wakimizufu/TBSEQ/TBSEQ_Board_V1/notes.txt

デバッグボードの注意点

1.OSCとVCFの間は結線されてないので、SQRないしSAWに220Kを
  通してVCFに入力する。

2.CVは大体0.5～6.0Vまで反応する。 この範囲を超えると音が聞こえなく
  なる。 その際は一旦電源を落としてCVを調整してから電源を入れなおす。

3.GATEは正論理で+5VでONだが ACCは負論理なので0Vでonする。
  ACCをonにするとVCFへのEnvDecayは最短固定でVCFに印加される。

4.10/06現在、CutoffFreq , Resonance , EnvMod , Tuning および Volumeの
  つまみの方向がオリジナルと逆になっている。
