wakimizufu/TBSEQ/testClock/ADC_TEMPO_COUNT.tsv

ADC | TEMPO | COUNT
0 | 30 | 2604
1 | 31 | 2520
2 | 32 | 2441
3 | 32 | 2441
4 | 33 | 2367
5 | 34 | 2298
6 | 35 | 2232
7 | 36 | 2170
8 | 37 | 2111
9 | 37 | 2111
10 | 38 | 2056
11 | 39 | 2003
12 | 40 | 1953
13 | 41 | 1905
14 | 41 | 1905
15 | 42 | 1860
16 | 43 | 1817
17 | 44 | 1776
18 | 45 | 1736
19 | 46 | 1698
20 | 46 | 1698
21 | 47 | 1662
22 | 48 | 1628
23 | 49 | 1594
24 | 50 | 1563
25 | 51 | 1532
26 | 51 | 1532
27 | 52 | 1502
28 | 53 | 1474
29 | 54 | 1447
30 | 55 | 1420
31 | 56 | 1395
32 | 56 | 1395
33 | 57 | 1371
34 | 58 | 1347
35 | 59 | 1324
36 | 60 | 1302
37 | 60 | 1302
38 | 61 | 1281
39 | 62 | 1260
40 | 63 | 1240
41 | 64 | 1221
42 | 65 | 1202
43 | 65 | 1202
44 | 66 | 1184
45 | 67 | 1166
46 | 68 | 1149
47 | 69 | 1132
48 | 70 | 1116
49 | 70 | 1116
50 | 71 | 1100
51 | 72 | 1085
52 | 73 | 1070
53 | 74 | 1056
54 | 75 | 1042
55 | 75 | 1042
56 | 76 | 1028
57 | 77 | 1015
58 | 78 | 1002
59 | 79 | 989
60 | 79 | 989
61 | 80 | 977
62 | 81 | 965
63 | 82 | 953
64 | 83 | 941
65 | 84 | 930
66 | 84 | 930
67 | 85 | 919
68 | 86 | 908
69 | 87 | 898
70 | 88 | 888
71 | 89 | 878
72 | 89 | 878
73 | 90 | 868
74 | 91 | 859
75 | 92 | 849
76 | 93 | 840
77 | 94 | 831
78 | 94 | 831
79 | 95 | 822
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
