wakimizufu/TBSEQ/SwitchBox/TBSeq - Project.pdf

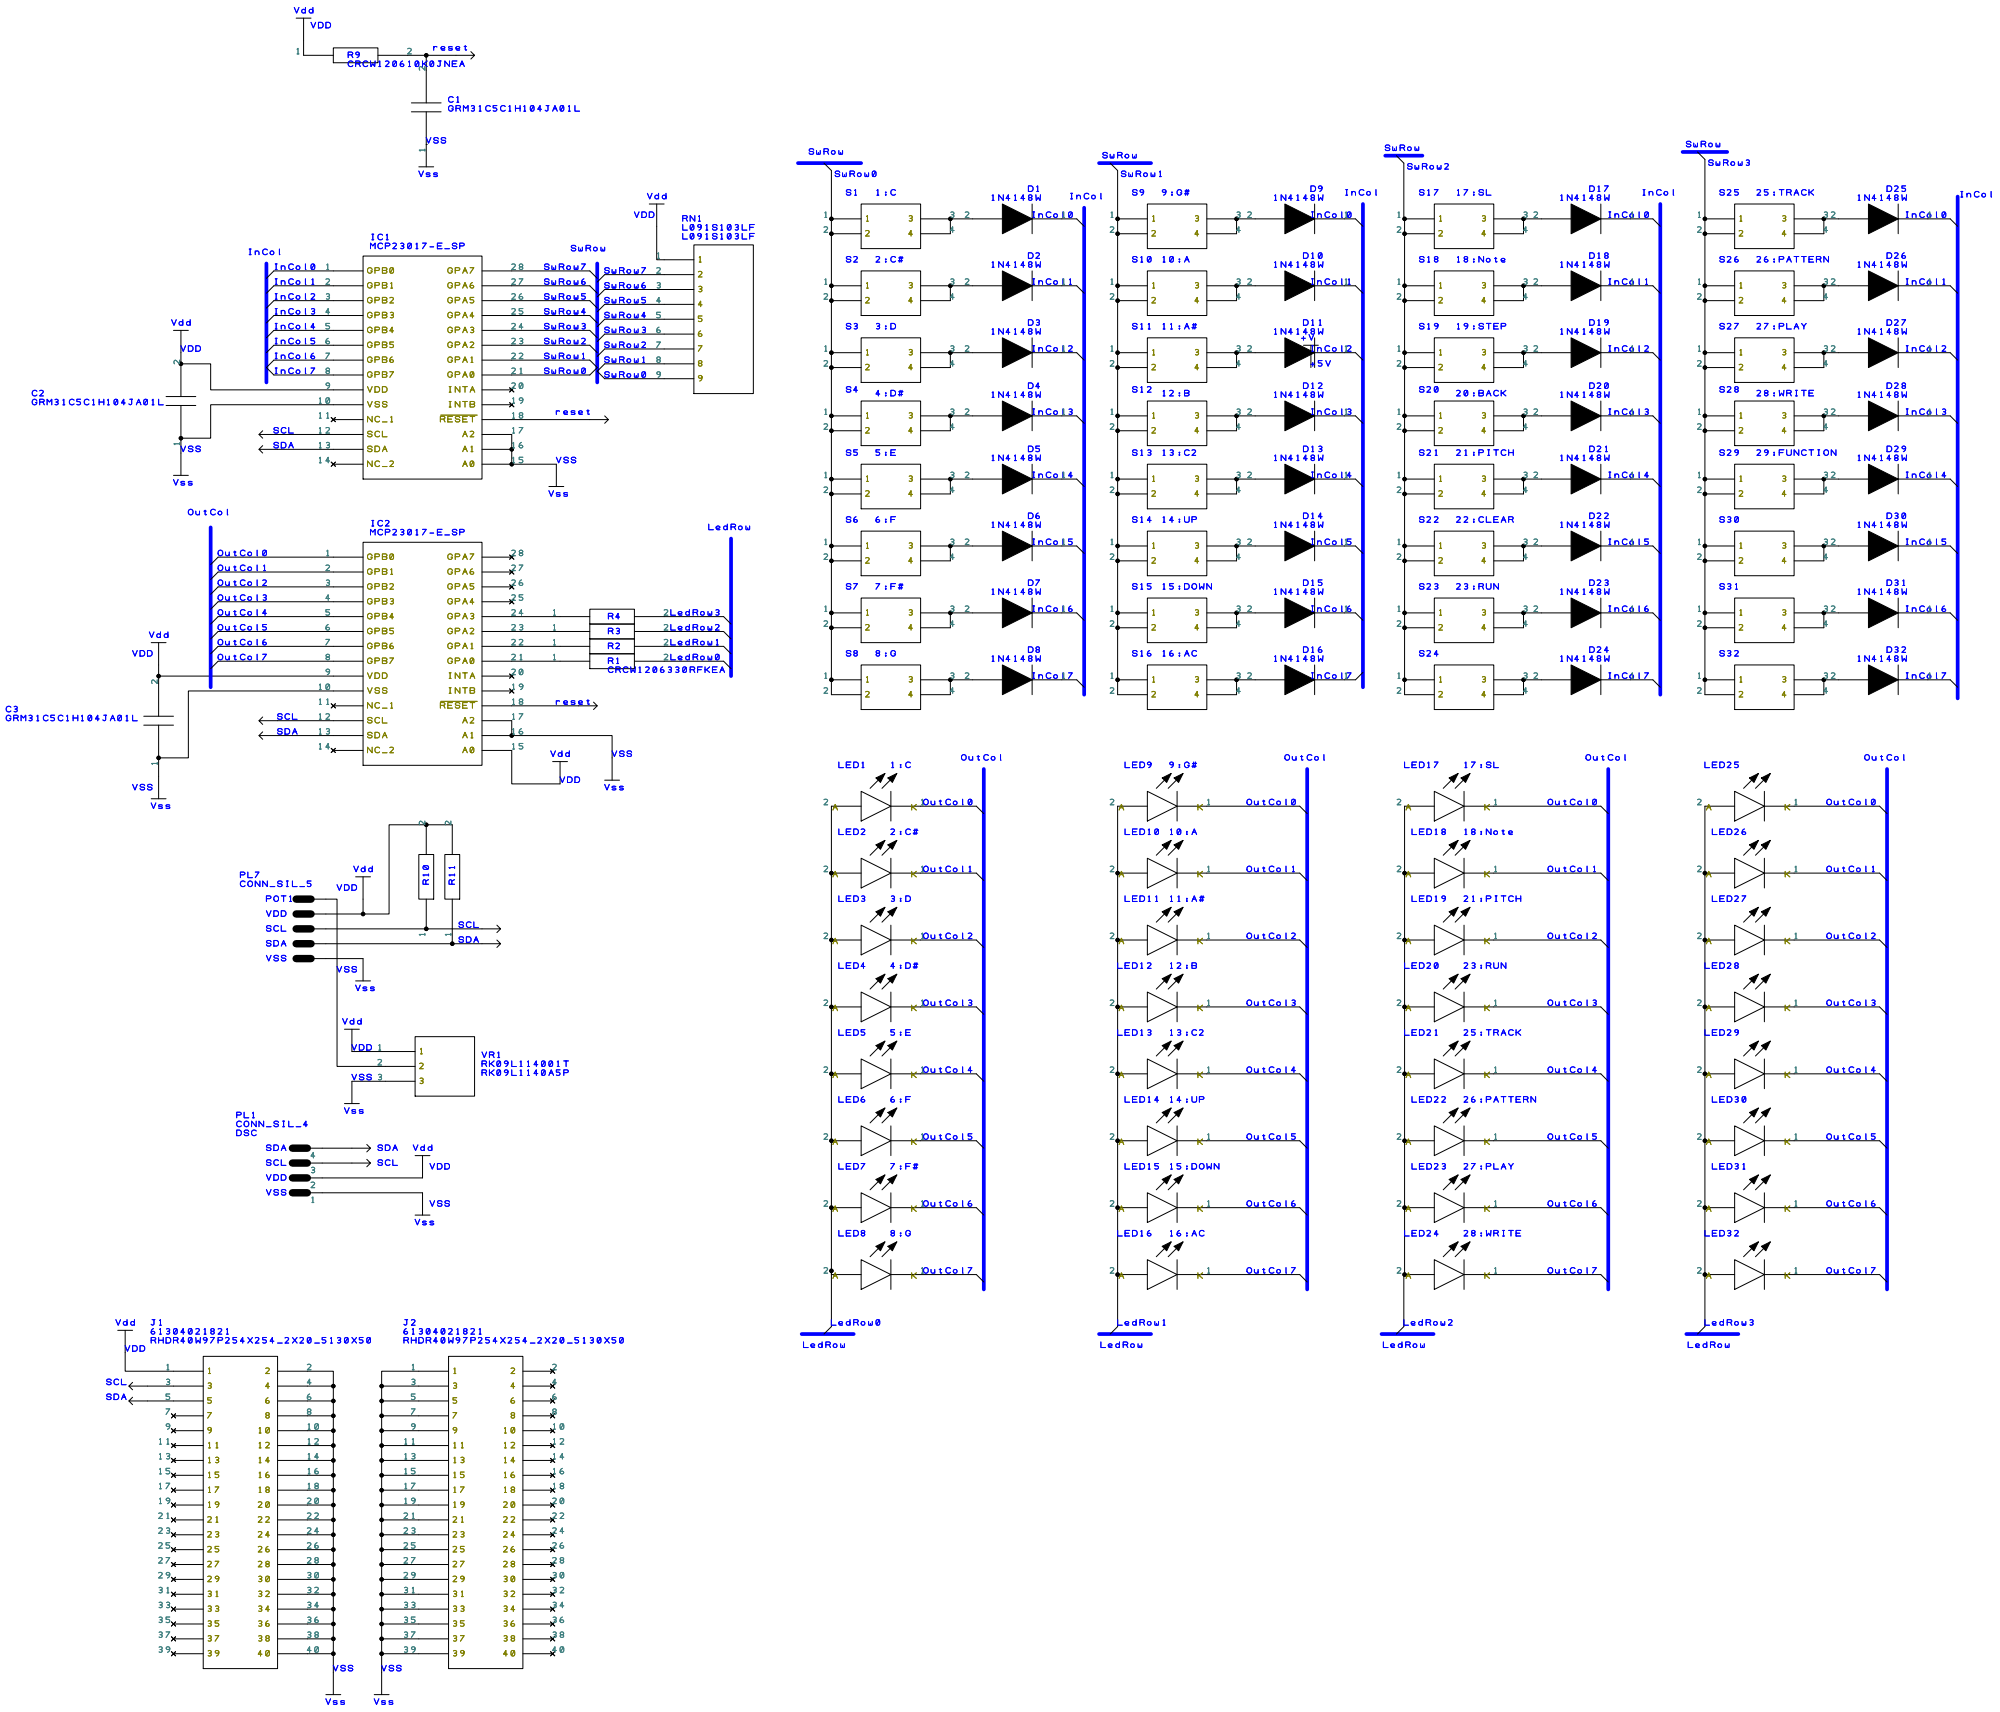
[picture p22: page 1]
