wakimizufu/TBSEQ/TBSEQ_Board_V1/RE-303 BOM_1.3_official.pdf

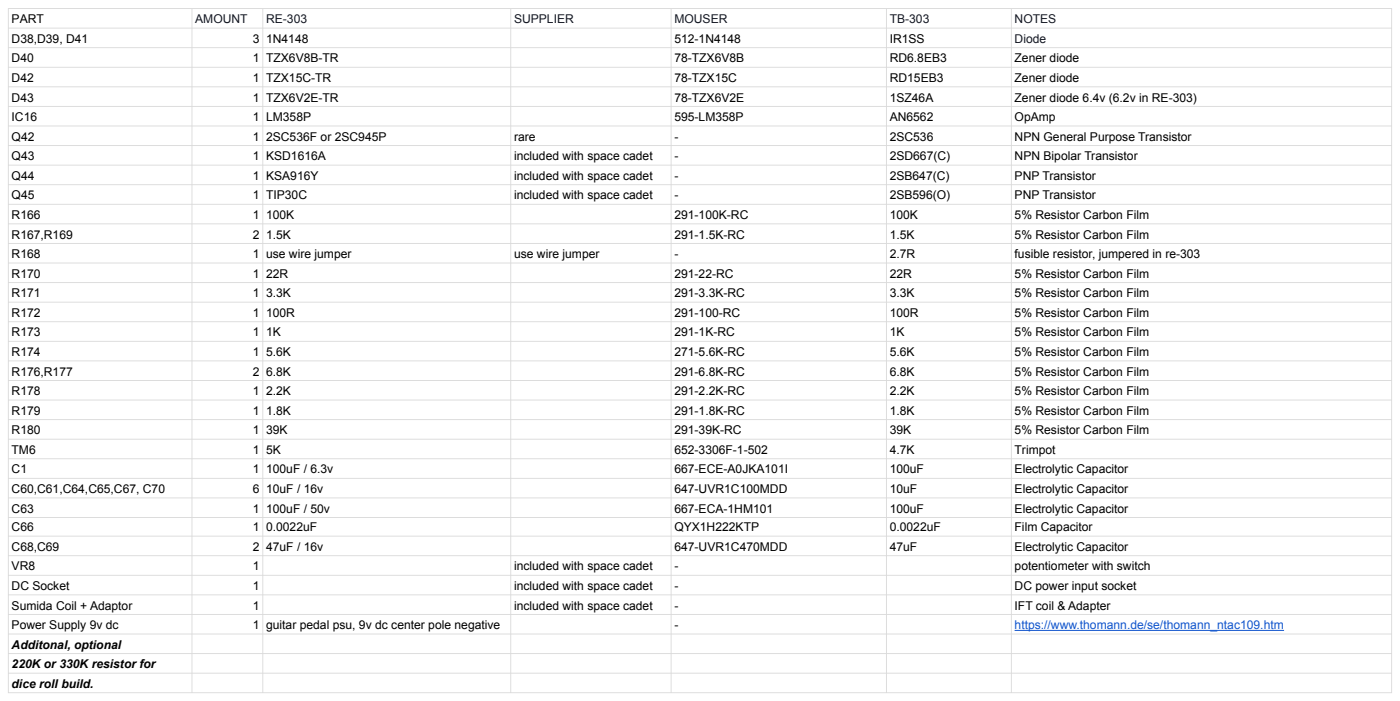
[picture p23: page 1]

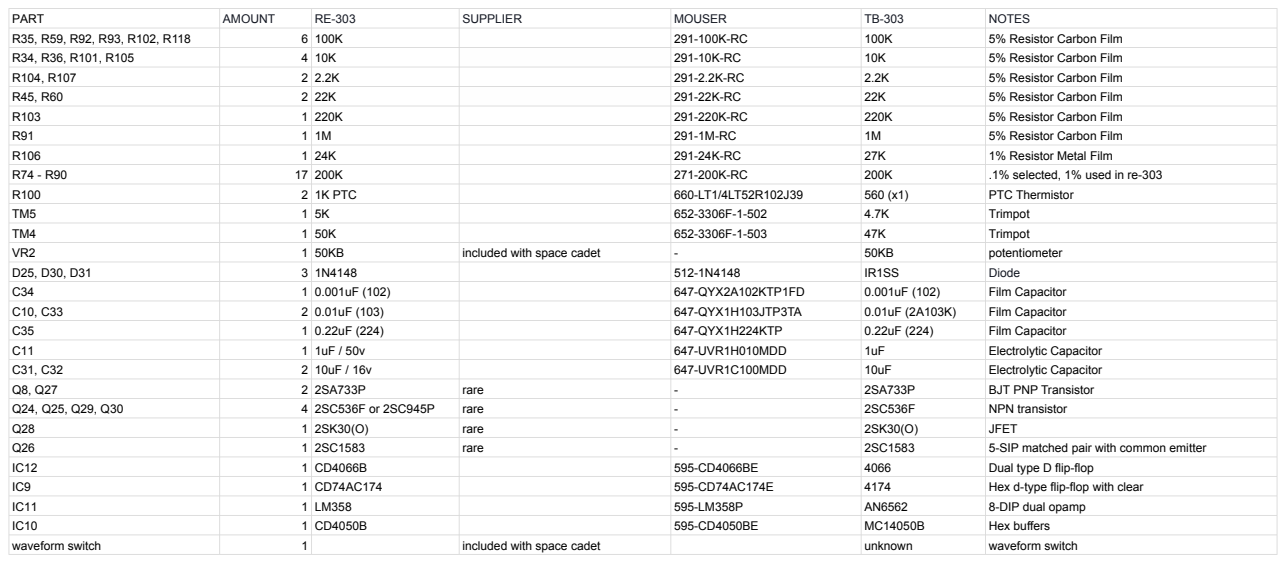
[picture p24: page 2]

PART R35, R59, R92, R93, R102, R118 | AMOUNT RE-303 SUPPLIER MOUSER TB-303 NOTES
6 100K 291-100K-RC 100K | 5% Resistor Carbon Film
R34, R36, R101, R105 | 4 10K | 291-10K-RC 10K | 5% Resistor Carbon Film
R104, R107 2 2.2K 291-2.2K-RC 2.2K | | | 5% Resistor Carbon Film

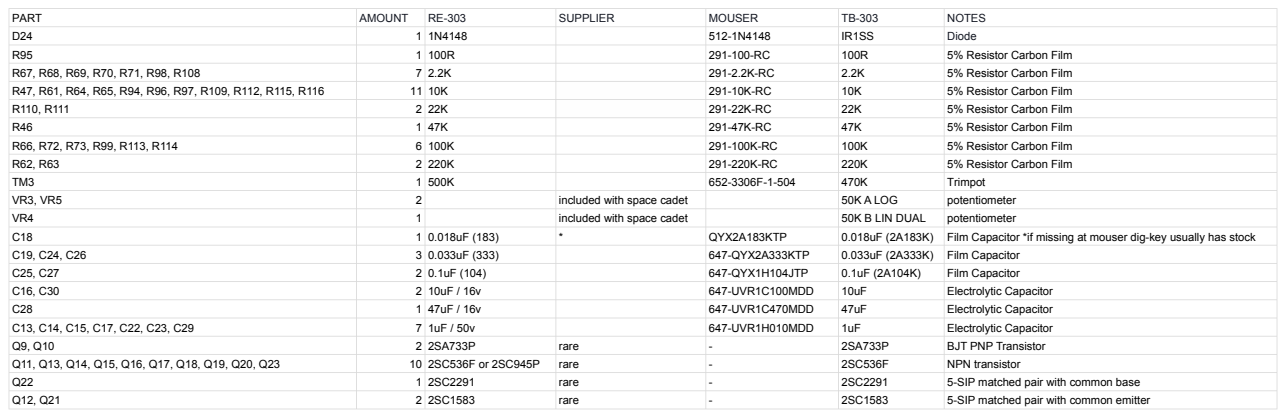
[picture p25: page 3]

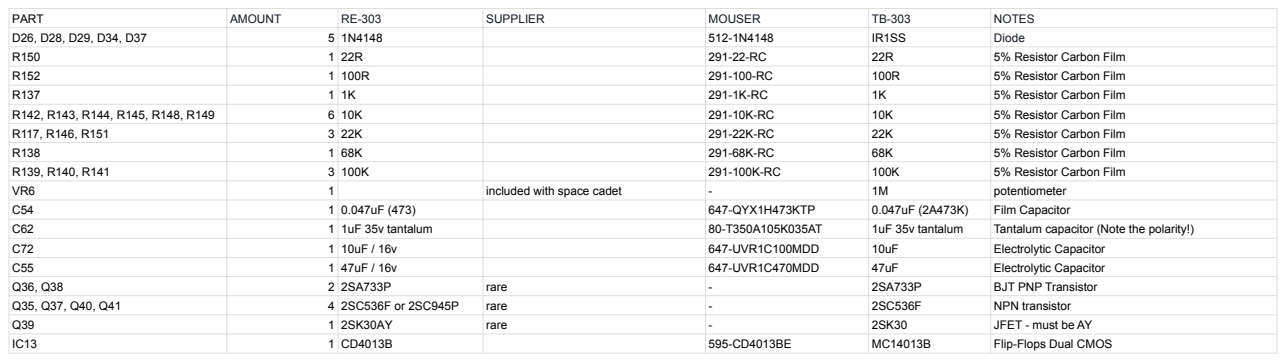
[picture p26: page 4]

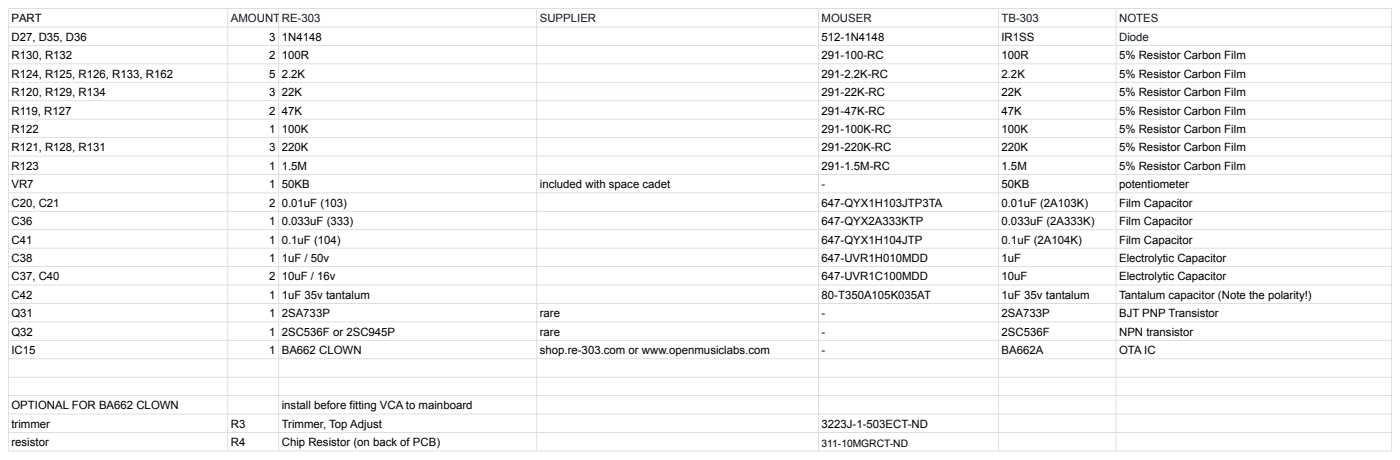
[picture p27: page 5]

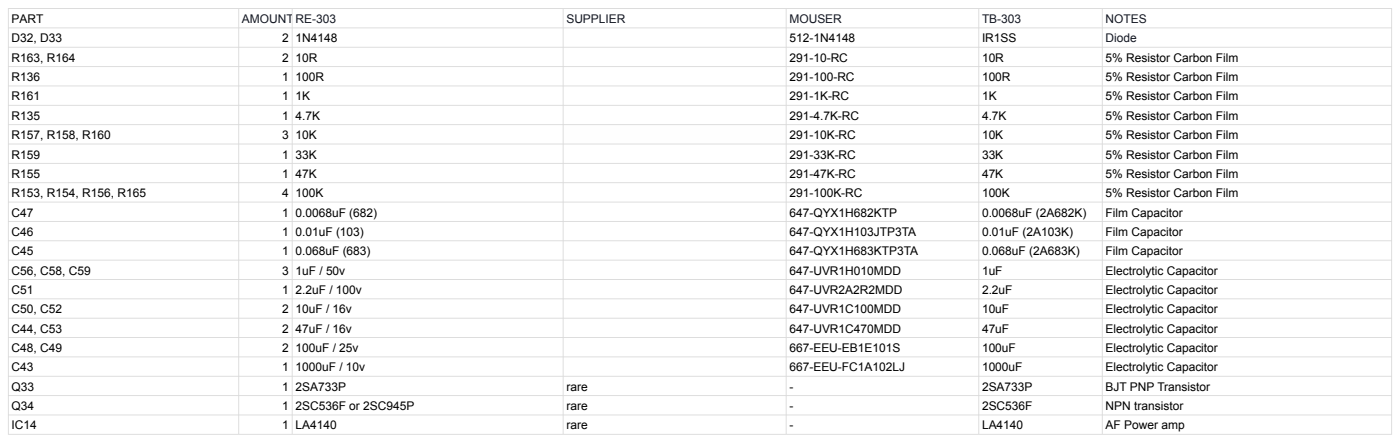
[picture p28: page 6]

2 1N4148 512-1N4148 IR1SS | Diode

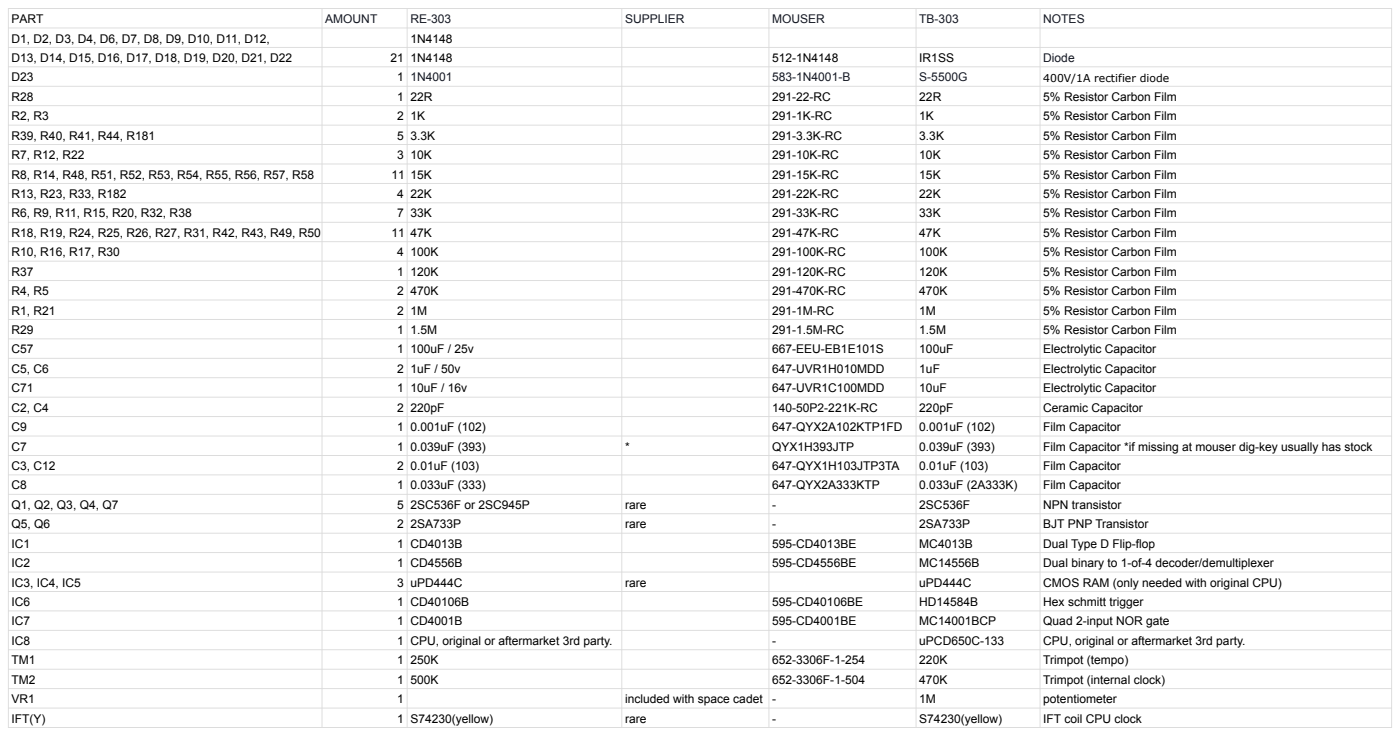
[picture p29: page 7]

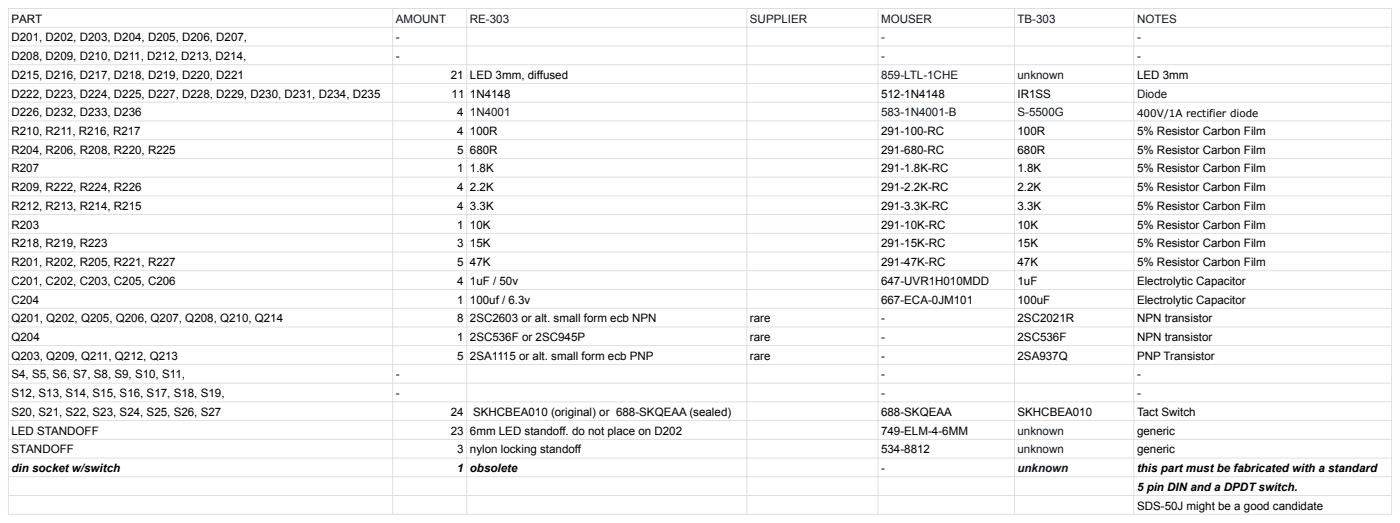
[picture p30: page 8]

D222, D223, D224, D225, D227, D228, D229, D230, D231, D234, D235 D226, D232, D233, D236 | 11 1N4148 512-1N4148 IR1SS | Diode
4 | 1N4001 583-1N4001-B S-5500G 400V/1A rectifier diode

LED STANDOFF 23 6mm LED standoff. do not place on D202 749-ELM-4-6MM STANDOFF 3 nylon locking standoff 534-8812 din socket w/switch 1 obsolete - | unknown generic

unknown | this part must be fabricated with a standard

5 pin DIN and a DPDT switch.

SDS-50J might be a good candidate

part | amount | part number | supplier | notes
headers for Pixie recpu | 2 | SKU A-4662 | TAYDA | machine headers, cut to size for pixie. Can be replace with generic 2.54 header (not recommended)
