wakimizufu/TBSEQ/TBSEQ_Board_V3/TB-SEQV3_MainBoard.pdf

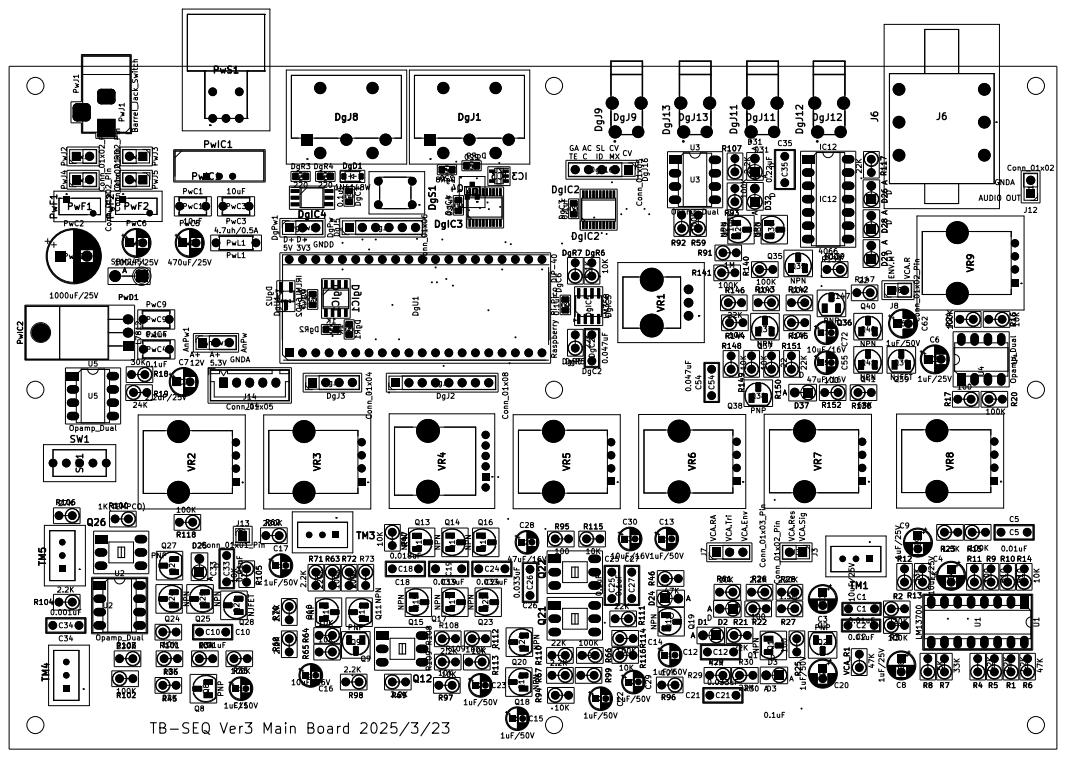
[picture p31: page 1]
