wakimizufu/TBSEQ/TBSEQ_Board_V3/TB-SEQV3_PanelBoard.pdf

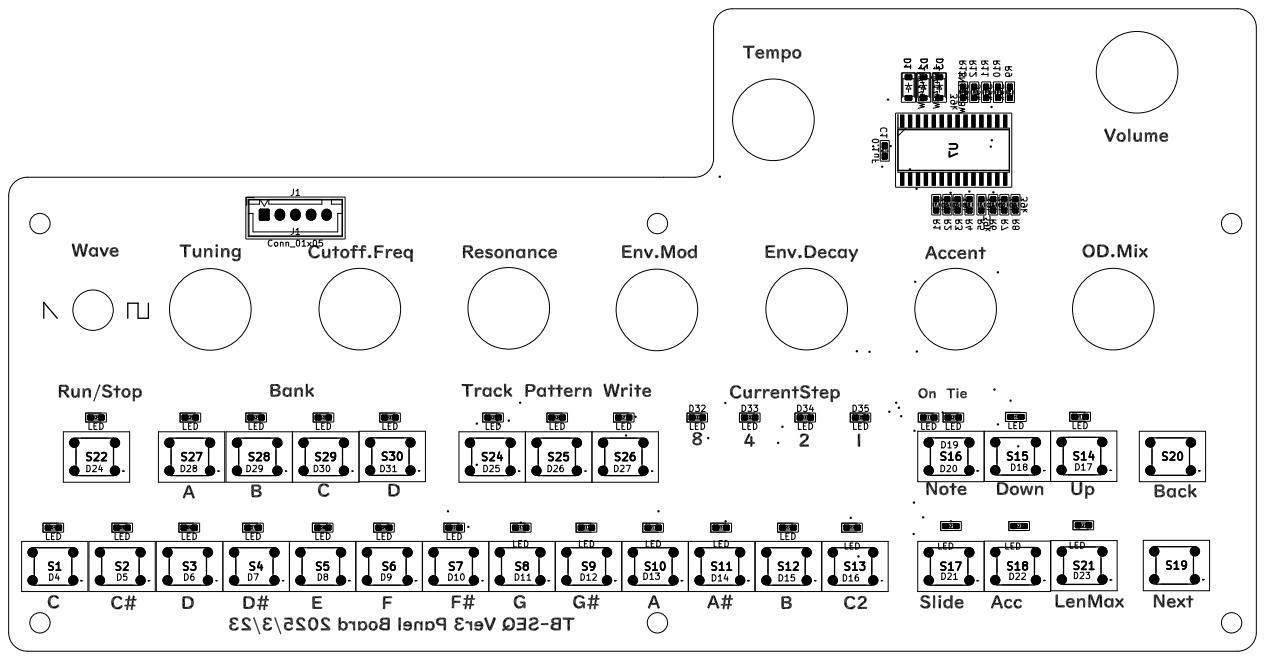
[picture p32: page 1]
