wakimizufu/TBSEQ/TBSEQ_Board_V2/mainBorad/mainboard_pcb_20241230.pdf

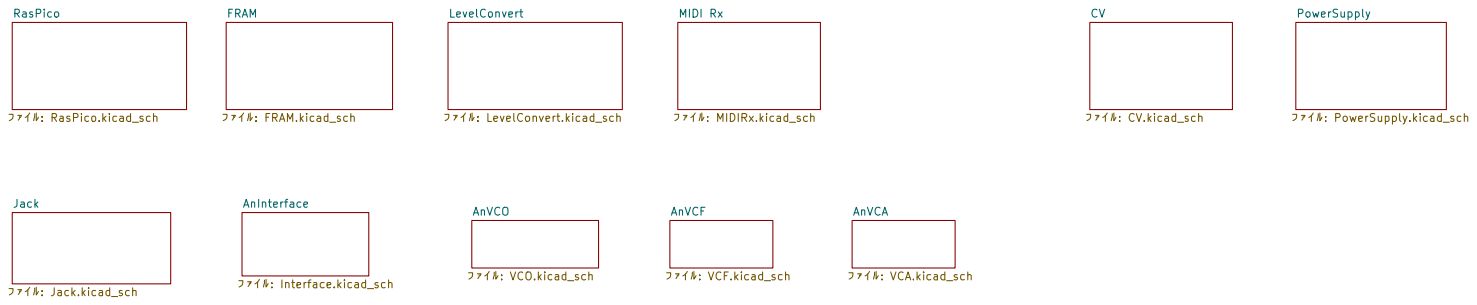
[picture p41: page 1]

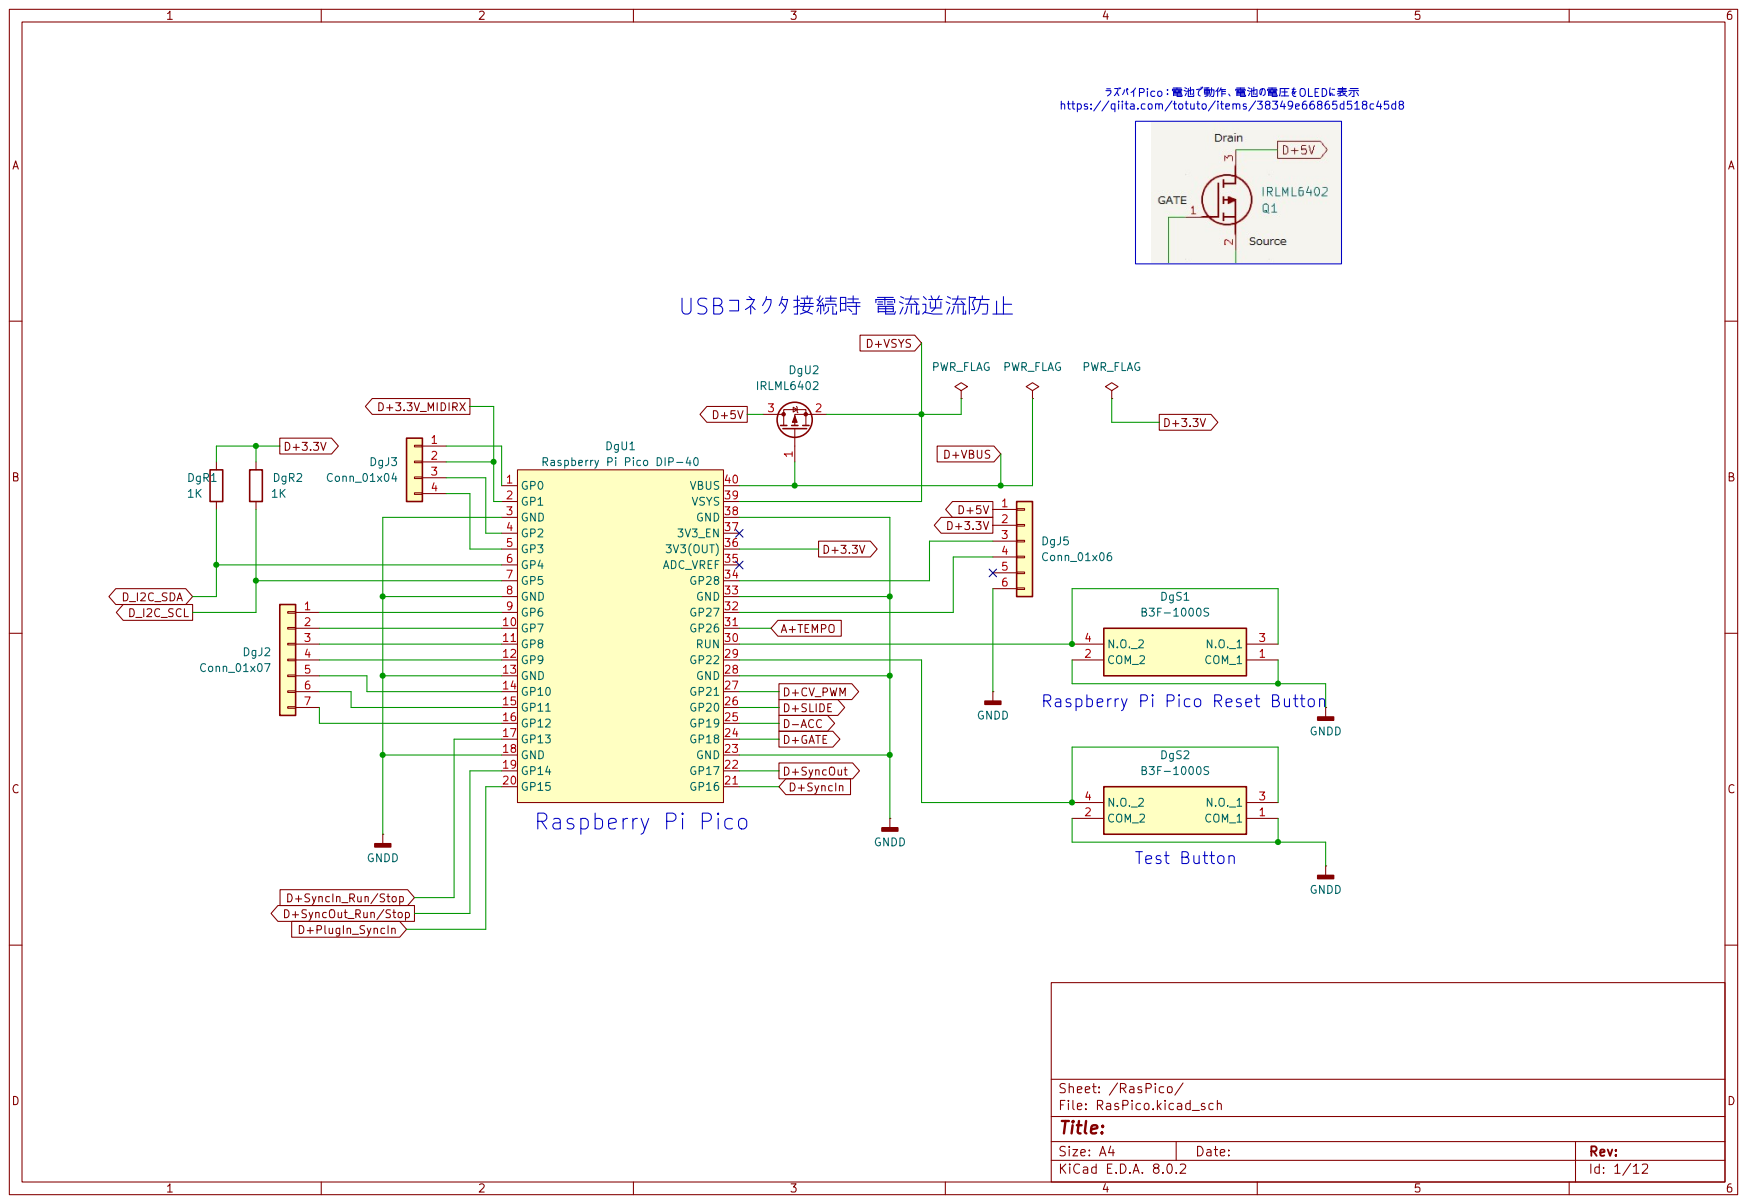
[picture p42: page 2]


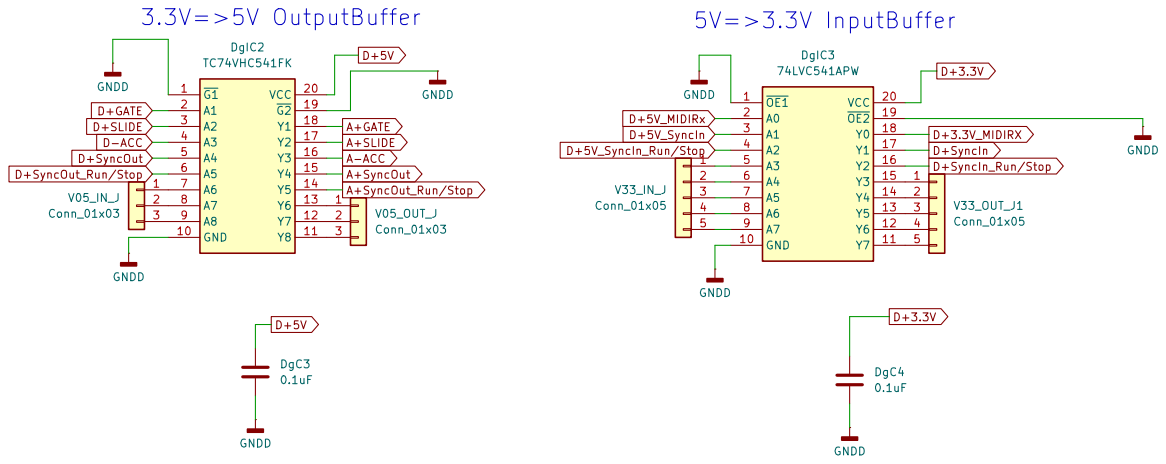
[picture p43: page 4]

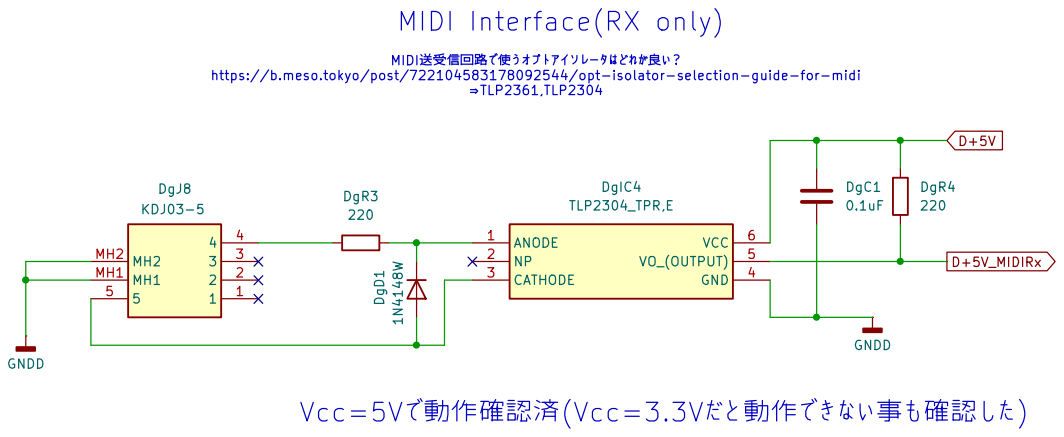
[picture p44: page 5]

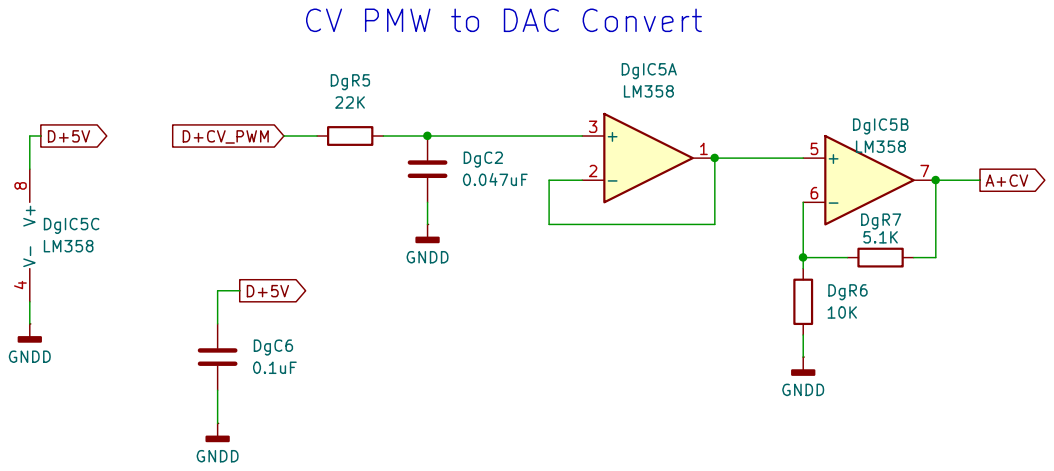
[picture p45: page 6]

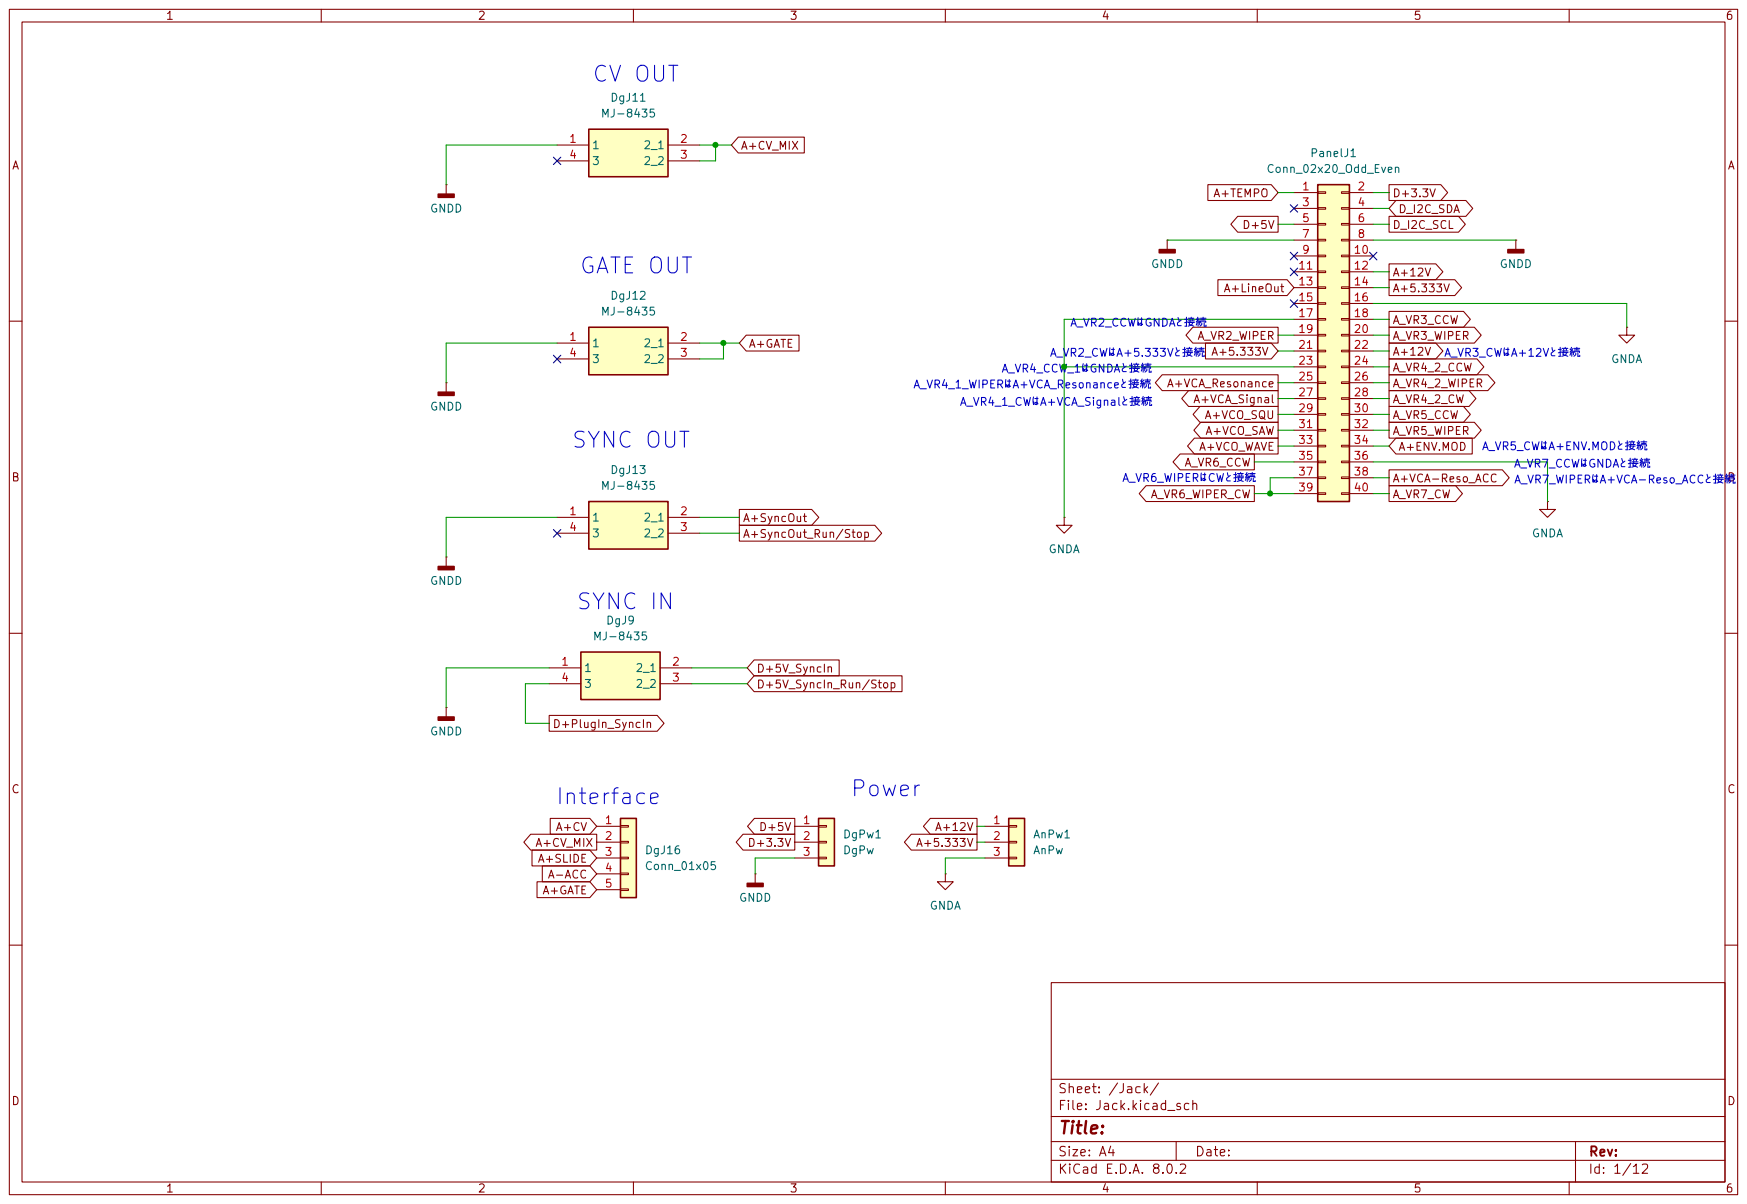
[picture p46: page 7]

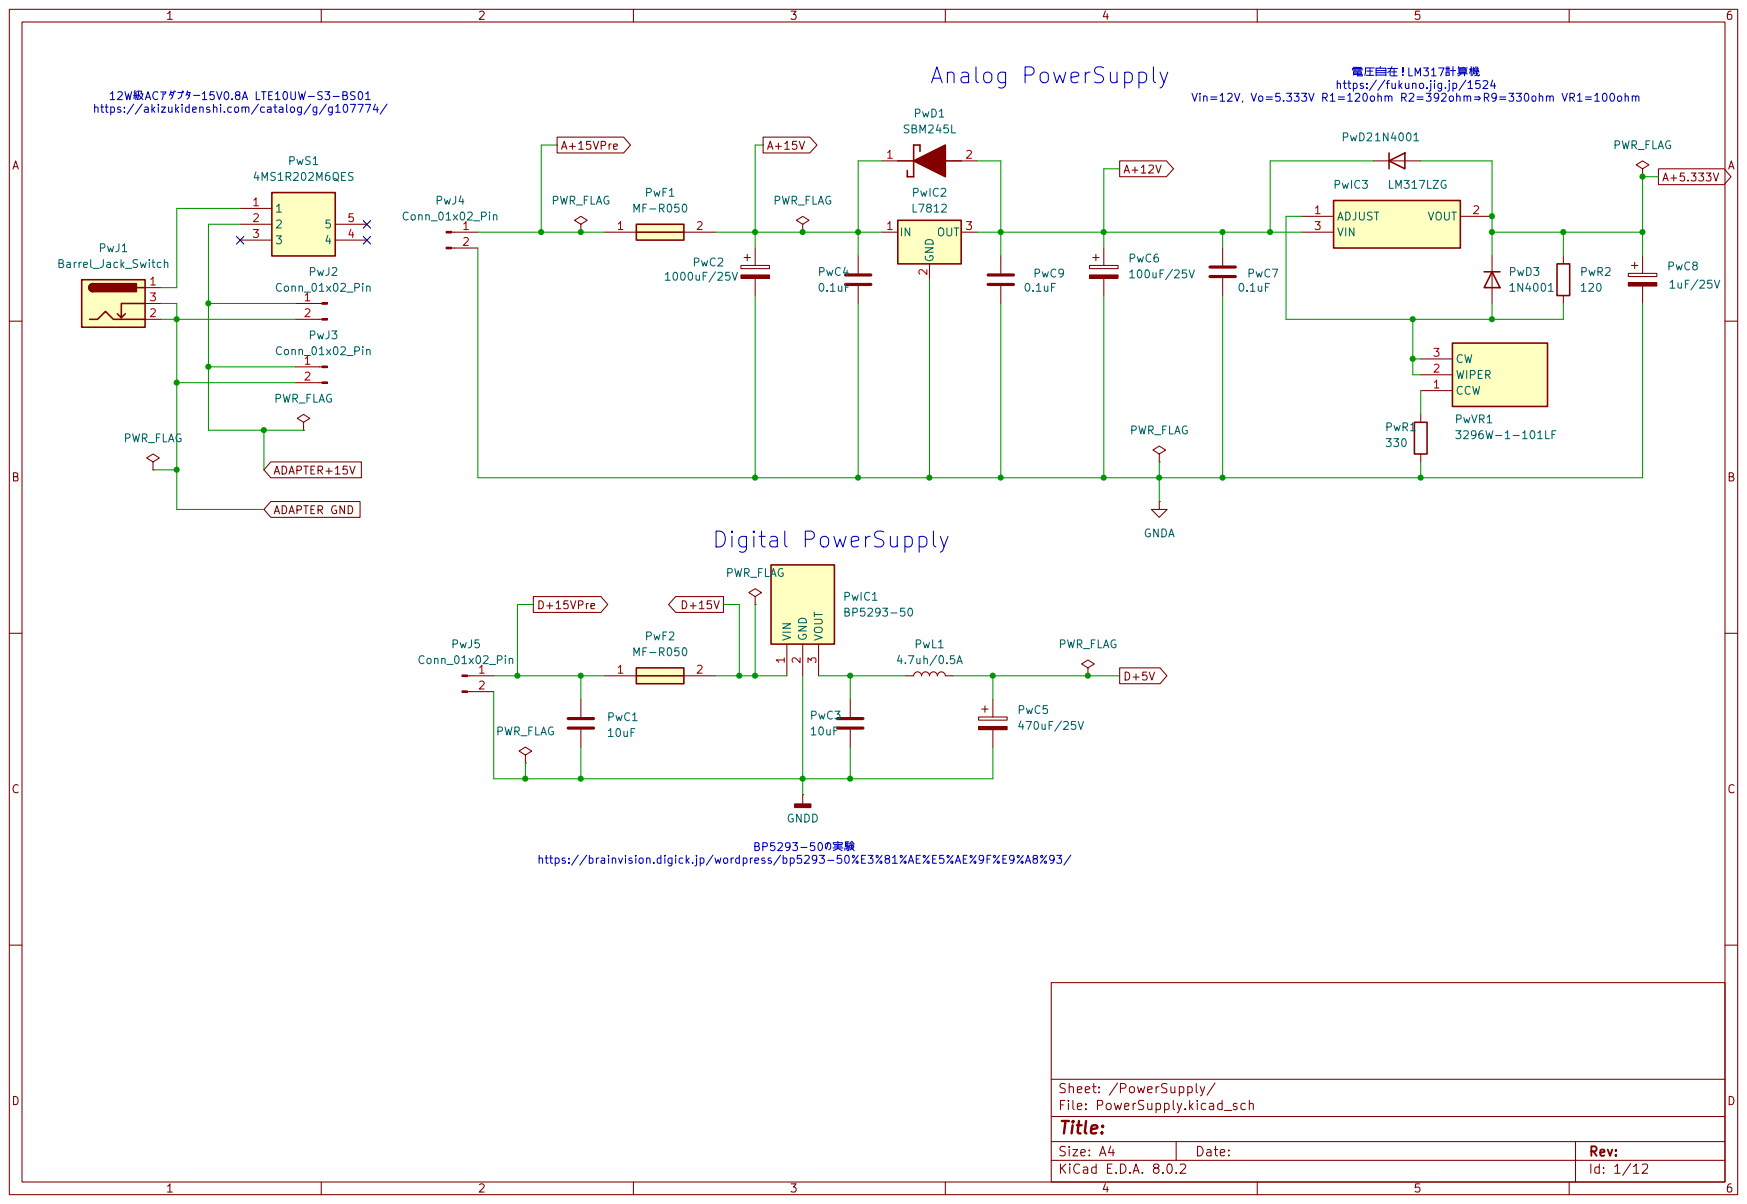
[picture p47: page 8]

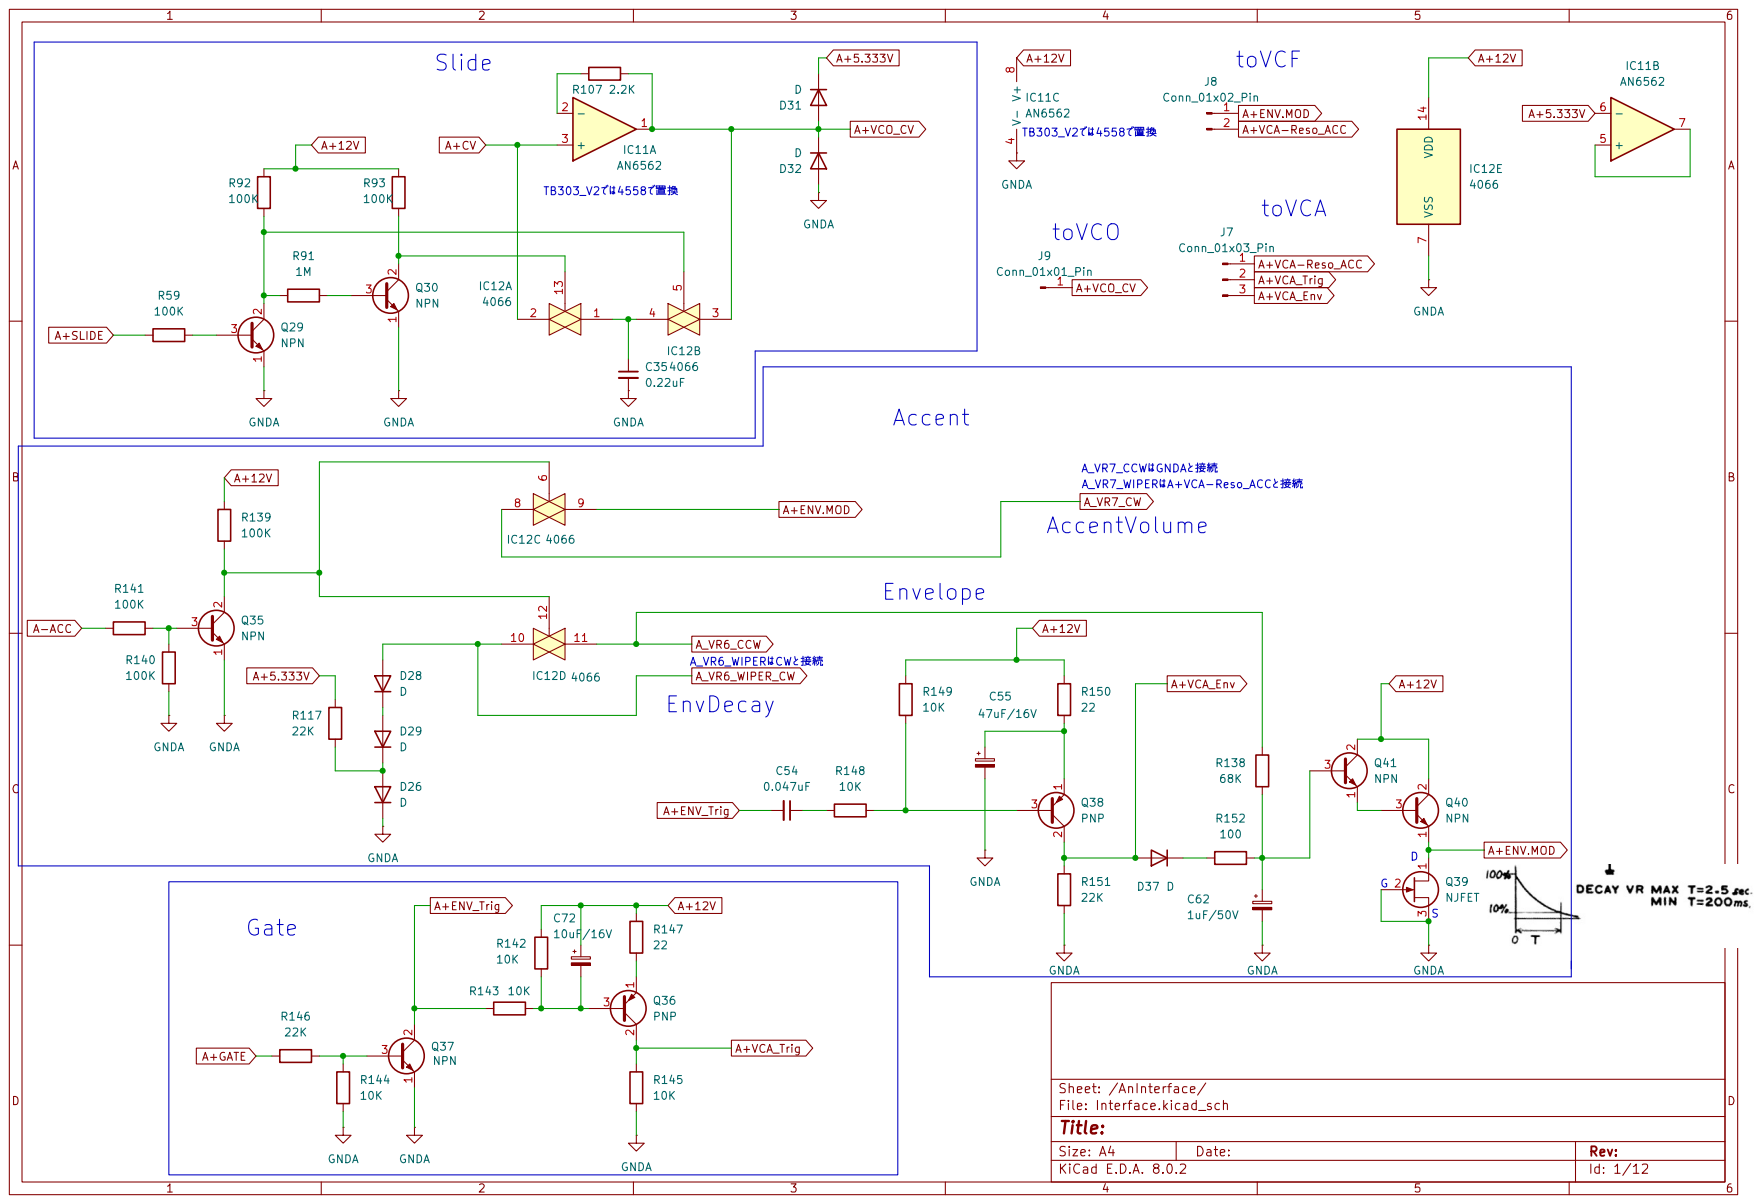
[picture p48: page 9]

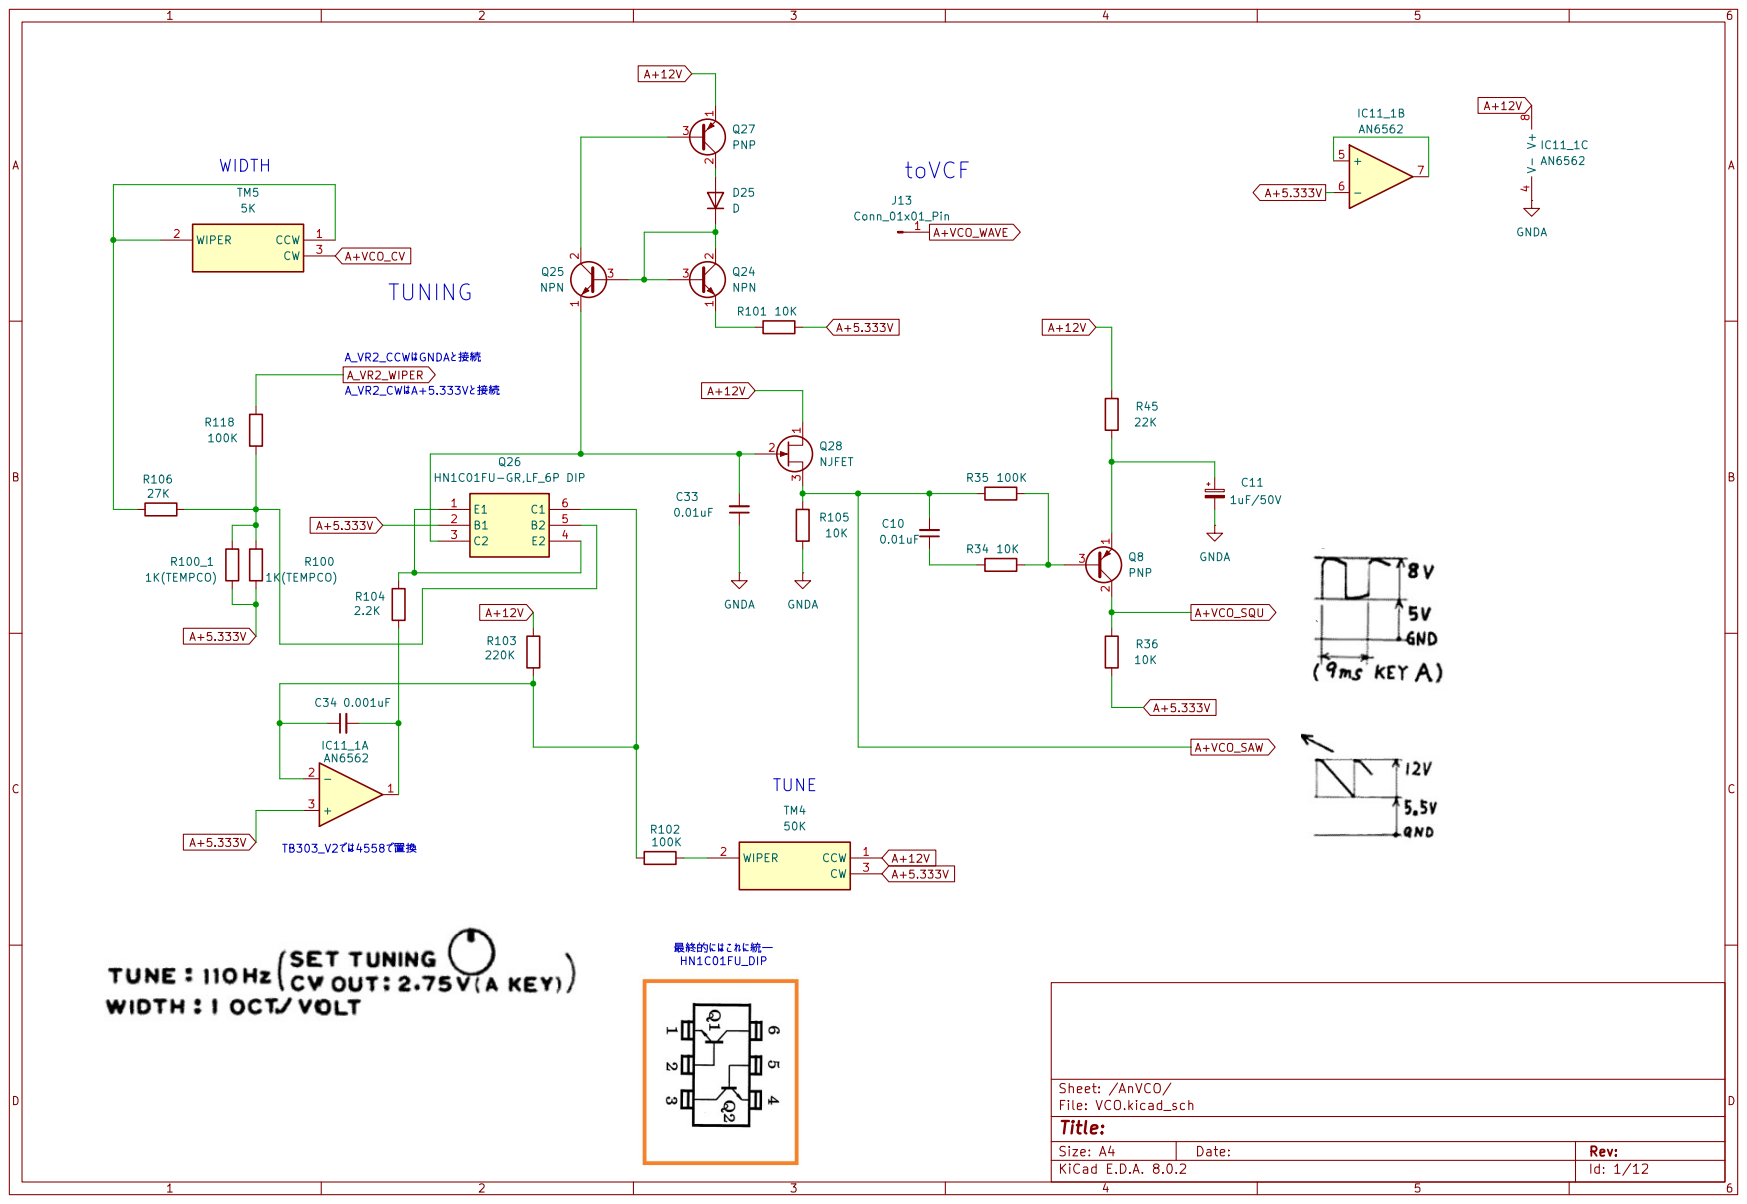
[picture p49: page 10]

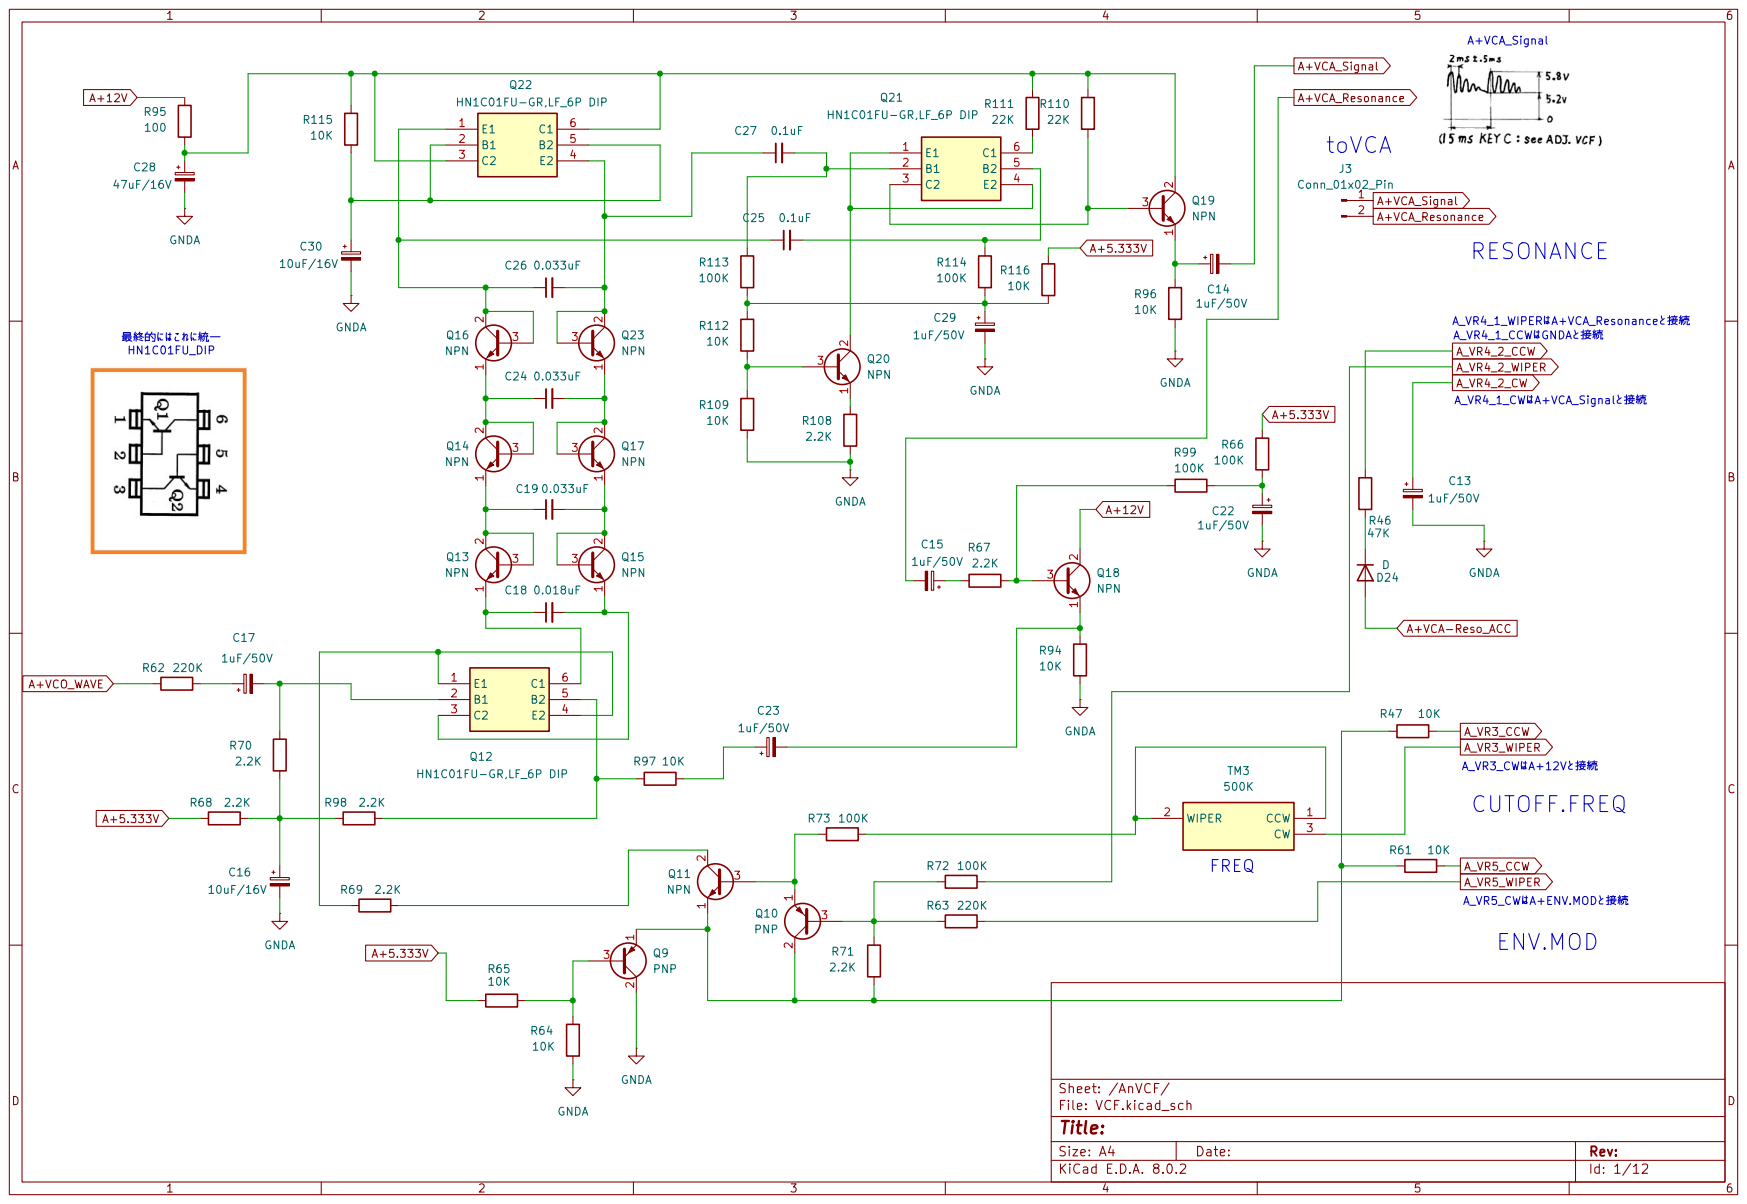
[picture p50: page 11]

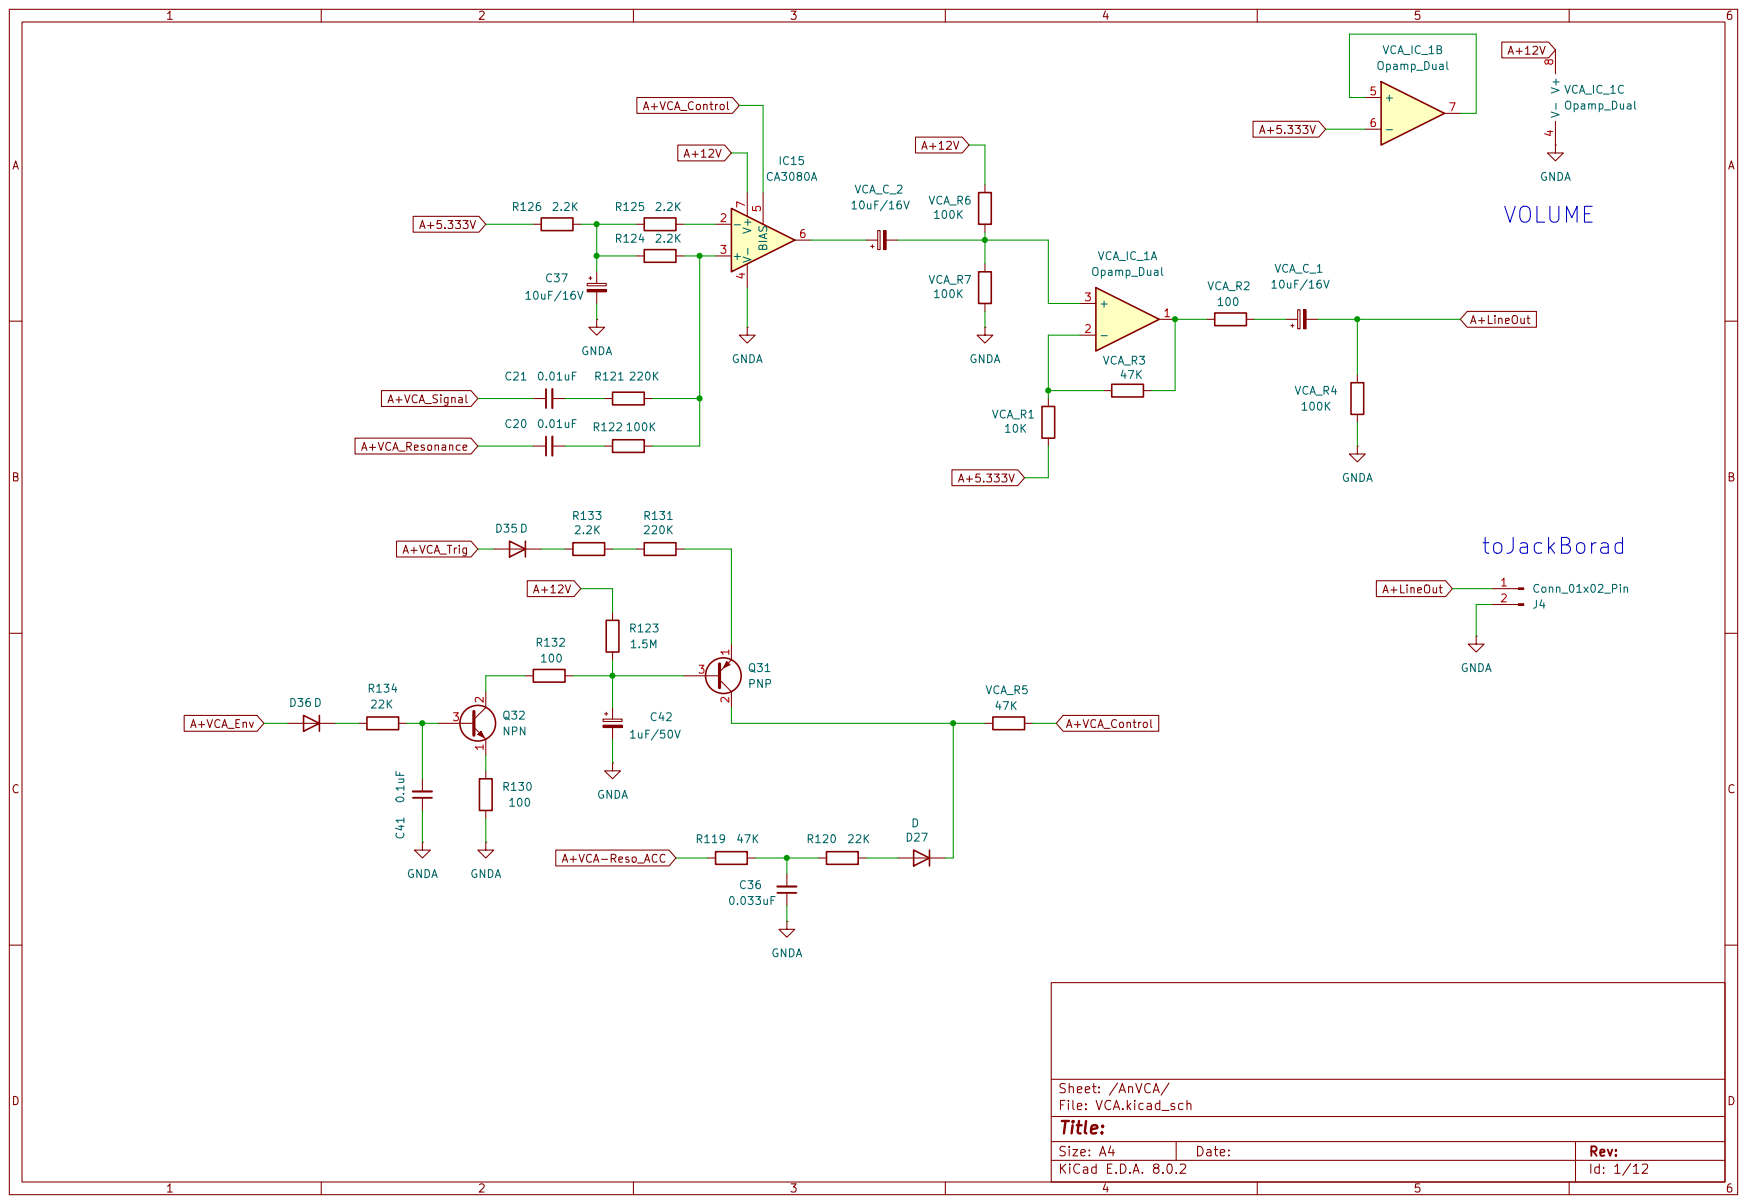
[picture p51: page 12]
