wakimizufu/TBSEQ/TBSEQ_Board_V2/frontPanel/frontPanel_pcb_20241014.pdf

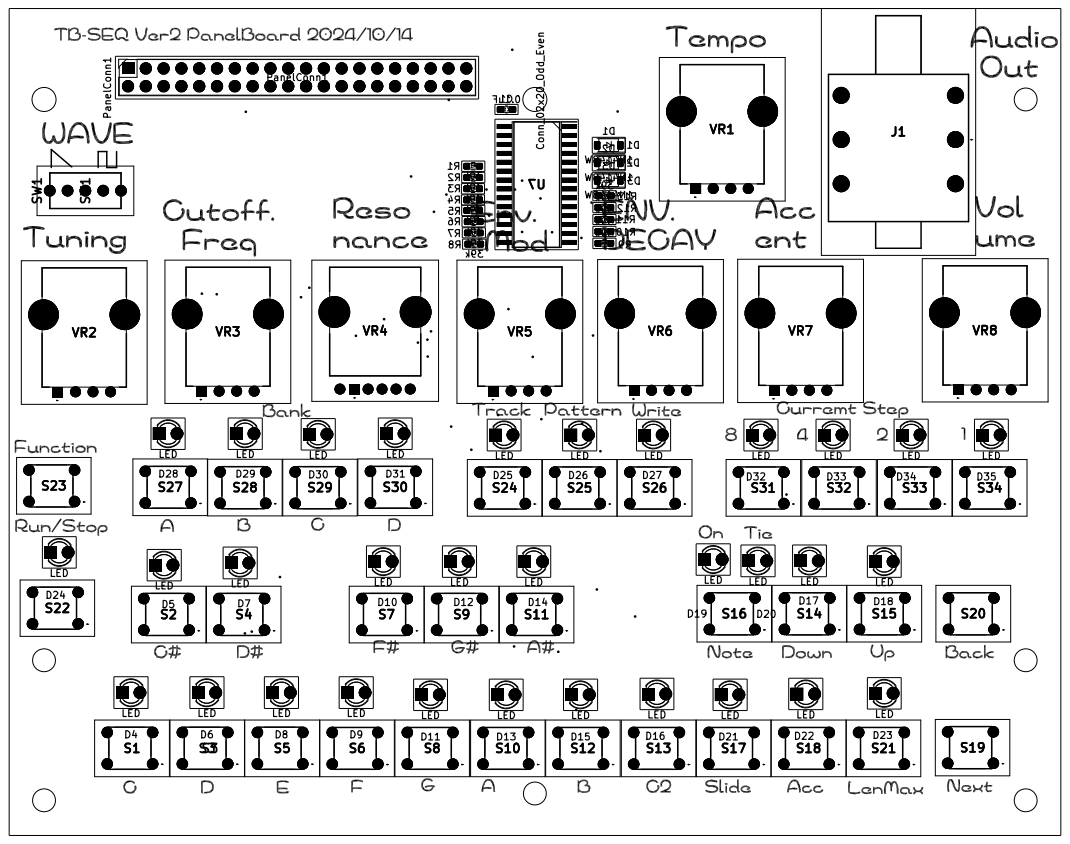
[picture p52: page 1]
