wakimizufu/TBSEQ/TBSEQ_Board_V2/mainBorad/mainboard_pcb_20241014.pdf

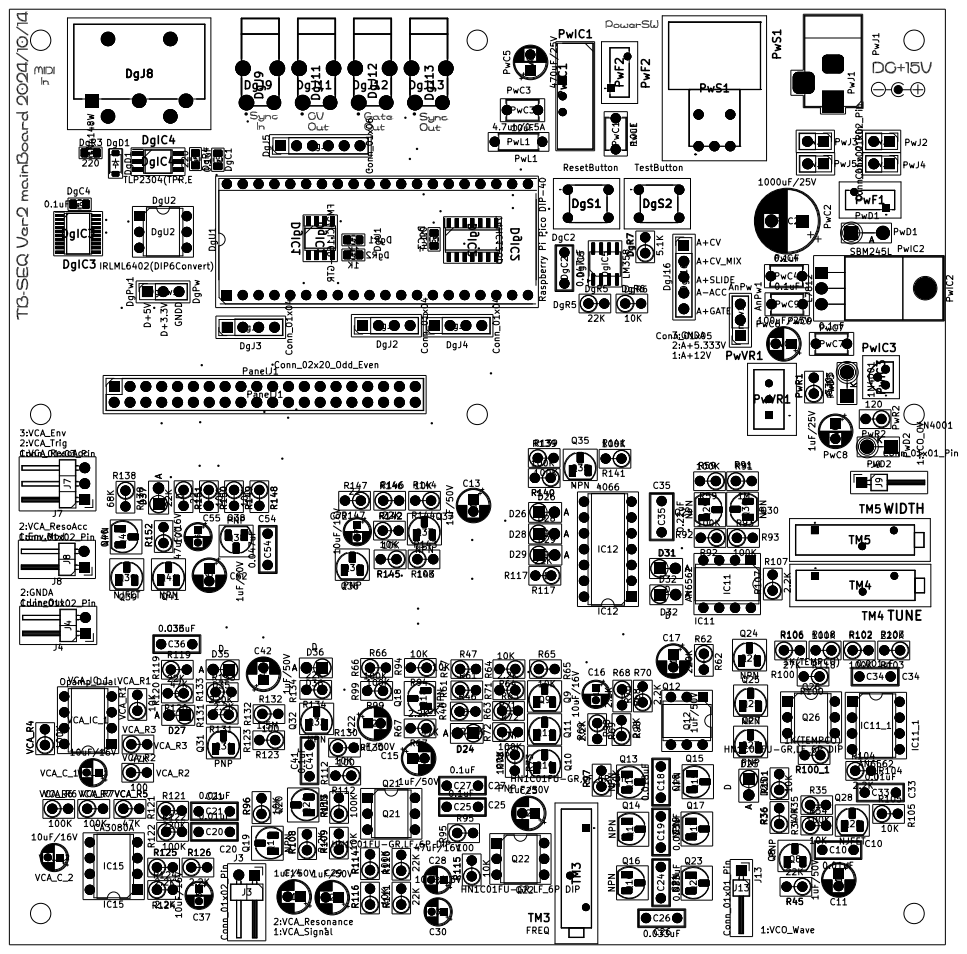
[picture p53: page 1]
