wakimizufu/TBSEQ/testLTSpice/Accent_1.asc

A1: dflop; Vhigh=5
Q1: npn
R1: res; 100K
R2: res; 100K
R3: res; 100K
V1: voltage; PULSE(0 5V 0 0 0 20ms 40ms 4)
V2: voltage; PULSE(0 5 0 0 0 10m 20m 1)
V3: voltage; 12V
Named nets: 0, 12V, ACC_CTL
.tran 100ms
ACCENT
GLIDE
