wakimizufu/TBSEQ/testLTSpice/Gate_1.asc

C1: cap; 10µf; V=16V
D1: diode
Q1: npn
Q2: pnp
R1: res; 22K
R2: res; 10K
R3: res; 10K
R4: res; 10K
R5: res; 22
R6: res; 10K
R7: res; 1K
R8: res; 1K
V1: voltage; PULSE(0 5 0 0 0 30m 60m 5)
V2: voltage; 12V
Named nets: 0, 12V
.tran 300ms
