wakimizufu/TBSEQ/testLTSpice/Gate_Env1.asc

C1: cap; 10µf; V=16V
C2: cap; 0.047µf
C3: cap; 47µF
C4: cap; 1µF
D1: diode
D2: diode
D3: diode
D4: diode
D5: diode
J1: njf
Q1: npn
Q2: pnp
Q3: pnp
Q4: npn
Q5: npn
R1: res; 22K
R2: res; 10K
R3: res; 10K
R4: res; 10K
R5: res; 22
R6: res; 10K
R7: res; 1K
R8: res; 1K
R9: res; 10K
R10: res; 10K
R11: res; 22
R12: res; 22K
R13: res; 100
R14: res; 68K
R15: res; 0.1K
R16: res; 22K
V1: voltage; PULSE(0 5 0 0 0 30m 60m 5)
V2: voltage; 12V
V3: voltage; 5.333V
Named nets: 0, 12V, 5.333V
.tran 300ms
