wakimizufu/TBSEQ/testLTSpice/Slide_1.asc

C1: cap; 0.22µF
Q1: npn
Q2: npn
R1: res; 1m
R2: res; 100K
R3: res; 100K
R4: res; 100K
R5: res; 2.2K
U1: CD4066
U2: CD4066
U3: UniversalOpAmp
V1: voltage; 12V
V2: voltage; PULSE(0 5 0 0 0 200m 400m 1)
V3: voltage; PULSE(0 5 0 0 0 50m 100m)
V4: voltage; 5.333V
Named nets: 0, 12V, 5.333V
.tran 1000ms
