wakimizufu/TBSEQ/(list of files, drawings)

Other design files:
SwitchBox/TBSeq.pcb
SwitchBox/~TBSeq.pcb
TBSEQ_Board_V1/PWSD_V2.pcb
TBSEQ_Board_V1/TB303_V2.pcb
TBSEQ_Board_V1/コピー ～ TB303_V2.pcb
