wakimizufu/TBSEQ/USBPD12VModule/USBPD12VModule.kicad_pcb

## KiCad design USBPD12VModule/USBPD12VModule.kicad_pcb (2026-08-01)

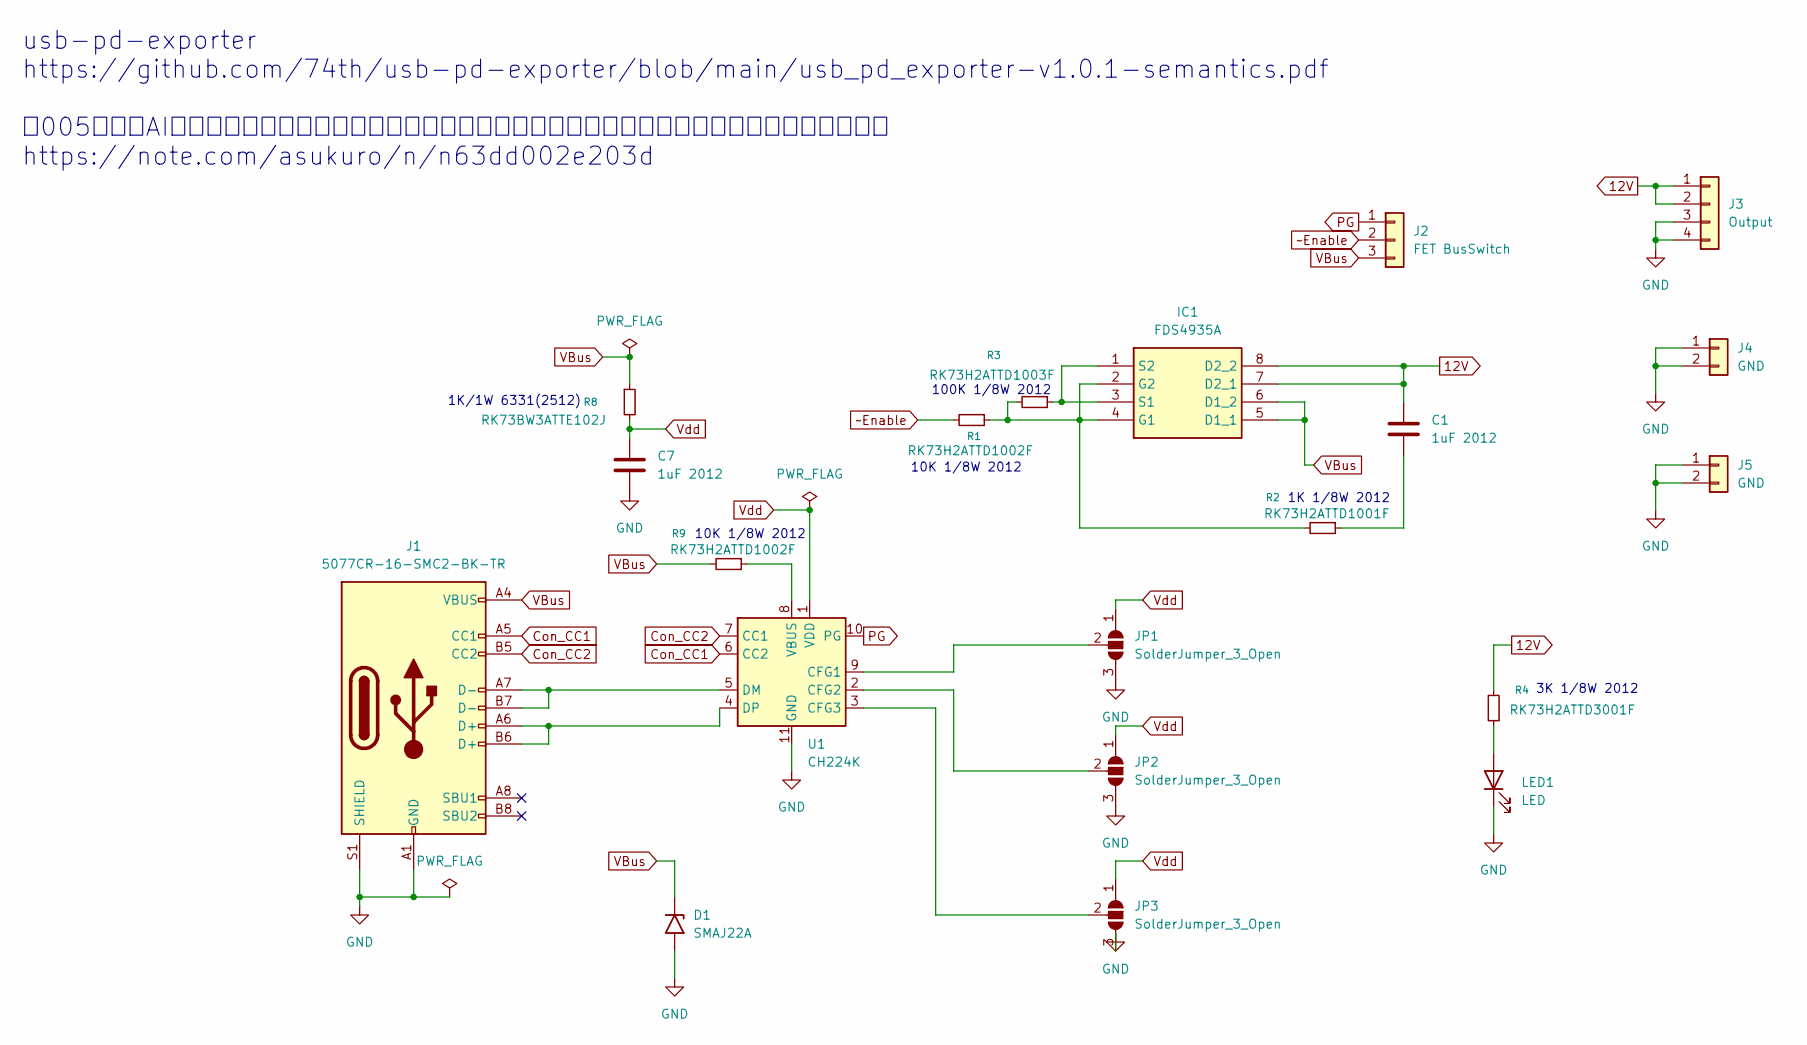
[picture p60: schematic USBPD12VModule.kicad_sch]

Parts:
C1, C7: 1uF 2012; C_0805_2012Metric_Pad1.18x1.45mm_HandSolder
D1: SMAJ22A; D_SMA
IC1: FDS4935A; SOIC127P600X175-8N; Manufacturer_Part_Number FDS4935A; Mouser Part Number 512-FDS4935A
J1: 5077CR-16-SMC2-BK-TR; USB_C_Receptacle_GCT_USB4105-xx-A_16P_TopMnt_Horizontal
J2: FET BusSwitch; PinSocket_1x03_P2.54mm_Vertical
J3: Output; PinSocket_1x04_P2.54mm_Vertical
J4, J5: GND; PinSocket_1x02_P2.54mm_Vertical
JP1, JP2, JP3: SolderJumper_3_Open; SolderJumper-3_P2.0mm_Open_TrianglePad1.0x1.5mm_NumberLabels
LED1: LED; LED_0805_2012Metric_Pad1.15x1.40mm_HandSolder
R1, R9: RK73H2ATTD1002F; R_0805_2012Metric_Pad1.20x1.40mm_HandSolder
R2: RK73H2ATTD1001F; R_0805_2012Metric_Pad1.20x1.40mm_HandSolder
R3: RK73H2ATTD1003F; R_0805_2012Metric_Pad1.20x1.40mm_HandSolder
R4: RK73H2ATTD3001F; R_0805_2012Metric_Pad1.20x1.40mm_HandSolder
R8: RK73BW3ATTE102J; R_2512_6332Metric_Pad1.40x3.35mm_HandSolder
U1: CH224K; SSOP-10-1EP_3.9x4.9mm_P1mm_EP2.1x3.3mm_ThermalVias

Connections:
12V: C1.1, IC1.7 (D2_1), IC1.8 (D2_2), J3.1, J3.2, R4.2
Con_CC1: J1.A5 (CC1), U1.6 (CC2)
Con_CC2: J1.B5 (CC2), U1.7 (CC1)
GND: C7.2, D1.2 (A2), J1.A1 (GND), J1.A12 (GND), J1.B1 (GND), J1.B12 (GND), J1.S1 (SHIELD), J3.3, J3.4, J4.1, J4.2, J5.1, J5.2, JP1.3 (B), JP2.3 (B), JP3.3 (B), LED1.1 (K), U1.11 (GND)
unnamed: C1.2, R2.1
unnamed: IC1.2 (G2), IC1.4 (G1), R1.1, R2.2, R3.2
unnamed: IC1.1 (S2), IC1.3 (S1), R3.1
unnamed: JP1.2 (C), U1.9 (CFG1)
unnamed: JP2.2 (C), U1.2 (CFG2)
unnamed: JP3.2 (C), U1.3 (CFG3)
unnamed: LED1.2 (A), R4.1
unnamed: J1.A7 (D-), J1.B7 (D-), U1.5 (DM)
unnamed: J1.A6 (D+), J1.B6 (D+), U1.4 (DP)
unnamed: R9.1, U1.8 (VBUS)
PG: J2.1, U1.10 (PG)
VBus: D1.1 (A1), IC1.5 (D1_1), IC1.6 (D1_2), J1.A4 (VBUS), J1.A9 (VBUS), J1.B4 (VBUS), J1.B9 (VBUS), J2.3, R8.1, R9.2
Vdd: C7.1, JP1.1 (A), JP2.1 (A), JP3.1 (A), R8.2, U1.1 (VDD)
~Enable: J2.2, R1.2

Notes on the sheet:
100K 1/8W 2012
usb-pd-exporter https://github.com/74th/usb-pd-exporter/blob/main/usb_pd_exporter-v1.0.1-semantics.pdf 【005】生成AIと挑戦する、自分だけのオリジナル実験用電源の製作「キミに選んで欲しい～その２～」 https://note.com/asukuro/n/n63dd002e203d
10K 1/8W 2012
1K 1/8W 2012
3K 1/8W 2012
1K/1W 6331(2512)

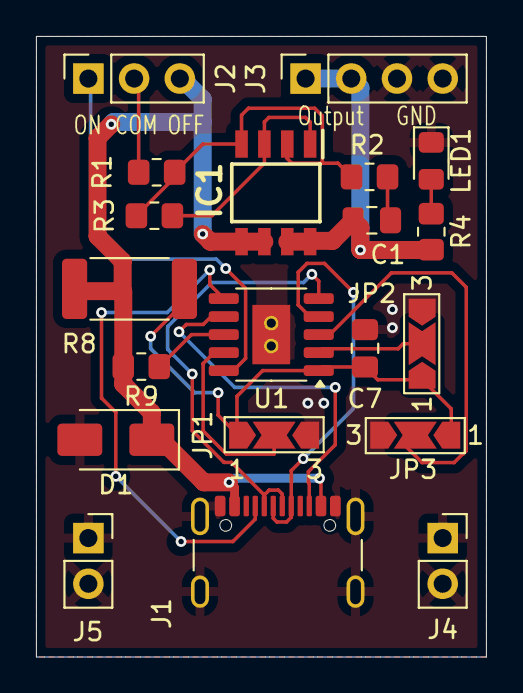
[picture p61: board USBPD12VModule.kicad_pcb from above]

Board: 2 copper layers, 25.0 x 34.5 mm, 20 parts (0 on the bottom side), 18 nets.
