wakimizufu/TBSEQ/TBSEQ_Board_V4/rythemPanelBoard/rythemPanelBoard.kicad_pcb

## KiCad design TBSEQ_Board_V4/rythemPanelBoard/rythemPanelBoard.kicad_pcb (2026-08-01)

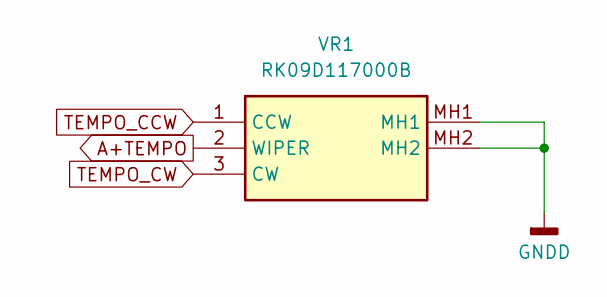
[picture p72: schematic TEMPO.kicad_sch]

Parts:
VR1: RK09D117000B; Manufacturer_Part_Number RK09D117000B; Mouser Part Number 688-RK09D117000B

Connections:
A+TEMPO: VR1.2 (WIPER); also elsewhere on the board
GNDD: VR1.MH1, VR1.MH2; also elsewhere on the board
TEMPO_CCW: VR1.1 (CCW); also elsewhere on the board
TEMPO_CW: VR1.3 (CW); also elsewhere on the board
