wakimizufu/TBSEQ/TBSEQ_Board_V4/rythemPanelBoard/rythemPanelBoard.kicad_pcb

## KiCad design TBSEQ_Board_V4/rythemPanelBoard/rythemPanelBoard.kicad_pcb (continued)

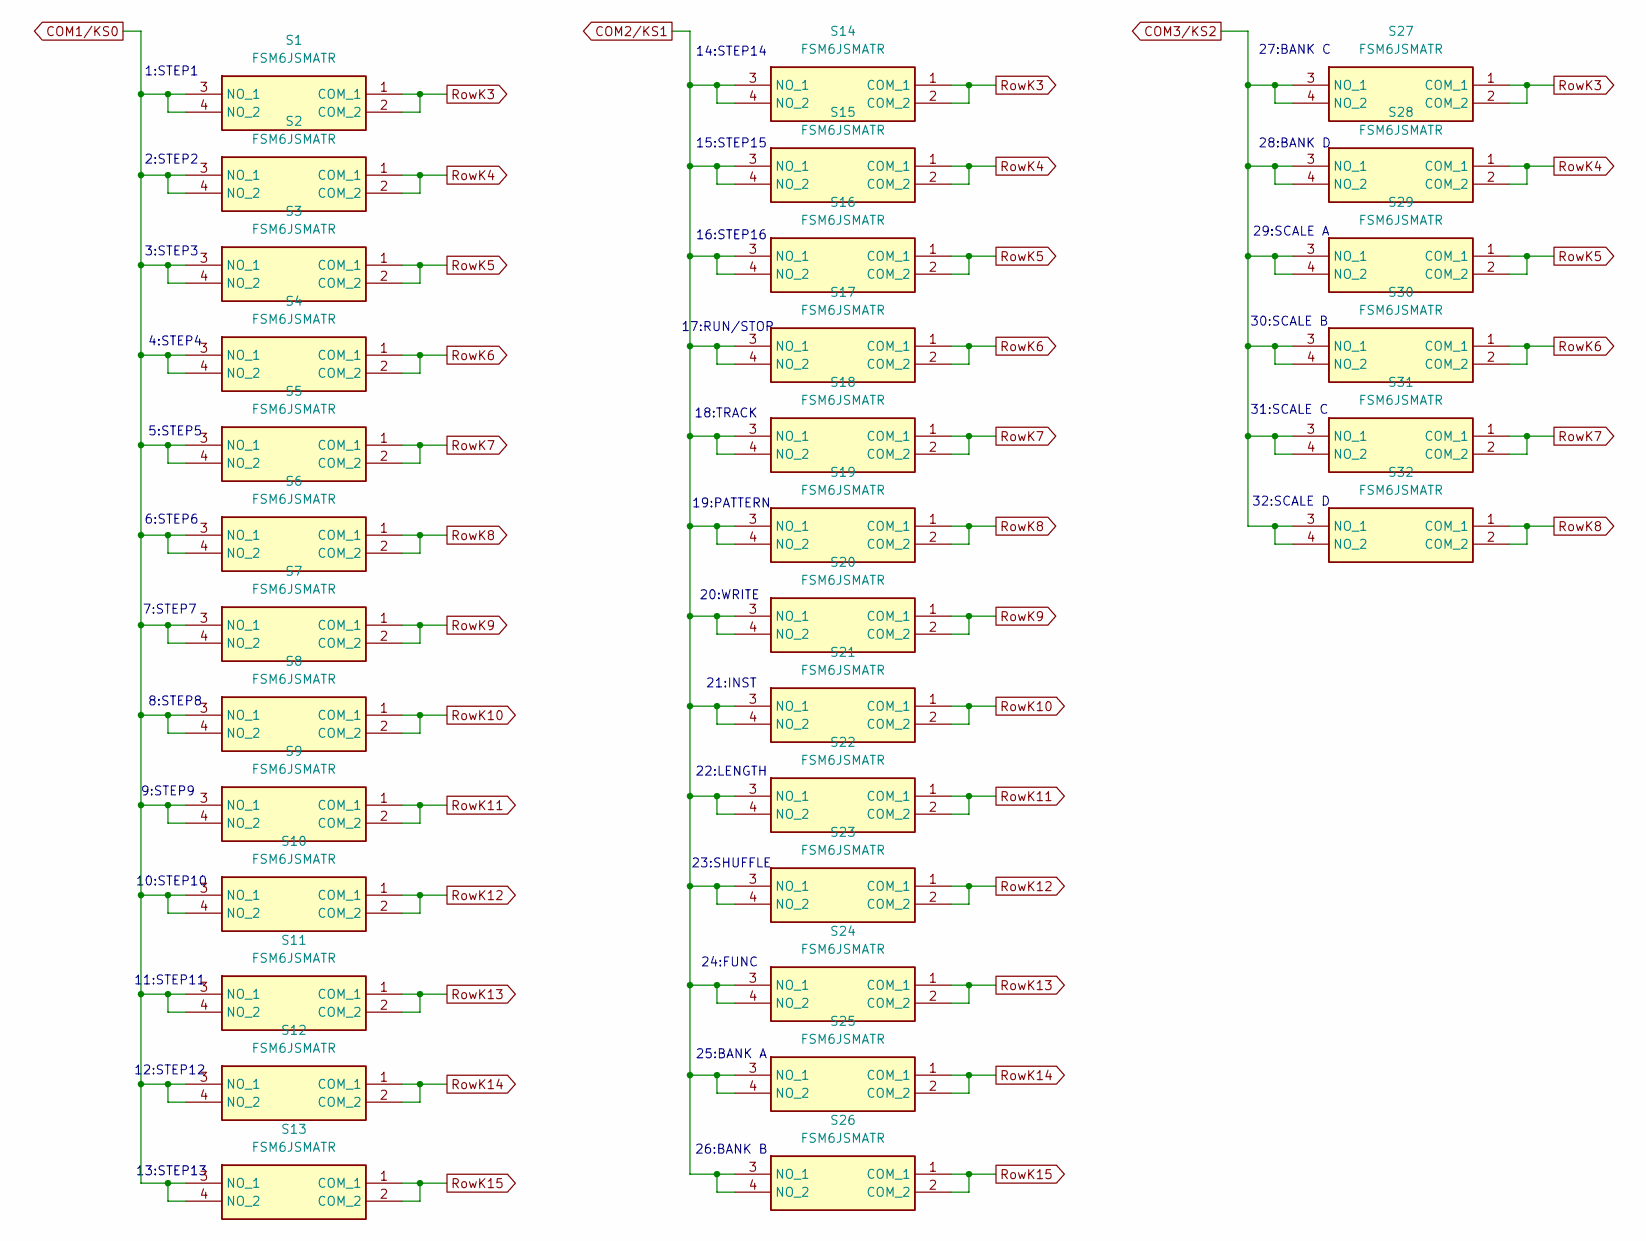
[picture p73: schematic SwitchMatrix.kicad_sch]

Parts:
S1, S2, S3, S4, S5, S6, S7, S8, S9, S10, S11, S12, S13, S14, S15, S16, S17, S18, S19, S20, S21, S22, S23, S24, S25, S26, S27, S28, S29, S30, S31, S32: FSM6JSMATR; Manufacturer_Part_Number FSM6JSMATR; Mouser Part Number N/A

Connections:
COM1/KS0: S1.3 (NO_1), S1.4 (NO_2), S2.3 (NO_1), S2.4 (NO_2), S3.3 (NO_1), S3.4 (NO_2), S4.3 (NO_1), S4.4 (NO_2), S5.3 (NO_1), S5.4 (NO_2), S6.3 (NO_1), S6.4 (NO_2), S7.3 (NO_1), S7.4 (NO_2), S8.3 (NO_1), S8.4 (NO_2), S9.3 (NO_1), S9.4 (NO_2), S10.3 (NO_1), S10.4 (NO_2), S11.3 (NO_1), S11.4 (NO_2), S12.3 (NO_1), S12.4 (NO_2), S13.3 (NO_1), S13.4 (NO_2); also elsewhere on the board
COM2/KS1: S14.3 (NO_1), S14.4 (NO_2), S15.3 (NO_1), S15.4 (NO_2), S16.3 (NO_1), S16.4 (NO_2), S17.3 (NO_1), S17.4 (NO_2), S18.3 (NO_1), S18.4 (NO_2), S19.3 (NO_1), S19.4 (NO_2), S20.3 (NO_1), S20.4 (NO_2), S21.3 (NO_1), S21.4 (NO_2), S22.3 (NO_1), S22.4 (NO_2), S23.3 (NO_1), S23.4 (NO_2), S24.3 (NO_1), S24.4 (NO_2), S25.3 (NO_1), S25.4 (NO_2), S26.3 (NO_1), S26.4 (NO_2); also elsewhere on the board
COM3/KS2: S27.3 (NO_1), S27.4 (NO_2), S28.3 (NO_1), S28.4 (NO_2), S29.3 (NO_1), S29.4 (NO_2), S30.3 (NO_1), S30.4 (NO_2), S31.3 (NO_1), S31.4 (NO_2), S32.3 (NO_1), S32.4 (NO_2); also elsewhere on the board
RowK3: S1.1 (COM_1), S1.2 (COM_2), S14.1 (COM_1), S14.2 (COM_2), S27.1 (COM_1), S27.2 (COM_2); also elsewhere on the board
RowK4: S2.1 (COM_1), S2.2 (COM_2), S15.1 (COM_1), S15.2 (COM_2), S28.1 (COM_1), S28.2 (COM_2); also elsewhere on the board
RowK5: S3.1 (COM_1), S3.2 (COM_2), S16.1 (COM_1), S16.2 (COM_2), S29.1 (COM_1), S29.2 (COM_2); also elsewhere on the board
RowK6: S4.1 (COM_1), S4.2 (COM_2), S17.1 (COM_1), S17.2 (COM_2), S30.1 (COM_1), S30.2 (COM_2); also elsewhere on the board
RowK7: S5.1 (COM_1), S5.2 (COM_2), S18.1 (COM_1), S18.2 (COM_2), S31.1 (COM_1), S31.2 (COM_2); also elsewhere on the board
RowK8: S6.1 (COM_1), S6.2 (COM_2), S19.1 (COM_1), S19.2 (COM_2), S32.1 (COM_1), S32.2 (COM_2); also elsewhere on the board
RowK9: S7.1 (COM_1), S7.2 (COM_2), S20.1 (COM_1), S20.2 (COM_2); also elsewhere on the board
RowK10: S8.1 (COM_1), S8.2 (COM_2), S21.1 (COM_1), S21.2 (COM_2); also elsewhere on the board
RowK11: S9.1 (COM_1), S9.2 (COM_2), S22.1 (COM_1), S22.2 (COM_2); also elsewhere on the board
RowK12: S10.1 (COM_1), S10.2 (COM_2), S23.1 (COM_1), S23.2 (COM_2); also elsewhere on the board
RowK13: S11.1 (COM_1), S11.2 (COM_2), S24.1 (COM_1), S24.2 (COM_2); also elsewhere on the board
RowK14: S12.1 (COM_1), S12.2 (COM_2), S25.1 (COM_1), S25.2 (COM_2); also elsewhere on the board
RowK15: S13.1 (COM_1), S13.2 (COM_2), S26.1 (COM_1), S26.2 (COM_2); also elsewhere on the board

Notes on the sheet:
4:STEP4
13:STEP13
11:STEP11
1:STEP1
19:PATTERN
10:STEP10
27:BANK C
5:STEP5
14:STEP14
2:STEP2
18:TRACK
24:FUNC
16:STEP16
3:STEP3
7:STEP7
31:SCALE C
8:STEP8
6:STEP6
32:SCALE D
21:INST
26:BANK B
17:RUN/STOP
23:SHUFFLE
9:STEP9
25:BANK A
29:SCALE A
12:STEP12
22:LENGTH
20:WRITE
15:STEP15
30:SCALE B
28:BANK D

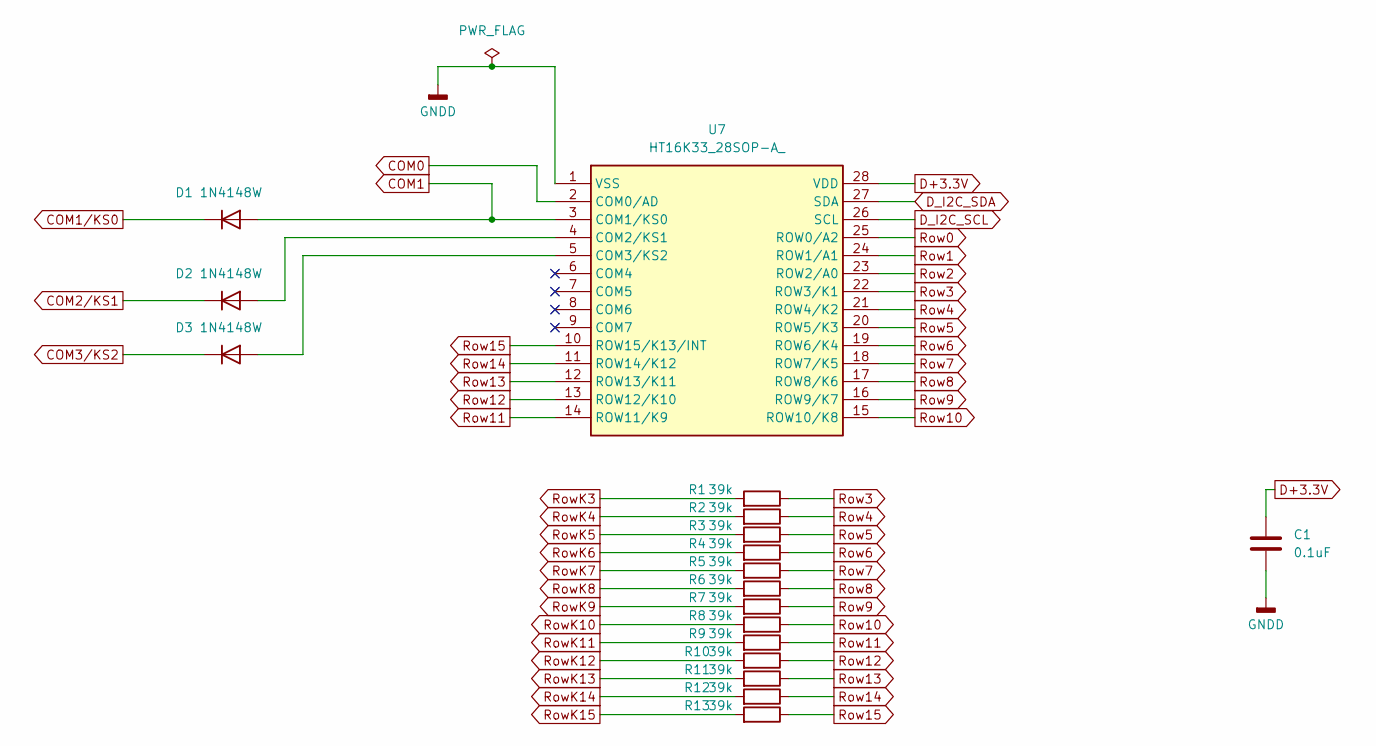
[picture p74: schematic HT16K33.kicad_sch]

Parts:
C1: 0.1uF; C_0603_1608Metric_Pad1.08x0.95mm_HandSolder
D1, D2, D3: 1N4148W; D_SOD-123
R1, R2, R3, R4, R5, R6, R7, R8, R9, R10, R11, R12, R13: 39k; R_0603_1608Metric_Pad0.98x0.95mm_HandSolder
U7: HT16K33_28SOP-A_; SOIC127P1031X264-28N; Manufacturer_Part_Number HT16K33(28SOP-A)

Connections:
COM0: U7.2 (COM0/AD); also elsewhere on the board
COM1: D1.2 (A), U7.3 (COM1/KS0); also elsewhere on the board
COM1/KS0: D1.1 (K); also elsewhere on the board
COM2/KS1: D2.1 (K); also elsewhere on the board
COM3/KS2: D3.1 (K); also elsewhere on the board
D+3.3V: C1.1, U7.28 (VDD); also elsewhere on the board
D_I2C_SCL: U7.26 (SCL); also elsewhere on the board
D_I2C_SDA: U7.27 (SDA); also elsewhere on the board
GNDD: C1.2, U7.1 (VSS); also elsewhere on the board
unnamed: D2.2 (A), U7.4 (COM2/KS1)
unnamed: D3.2 (A), U7.5 (COM3/KS2)
Row0: U7.25 (ROW0/A2); also elsewhere on the board
Row1: U7.24 (ROW1/A1); also elsewhere on the board
Row2: U7.23 (ROW2/A0); also elsewhere on the board
Row3: R1.1, U7.22 (ROW3/K1); also elsewhere on the board
Row4: R2.1, U7.21 (ROW4/K2); also elsewhere on the board
Row5: R3.1, U7.20 (ROW5/K3); also elsewhere on the board
Row6: R4.1, U7.19 (ROW6/K4); also elsewhere on the board
Row7: R5.1, U7.18 (ROW7/K5); also elsewhere on the board
Row8: R6.1, U7.17 (ROW8/K6); also elsewhere on the board
Row9: R7.1, U7.16 (ROW9/K7); also elsewhere on the board
Row10: R8.1, U7.15 (ROW10/K8); also elsewhere on the board
Row11: R9.1, U7.14 (ROW11/K9); also elsewhere on the board
Row12: R10.1, U7.13 (ROW12/K10); also elsewhere on the board
Row13: R11.1, U7.12 (ROW13/K11); also elsewhere on the board
Row14: R12.1, U7.11 (ROW14/K12); also elsewhere on the board
Row15: R13.1, U7.10 (ROW15/K13/INT); also elsewhere on the board
RowK3: R1.2; also elsewhere on the board
RowK4: R2.2; also elsewhere on the board
RowK5: R3.2; also elsewhere on the board
RowK6: R4.2; also elsewhere on the board
RowK7: R5.2; also elsewhere on the board
RowK8: R6.2; also elsewhere on the board
RowK9: R7.2; also elsewhere on the board
RowK10: R8.2; also elsewhere on the board
RowK11: R9.2; also elsewhere on the board
RowK12: R10.2; also elsewhere on the board
RowK13: R11.2; also elsewhere on the board
RowK14: R12.2; also elsewhere on the board
RowK15: R13.2; also elsewhere on the board

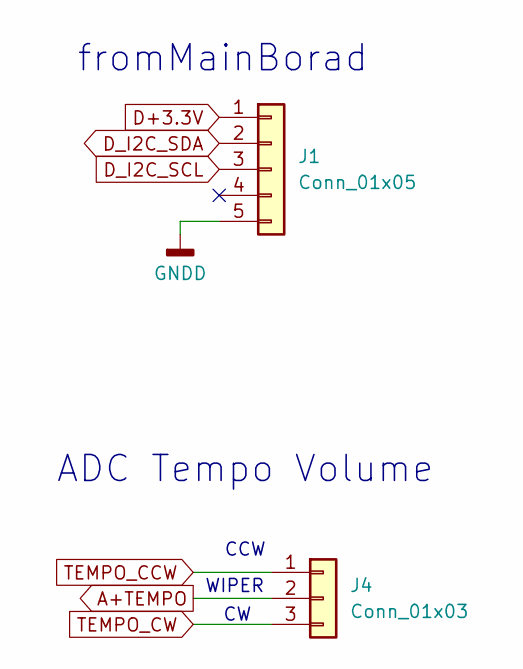
[picture p75: schematic Jack.kicad_sch]

Parts:
J1: Conn_01x05; PinSocket_1x05_P2.54mm_Vertical
J4: Conn_01x03; PinSocket_1x03_P2.54mm_Vertical

Connections:
A+TEMPO: J4.2; also elsewhere on the board
D+3.3V: J1.1; also elsewhere on the board
D_I2C_SCL: J1.3; also elsewhere on the board
D_I2C_SDA: J1.2; also elsewhere on the board
GNDD: J1.5; also elsewhere on the board
TEMPO_CCW: J4.1; also elsewhere on the board
TEMPO_CW: J4.3; also elsewhere on the board

Notes on the sheet:
CCW
WIPER
ADC Tempo Volume
fromMainBorad

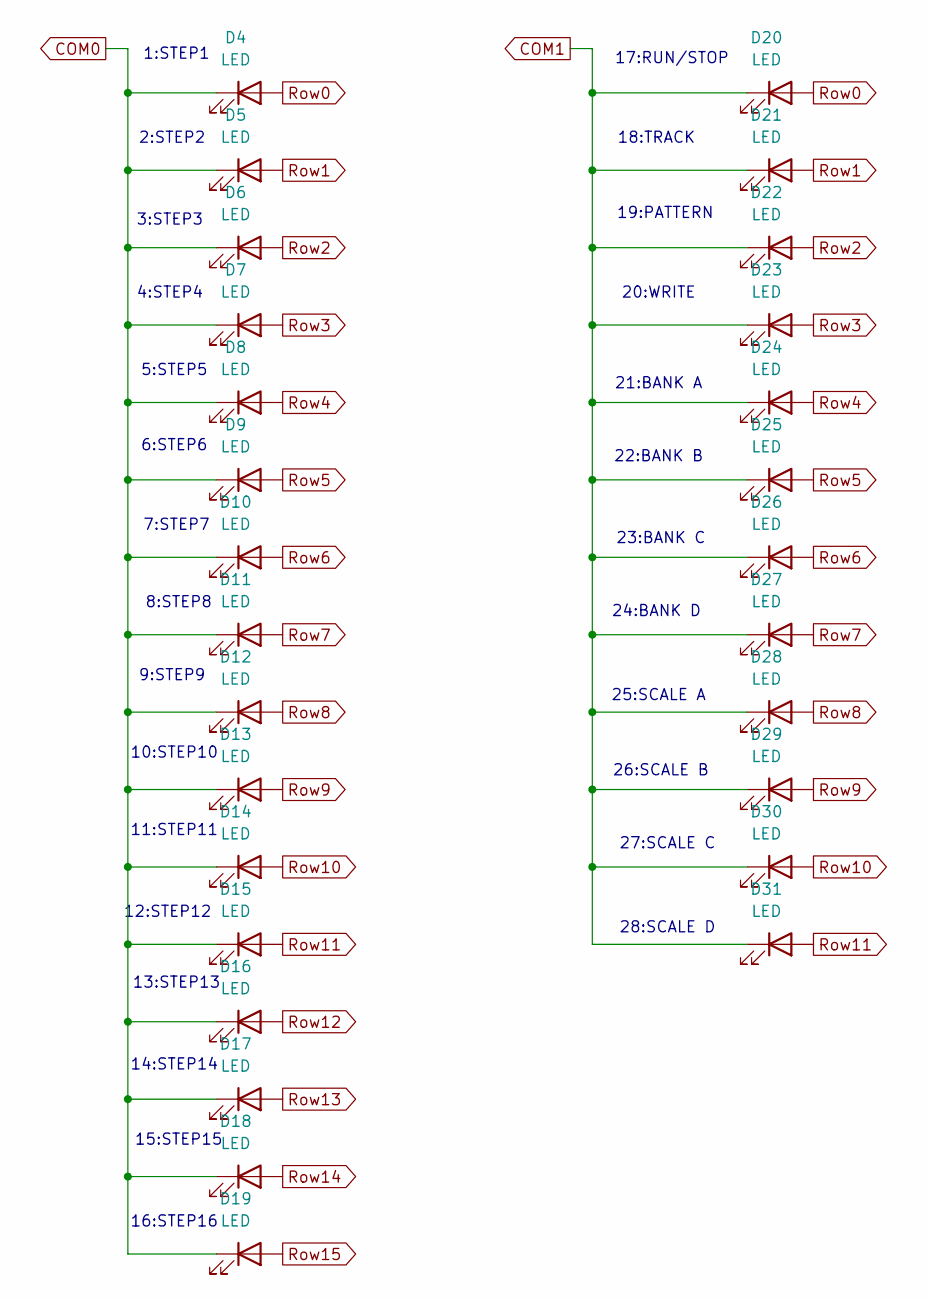
[picture p76: schematic LEDMatrix.kicad_sch]

Parts:
D4, D5, D6, D7, D8, D9, D10, D11, D12, D13, D14, D15, D16, D17, D18, D19, D20, D21, D22, D23, D24, D25, D26, D27, D28, D29, D30, D31: LED; LED_0603_1608Metric_Pad1.05x0.95mm_HandSolder

Connections:
COM0: D4.1 (K), D5.1 (K), D6.1 (K), D7.1 (K), D8.1 (K), D9.1 (K), D10.1 (K), D11.1 (K), D12.1 (K), D13.1 (K), D14.1 (K), D15.1 (K), D16.1 (K), D17.1 (K), D18.1 (K), D19.1 (K); also elsewhere on the board
COM1: D20.1 (K), D21.1 (K), D22.1 (K), D23.1 (K), D24.1 (K), D25.1 (K), D26.1 (K), D27.1 (K), D28.1 (K), D29.1 (K), D30.1 (K), D31.1 (K); also elsewhere on the board
Row0: D4.2 (A), D20.2 (A); also elsewhere on the board
Row1: D5.2 (A), D21.2 (A); also elsewhere on the board
Row2: D6.2 (A), D22.2 (A); also elsewhere on the board
Row3: D7.2 (A), D23.2 (A); also elsewhere on the board
Row4: D8.2 (A), D24.2 (A); also elsewhere on the board
Row5: D9.2 (A), D25.2 (A); also elsewhere on the board
Row6: D10.2 (A), D26.2 (A); also elsewhere on the board
Row7: D11.2 (A), D27.2 (A); also elsewhere on the board
Row8: D12.2 (A), D28.2 (A); also elsewhere on the board
Row9: D13.2 (A), D29.2 (A); also elsewhere on the board
Row10: D14.2 (A), D30.2 (A); also elsewhere on the board
Row11: D15.2 (A), D31.2 (A); also elsewhere on the board
Row12: D16.2 (A); also elsewhere on the board
Row13: D17.2 (A); also elsewhere on the board
Row14: D18.2 (A); also elsewhere on the board
Row15: D19.2 (A); also elsewhere on the board

Notes on the sheet:
22:BANK B
16:STEP16
9:STEP9
1:STEP1
25:SCALE A
4:STEP4
20:WRITE
14:STEP14
5:STEP5
17:RUN/STOP
13:STEP13
2:STEP2
3:STEP3
23:BANK C
26:SCALE B
10:STEP10
21:BANK A
18:TRACK
28:SCALE D
27:SCALE C
19:PATTERN
7:STEP7
11:STEP11
24:BANK D
15:STEP15
6:STEP6
12:STEP12
8:STEP8

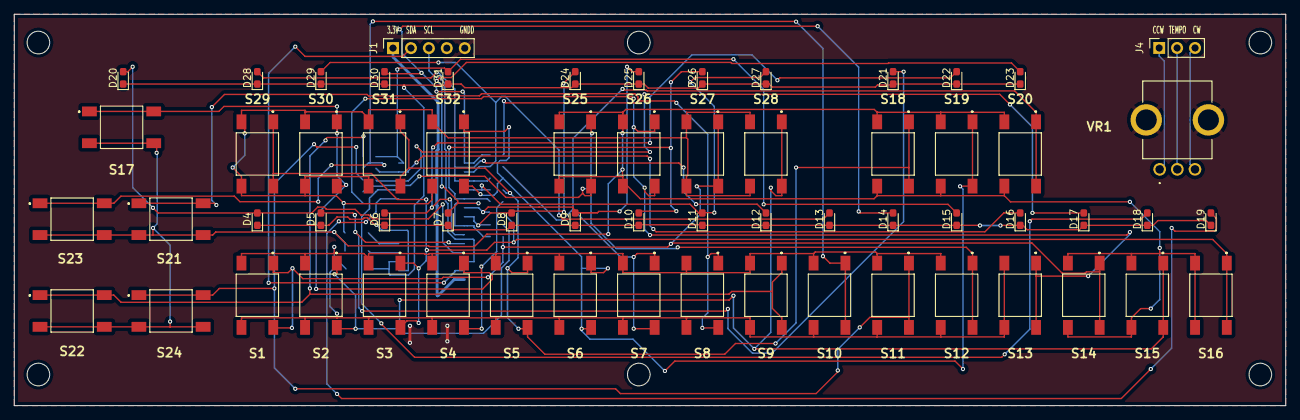
[picture p77: board rythemPanelBoard.kicad_pcb from above]

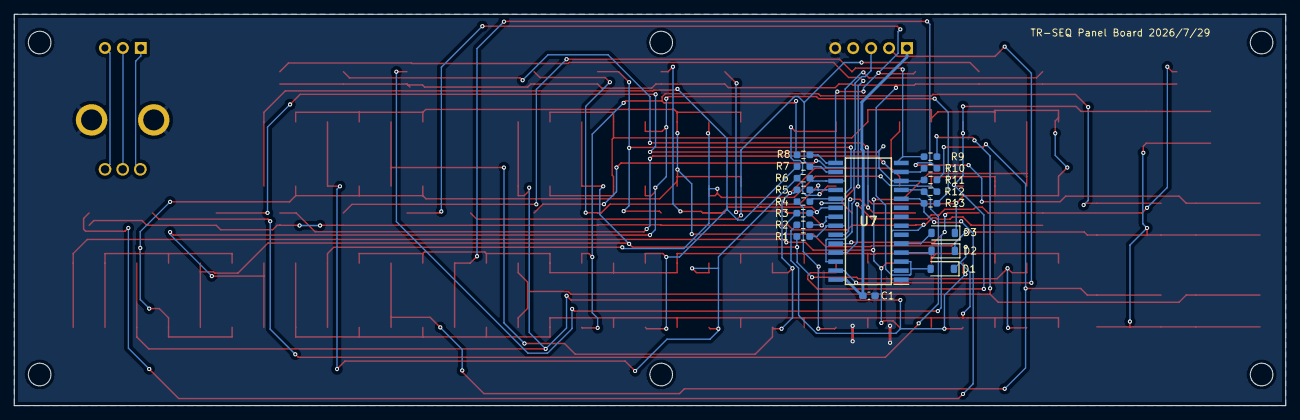
[picture p78: board rythemPanelBoard.kicad_pcb from below]

Board: 2 copper layers, 180.0 x 55.4 mm, 81 parts (18 on the bottom side), 43 nets.
