wakimizufu/TBSEQ/testODDT/testODDT.kicad_pcb

## KiCad design testODDT/testODDT.kicad_pcb (2026-06-03)

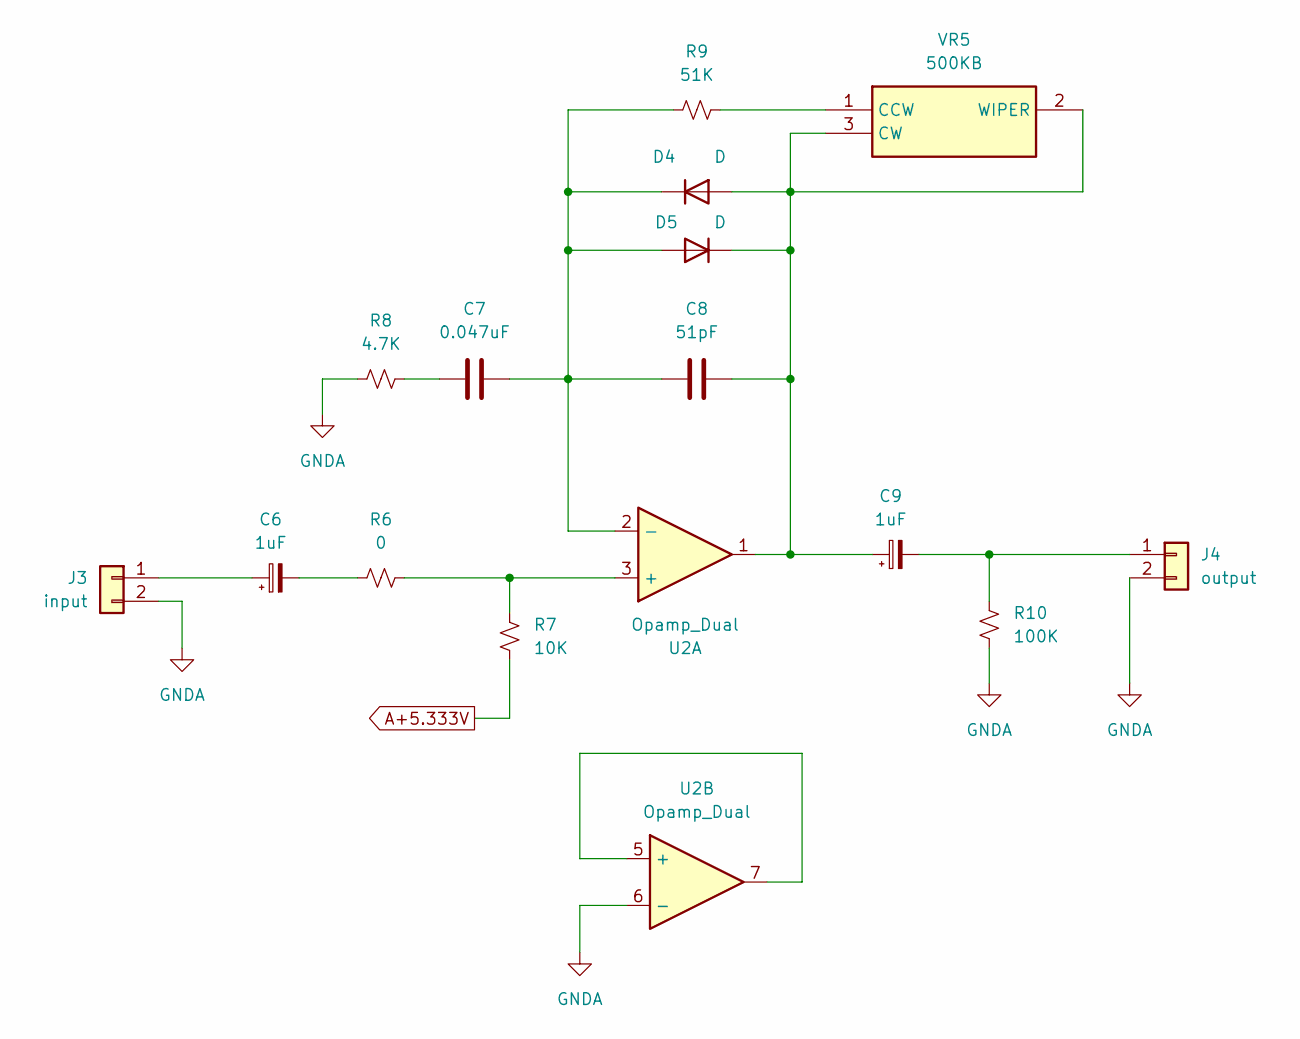
[picture p79: schematic Ibanez_Tube_Screamer_TS808.kicad_sch]

Parts:
C6, C9: 1uF; CP_Radial_D5.0mm_P2.50mm
C7: 0.047uF; C_Disc_D5.0mm_W2.5mm_P5.00mm
C8: 51pF; C_Disc_D5.0mm_W2.5mm_P5.00mm
D4, D5: D; D_DO-35_SOD27_P7.62mm_Horizontal
J3: input; PinHeader_1x02_P2.54mm_Vertical
J4: output; PinHeader_1x02_P2.54mm_Vertical
R6: 0; R_Axial_DIN0204_L3.6mm_D1.6mm_P2.54mm_Vertical
R7: 10K; R_Axial_DIN0204_L3.6mm_D1.6mm_P2.54mm_Vertical
R8: 4.7K; R_Axial_DIN0204_L3.6mm_D1.6mm_P2.54mm_Vertical
R9: 51K; R_Axial_DIN0204_L3.6mm_D1.6mm_P2.54mm_Vertical
R10: 100K; R_Axial_DIN0204_L3.6mm_D1.6mm_P2.54mm_Vertical
U2: Opamp_Dual; DIP-8_W7.62mm_Socket_LongPads
VR5: 500KB; 3362P_1; Manufacturer_Part_Number 3362P-1-103LF; Mouser Part Number 652-3362P-1-103LF

Connections:
A+5.333V: R7.2; also elsewhere on the board
GNDA: J3.2, J4.2, R8.2, R10.2, U2.6 (-); also elsewhere on the board
unnamed: C6.2, R6.2
unnamed: C7.2, R8.1
unnamed: C8.1, C9.1, D4.2 (A), D5.1 (K), U2.1, VR5.2 (WIPER), VR5.3 (CW)
unnamed: C7.1, C8.2, D4.1 (K), D5.2 (A), R9.2, U2.2 (-)
unnamed: C6.1, J3.1
unnamed: C9.2, J4.1, R10.1
unnamed: R6.1, R7.1, U2.3 (+)
unnamed: U2.5 (+), U2.7
unnamed: R9.1, VR5.1 (CCW)

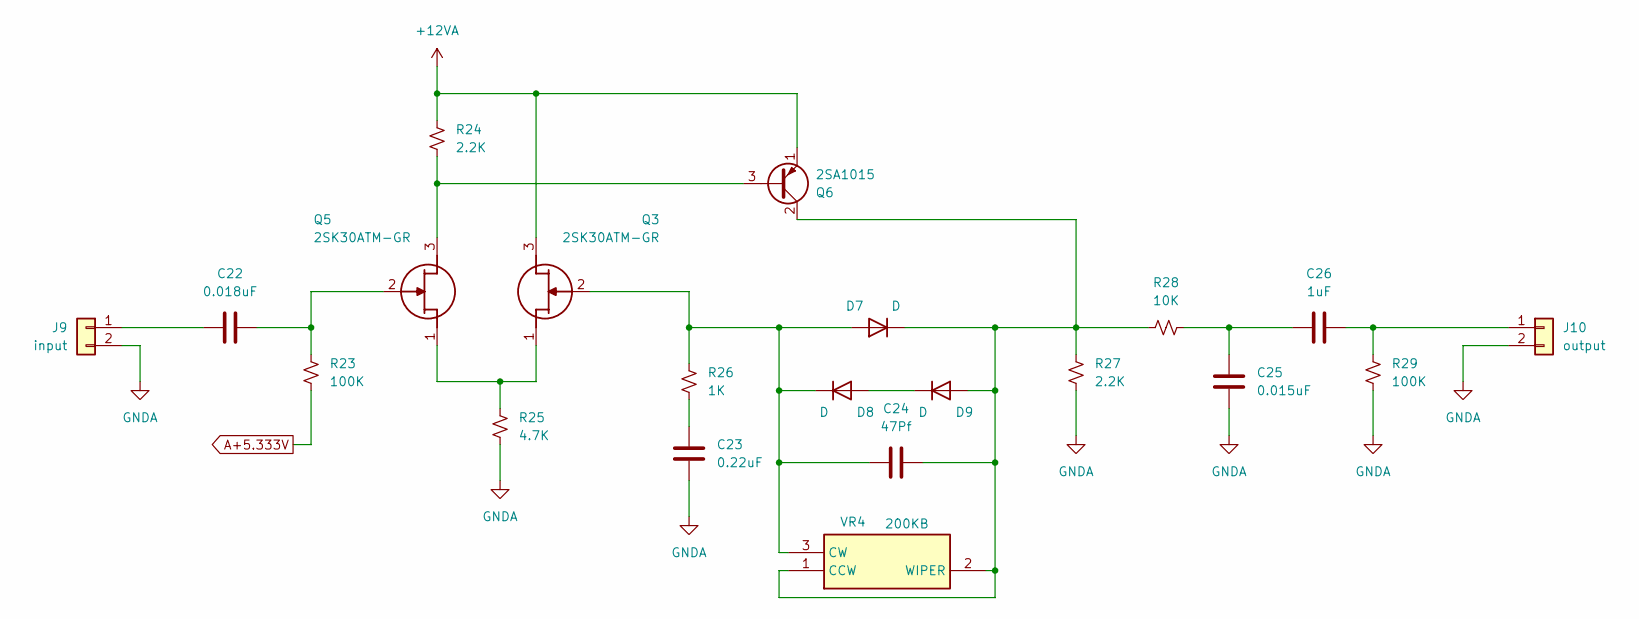
[picture p80: schematic BOSS_OD-2_Clipper.kicad_sch]

Parts:
C22: 0.018uF; C_Disc_D5.0mm_W2.5mm_P5.00mm
C23: 0.22uF; C_Disc_D5.0mm_W2.5mm_P5.00mm
C24: 47Pf; C_Disc_D5.0mm_W2.5mm_P5.00mm
C25: 0.015uF; C_Disc_D5.0mm_W2.5mm_P5.00mm
C26: 1uF; C_Disc_D5.0mm_W2.5mm_P5.00mm
D7, D8, D9: D; D_DO-35_SOD27_P7.62mm_Horizontal
J9: input; PinHeader_1x02_P2.54mm_Vertical
J10: output; PinHeader_1x02_P2.54mm_Vertical
Q3, Q5: 2SK30ATM-GR; TO-92_HandSolder; Manufacturer_Part_Number 2SK30ATM-GR
Q6: 2SA1015; TO-92_HandSolder
R23, R29: 100K; R_Axial_DIN0204_L3.6mm_D1.6mm_P2.54mm_Vertical
R24, R27: 2.2K; R_Axial_DIN0204_L3.6mm_D1.6mm_P2.54mm_Vertical
R25: 4.7K; R_Axial_DIN0204_L3.6mm_D1.6mm_P2.54mm_Vertical
R26: 1K; R_Axial_DIN0204_L3.6mm_D1.6mm_P2.54mm_Vertical
R28: 10K; R_Axial_DIN0204_L3.6mm_D1.6mm_P2.54mm_Vertical
VR4: 200KB; 3362P_1; Manufacturer_Part_Number 3362P-1-103LF; Mouser Part Number 652-3362P-1-103LF

Connections:
+12VA: Q3.3 (D), Q6.1 (E), R24.1; also elsewhere on the board
A+5.333V: R23.2; also elsewhere on the board
GNDA: C23.2, C25.2, J9.2, J10.2, R25.2, R27.2, R29.2; also elsewhere on the board
unnamed: C23.1, R26.2
unnamed: C25.1, C26.1, R28.2
unnamed: C24.2, D7.2 (A), D8.1 (K), Q3.2 (G), R26.1, VR4.3 (CW)
unnamed: C24.1, D7.1 (K), D9.2 (A), Q6.2 (C), R27.1, R28.1, VR4.1 (CCW), VR4.2 (WIPER)
unnamed: D8.2 (A), D9.1 (K)
unnamed: C22.2, J9.1
unnamed: C26.2, J10.1, R29.1
unnamed: Q3.1 (S), Q5.1 (S), R25.1
unnamed: Q5.3 (D), Q6.3 (B), R24.2
unnamed: C22.1, Q5.2 (G), R23.1

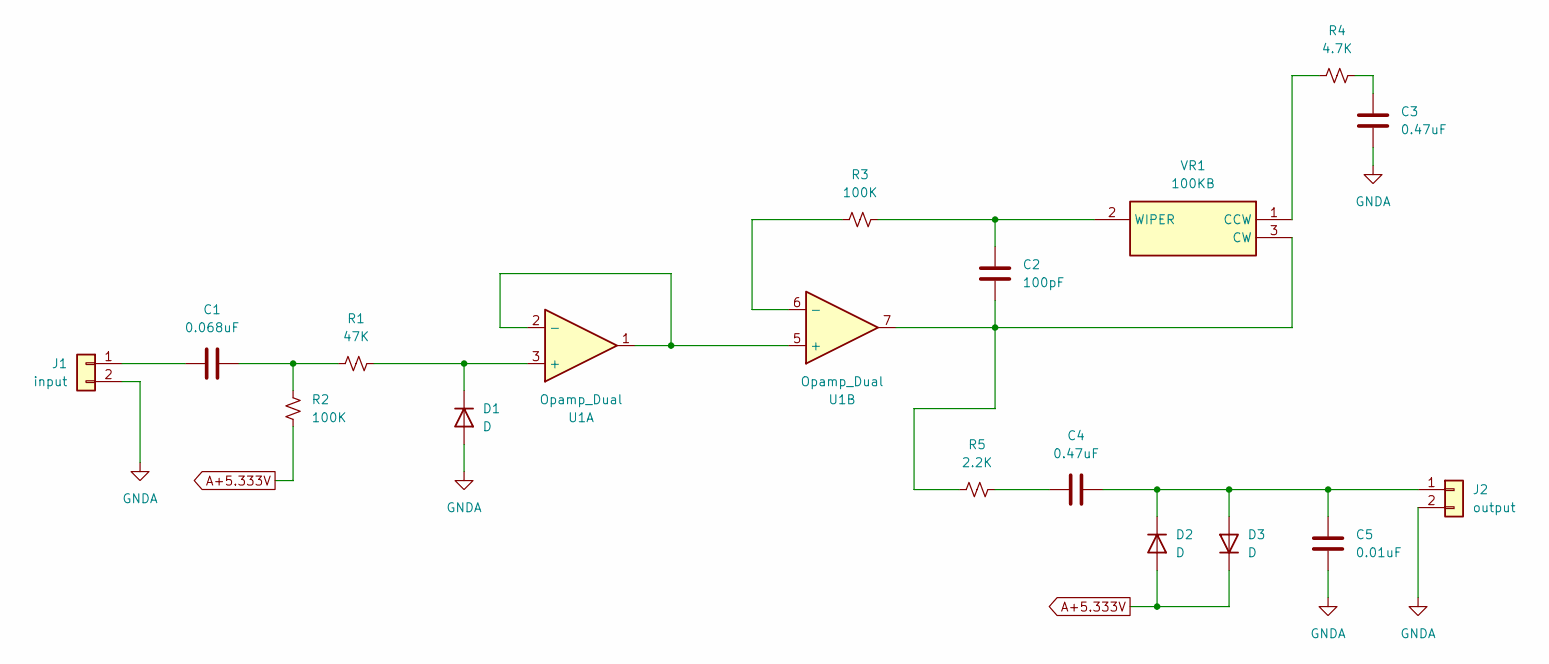
[picture p81: schematic BOSS_DS-1_Clipper.kicad_sch]

Parts:
C1: 0.068uF; C_Disc_D5.0mm_W2.5mm_P5.00mm
C2: 100pF; C_Disc_D5.0mm_W2.5mm_P5.00mm
C3, C4: 0.47uF; C_Disc_D5.0mm_W2.5mm_P5.00mm
C5: 0.01uF; C_Disc_D5.0mm_W2.5mm_P5.00mm
D1, D2, D3: D; D_DO-35_SOD27_P7.62mm_Horizontal
J1: input; PinHeader_1x02_P2.54mm_Vertical
J2: output; PinHeader_1x02_P2.54mm_Vertical
R1: 47K; R_Axial_DIN0204_L3.6mm_D1.6mm_P2.54mm_Vertical
R2, R3: 100K; R_Axial_DIN0204_L3.6mm_D1.6mm_P2.54mm_Vertical
R4: 4.7K; R_Axial_DIN0204_L3.6mm_D1.6mm_P2.54mm_Vertical
R5: 2.2K; R_Axial_DIN0204_L3.6mm_D1.6mm_P2.54mm_Vertical
U1: Opamp_Dual; DIP-8_W7.62mm_Socket_LongPads
VR1: 100KB; 3362P_1; Manufacturer_Part_Number 3362P-1-103LF; Mouser Part Number 652-3362P-1-103LF

Connections:
A+5.333V: D2.2 (A), D3.1 (K), R2.1; also elsewhere on the board
GNDA: C3.2, C5.1, D1.2 (A), J1.2, J2.2; also elsewhere on the board
unnamed: C1.1, R1.1, R2.2
unnamed: C3.1, R4.2
unnamed: C4.1, R5.2
unnamed: D1.1 (K), R1.2, U1.3 (+)
unnamed: C4.2, C5.2, D2.1 (K), D3.2 (A), J2.1
unnamed: C1.2, J1.1
unnamed: U1.1, U1.2 (-), U1.5 (+)
unnamed: R3.1, U1.6 (-)
unnamed: R4.1, VR1.1 (CCW)
unnamed: C2.2, R5.1, U1.7, VR1.3 (CW)
unnamed: C2.1, R3.2, VR1.2 (WIPER)

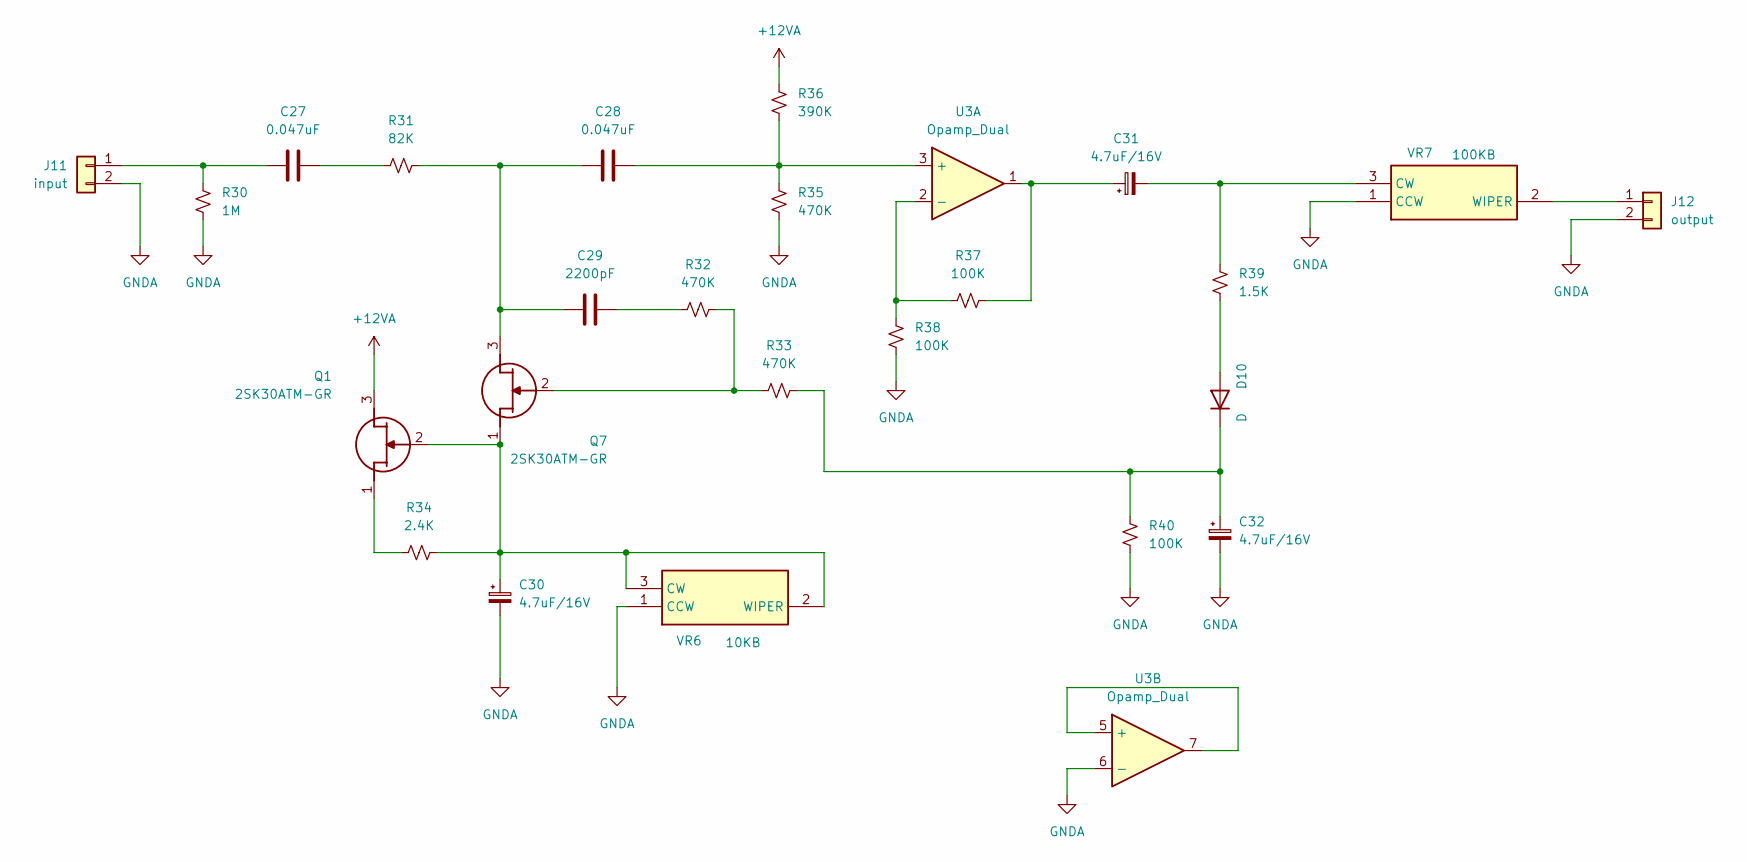
[picture p82: schematic DanArmstring_OrangeSquezzer.kicad_sch]

Parts:
C27, C28: 0.047uF; C_Disc_D5.0mm_W2.5mm_P5.00mm
C29: 2200pF; C_Disc_D5.0mm_W2.5mm_P5.00mm
C30, C31, C32: 4.7uF/16V; CP_Radial_D5.0mm_P2.50mm
D10: D; D_DO-35_SOD27_P7.62mm_Horizontal
J11: input; PinHeader_1x02_P2.54mm_Vertical
J12: output; PinHeader_1x02_P2.54mm_Vertical
Q1, Q7: 2SK30ATM-GR; TO-92_HandSolder; Manufacturer_Part_Number 2SK30ATM-GR
R30: 1M; R_Axial_DIN0204_L3.6mm_D1.6mm_P2.54mm_Vertical
R31: 82K; R_Axial_DIN0204_L3.6mm_D1.6mm_P2.54mm_Vertical
R32, R33, R35: 470K; R_Axial_DIN0204_L3.6mm_D1.6mm_P2.54mm_Vertical
R34: 2.4K; R_Axial_DIN0204_L3.6mm_D1.6mm_P2.54mm_Vertical
R36: 390K; R_Axial_DIN0204_L3.6mm_D1.6mm_P2.54mm_Vertical
R37, R38, R40: 100K; R_Axial_DIN0204_L3.6mm_D1.6mm_P2.54mm_Vertical
R39: 1.5K; R_Axial_DIN0204_L3.6mm_D1.6mm_P2.54mm_Vertical
U3: Opamp_Dual; DIP-8_W7.62mm_Socket_LongPads
VR6: 10KB; 3362P_1; Manufacturer_Part_Number 3362P-1-103LF; Mouser Part Number 652-3362P-1-103LF
VR7: 100KB; 3362P_1; Manufacturer_Part_Number 3362P-1-103LF; Mouser Part Number 652-3362P-1-103LF

Connections:
+12VA: Q1.3 (D), R36.1; also elsewhere on the board
GNDA: C30.2, C32.2, J11.2, J12.2, R30.2, R35.2, R38.1, R40.2, U3.6 (-), VR6.1 (CCW), VR7.1 (CCW); also elsewhere on the board
unnamed: C27.1, R31.1
unnamed: C29.1, R32.1
unnamed: C31.1, R37.2, U3.1
unnamed: D10.2 (A), R39.2
unnamed: C32.1, D10.1 (K), R33.2, R40.1
unnamed: C27.2, J11.1, R30.1
unnamed: J12.1, VR7.2 (WIPER)
unnamed: C30.1, Q1.2 (G), Q7.1 (S), R34.2, VR6.2 (WIPER), VR6.3 (CW)
unnamed: Q1.1 (S), R34.1
unnamed: C28.2, C29.2, Q7.3 (D), R31.2
unnamed: Q7.2 (G), R32.2, R33.1
unnamed: C28.1, R35.1, R36.2, U3.3 (+)
unnamed: R37.1, R38.2, U3.2 (-)
unnamed: U3.5 (+), U3.7
unnamed: C31.2, R39.1, VR7.3 (CW)

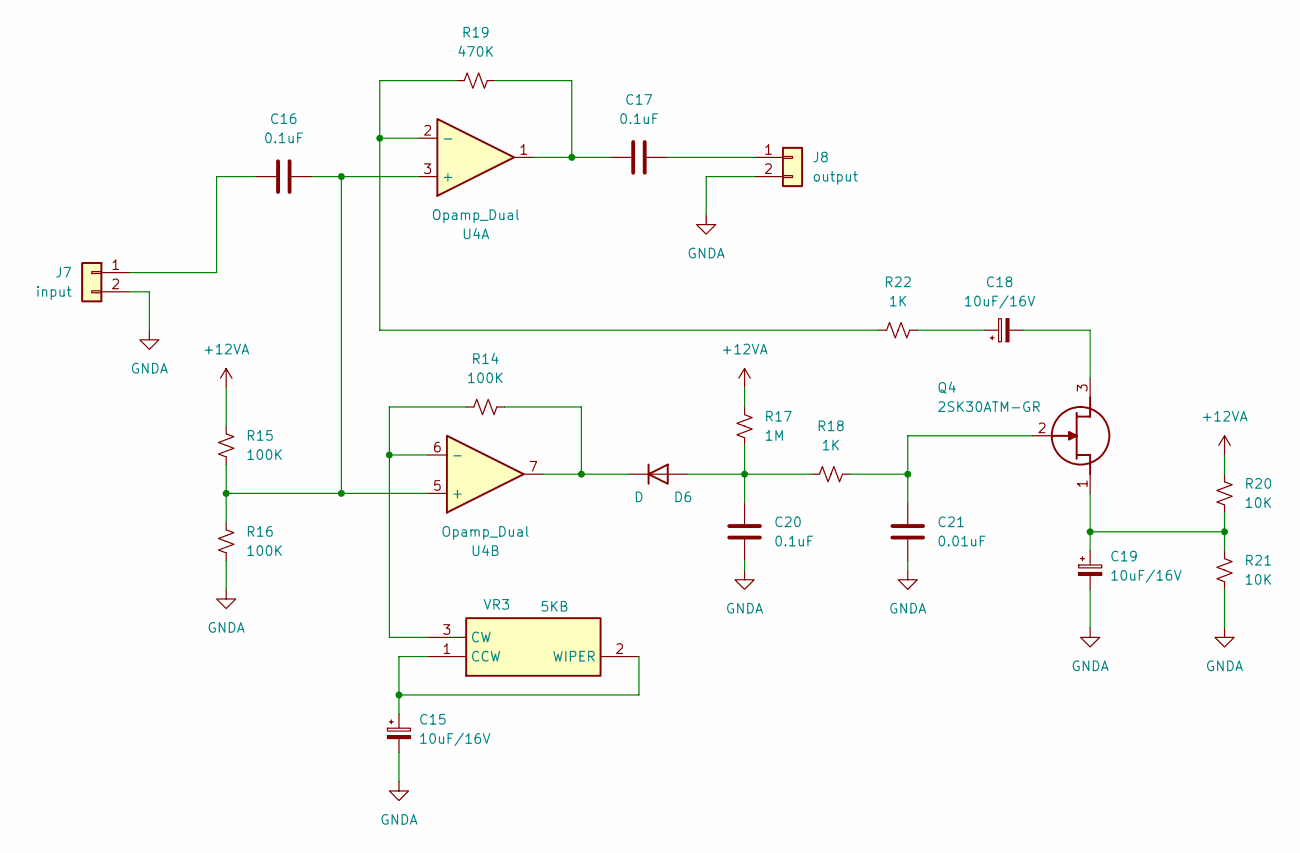
[picture p83: schematic NewEffector81_Sastener.kicad_sch]

Parts:
C15, C18, C19: 10uF/16V; CP_Radial_D5.0mm_P2.50mm
C16, C17, C20: 0.1uF; C_Disc_D5.0mm_W2.5mm_P5.00mm
C21: 0.01uF; C_Disc_D5.0mm_W2.5mm_P5.00mm
D6: D; D_DO-35_SOD27_P7.62mm_Horizontal
J7: input; PinHeader_1x02_P2.54mm_Vertical
J8: output; PinHeader_1x02_P2.54mm_Vertical
Q4: 2SK30ATM-GR; TO-92_HandSolder; Manufacturer_Part_Number 2SK30ATM-GR
R14, R15, R16: 100K; R_Axial_DIN0204_L3.6mm_D1.6mm_P2.54mm_Vertical
R17: 1M; R_Axial_DIN0204_L3.6mm_D1.6mm_P2.54mm_Vertical
R18, R22: 1K; R_Axial_DIN0204_L3.6mm_D1.6mm_P2.54mm_Vertical
R19: 470K; R_Axial_DIN0204_L3.6mm_D1.6mm_P2.54mm_Vertical
R20, R21: 10K; R_Axial_DIN0204_L3.6mm_D1.6mm_P2.54mm_Vertical
U4: Opamp_Dual; DIP-8_W7.62mm_Socket_LongPads
VR3: 5KB; 3362P_1; Manufacturer_Part_Number 3362P-1-103LF; Mouser Part Number 652-3362P-1-103LF

Connections:
+12VA: R15.1, R17.1, R20.1; also elsewhere on the board
GNDA: C15.2, C19.2, C20.2, C21.2, J7.2, J8.2, R16.2, R21.2; also elsewhere on the board
unnamed: C17.2, R19.1, U4.1
unnamed: C18.1, R22.2
unnamed: C20.1, D6.2 (A), R17.2, R18.1
unnamed: D6.1 (K), R14.1, U4.7
unnamed: C16.2, J7.1
unnamed: C17.1, J8.1
unnamed: C18.2, Q4.3 (D)
unnamed: C21.1, Q4.2 (G), R18.2
unnamed: C19.1, Q4.1 (S), R20.2, R21.1
unnamed: C16.1, R15.2, R16.1, U4.3 (+), U4.5 (+)
unnamed: R19.2, R22.1, U4.2 (-)
unnamed: R14.2, U4.6 (-), VR3.3 (CW)
unnamed: C15.1, VR3.1 (CCW), VR3.2 (WIPER)

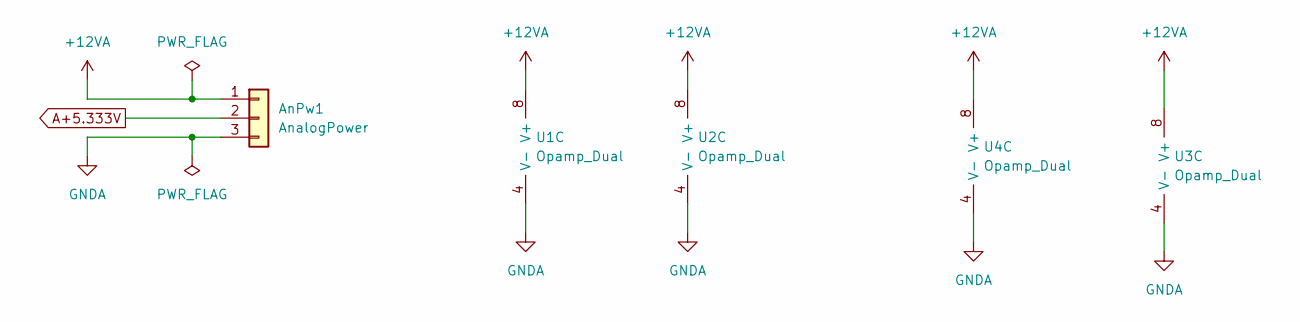
[picture p84: schematic Power.kicad_sch]

Parts:
AnPw1: AnalogPower; PinSocket_1x03_P2.54mm_Vertical
U1, U2, U3, U4: Opamp_Dual; DIP-8_W7.62mm_Socket_LongPads

Connections:
+12VA: AnPw1.1, U1.8 (V+), U2.8 (V+), U3.8 (V+), U4.8 (V+); also elsewhere on the board
A+5.333V: AnPw1.2; also elsewhere on the board
GNDA: AnPw1.3, U1.4 (V-), U2.4 (V-), U3.4 (V-), U4.4 (V-); also elsewhere on the board

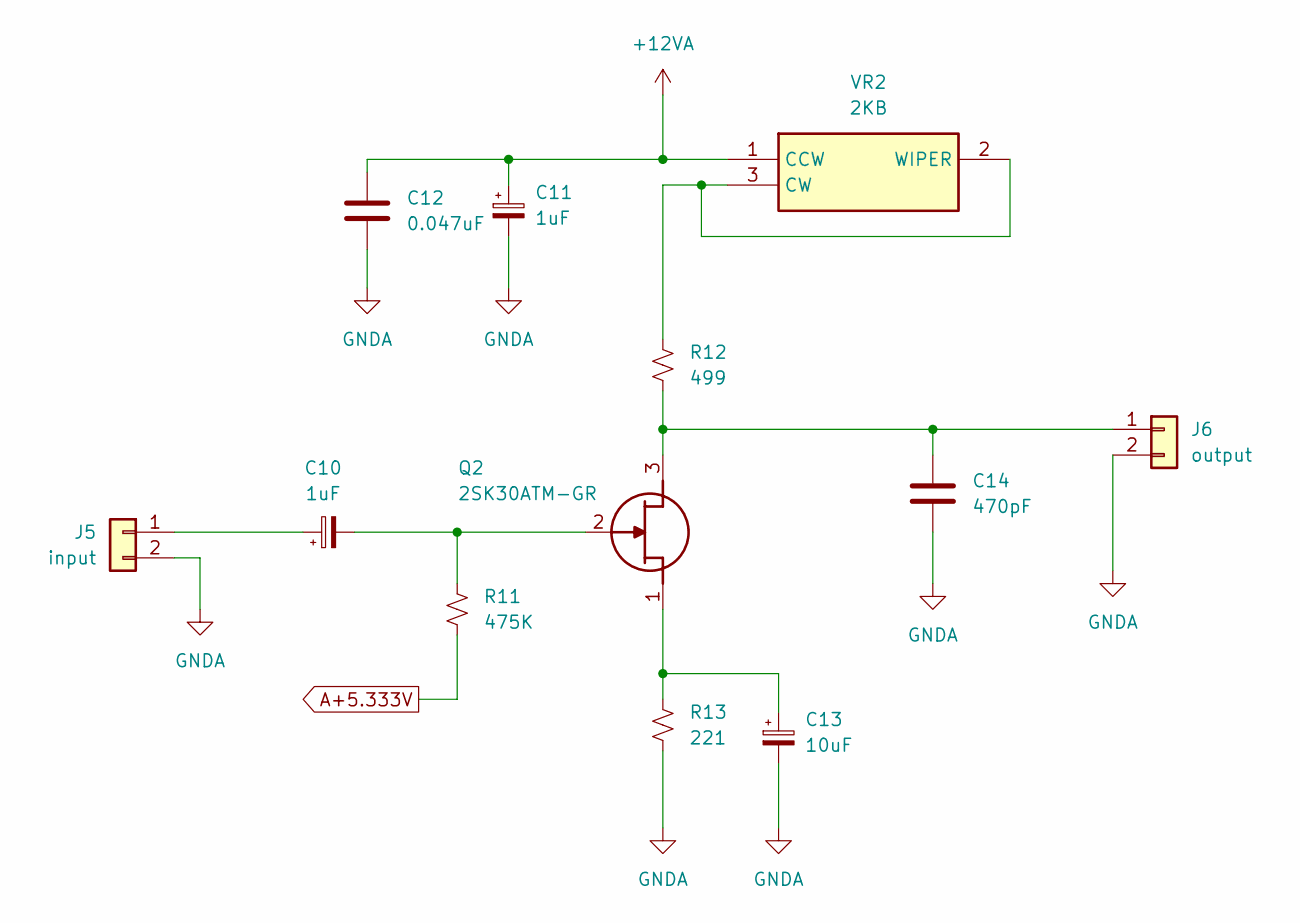
[picture p85: schematic Moog Sub Phatty Overdrive.kicad_sch]

Parts:
C10, C11: 1uF; CP_Radial_D5.0mm_P2.50mm
C12: 0.047uF; C_Disc_D5.0mm_W2.5mm_P5.00mm
C13: 10uF; CP_Radial_D5.0mm_P2.50mm
C14: 470pF; C_Disc_D5.0mm_W2.5mm_P5.00mm
J5: input; PinHeader_1x02_P2.54mm_Vertical
J6: output; PinHeader_1x02_P2.54mm_Vertical
Q2: 2SK30ATM-GR; TO-92_HandSolder; Manufacturer_Part_Number 2SK30ATM-GR
R11: 475K; R_Axial_DIN0204_L3.6mm_D1.6mm_P2.54mm_Vertical
R12: 499; R_Axial_DIN0204_L3.6mm_D1.6mm_P2.54mm_Vertical
R13: 221; R_Axial_DIN0204_L3.6mm_D1.6mm_P2.54mm_Vertical
VR2: 2KB; 3362P_1; Manufacturer_Part_Number 3362P-1-103LF; Mouser Part Number 652-3362P-1-103LF

Connections:
+12VA: C11.1, C12.1, VR2.1 (CCW); also elsewhere on the board
A+5.333V: R11.2; also elsewhere on the board
GNDA: C11.2, C12.2, C13.2, C14.2, J5.2, J6.2, R13.2; also elsewhere on the board
unnamed: C10.1, J5.1
unnamed: C14.1, J6.1, Q2.3 (D), R12.2
unnamed: C10.2, Q2.2 (G), R11.1
unnamed: C13.1, Q2.1 (S), R13.1
unnamed: R12.1, VR2.2 (WIPER), VR2.3 (CW)
