wakimizufu/TBSEQ/testODDT/testODDT.kicad_pcb

## KiCad design testODDT/testODDT.kicad_pcb (continued)

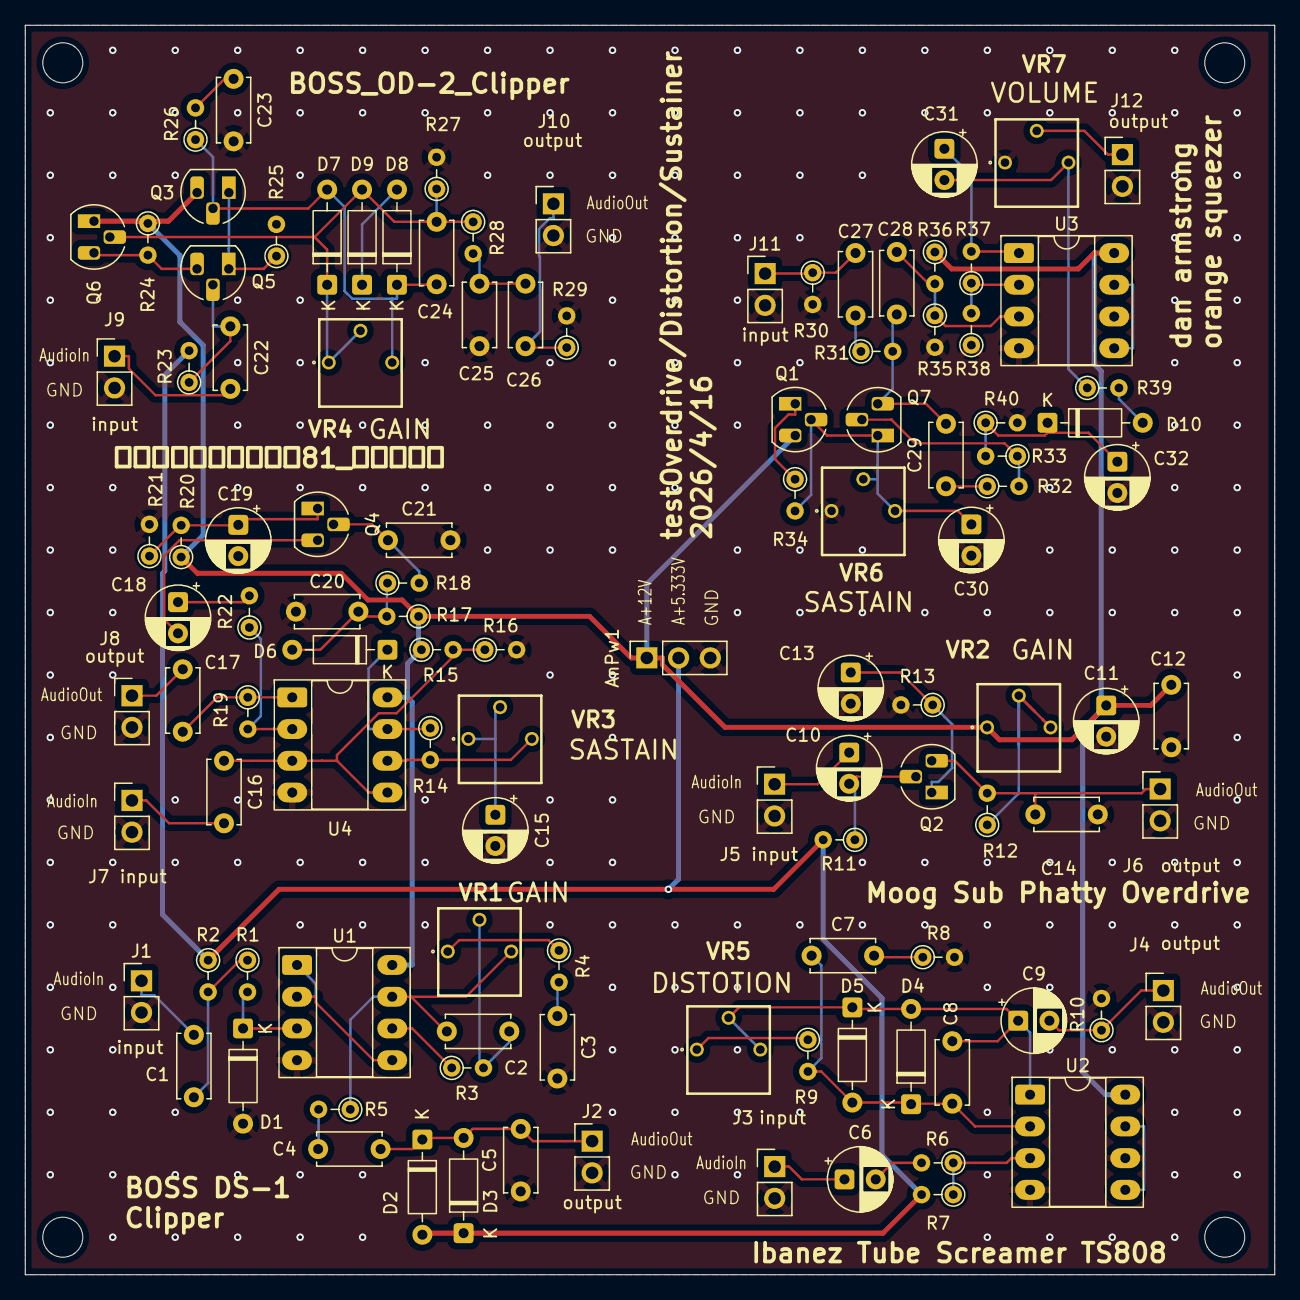
[picture p86: board testODDT.kicad_pcb from above]

Board: 2 copper layers, 100.0 x 100.0 mm, 113 parts (0 on the bottom side), 66 nets.
