wakimizufu/TBSEQ/TBSEQ_Board_V3/mainBorad/mainBorad.kicad_pcb

## KiCad design TBSEQ_Board_V3/mainBorad/mainBorad.kicad_pcb (2025-03-19, an earlier design)

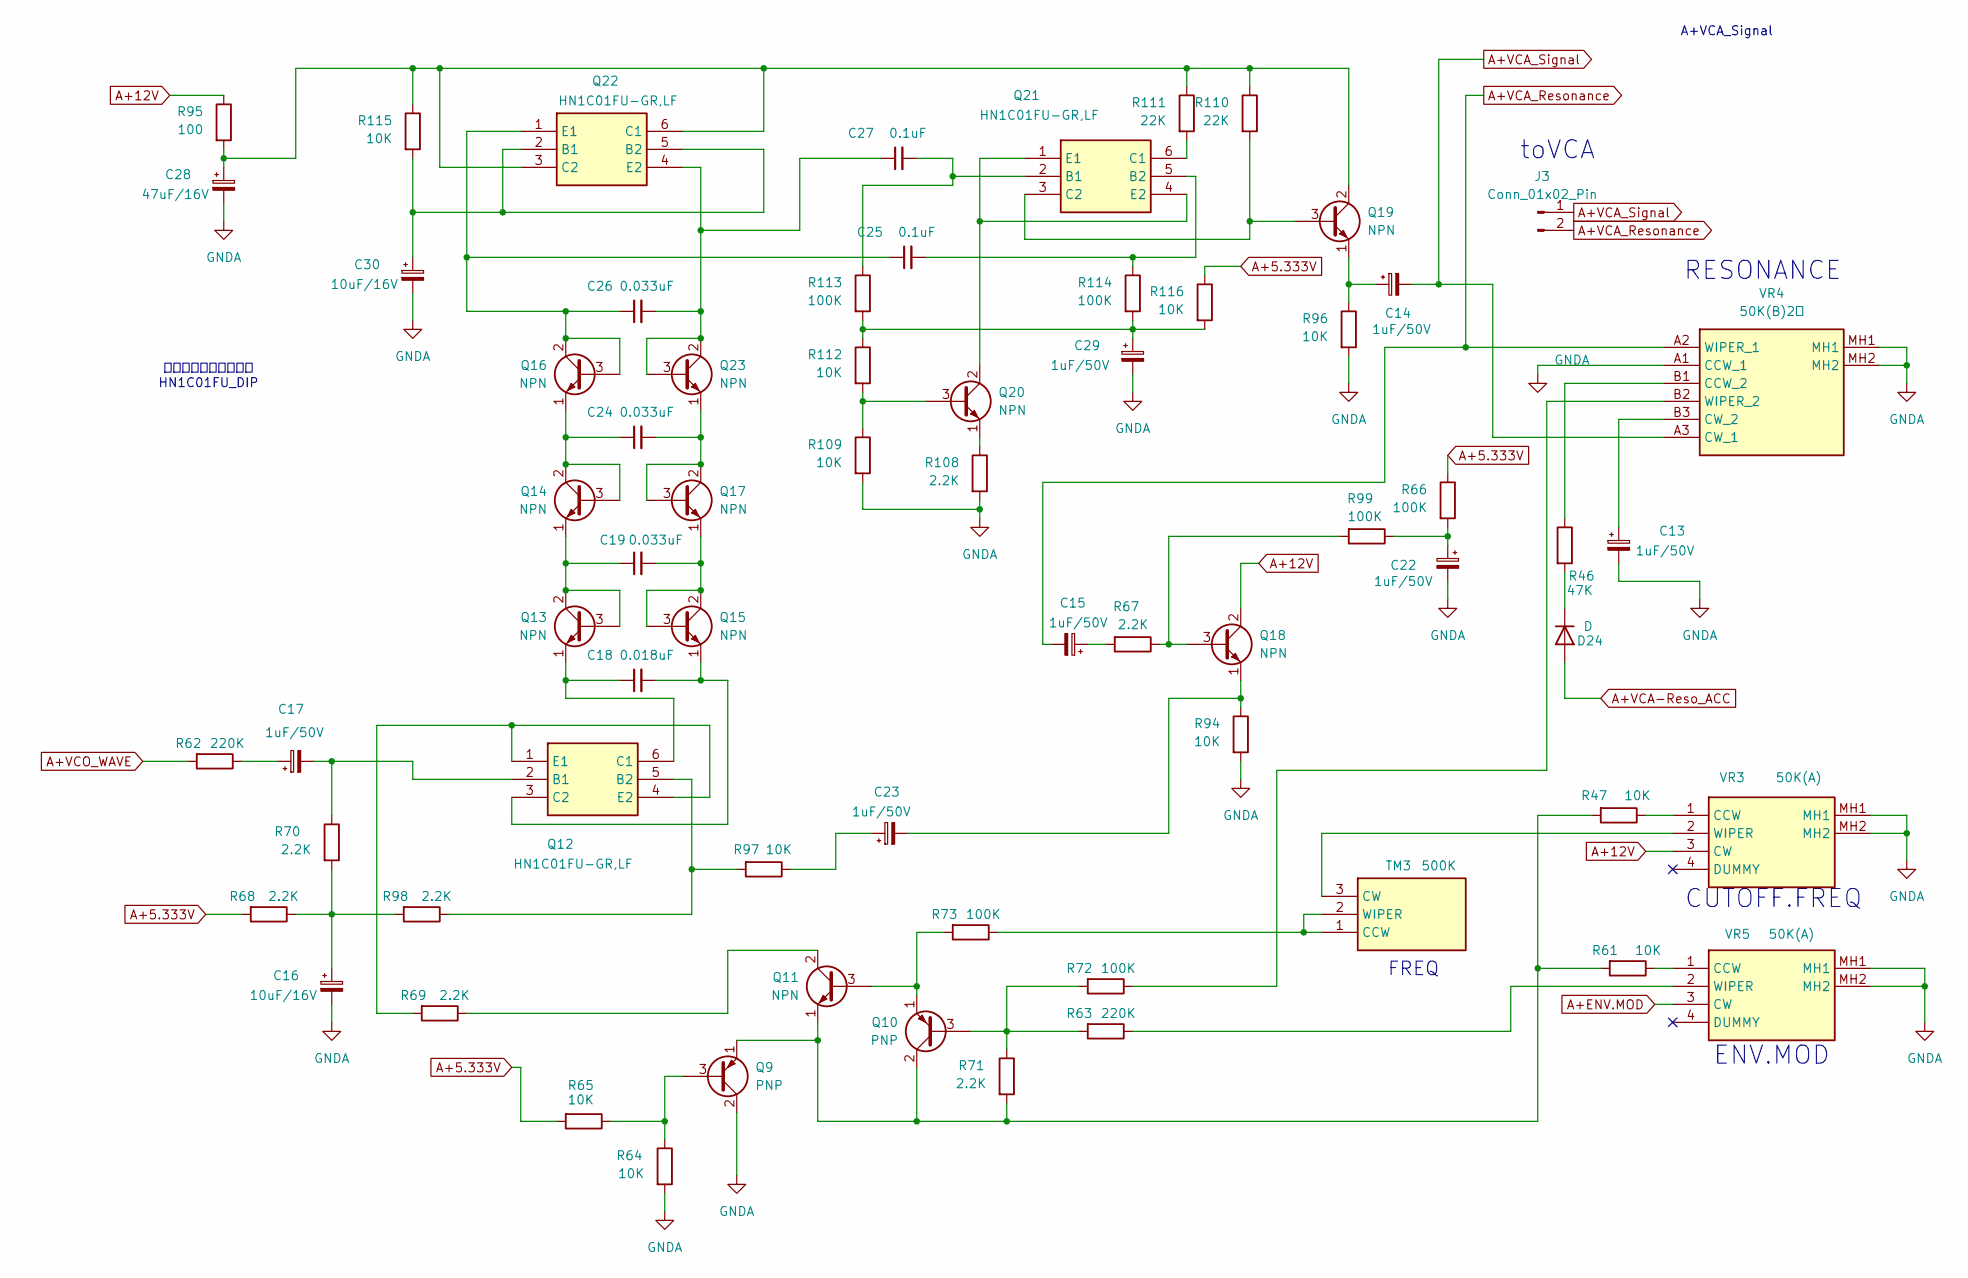
[picture p87: schematic VCF.kicad_sch]

Parts:
C13, C14, C15, C17, C22, C23, C29: 1uF/50V; CP_Radial_D4.0mm_P2.00mm
C16, C30: 10uF/16V; CP_Radial_D4.0mm_P2.00mm
C18: 0.018uF; C_Rect_L7.2mm_W2.5mm_P5.00mm_FKS2_FKP2_MKS2_MKP2
C19, C24, C26: 0.033uF; C_Rect_L7.2mm_W2.5mm_P5.00mm_FKS2_FKP2_MKS2_MKP2
C25, C27: 0.1uF; C_Rect_L7.2mm_W2.5mm_P5.00mm_FKS2_FKP2_MKS2_MKP2
C28: 47uF/16V; CP_Radial_D4.0mm_P2.00mm
D24: D; D_A-405_P2.54mm_Vertical_AnodeUp
J3: Conn_01x02_Pin; PinHeader_1x02_P2.54mm_Vertical
Q9, Q10: PNP; TO-92_HandSolder
Q11, Q13, Q14, Q15, Q16, Q17, Q18, Q19, Q20, Q23: NPN; TO-92_HandSolder
Q12, Q21, Q22: HN1C01FU-GR,LF; HN1C01FUGRLF_DIP8; Manufacturer_Part_Number HN4A06J(TE85L,F); Mouser Part Number 757-HN4A06JTE85LF
R46: 47K; R_Axial_DIN0207_L6.3mm_D2.5mm_P2.54mm_Vertical
R47, R61, R64, R65, R94, R96, R97, R109, R112, R115, R116: 10K; R_Axial_DIN0207_L6.3mm_D2.5mm_P2.54mm_Vertical
R62, R63: 220K; R_Axial_DIN0207_L6.3mm_D2.5mm_P2.54mm_Vertical
R66, R72, R73, R99, R113, R114: 100K; R_Axial_DIN0207_L6.3mm_D2.5mm_P2.54mm_Vertical
R67, R68, R69, R70, R71, R98, R108: 2.2K; R_Axial_DIN0207_L6.3mm_D2.5mm_P2.54mm_Vertical
R95: 100; R_Axial_DIN0207_L6.3mm_D2.5mm_P2.54mm_Vertical
R110, R111: 22K; R_Axial_DIN0207_L6.3mm_D2.5mm_P2.54mm_Vertical
TM3: 500K; 3296W1502A; Manufacturer_Part_Number 3296W-1-502A; Mouser Part Number 652-3296W-1-502A
VR3, VR5: 50K(A); PTV1113420AA103; Manufacturer_Part_Number PTV111-3420A-A103; Mouser Part Number 652-PTV1113420AA103
VR4: 50K(B)2連; PTV1124420AA504; Manufacturer_Part_Number PTV112-4420A-A504; Mouser Part Number 652-PTV1124420AA504

Connections:
A+5.333V: R65.2, R66.1, R68.2, R116.1; also elsewhere on the board
A+12V: Q18.2 (C), R95.1, VR3.3 (CW); also elsewhere on the board
A+ENV.MOD: VR5.3 (CW); also elsewhere on the board
A+VCA-Reso_ACC: D24.2 (A); also elsewhere on the board
A+VCA_Resonance: C15.2, J3.2, VR4.A2 (WIPER_1); also elsewhere on the board
A+VCA_Signal: C14.2, J3.1, VR4.A3 (CW_1); also elsewhere on the board
A+VCO_WAVE: R62.2; also elsewhere on the board
unnamed: C15.1, R67.2
unnamed: C16.1, R68.1, R70.2, R98.2
unnamed: C17.1, R62.1
unnamed: C22.1, R66.2, R99.1
unnamed: C23.1, R97.1
unnamed: C29.1, R112.1, R113.2, R114.2, R116.2
unnamed: D24.1 (K), R46.2
unnamed: Q9.3 (B), R64.1, R65.1
unnamed: Q10.3 (B), R63.2, R71.1, R72.2
unnamed: Q9.1 (E), Q10.2 (C), Q11.1 (E), R47.2, R61.2, R71.2
unnamed: Q10.1 (E), Q11.3 (B), R73.2
unnamed: Q11.2 (C), R69.1
unnamed: C17.2, Q12.2 (B1), R70.1
unnamed: Q12.5 (B2), R97.2, R98.1
unnamed: C18.1, Q12.6 (C1), Q13.1 (E)
unnamed: C18.2, Q12.3 (C2), Q15.1 (E)
unnamed: Q12.1 (E1), Q12.4 (E2), R69.2
unnamed: C19.1, Q13.2 (C), Q13.3 (B), Q14.1 (E)
unnamed: C24.1, Q14.2 (C), Q14.3 (B), Q16.1 (E)
unnamed: C19.2, Q15.2 (C), Q15.3 (B), Q17.1 (E)
unnamed: C25.1, C26.1, Q16.2 (C), Q16.3 (B), Q22.1 (E1)
unnamed: C24.2, Q17.2 (C), Q17.3 (B), Q23.1 (E)
unnamed: Q18.3 (B), R67.1, R99.2
unnamed: C23.2, Q18.1 (E), R94.1
unnamed: Q19.3 (B), Q21.3 (C2), R110.2
unnamed: C28.1, Q19.2 (C), Q22.3 (C2), Q22.6 (C1), R95.2, R110.1, R111.1, R115.1
unnamed: C14.1, Q19.1 (E), R96.1
unnamed: Q20.3 (B), R109.1, R112.2
unnamed: Q20.2 (C), Q21.1 (E1), Q21.4 (E2)
unnamed: Q20.1 (E), R108.1
unnamed: C27.2, Q21.2 (B1), R113.1
unnamed: C25.2, Q21.5 (B2), R114.1
unnamed: Q21.6 (C1), R111.2
unnamed: C30.1, Q22.2 (B1), Q22.5 (B2), R115.2
unnamed: C26.2, C27.1, Q22.4 (E2), Q23.2 (C), Q23.3 (B)
unnamed: R73.1, TM3.1 (CCW), TM3.2 (WIPER)
unnamed: TM3.3 (CW), VR3.2 (WIPER)
unnamed: R47.1, VR3.1 (CCW)
unnamed: R46.1, VR4.B1 (CCW_2)
unnamed: C13.1, VR4.B3 (CW_2)
unnamed: R72.1, VR4.B2 (WIPER_2)
unnamed: R61.1, VR5.1 (CCW)
unnamed: R63.1, VR5.2 (WIPER)

Notes on the sheet:
A+VCA_Signal
最終的にはこれに統一 HN1C01FU_DIP
RESONANCE
toVCA
CUTOFF.FREQ
FREQ
ENV.MOD

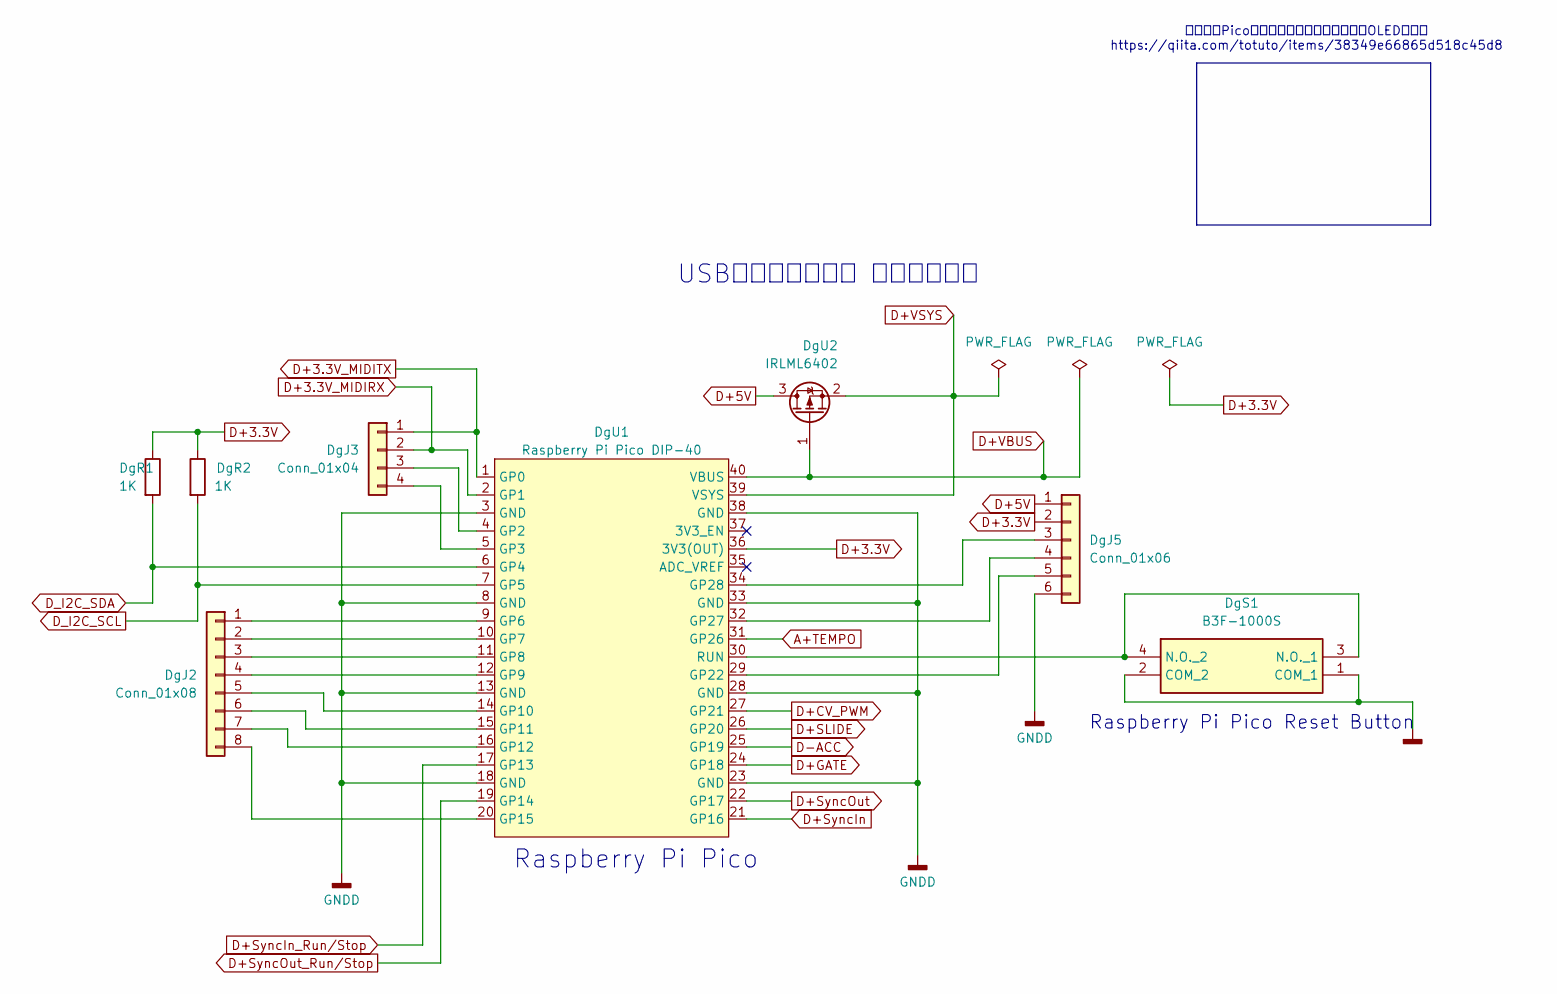
[picture p88: schematic RasPico.kicad_sch]

Parts:
DgJ2: Conn_01x08; PinHeader_1x08_P2.54mm_Vertical
DgJ3: Conn_01x04; PinHeader_1x04_P2.54mm_Vertical
DgJ5: Conn_01x06; PinHeader_1x06_P2.54mm_Vertical
DgR1, DgR2: 1K; R_0805_2012Metric_Pad1.20x1.40mm_HandSolder
DgS1: B3F-1000S; B3F1060; Manufacturer_Part_Number B3F-1000S; Mouser Part Number 653-B3F-1000-S
DgU1: Raspberry Pi Pico DIP-40; Raspberry Pi Pico DIP-40_W17.76mm
DgU2: IRLML6402; SOT-23W_Handsoldering

Connections:
A+TEMPO: DgU1.31 (GP26); also elsewhere on the board
D+3.3V: DgJ5.2, DgR1.1, DgR2.1, DgU1.36 (3V3(OUT)); also elsewhere on the board
D+3.3V_MIDIRX: DgJ3.2, DgU1.2 (GP1); also elsewhere on the board
D+3.3V_MIDITX: DgJ3.1, DgU1.1 (GP0); also elsewhere on the board
D+5V: DgJ5.1, DgU2.3 (D); also elsewhere on the board
D+CV_PWM: DgU1.27 (GP21); also elsewhere on the board
D+GATE: DgU1.24 (GP18); also elsewhere on the board
D+SLIDE: DgU1.26 (GP20); also elsewhere on the board
D+SyncIn: DgU1.21 (GP16); also elsewhere on the board
D+SyncIn_Run/Stop: DgU1.17 (GP13); also elsewhere on the board
D+SyncOut: DgU1.22 (GP17); also elsewhere on the board
D+SyncOut_Run/Stop: DgU1.19 (GP14); also elsewhere on the board
D+VBUS: DgU1.40 (VBUS), DgU2.1 (G)
D+VSYS: DgU1.39 (VSYS), DgU2.2 (S)
D-ACC: DgU1.25 (GP19); also elsewhere on the board
D_I2C_SCL: DgR2.2, DgU1.7 (GP5); also elsewhere on the board
D_I2C_SDA: DgR1.2, DgU1.6 (GP4); also elsewhere on the board
GNDD: DgJ5.6, DgS1.1 (COM_1), DgS1.2 (COM_2), DgU1.3 (GND), DgU1.8 (GND), DgU1.13 (GND), DgU1.18 (GND), DgU1.23 (GND), DgU1.28 (GND), DgU1.33 (GND), DgU1.38 (GND); also elsewhere on the board
unnamed: DgJ2.1, DgU1.9 (GP6)
unnamed: DgJ2.2, DgU1.10 (GP7)
unnamed: DgJ2.3, DgU1.11 (GP8)
unnamed: DgJ2.4, DgU1.12 (GP9)
unnamed: DgJ2.5, DgU1.14 (GP10)
unnamed: DgJ2.6, DgU1.15 (GP11)
unnamed: DgJ2.7, DgU1.16 (GP12)
unnamed: DgJ2.8, DgU1.20 (GP15)
unnamed: DgJ3.3, DgU1.4 (GP2)
unnamed: DgJ3.4, DgU1.5 (GP3)
unnamed: DgJ5.3, DgU1.34 (GP28)
unnamed: DgJ5.4, DgU1.32 (GP27)
unnamed: DgJ5.5, DgU1.29 (GP22)
unnamed: DgS1.3 (N.O._1), DgS1.4 (N.O._2), DgU1.30 (RUN)

Notes on the sheet:
ラズパイPico：電池で動作、電池の電圧をOLEDに表示 https://qiita.com/totuto/items/38349e66865d518c45d8
USBコネクタ接続時 電流逆流防止
Raspberry Pi Pico Reset Button
Raspberry Pi Pico

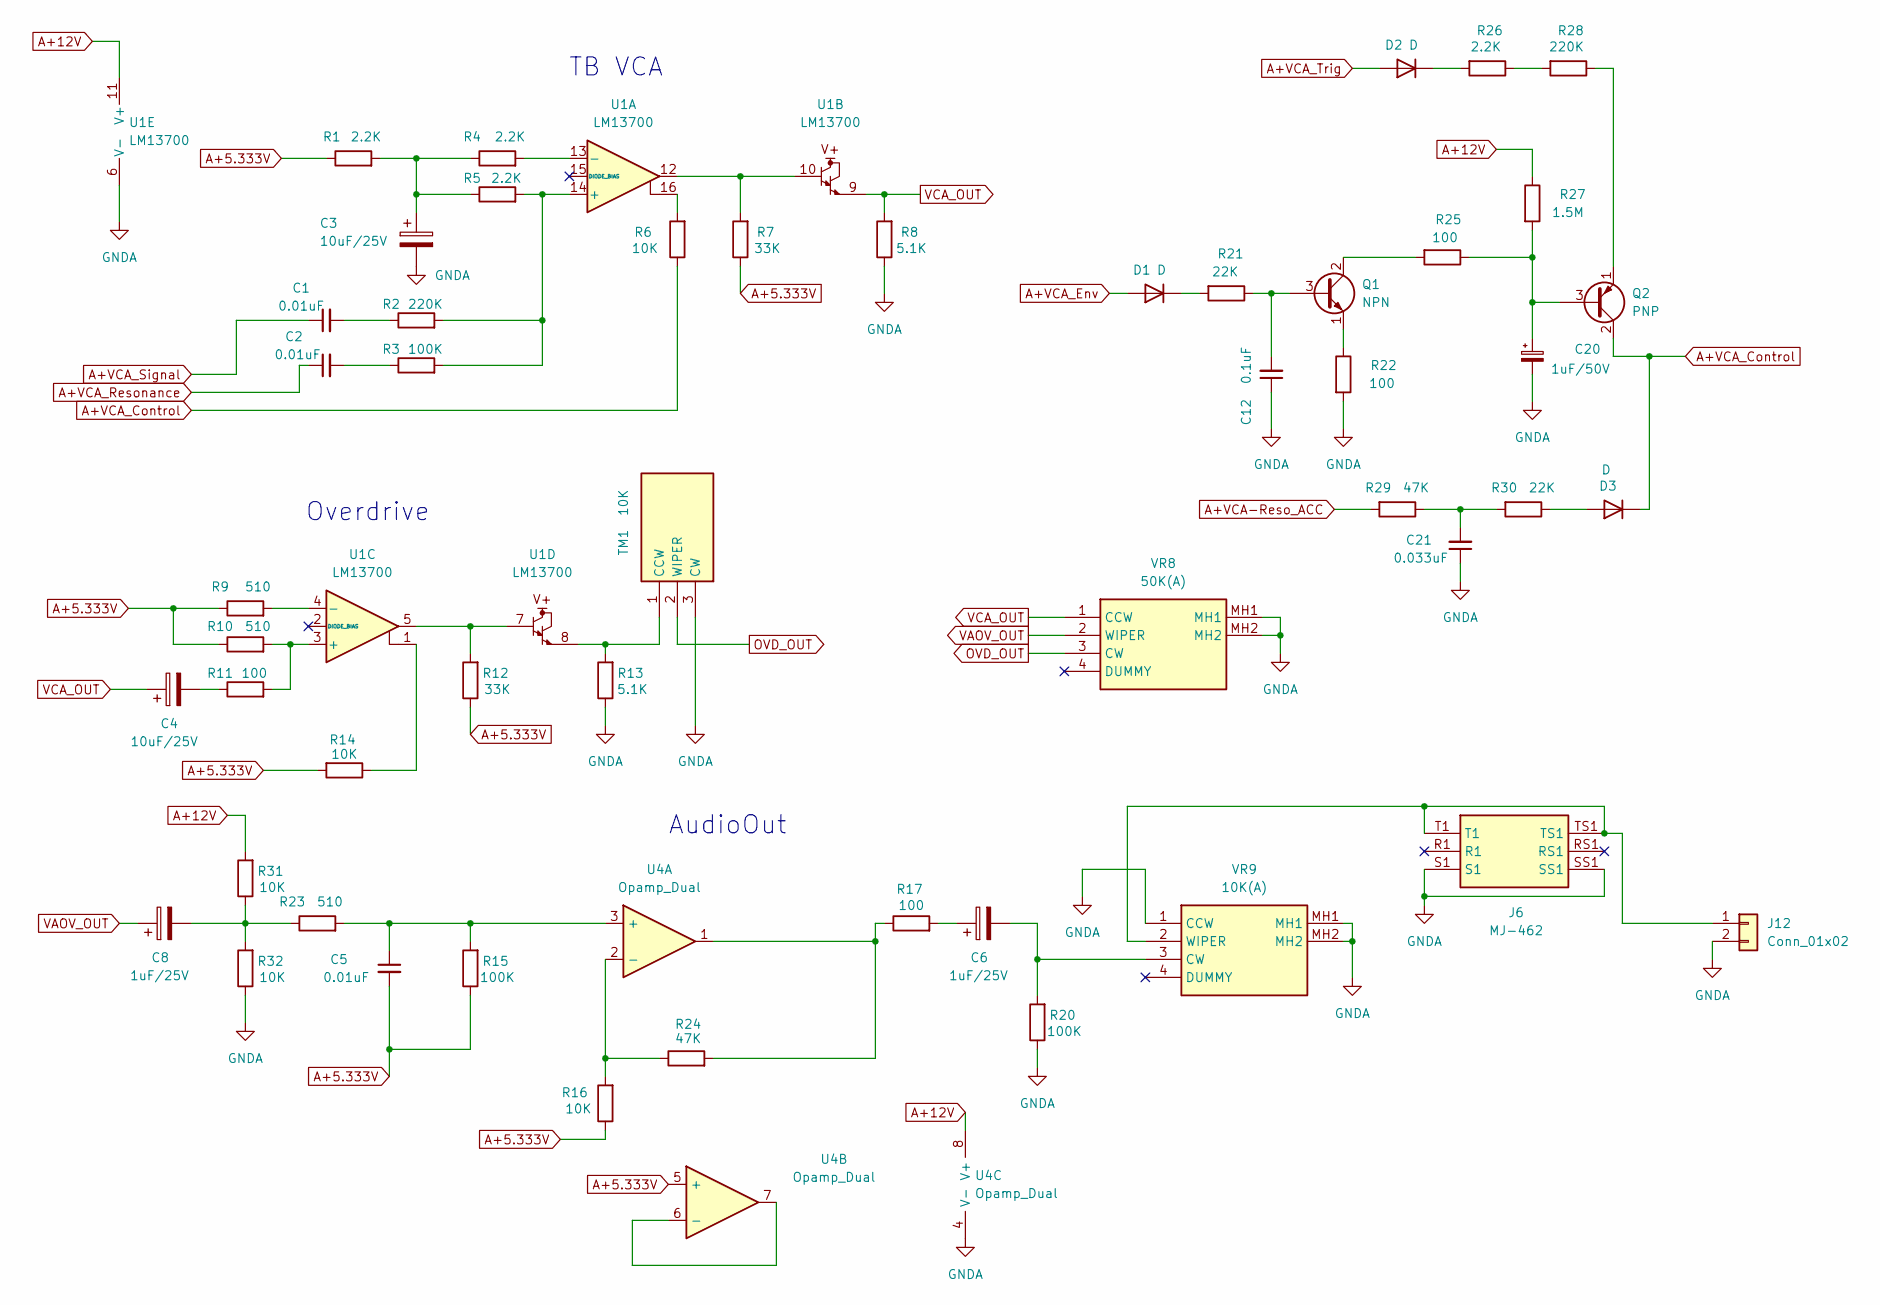
[picture p89: schematic LM13700_Overdrive.kicad_sch]

Parts:
C1, C2: 0.01uF; C_Rect_L7.0mm_W2.0mm_P5.00mm
C3, C4: 10uF/25V; CP_Radial_D5.0mm_P2.50mm
C5: 0.01uF; C_Rect_L7.2mm_W2.5mm_P5.00mm_FKS2_FKP2_MKS2_MKP2
C6, C8: 1uF/25V; CP_Radial_D5.0mm_P2.50mm
C12: 0.1uF; C_Rect_L7.2mm_W2.5mm_P5.00mm_FKS2_FKP2_MKS2_MKP2
C20: 1uF/50V; CP_Radial_D5.0mm_P2.00mm
C21: 0.033uF; C_Rect_L7.2mm_W2.5mm_P5.00mm_FKS2_FKP2_MKS2_MKP2
D1, D2, D3: D; D_A-405_P2.54mm_Vertical_AnodeUp
J6: MJ-462; MJ462; Manufacturer_Part_Number MJ-462
J12: Conn_01x02; PinHeader_1x02_P2.54mm_Vertical
Q1: NPN; TO-92_HandSolder
Q2: PNP; TO-92_HandSolder
R1, R4, R5, R26: 2.2K; R_Axial_DIN0207_L6.3mm_D2.5mm_P2.54mm_Vertical
R2, R28: 220K; R_Axial_DIN0207_L6.3mm_D2.5mm_P2.54mm_Vertical
R3, R15, R20: 100K; R_Axial_DIN0207_L6.3mm_D2.5mm_P2.54mm_Vertical
R6, R14, R16, R31, R32: 10K; R_Axial_DIN0207_L6.3mm_D2.5mm_P2.54mm_Vertical
R7, R12: 33K; R_Axial_DIN0207_L6.3mm_D2.5mm_P2.54mm_Vertical
R8, R13: 5.1K; R_Axial_DIN0207_L6.3mm_D2.5mm_P2.54mm_Vertical
R9, R10, R23: 510; R_Axial_DIN0207_L6.3mm_D2.5mm_P2.54mm_Vertical
R11, R17, R22, R25: 100; R_Axial_DIN0207_L6.3mm_D2.5mm_P2.54mm_Vertical
R21, R30: 22K; R_Axial_DIN0207_L6.3mm_D2.5mm_P2.54mm_Vertical
R24, R29: 47K; R_Axial_DIN0207_L6.3mm_D2.5mm_P2.54mm_Vertical
R27: 1.5M; R_Axial_DIN0207_L6.3mm_D2.5mm_P2.54mm_Vertical
TM1: 10K; 3296W1502A; Manufacturer_Part_Number 3296W-1-502A; Mouser Part Number 652-3296W-1-502A
U1: LM13700; DIP-16_W7.62mm_Socket_LongPads
U4: Opamp_Dual; DIP-8_W7.62mm_LongPads
VR8: 50K(A); PTV1113420AA103; Manufacturer_Part_Number PTV111-3420A-A103; Mouser Part Number 652-PTV1113420AA103
VR9: 10K(A); PTV1113420AA103; Manufacturer_Part_Number PTV111-3420A-A103; Mouser Part Number 652-PTV1113420AA103

Connections:
A+5.333V: C5.2, R1.1, R7.1, R9.1, R10.1, R12.1, R14.2, R15.1, R16.1, U4.5 (+); also elsewhere on the board
A+12V: R27.1, R31.2, U1.11 (V+), U4.8 (V+); also elsewhere on the board
A+VCA-Reso_ACC: R29.2; also elsewhere on the board
A+VCA_Env: D1.2 (A); also elsewhere on the board
A+VCA_Resonance: C2.1; also elsewhere on the board
A+VCA_Signal: C1.1; also elsewhere on the board
A+VCA_Trig: D2.2 (A); also elsewhere on the board
unnamed: C1.2, R2.1
unnamed: C2.2, R3.1
unnamed: C3.1, R1.2, R4.1, R5.1
unnamed: C4.2, R11.1
unnamed: C6.1, R17.2
unnamed: C21.2, R29.1, R30.2
unnamed: D1.1 (K), R21.2
unnamed: D2.1 (K), R26.2
unnamed: D3.2 (A), R30.1
unnamed: J6.T1, J6.TS1, J12.1, VR9.2 (WIPER)
unnamed: C12.2, Q1.3 (B), R21.1
unnamed: Q1.2 (C), R25.2
unnamed: Q1.1 (E), R22.1
unnamed: C20.1, Q2.3 (B), R25.1, R27.2
unnamed: Q2.1 (E), R28.1
unnamed: R6.2, U1.16
unnamed: R7.2, U1.10, U1.12
unnamed: R12.2, U1.5, U1.7
unnamed: R14.1, U1.1
unnamed: R17.1, R24.2, U4.1
unnamed: R26.1, R28.2
unnamed: R13.2, TM1.1 (CCW), U1.8
unnamed: R2.2, R3.2, R5.2, U1.14 (+)
unnamed: R4.2, U1.13 (-)
unnamed: R10.2, R11.2, U1.3 (+)
unnamed: R9.2, U1.4 (-)
unnamed: C5.1, R15.2, R23.2, U4.3 (+)
unnamed: R16.2, R24.1, U4.2 (-)
unnamed: U4.6 (-), U4.7

Notes on the sheet:
AudioOut
Overdrive
TB VCA

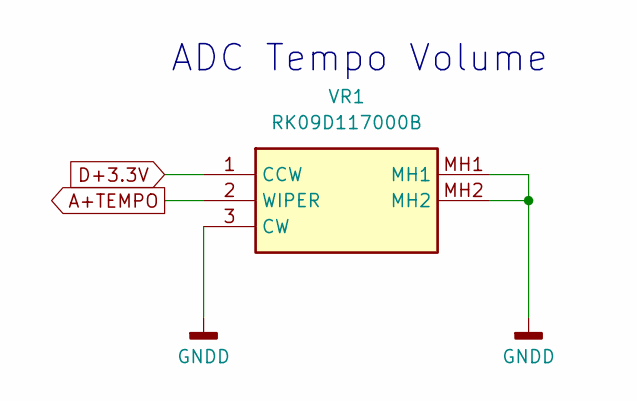
[picture p90: schematic TEMPO.kicad_sch]

Parts:
VR1: RK09D117000B; Manufacturer_Part_Number RK09D117000B; Mouser Part Number 688-RK09D117000B

Connections:
A+TEMPO: VR1.2 (WIPER); also elsewhere on the board
D+3.3V: VR1.1 (CCW); also elsewhere on the board
GNDD: VR1.3 (CW), VR1.MH1, VR1.MH2; also elsewhere on the board

Notes on the sheet:
ADC Tempo Volume

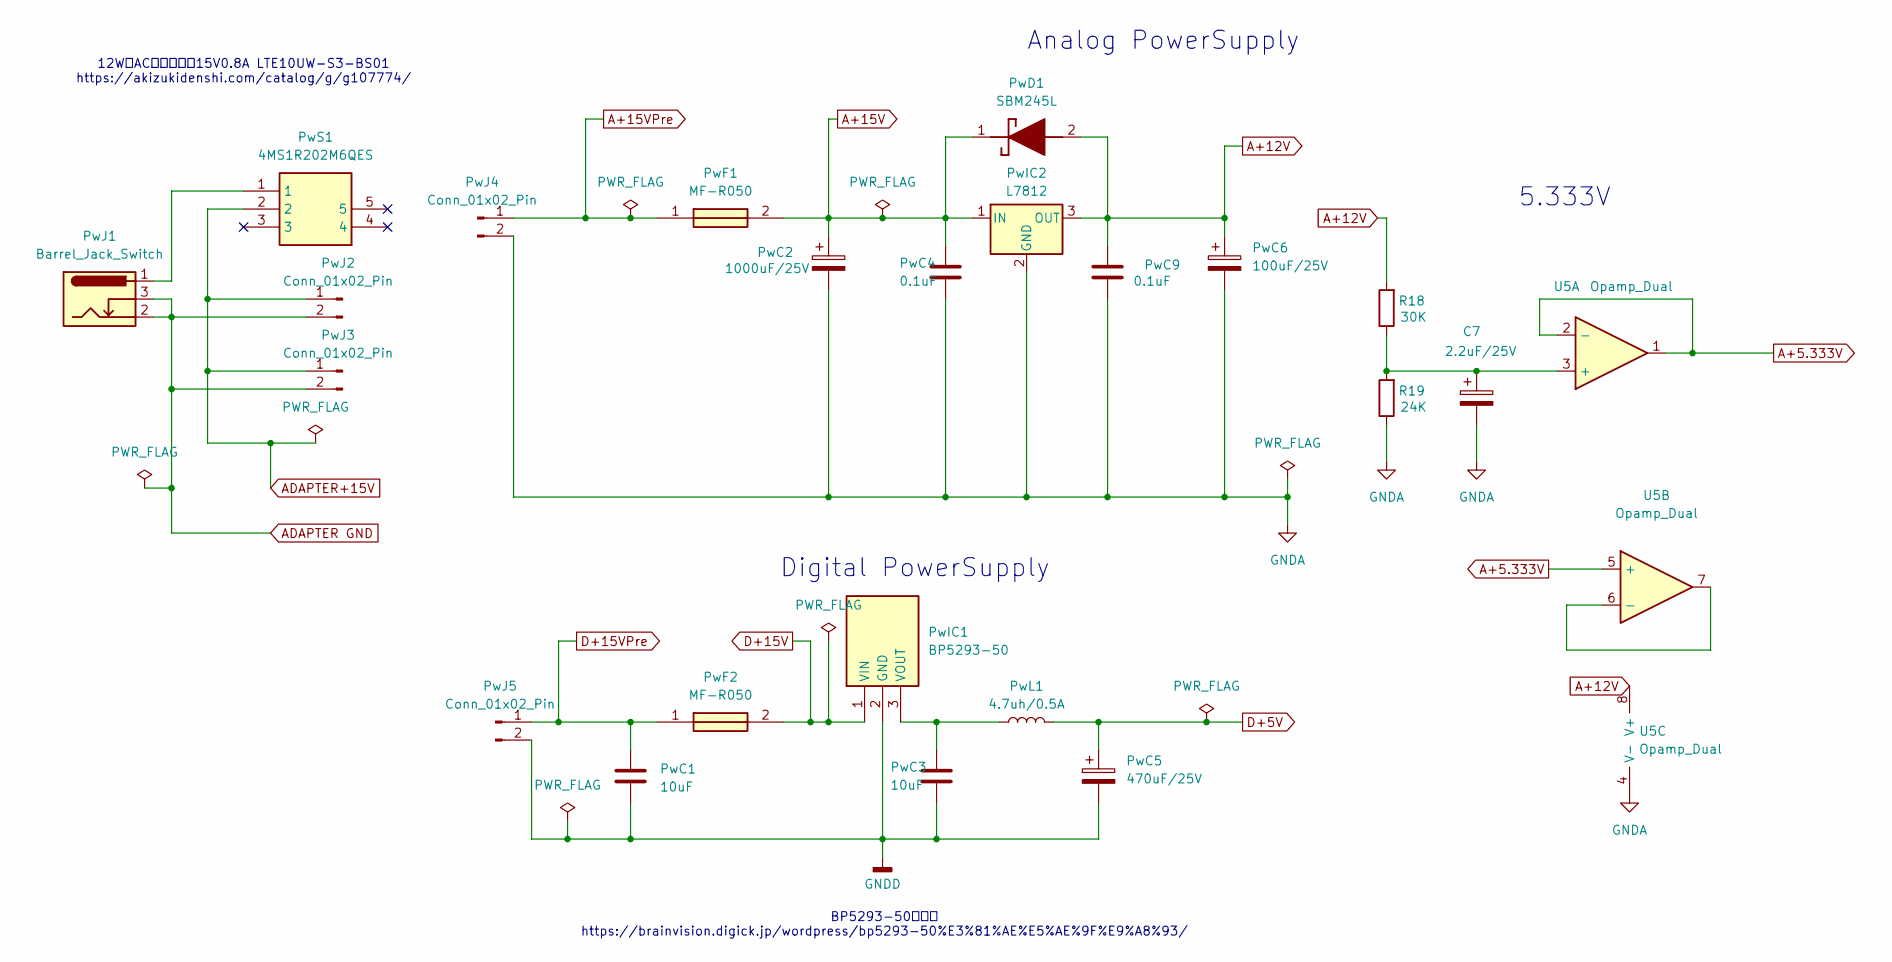
[picture p91: schematic PowerSupply.kicad_sch]

Parts:
C7: 2.2uF/25V; CP_Radial_D5.0mm_P2.50mm
PwC1, PwC3: 10uF; C_Disc_D5.1mm_W3.2mm_P5.00mm
PwC2: 1000uF/25V; CP_Radial_D10.0mm_P5.00mm
PwC4, PwC9: 0.1uF; C_Disc_D5.1mm_W3.2mm_P5.00mm
PwC5: 470uF/25V; CP_Radial_D5.0mm_P2.50mm
PwC6: 100uF/25V; CP_Radial_D5.0mm_P2.50mm
PwD1: SBM245L; D_DO-41_SOD81_P5.08mm_Vertical_AnodeUp; Manufacturer_Part_Number SBM245L
PwF1, PwF2: MF-R050; MFR050; Manufacturer_Part_Number MF-R050; Mouser Part Number 652-MFR050
PwIC1: BP5293-50; TO254P570X1700X1780-3P; Manufacturer_Part_Number BP5293-50; Mouser Part Number 755-BP5293-50
PwIC2: L7812; TO-220-3_Horizontal_TabDown
PwJ1: Barrel_Jack_Switch; BarrelJack_Horizontal
PwJ2, PwJ3, PwJ4, PwJ5: Conn_01x02_Pin; PinHeader_1x02_P2.54mm_Vertical
PwL1: 4.7uh/0.5A; R_Axial_DIN0207_L6.3mm_D2.5mm_P7.62mm_Horizontal
PwS1: 4MS1R202M6QES; Manufacturer_Part_Number 4MS1R202M6QES
R18: 30K; R_Axial_DIN0207_L6.3mm_D2.5mm_P2.54mm_Vertical
R19: 24K; R_Axial_DIN0207_L6.3mm_D2.5mm_P2.54mm_Vertical
U5: Opamp_Dual; DIP-8_W7.62mm_LongPads

Connections:
A+5.333V: U5.1, U5.2 (-), U5.5 (+); also elsewhere on the board
A+12V: PwC6.1, PwC9.1, PwD1.2 (A), PwIC2.3 (OUT), R18.2, U5.8 (V+); also elsewhere on the board
A+15V: PwC2.1, PwC4.1, PwD1.1 (K), PwF1.2, PwIC2.1 (IN)
A+15VPre: PwF1.1, PwJ4.1
ADAPTER GND: PwJ1.2, PwJ1.3, PwJ2.2, PwJ3.2
ADAPTER+15V: PwJ2.1, PwJ3.1, PwS1.2
D+5V: PwC5.1, PwL1.2; also elsewhere on the board
D+15V: PwF2.2, PwIC1.1 (VIN)
D+15VPre: PwC1.1, PwF2.1, PwJ5.1
GNDD: PwC1.2, PwC3.2, PwC5.2, PwIC1.2 (GND), PwJ5.2; also elsewhere on the board
unnamed: PwC3.1, PwIC1.3 (VOUT), PwL1.1
unnamed: PwJ1.1, PwS1.1
unnamed: C7.1, R18.1, R19.2, U5.3 (+)
unnamed: U5.6 (-), U5.7

Notes on the sheet:
12W級ACアダプター15V0.8A LTE10UW-S3-BS01 https://akizukidenshi.com/catalog/g/g107774/
Analog PowerSupply
5.333V
BP5293-50の実験 https://brainvision.digick.jp/wordpress/bp5293-50%E3%81%AE%E5%AE%9F%E9%A8%93/
Digital PowerSupply

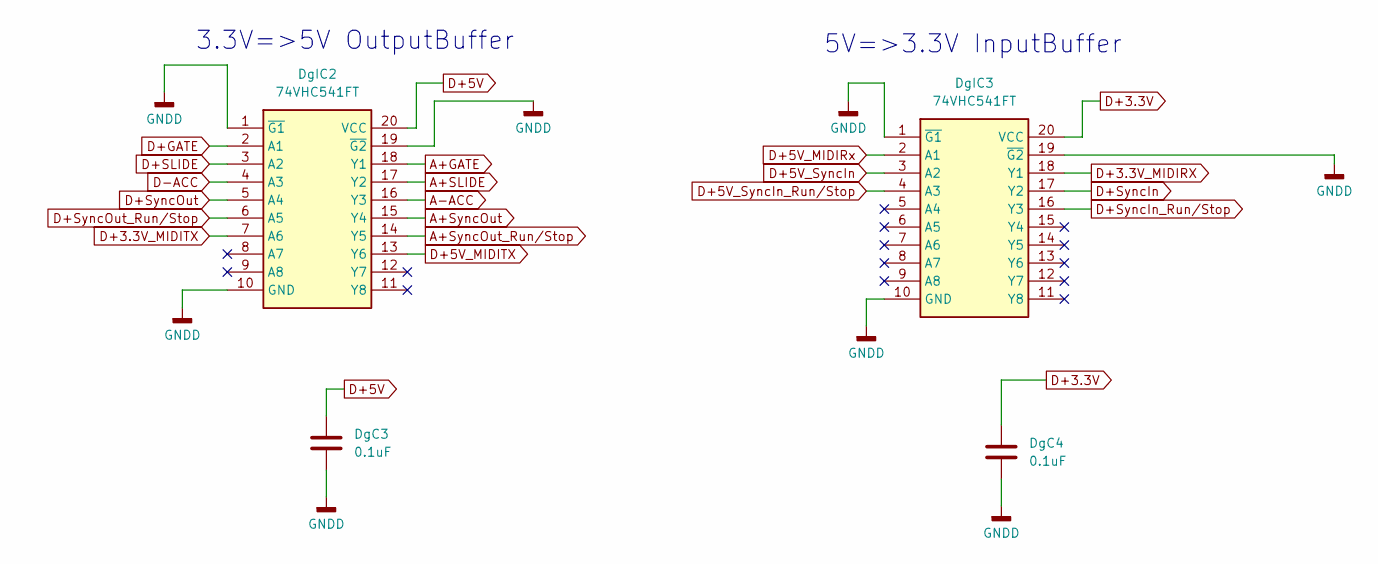
[picture p92: schematic LevelConvert.kicad_sch]

Parts:
DgC3, DgC4: 0.1uF; C_0805_2012Metric_Pad1.18x1.45mm_HandSolder
DgIC2, DgIC3: 74VHC541FT; SOP65P640X120-20N; Manufacturer_Part_Number 74VHC541FT; Mouser Part Number N/A

Connections:
A+GATE: DgIC2.18 (Y1); also elsewhere on the board
A+SLIDE: DgIC2.17 (Y2); also elsewhere on the board
A+SyncOut: DgIC2.15 (Y4); also elsewhere on the board
A+SyncOut_Run/Stop: DgIC2.14 (Y5); also elsewhere on the board
A-ACC: DgIC2.16 (Y3); also elsewhere on the board
D+3.3V: DgC4.1, DgIC3.20 (VCC); also elsewhere on the board
D+3.3V_MIDIRX: DgIC3.18 (Y1); also elsewhere on the board
D+3.3V_MIDITX: DgIC2.7 (A6); also elsewhere on the board
D+5V: DgC3.1, DgIC2.20 (VCC); also elsewhere on the board
D+5V_MIDIRx: DgIC3.2 (A1); also elsewhere on the board
D+5V_MIDITX: DgIC2.13 (Y6); also elsewhere on the board
D+5V_SyncIn: DgIC3.3 (A2); also elsewhere on the board
D+5V_SyncIn_Run/Stop: DgIC3.4 (A3); also elsewhere on the board
D+GATE: DgIC2.2 (A1); also elsewhere on the board
D+SLIDE: DgIC2.3 (A2); also elsewhere on the board
D+SyncIn: DgIC3.17 (Y2); also elsewhere on the board
D+SyncIn_Run/Stop: DgIC3.16 (Y3); also elsewhere on the board
D+SyncOut: DgIC2.5 (A4); also elsewhere on the board
D+SyncOut_Run/Stop: DgIC2.6 (A5); also elsewhere on the board
D-ACC: DgIC2.4 (A3); also elsewhere on the board
GNDD: DgC3.2, DgC4.2, DgIC2.1 (~G1), DgIC2.10 (GND), DgIC2.19 (~G2), DgIC3.1 (~G1), DgIC3.10 (GND), DgIC3.19 (~G2); also elsewhere on the board
unnamed 75: DgIC2.8 (A7); also elsewhere on the board
unnamed 76: DgIC2.9 (A8); also elsewhere on the board
unnamed 77: DgIC2.12 (Y7); also elsewhere on the board
unnamed 78: DgIC2.11 (Y8); also elsewhere on the board
unnamed 79: DgIC3.5 (A4); also elsewhere on the board
unnamed 80: DgIC3.6 (A5); also elsewhere on the board
unnamed 81: DgIC3.7 (A6); also elsewhere on the board
unnamed 82: DgIC3.8 (A7); also elsewhere on the board
unnamed 83: DgIC3.9 (A8); also elsewhere on the board
unnamed 84: DgIC3.15 (Y4); also elsewhere on the board
unnamed 85: DgIC3.14 (Y5); also elsewhere on the board
unnamed 86: DgIC3.13 (Y6); also elsewhere on the board
unnamed 87: DgIC3.12 (Y7); also elsewhere on the board
unnamed 88: DgIC3.11 (Y8); also elsewhere on the board

Notes on the sheet:
3.3V=>5V OutputBuffer
5V=>3.3V InputBuffer

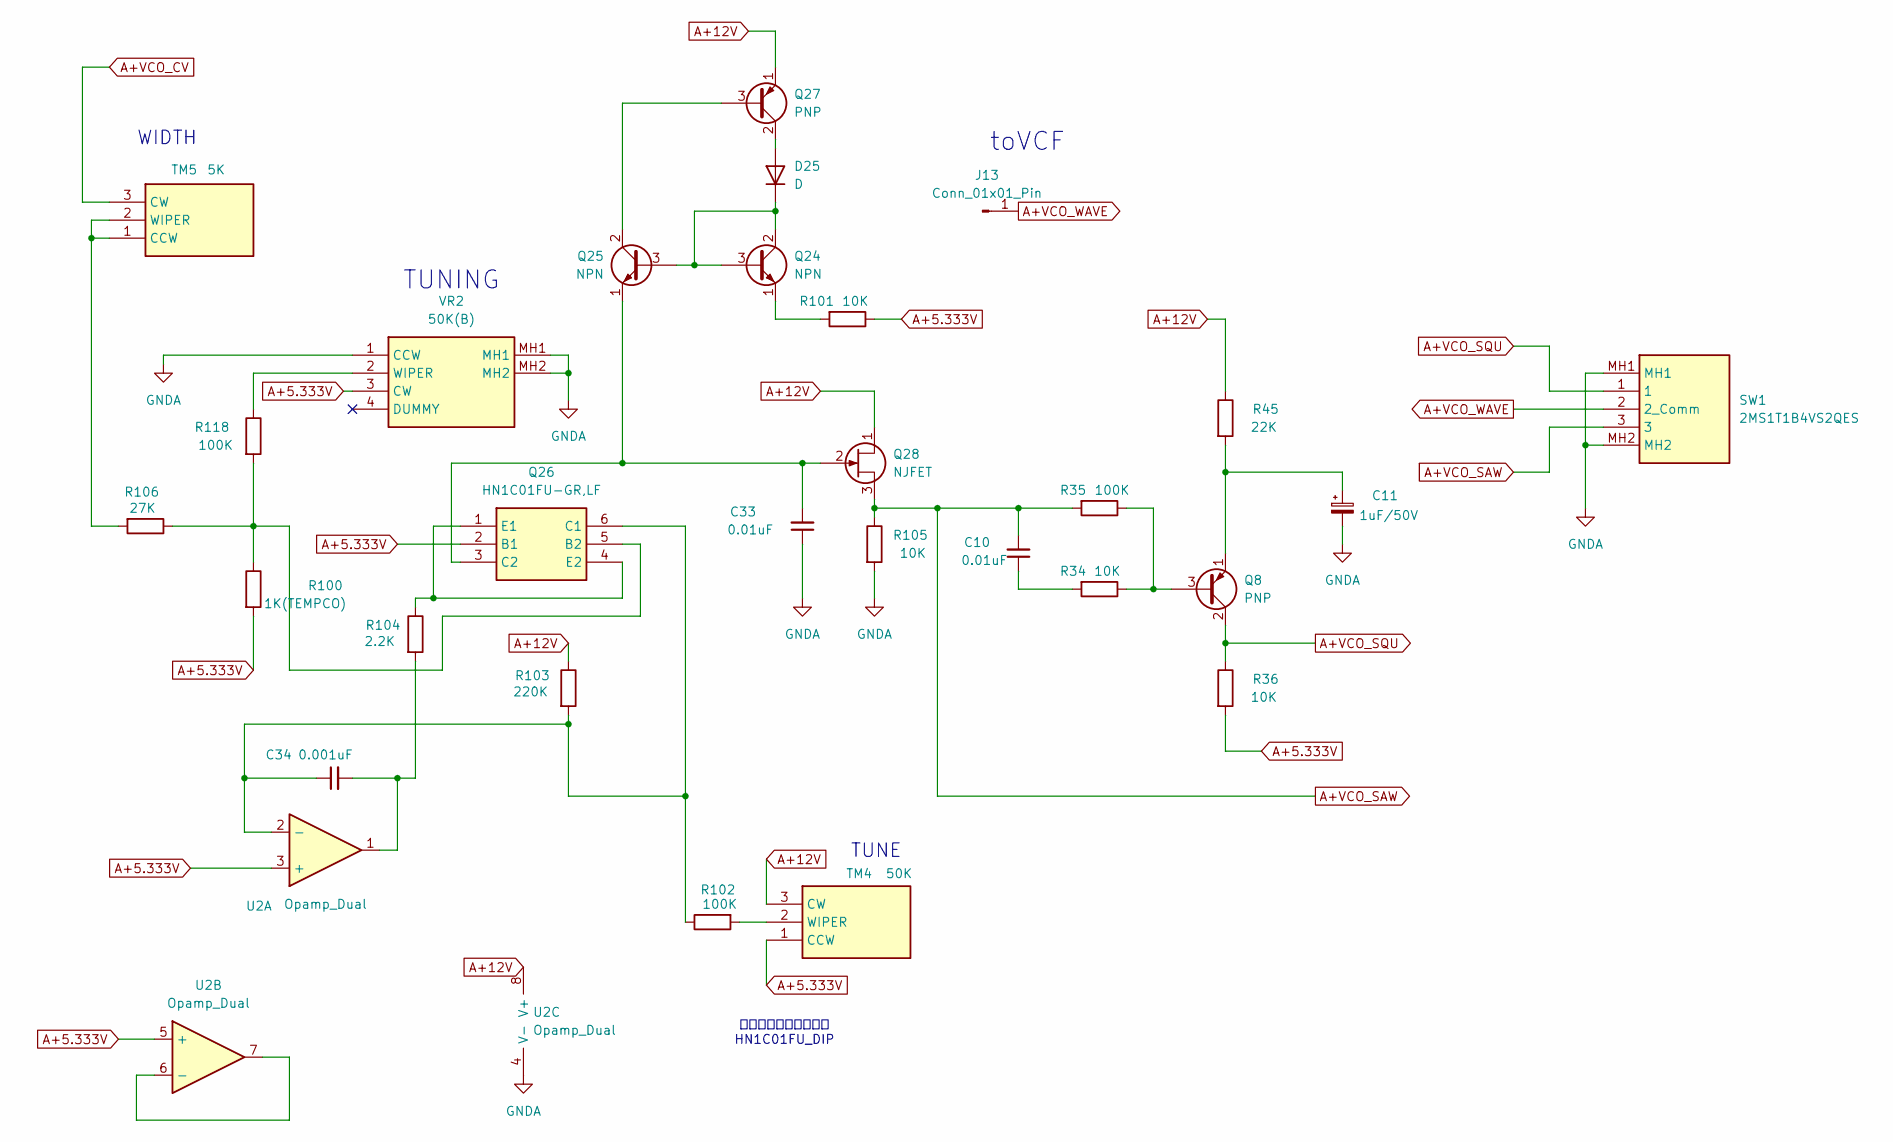
[picture p93: schematic VCO.kicad_sch]

Parts:
C10, C33: 0.01uF; C_Rect_L7.2mm_W2.5mm_P5.00mm_FKS2_FKP2_MKS2_MKP2
C11: 1uF/50V; CP_Radial_D4.0mm_P2.00mm
C34: 0.001uF; C_Rect_L7.2mm_W2.5mm_P5.00mm_FKS2_FKP2_MKS2_MKP2
D25: D; D_A-405_P2.54mm_Vertical_AnodeUp
J13: Conn_01x01_Pin; PinHeader_1x01_P2.54mm_Vertical
Q8, Q27: PNP; TO-92_HandSolder
Q24, Q25: NPN; TO-92_HandSolder
Q26: HN1C01FU-GR,LF; HN1C01FUGRLF_DIP8; Manufacturer_Part_Number HN4A06J(TE85L,F); Mouser Part Number 757-HN4A06JTE85LF
Q28: NJFET; TO-92_HandSolder
R34, R36, R101, R105: 10K; R_Axial_DIN0207_L6.3mm_D2.5mm_P2.54mm_Vertical
R35, R102, R118: 100K; R_Axial_DIN0207_L6.3mm_D2.5mm_P2.54mm_Vertical
R45: 22K; R_Axial_DIN0207_L6.3mm_D2.5mm_P2.54mm_Vertical
R100: 1K(TEMPCO); R_Axial_DIN0207_L6.3mm_D2.5mm_P2.54mm_Vertical
R103: 220K; R_Axial_DIN0207_L6.3mm_D2.5mm_P2.54mm_Vertical
R104: 2.2K; R_Axial_DIN0207_L6.3mm_D2.5mm_P2.54mm_Vertical
R106: 27K; R_Axial_DIN0207_L6.3mm_D2.5mm_P2.54mm_Vertical
SW1: 2MS1T1B4VS2QES; Manufacturer_Part_Number 2MS1T1B4VS2QES; Mouser Part Number N/A
TM4: 50K; 3296W1502A; Manufacturer_Part_Number 3296W-1-502A; Mouser Part Number 652-3296W-1-502A
TM5: 5K; 3296W1502A; Manufacturer_Part_Number 3296W-1-502A; Mouser Part Number 652-3296W-1-502A
U2: Opamp_Dual; DIP-8_W7.62mm_Socket_LongPads
VR2: 50K(B); PTV1113420AA103; Manufacturer_Part_Number PTV111-3420A-A103; Mouser Part Number 652-PTV1113420AA103

Connections:
A+5.333V: Q26.2 (B1), R36.2, R100.2, R101.1, TM4.1 (CCW), U2.3 (+), U2.5 (+), VR2.3 (CW); also elsewhere on the board
A+12V: Q27.1 (E), Q28.1 (D), R45.1, R103.1, TM4.3 (CW), U2.8 (V+); also elsewhere on the board
A+VCO_CV: TM5.3 (CW); also elsewhere on the board
A+VCO_SAW: C10.2, Q28.3 (S), R35.2, R105.1, SW1.3
A+VCO_SQU: Q8.2 (C), R36.1, SW1.1
A+VCO_WAVE: J13.1, SW1.2 (2_Comm); also elsewhere on the board
unnamed: C10.1, R34.2
unnamed: C34.2, R104.2, U2.1
unnamed: D25.2 (A), Q27.2 (C)
unnamed: D25.1 (K), Q24.2 (C), Q24.3 (B), Q25.3 (B)
unnamed: Q8.3 (B), R34.1, R35.1
unnamed: C11.1, Q8.1 (E), R45.2
unnamed: Q24.1 (E), R101.2
unnamed: Q25.2 (C), Q27.3 (B)
unnamed: C33.2, Q25.1 (E), Q26.3 (C2), Q28.2 (G)
unnamed: Q26.5 (B2), R100.1, R106.1, R118.2
unnamed: C34.1, Q26.6 (C1), R102.1, R103.2, U2.2 (-)
unnamed: Q26.1 (E1), Q26.4 (E2), R104.1
unnamed: R102.2, TM4.2 (WIPER)
unnamed: R106.2, TM5.1 (CCW), TM5.2 (WIPER)
unnamed: U2.6 (-), U2.7
unnamed: R118.1, VR2.2 (WIPER)

Notes on the sheet:
最終的にはこれに統一 HN1C01FU_DIP
toVCF
TUNE
WIDTH
TUNING
