wakimizufu/TBSEQ/TBSEQ_Board_V3/mainBorad/mainBorad.kicad_pcb

## KiCad design TBSEQ_Board_V3/mainBorad/mainBorad.kicad_pcb (continued)

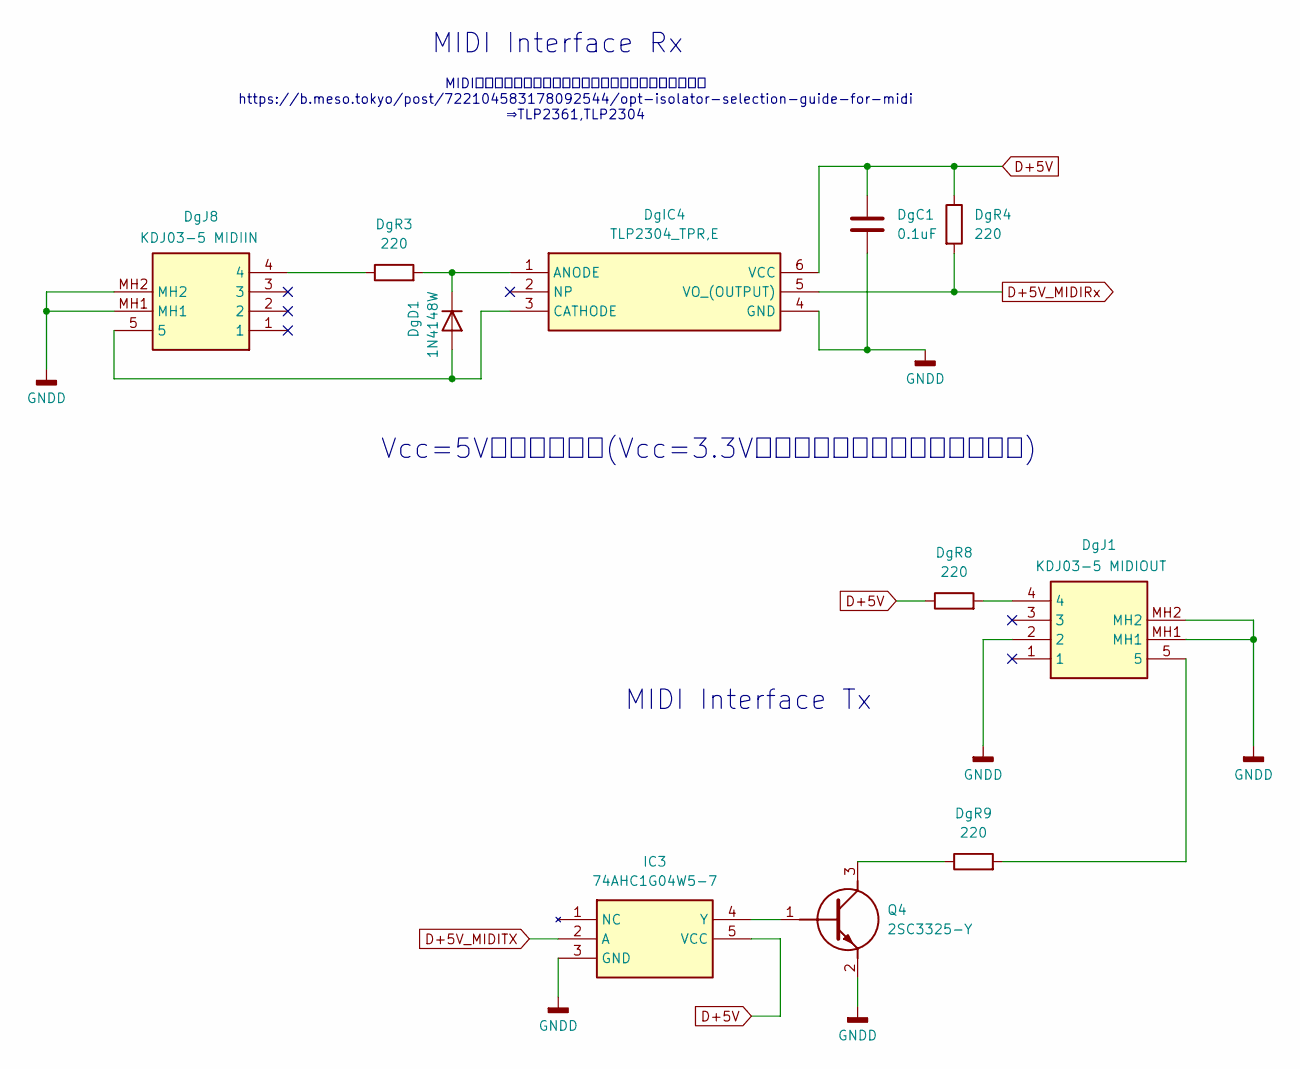
[picture p94: schematic MIDIRx.kicad_sch]

Parts:
DgC1: 0.1uF; C_0805_2012Metric_Pad1.18x1.45mm_HandSolder
DgD1: 1N4148W; D_SOD-123
DgIC4: TLP2304_TPR,E; SOIC127P700X230-6N; Manufacturer_Part_Number TLP2304(TPR,E; Mouser Part Number 757-TLP2304TPRE
DgJ1: KDJ03-5 MIDIOUT; KDJ035; Manufacturer_Part_Number KDJ03-5
DgJ8: KDJ03-5 MIDIIN; KDJ035; Manufacturer_Part_Number KDJ03-5
DgR3, DgR4, DgR8, DgR9: 220; R_0805_2012Metric_Pad1.20x1.40mm_HandSolder
IC3: 74AHC1G04W5-7; SOT95P285X140-5N; Manufacturer_Part_Number 74AHC1G04W5-7; Mouser Part Number 621-74AHC1G04W5-7
Q4: 2SC3325-Y; 2SC3325YLF; Manufacturer_Part_Number 2SC3325-Y

Connections:
D+5V: DgC1.1, DgIC4.6 (VCC), DgR4.1, DgR8.1, IC3.5 (VCC); also elsewhere on the board
D+5V_MIDIRx: DgIC4.5 (VO_(OUTPUT)), DgR4.2; also elsewhere on the board
D+5V_MIDITX: IC3.2 (A); also elsewhere on the board
GNDD: DgC1.2, DgIC4.4 (GND), DgJ1.2, DgJ1.MH1, DgJ1.MH2, DgJ8.MH1, DgJ8.MH2, IC3.3 (GND), Q4.2 (E); also elsewhere on the board
unnamed: DgD1.2 (A), DgIC4.3 (CATHODE), DgJ8.5
unnamed: DgD1.1 (K), DgIC4.1 (ANODE), DgR3.2
unnamed: DgJ1.4, DgR8.2
unnamed: DgJ1.5, DgR9.2
unnamed: DgJ8.4, DgR3.1
unnamed: IC3.4 (Y), Q4.1 (B)
unnamed: DgR9.1, Q4.3 (C)

Notes on the sheet:
MIDI送受信回路で使うオプトアイソレータはどれが良い？ https://b.meso.tokyo/post/722104583178092544/opt-isolator-selection-guide-for-midi ⇒TLP2361,TLP2304
MIDI Interface Tx
MIDI Interface Rx
Vcc=5Vで動作確認済(Vcc=3.3Vだと動作できない事も確認した)

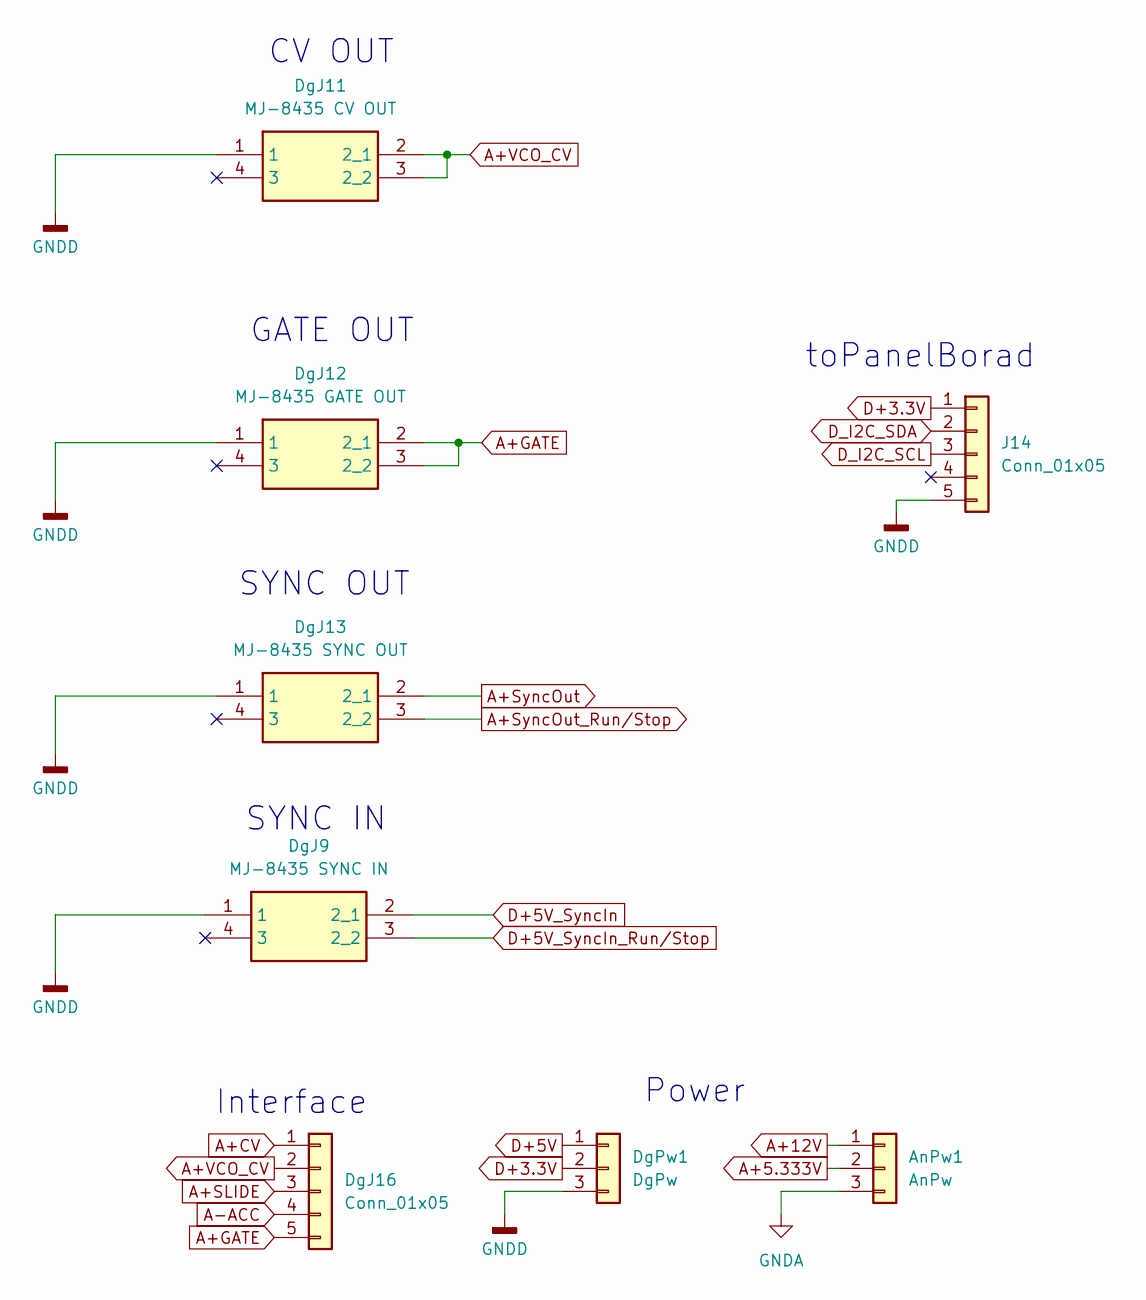
[picture p95: schematic Jack.kicad_sch]

Parts:
AnPw1: AnPw; PinSocket_1x03_P2.54mm_Vertical
DgJ9: MJ-8435 SYNC IN; MJ-8435; Manufacturer_Part_Number MJ-8435
DgJ11: MJ-8435 CV OUT; MJ-8435; Manufacturer_Part_Number MJ-8435
DgJ12: MJ-8435 GATE OUT; MJ-8435; Manufacturer_Part_Number MJ-8435
DgJ13: MJ-8435 SYNC OUT; MJ-8435; Manufacturer_Part_Number MJ-8435
DgJ16: Conn_01x05; PinHeader_1x05_P2.54mm_Vertical
DgPw1: DgPw; PinSocket_1x03_P2.54mm_Vertical
J14: Conn_01x05; JST_XH_B5B-XH-A_1x05_P2.50mm_Vertical

Connections:
A+5.333V: AnPw1.2; also elsewhere on the board
A+12V: AnPw1.1; also elsewhere on the board
A+CV: DgJ16.1; also elsewhere on the board
A+GATE: DgJ12.2 (2_1), DgJ12.3 (2_2), DgJ16.5; also elsewhere on the board
A+SLIDE: DgJ16.3; also elsewhere on the board
A+SyncOut: DgJ13.2 (2_1); also elsewhere on the board
A+SyncOut_Run/Stop: DgJ13.3 (2_2); also elsewhere on the board
A+VCO_CV: DgJ11.2 (2_1), DgJ11.3 (2_2), DgJ16.2; also elsewhere on the board
A-ACC: DgJ16.4; also elsewhere on the board
D+3.3V: DgPw1.2, J14.1; also elsewhere on the board
D+5V: DgPw1.1; also elsewhere on the board
D+5V_SyncIn: DgJ9.2 (2_1); also elsewhere on the board
D+5V_SyncIn_Run/Stop: DgJ9.3 (2_2); also elsewhere on the board
D_I2C_SCL: J14.3; also elsewhere on the board
D_I2C_SDA: J14.2; also elsewhere on the board
GNDD: DgJ9.1, DgJ11.1, DgJ12.1, DgJ13.1, DgPw1.3, J14.5; also elsewhere on the board

Notes on the sheet:
SYNC OUT
toPanelBorad
CV OUT
SYNC IN
Interface
GATE OUT
Power

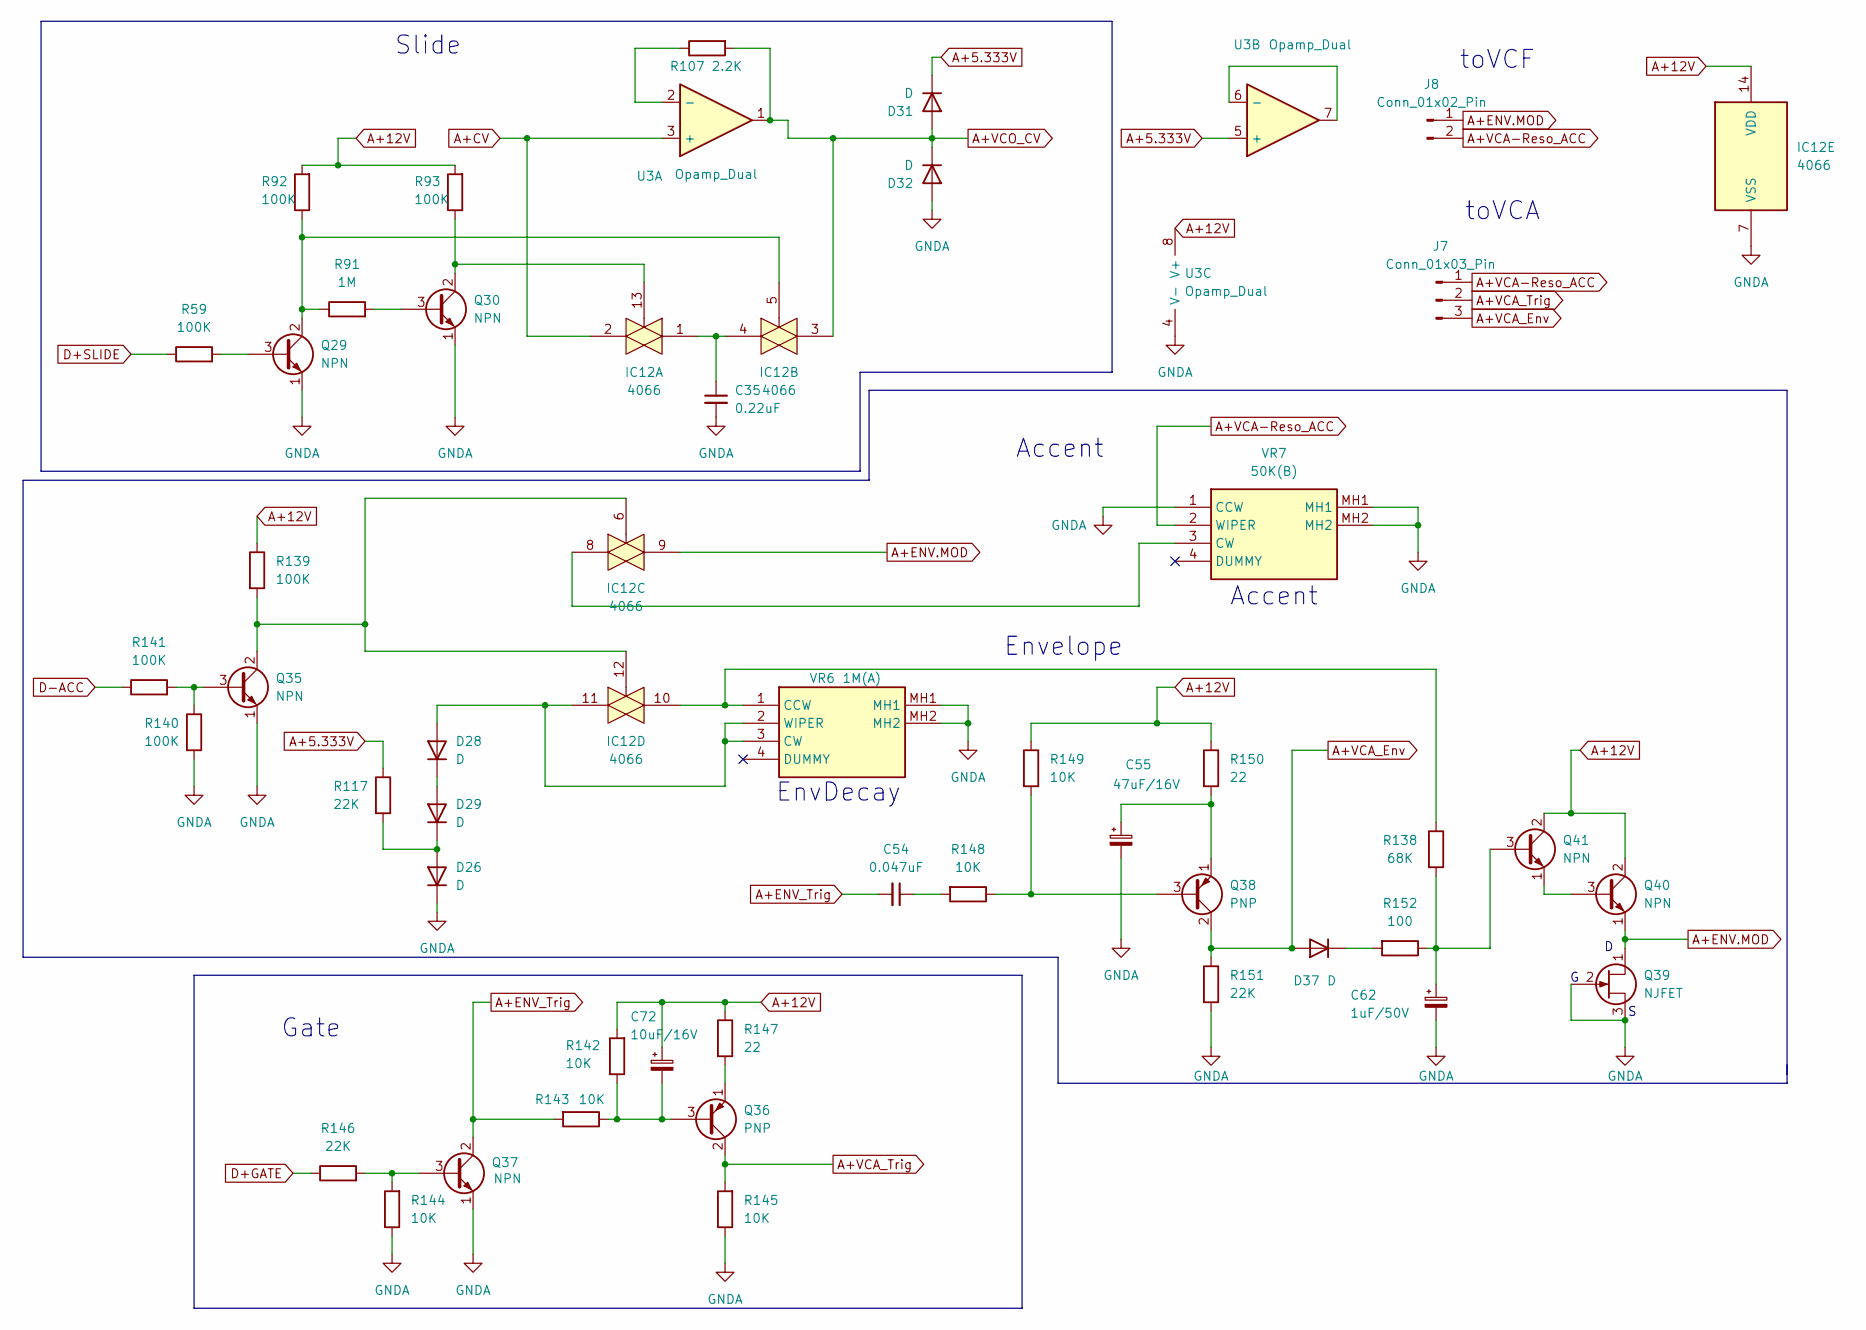
[picture p96: schematic Interface.kicad_sch]

Parts:
C35: 0.22uF; C_Rect_L7.2mm_W3.5mm_P5.00mm_FKS2_FKP2_MKS2_MKP2
C54: 0.047uF; C_Rect_L7.2mm_W2.5mm_P5.00mm_FKS2_FKP2_MKS2_MKP2
C55: 47uF/16V; CP_Radial_D4.0mm_P2.00mm
C62: 1uF/50V; CP_Radial_D5.0mm_P2.00mm
C72: 10uF/16V; CP_Radial_D4.0mm_P2.00mm
D26, D28, D29, D31, D32, D37: D; D_A-405_P2.54mm_Vertical_AnodeUp
IC12: 4066; DIP-14_W7.62mm_LongPads
J7: Conn_01x03_Pin; PinHeader_1x03_P2.54mm_Vertical
J8: Conn_01x02_Pin; PinHeader_1x02_P2.54mm_Vertical
Q29, Q30, Q35, Q37, Q40, Q41: NPN; TO-92_HandSolder
Q36, Q38: PNP; TO-92_HandSolder
Q39: NJFET; TO-92_HandSolder
R59, R92, R93, R139, R140, R141: 100K; R_Axial_DIN0207_L6.3mm_D2.5mm_P2.54mm_Vertical
R91: 1M; R_Axial_DIN0207_L6.3mm_D2.5mm_P2.54mm_Vertical
R107: 2.2K; R_Axial_DIN0207_L6.3mm_D2.5mm_P2.54mm_Vertical
R117, R146, R151: 22K; R_Axial_DIN0207_L6.3mm_D2.5mm_P2.54mm_Vertical
R138: 68K; R_Axial_DIN0207_L6.3mm_D2.5mm_P2.54mm_Vertical
R142, R143, R144, R145, R148, R149: 10K; R_Axial_DIN0207_L6.3mm_D2.5mm_P2.54mm_Vertical
R147, R150: 22; R_Axial_DIN0207_L6.3mm_D2.5mm_P2.54mm_Vertical
R152: 100; R_Axial_DIN0207_L6.3mm_D2.5mm_P2.54mm_Vertical
U3: Opamp_Dual; DIP-8_W7.62mm_LongPads
VR6: 1M(A); PTV1113420AA103; Manufacturer_Part_Number PTV111-3420A-A103; Mouser Part Number 652-PTV1113420AA103
VR7: 50K(B); PTV1113420AA103; Manufacturer_Part_Number PTV111-3420A-A103; Mouser Part Number 652-PTV1113420AA103

Connections:
A+5.333V: D31.1 (K), R117.1, U3.5 (+); also elsewhere on the board
A+12V: C72.1, IC12.14 (VDD), Q40.2 (C), Q41.2 (C), R92.2, R93.2, R139.1, R142.2, R147.1, R149.1, R150.1, U3.8 (V+); also elsewhere on the board
A+CV: IC12.2, U3.3 (+); also elsewhere on the board
A+ENV.MOD: IC12.9, J8.1, Q39.1 (D), Q40.1 (E); also elsewhere on the board
A+ENV_Trig: C54.2, Q37.2 (C), R143.2
A+VCA-Reso_ACC: J7.1, J8.2, VR7.2 (WIPER); also elsewhere on the board
A+VCA_Env: D37.2 (A), J7.3, Q38.2 (C), R151.1; also elsewhere on the board
A+VCA_Trig: J7.2, Q36.2 (C), R145.2; also elsewhere on the board
A+VCO_CV: D31.2 (A), D32.1 (K), IC12.3, R107.2, U3.1; also elsewhere on the board
D+GATE: R146.1; also elsewhere on the board
D+SLIDE: R59.1; also elsewhere on the board
D-ACC: R141.1; also elsewhere on the board
unnamed: C35.1, IC12.1, IC12.4
unnamed: C54.1, R148.2
unnamed: D26.2 (A), D29.1 (K), R117.2
unnamed: D28.2 (A), IC12.11, VR6.2 (WIPER), VR6.3 (CW)
unnamed: D28.1 (K), D29.2 (A)
unnamed: D37.1 (K), R152.2
unnamed: Q29.3 (B), R59.2
unnamed: IC12.5, Q29.2 (C), R91.1, R92.1
unnamed: Q30.3 (B), R91.2
unnamed: IC12.13, Q30.2 (C), R93.1
unnamed: Q35.3 (B), R140.1, R141.2
unnamed: IC12.6, IC12.12, Q35.2 (C), R139.2
unnamed: C72.2, Q36.3 (B), R142.1, R143.1
unnamed: Q36.1 (E), R147.2
unnamed: Q37.3 (B), R144.2, R146.2
unnamed: Q38.3 (B), R148.1, R149.2
unnamed: C55.1, Q38.1 (E), R150.2
unnamed: Q40.3 (B), Q41.1 (E)
unnamed: C62.1, Q41.3 (B), R138.2, R152.1
unnamed: R107.1, U3.2 (-)
unnamed: U3.6 (-), U3.7
unnamed: IC12.10, R138.1, VR6.1 (CCW)
unnamed: IC12.8, VR7.3 (CW)

Notes on the sheet:
Accent
Gate
Envelope
toVCF
Slide
EnvDecay
toVCA

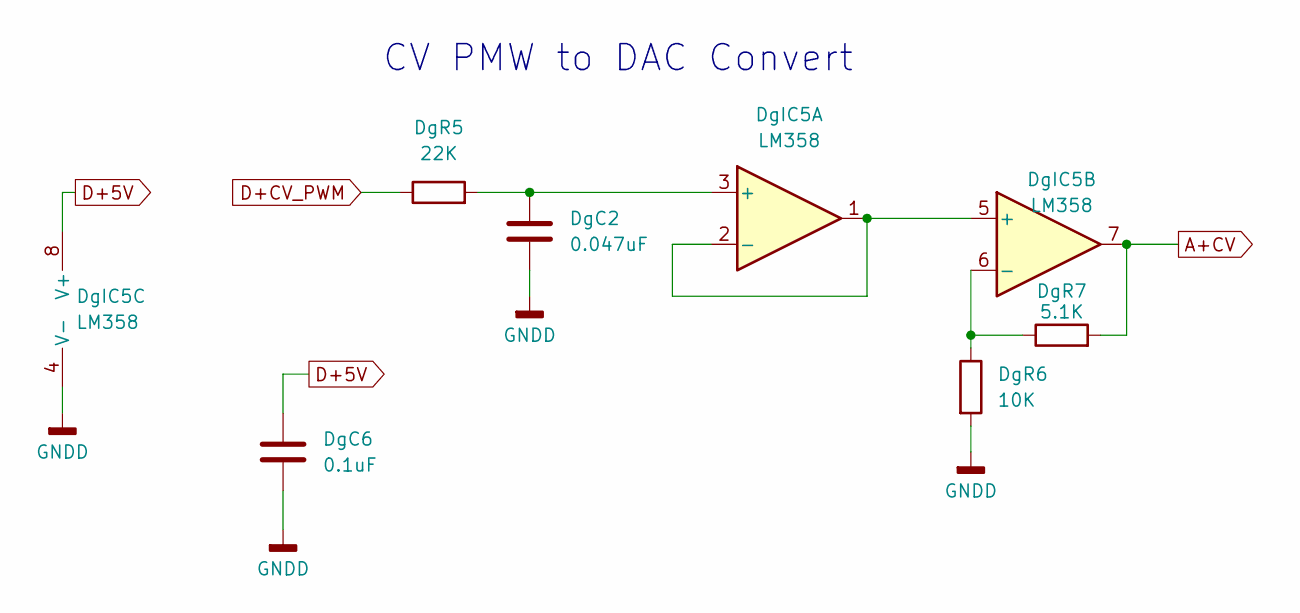
[picture p97: schematic CV.kicad_sch]

Parts:
DgC2: 0.047uF; C_Rect_L7.0mm_W2.5mm_P5.00mm
DgC6: 0.1uF; C_0805_2012Metric_Pad1.18x1.45mm_HandSolder
DgIC5: LM358; SOIC-8_3.9x4.9mm_P1.27mm
DgR5: 22K; R_Axial_DIN0207_L6.3mm_D2.5mm_P2.54mm_Vertical
DgR6: 10K; R_Axial_DIN0207_L6.3mm_D2.5mm_P2.54mm_Vertical
DgR7: 5.1K; R_Axial_DIN0207_L6.3mm_D2.5mm_P2.54mm_Vertical

Connections:
A+CV: DgIC5.7, DgR7.2; also elsewhere on the board
D+5V: DgC6.1, DgIC5.8 (V+); also elsewhere on the board
D+CV_PWM: DgR5.1; also elsewhere on the board
GNDD: DgC2.2, DgC6.2, DgIC5.4 (V-), DgR6.2; also elsewhere on the board
unnamed: DgC2.1, DgIC5.3 (+), DgR5.2
unnamed: DgIC5.1, DgIC5.2 (-), DgIC5.5 (+)
unnamed: DgIC5.6 (-), DgR6.1, DgR7.1

Notes on the sheet:
CV PMW to DAC Convert

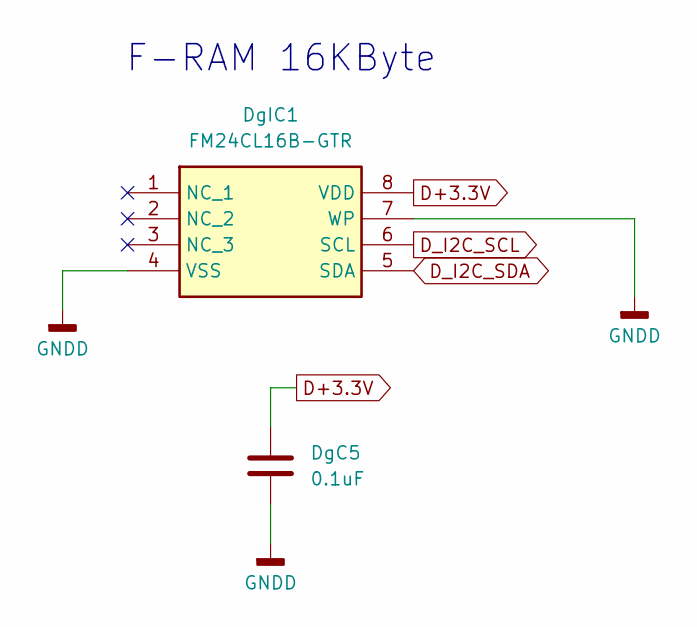
[picture p98: schematic FRAM.kicad_sch]

Parts:
DgC5: 0.1uF; C_0805_2012Metric_Pad1.18x1.45mm_HandSolder
DgIC1: FM24CL16B-GTR; SOIC127P602X173-8N; Manufacturer_Part_Number FM24CL16B-GTR; Mouser Part Number 877-FM24CL16B-GTR

Connections:
D+3.3V: DgC5.1, DgIC1.8 (VDD); also elsewhere on the board
D_I2C_SCL: DgIC1.6 (SCL); also elsewhere on the board
D_I2C_SDA: DgIC1.5 (SDA); also elsewhere on the board
GNDD: DgC5.2, DgIC1.4 (VSS), DgIC1.7 (WP); also elsewhere on the board

Notes on the sheet:
F-RAM 16KByte

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
Board: 2 copper layers, 263 parts (9 on the bottom side), 209 nets, no tracks yet.

Other parts of the board:
C9: 1uF/25V; CP_Radial_D5.0mm_P2.50mm
IC4: NJM2125F-TE1; SOT95P280X130-5N
J4, J5: Conn_01x02; PinHeader_1x02_P2.54mm_Vertical
J10, J11: Conn_01x05; PinHeader_1x05_P2.54mm_Vertical
VCA_R1: 47K; R_Axial_DIN0207_L6.3mm_D2.5mm_P2.54mm_Vertical

Their connections:
A+5.333V: IC4.3 (-INPUT), IC4.4 (OUTPUT); also elsewhere on the board
A+12V: IC4.5 (V+); also elsewhere on the board
unnamed 75: J4.1; also elsewhere on the board
unnamed 76: J4.2; also elsewhere on the board
unnamed 77: J5.1; also elsewhere on the board
unnamed 78: J5.2; also elsewhere on the board
unnamed 79: J10.1; also elsewhere on the board
unnamed 80: J10.2; also elsewhere on the board
unnamed 81: J10.3; also elsewhere on the board
unnamed 82: J10.4; also elsewhere on the board
unnamed 83: J10.5; also elsewhere on the board
unnamed 84: J11.1; also elsewhere on the board
unnamed 85: J11.2; also elsewhere on the board
unnamed 86: J11.3; also elsewhere on the board
unnamed 87: J11.4; also elsewhere on the board
unnamed 88: J11.5; also elsewhere on the board
