wakimizufu/TBSEQ/TBSEQ_Board_V2/SyncBoard/SyncBoard.kicad_pcb

## KiCad design TBSEQ_Board_V2/SyncBoard/SyncBoard.kicad_pcb (2025-03-09, an earlier design)

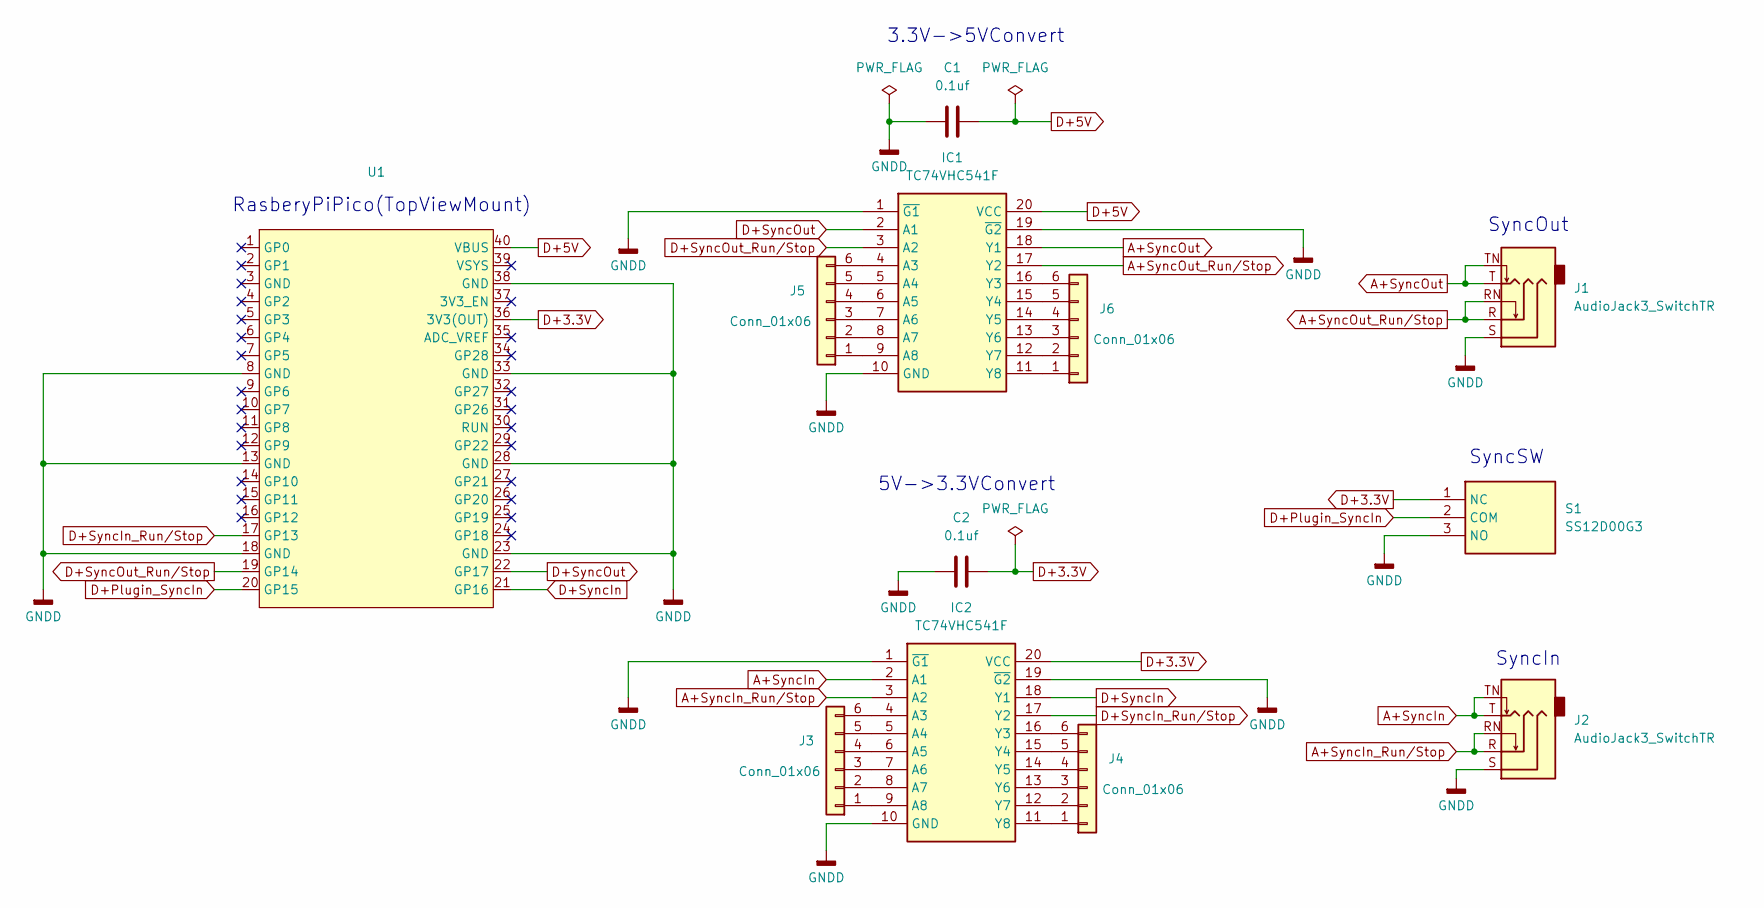
[picture p99: schematic SyncBoard.kicad_sch]

Parts:
C1, C2: 0.1uf; C_0805_2012Metric_Pad1.18x1.45mm_HandSolder
IC1, IC2: TC74VHC541F; SOIC127P780X190-20N; Manufacturer_Part_Number TC74VHC541F; Mouser Part Number 757-TC74VHC541F
J1, J2: AudioJack3_SwitchTR; Jack_3.5mm_CUI_SJ1-3515N_Horizontal
J3, J4, J5, J6: Conn_01x06; PinHeader_1x06_P2.54mm_Vertical
S1: SS12D00G3; Manufacturer_Part_Number SS12D00G3
U1: Raspberry Pi Pico DIP-40_W17.76mm

Connections:
A+SyncIn: IC2.2 (A1), J2.T, J2.TN
A+SyncIn_Run/Stop: IC2.3 (A2), J2.R, J2.RN
A+SyncOut: IC1.18 (Y1), J1.T, J1.TN
A+SyncOut_Run/Stop: IC1.17 (Y2), J1.R, J1.RN
D+3.3V: C2.2, IC2.20 (VCC), S1.1 (NC), U1.36 (3V3(OUT))
D+5V: C1.2, IC1.20 (VCC), U1.40 (VBUS)
D+Plugin_SyncIn: S1.2 (COM), U1.20 (GP15)
D+SyncIn: IC2.18 (Y1), U1.21 (GP16)
D+SyncIn_Run/Stop: IC2.17 (Y2), U1.17 (GP13)
D+SyncOut: IC1.2 (A1), U1.22 (GP17)
D+SyncOut_Run/Stop: IC1.3 (A2), U1.19 (GP14)
GNDD: C1.1, C2.1, IC1.1 (~G1), IC1.10 (GND), IC1.19 (~G2), IC2.1 (~G1), IC2.10 (GND), IC2.19 (~G2), J1.S, J2.S, S1.3 (NO), U1.8 (GND), U1.13 (GND), U1.18 (GND), U1.23 (GND), U1.28 (GND), U1.33 (GND), U1.38 (GND)
unnamed: IC1.4 (A3), J5.6
unnamed: IC1.5 (A4), J5.5
unnamed: IC1.6 (A5), J5.4
unnamed: IC1.7 (A6), J5.3
unnamed: IC1.8 (A7), J5.2
unnamed: IC1.9 (A8), J5.1
unnamed: IC1.16 (Y3), J6.6
unnamed: IC1.15 (Y4), J6.5
unnamed: IC1.14 (Y5), J6.4
unnamed: IC1.13 (Y6), J6.3
unnamed: IC1.12 (Y7), J6.2
unnamed: IC1.11 (Y8), J6.1
unnamed: IC2.4 (A3), J3.6
unnamed: IC2.5 (A4), J3.5
unnamed: IC2.6 (A5), J3.4
unnamed: IC2.7 (A6), J3.3
unnamed: IC2.8 (A7), J3.2
unnamed: IC2.9 (A8), J3.1
unnamed: IC2.16 (Y3), J4.6
unnamed: IC2.15 (Y4), J4.5
unnamed: IC2.14 (Y5), J4.4
unnamed: IC2.13 (Y6), J4.3
unnamed: IC2.12 (Y7), J4.2
unnamed: IC2.11 (Y8), J4.1

Notes on the sheet:
RasberyPiPico(TopViewMount)
SyncIn
3.3V->5VConvert
SyncSW
SyncOut
5V->3.3VConvert

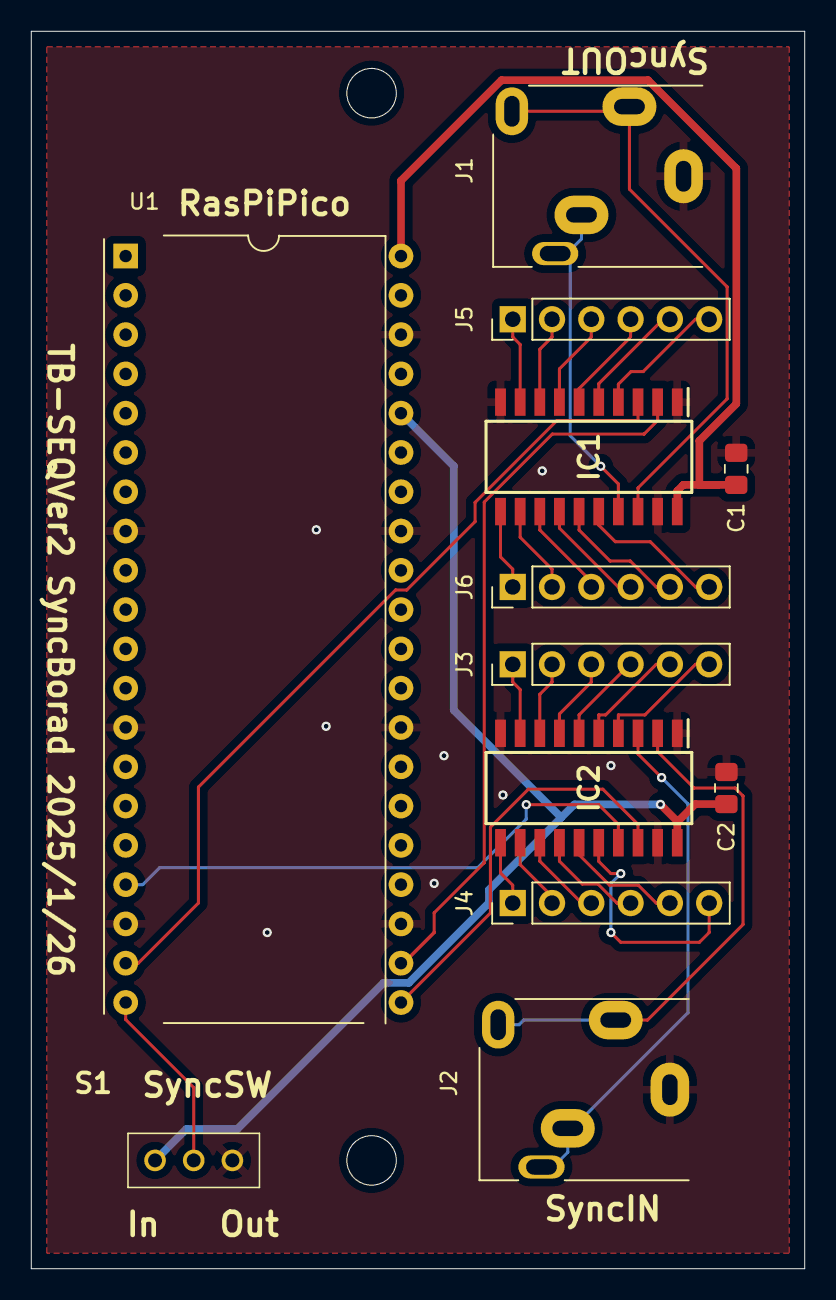
[picture p100: board SyncBoard.kicad_pcb from above]

Board: 2 copper layers, 50.0 x 80.0 mm, 12 parts (0 on the bottom side), 36 nets.
