wakimizufu/TBSEQ/LM13700_VCA/LM13700_Overdrive/LM13700_Overdrive.kicad_pcb

## KiCad design LM13700_VCA/LM13700_Overdrive/LM13700_Overdrive.kicad_pcb (2025-03-09)

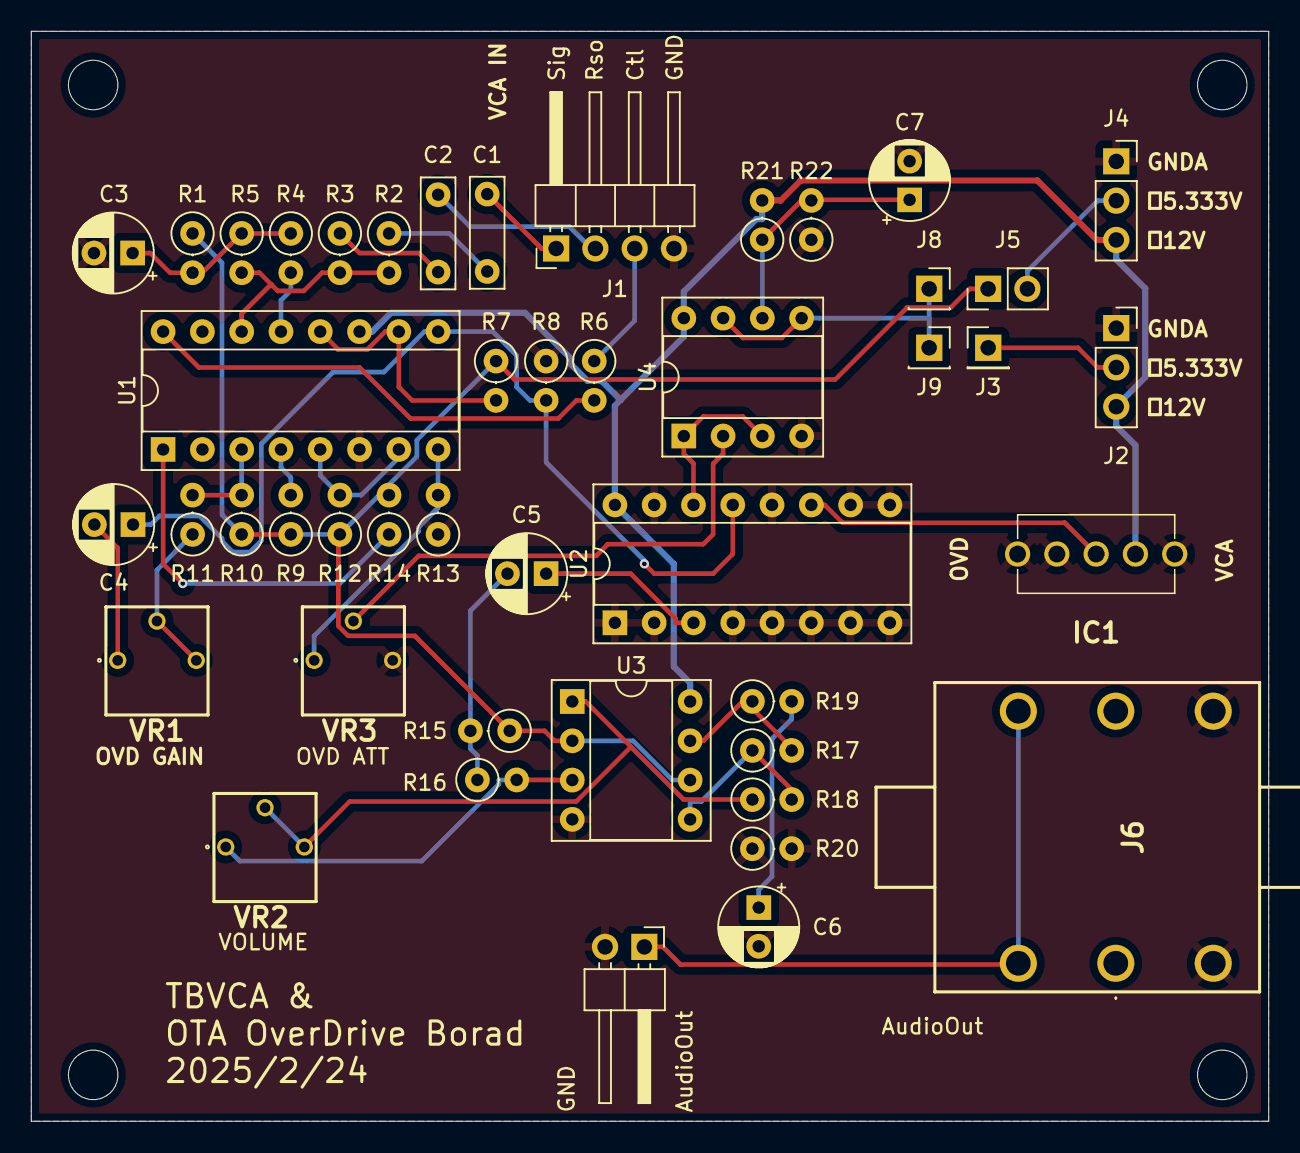
[picture p101: board LM13700_Overdrive.kicad_pcb from above]

Board: 2 copper layers, 80.0 x 70.5 mm, 46 parts (0 on the bottom side), 36 nets.

Parts:
C1, C2: 0.01uF; C_Rect_L7.0mm_W2.0mm_P5.00mm
C3, C4: 10uF/25V; CP_Radial_D5.0mm_P2.50mm
C5, C6: 1uF/25V; CP_Radial_D5.0mm_P2.50mm
C7: 2.2uF/25V; CP_Radial_D5.0mm_P2.50mm
IC1: 2MS1T1B4VS2QES
J1: Conn_01x04; PinHeader_1x04_P2.54mm_Horizontal
J2, J4: Conn_01x03; PinSocket_1x03_P2.54mm_Vertical
J3: Conn_01x01; PinHeader_1x01_P2.54mm_Vertical
J5: Conn_01x02; PinHeader_1x02_P2.54mm_Vertical
J6: MJ-462; MJ462
J7: Conn_01x02; PinHeader_1x02_P2.54mm_Horizontal
J8, J9: Conn_01x01; PinSocket_1x01_P2.54mm_Vertical
R1, R4, R5: 2.2K; R_Axial_DIN0207_L6.3mm_D2.5mm_P2.54mm_Vertical
R2: 220K; R_Axial_DIN0207_L6.3mm_D2.5mm_P2.54mm_Vertical
R3, R15, R20: 100K; R_Axial_DIN0207_L6.3mm_D2.5mm_P2.54mm_Vertical
R6: 47K; R_Axial_DIN0207_L6.3mm_D2.5mm_P2.54mm_Vertical
R7, R12: 33K; R_Axial_DIN0207_L6.3mm_D2.5mm_P2.54mm_Vertical
R8, R13: 5K; R_Axial_DIN0207_L6.3mm_D2.5mm_P2.54mm_Vertical
R9, R10: 510; R_Axial_DIN0207_L6.3mm_D2.5mm_P2.54mm_Vertical
R11: 1K; R_Axial_DIN0207_L6.3mm_D2.5mm_P2.54mm_Vertical
R14, R16, R17, R18: 10K; R_Axial_DIN0207_L6.3mm_D2.5mm_P2.54mm_Vertical
R19: 100; R_Axial_DIN0207_L6.3mm_D2.5mm_P2.54mm_Vertical
R21: 30K; R_Axial_DIN0207_L6.3mm_D2.5mm_P2.54mm_Vertical
R22: 24K; R_Axial_DIN0207_L6.3mm_D2.5mm_P2.54mm_Vertical
U1: LM13700; DIP-16_W7.62mm_Socket
U2: 4051; DIP-16_W7.62mm_Socket
U3, U4: Opamp_Dual; DIP-8_W7.62mm_Socket
VR1, VR2, VR3: 3362P-1-104LF 100K; 3362P_1

Connections:
+5.333VA: J5.1, R1.1, R7.1, R9.1, R10.1, R12.1, R14.2, R15.1, U3.2 (-), U3.6 (-)
+12VA: IC1.3, J2.3, J4.3, R21.2, U1.11 (V+), U2.16 (VDD), U3.8 (V+), U4.8 (V+)
A+_VCA_Control: J1.3, R6.1
A+_VCA_Resonance: C2.1, J1.2
A+_VCA_Signal: C1.1, J1.1
AUDIO_OUT: C5.1, U2.3 (X)
GNDA: C3.2, C6.2, C7.2, IC1.1, IC1.MH1, IC1.MH2, J1.4, J2.1, J4.1, J6.S1, J6.SS1, J7.2, R8.1, R13.1, R20.1, R20.2, R22.1, U1.6 (V-), U2.1 (X4), U2.2 (X6), U2.4 (X7), U2.5 (X5), U2.6 (Inh), U2.7 (VEE), U2.8 (VSS), U2.9 (C), U2.10 (B), U2.12 (X3), U2.15 (X2), U3.4 (V-), U4.4 (V-), VR3.3 (CW)
unnamed: C1.2, R2.1
unnamed: C2.2, R3.1
unnamed: C3.1, R1.2, R4.1, R5.1
unnamed: C5.2, R15.2, R16.1
unnamed: C6.1, R19.2
unnamed: J2.2, J3.1
unnamed: J4.2, J5.2
unnamed: J6.T1, J6.TS1, J7.1
unnamed: J8.1, J9.1, U4.5 (+), U4.7
unnamed: R6.2, U1.16
unnamed: R7.2, U1.10, U1.12
unnamed: R12.2, U1.5, U1.7
unnamed: R14.1, U1.1
unnamed: R17.2, R19.1, U3.7
unnamed: R2.2, R3.2, R5.2, U1.14 (+)
unnamed: R4.2, U1.13 (-)
unnamed: R10.2, R11.2, U1.3 (+)
unnamed: R9.2, U1.4 (-)
unnamed: R16.2, U3.3 (+), VR2.1 (CCW)
unnamed: R17.1, R18.2, U3.5 (+)
unnamed: U4.2 (-), VR3.2 (WIPER)
unnamed: C7.1, R21.1, R22.2, U4.6 (-)
unnamed: C4.2, VR1.1 (CCW)
unnamed: R11.1, VR1.2 (WIPER), VR1.3 (CW)
unnamed: R18.1, U3.1, VR2.2 (WIPER), VR2.3 (CW)
unnamed: R13.2, U1.8, VR3.1 (CCW)
OVD_OUT: U2.14 (X1), U4.1, U4.3 (+)
SELECT: IC1.2 (2_Comm), U2.11 (A)
VCA_OUT: C4.1, R8.2, U1.9, U2.13 (X0)
