wakimizufu/TBSEQ/LM13700_VCA/LM13700_VCA/LM13700_VCA.kicad_pcb

## KiCad design LM13700_VCA/LM13700_VCA/LM13700_VCA.kicad_pcb (2025-03-09)

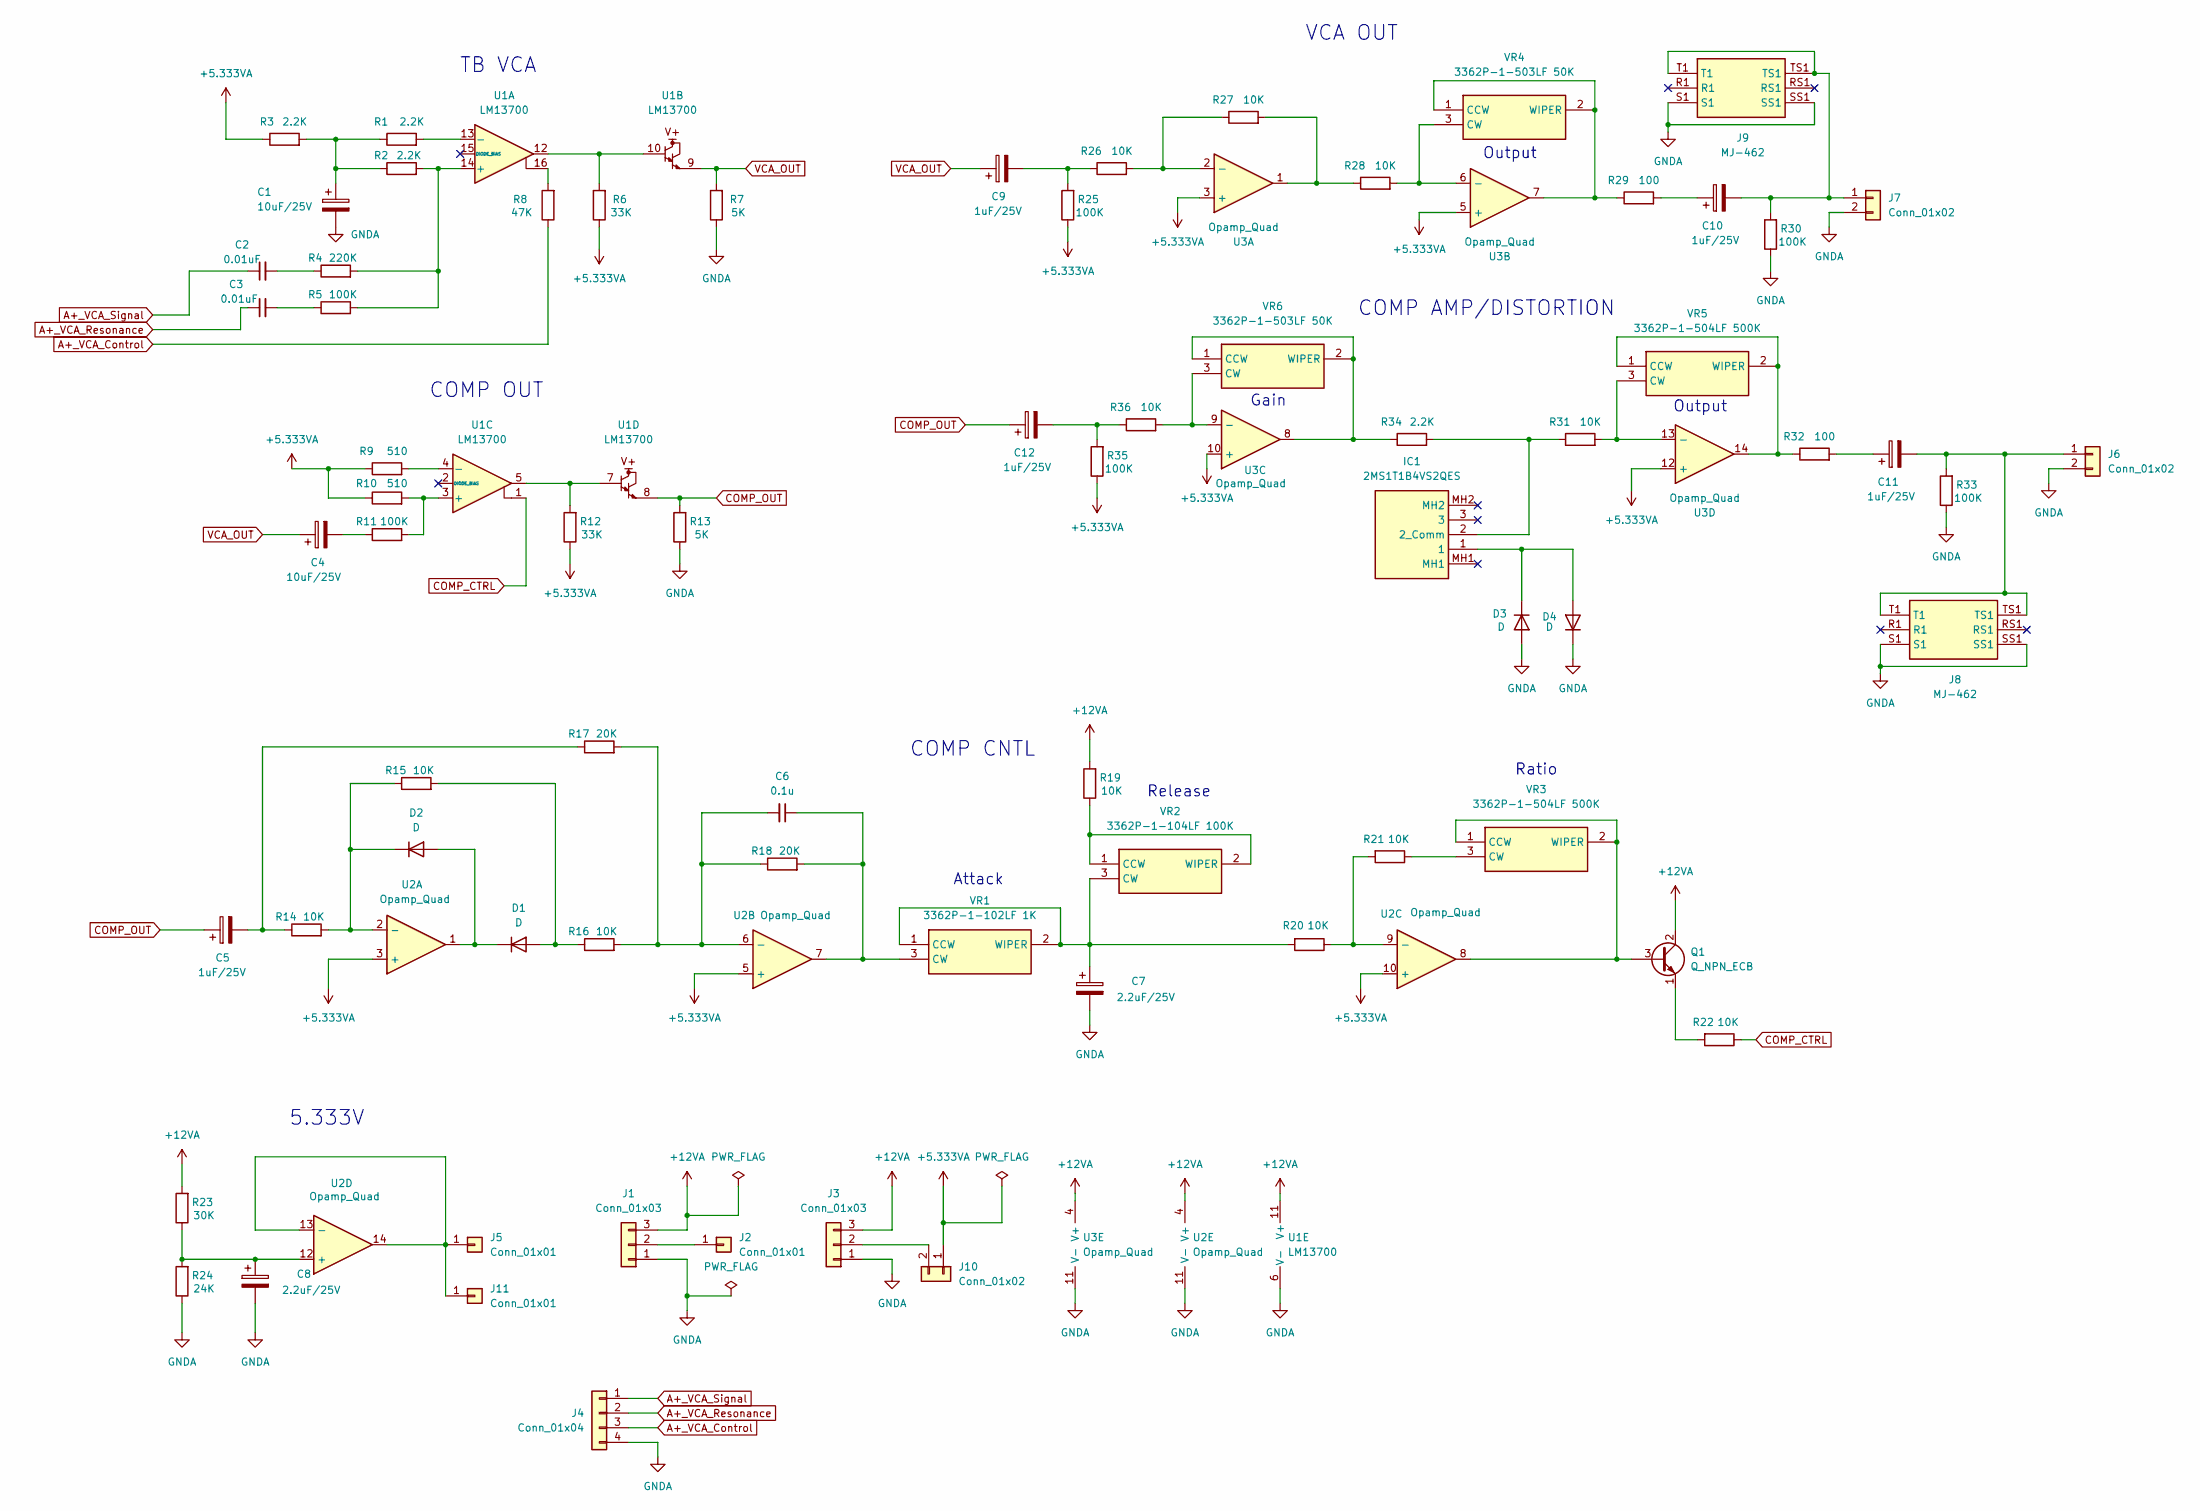
[picture p102: schematic LM13700_VCA.kicad_sch]

Parts:
C1, C4: 10uF/25V; CP_Radial_D5.0mm_P2.50mm
C2, C3: 0.01uF; C_Rect_L7.0mm_W2.0mm_P5.00mm
C5, C9, C10, C11, C12: 1uF/25V; CP_Radial_D5.0mm_P2.50mm
C6: 0.1u; C_Disc_D4.7mm_W2.5mm_P5.00mm
C7, C8: 2.2uF/25V; CP_Radial_D5.0mm_P2.50mm
D1, D2, D3, D4: D; D_DO-35_SOD27_P2.54mm_Vertical_AnodeUp
IC1: 2MS1T1B4VS2QES; Manufacturer_Part_Number 2MS1T1B4VS2QES; Mouser Part Number N/A
J1, J3: Conn_01x03; PinSocket_1x03_P2.54mm_Vertical
J2: Conn_01x01; PinHeader_1x01_P2.54mm_Vertical
J4: Conn_01x04; PinHeader_1x04_P2.54mm_Horizontal
J5, J11: Conn_01x01; PinSocket_1x01_P2.54mm_Vertical
J6, J7: Conn_01x02; PinHeader_1x02_P2.54mm_Horizontal
J8, J9: MJ-462; MJ462; Manufacturer_Part_Number MJ-462
J10: Conn_01x02; PinHeader_1x02_P2.54mm_Vertical
Q1: Q_NPN_ECB; TO-92
R1, R2, R3, R34: 2.2K; R_Axial_DIN0207_L6.3mm_D2.5mm_P2.54mm_Vertical
R4: 220K; R_Axial_DIN0207_L6.3mm_D2.5mm_P2.54mm_Vertical
R5, R11, R25, R30, R33, R35: 100K; R_Axial_DIN0207_L6.3mm_D2.5mm_P2.54mm_Vertical
R6, R12: 33K; R_Axial_DIN0207_L6.3mm_D2.5mm_P2.54mm_Vertical
R7, R13: 5K; R_Axial_DIN0207_L6.3mm_D2.5mm_P2.54mm_Vertical
R8: 47K; R_Axial_DIN0207_L6.3mm_D2.5mm_P2.54mm_Vertical
R9, R10: 510; R_Axial_DIN0207_L6.3mm_D2.5mm_P2.54mm_Vertical
R14, R15, R16, R19, R20, R21, R22, R26, R27, R28, R31, R36: 10K; R_Axial_DIN0207_L6.3mm_D2.5mm_P2.54mm_Vertical
R17, R18: 20K; R_Axial_DIN0207_L6.3mm_D2.5mm_P2.54mm_Vertical
R23: 30K; R_Axial_DIN0207_L6.3mm_D2.5mm_P2.54mm_Vertical
R24: 24K; R_Axial_DIN0207_L6.3mm_D2.5mm_P2.54mm_Vertical
R29, R32: 100; R_Axial_DIN0207_L6.3mm_D2.5mm_P2.54mm_Vertical
U1: LM13700; DIP-16_W7.62mm_Socket
U2: Opamp_Quad; DIP-14_W7.62mm_Socket_LongPads
U3: Opamp_Quad; DIP-14_W7.62mm_Socket
VR1: 3362P-1-102LF 1K; 3362P_1; Manufacturer_Part_Number 3362P-1-103LF; Mouser Part Number 652-3362P-1-103LF
VR2: 3362P-1-104LF 100K; 3362P_1; Manufacturer_Part_Number 3362P-1-103LF; Mouser Part Number 652-3362P-1-103LF
VR3, VR5: 3362P-1-504LF 500K; 3362P_1; Manufacturer_Part_Number 3362P-1-103LF; Mouser Part Number 652-3362P-1-103LF
VR4, VR6: 3362P-1-503LF 50K; 3362P_1; Manufacturer_Part_Number 3362P-1-103LF; Mouser Part Number 652-3362P-1-103LF

Connections:
+5.333VA: J10.1, R3.1, R6.1, R9.1, R10.1, R12.1, R25.1, R35.1, U2.3 (+), U2.5 (+), U2.10 (+), U3.3 (+), U3.5 (+), U3.10 (+), U3.12 (+)
+12VA: J1.3, J3.3, Q1.2 (C), R19.2, R23.2, U1.11 (V+), U2.4 (V+), U3.4 (V+)
A+_VCA_Control: J4.3, R8.1
A+_VCA_Resonance: C3.1, J4.2
A+_VCA_Signal: C2.1, J4.1
COMP_CTRL: R22.1, U1.1
COMP_OUT: C5.1, C12.1, R13.2, U1.8
GNDA: C1.2, C7.2, C8.2, D3.2 (A), D4.1 (K), J1.1, J3.1, J4.4, J6.2, J7.2, J8.S1, J8.SS1, J9.S1, J9.SS1, R7.1, R13.1, R24.1, R30.1, R33.1, U1.6 (V-), U2.11 (V-), U3.11 (V-)
unnamed: C1.1, R1.1, R2.1, R3.2
unnamed: C2.2, R4.1
unnamed: C3.2, R5.1
unnamed: C4.2, R11.1
unnamed: C5.2, R14.1, R17.1
unnamed: C9.2, R25.2, R26.1
unnamed: C10.1, R29.2
unnamed: C11.1, R32.2
unnamed: C12.2, R35.2, R36.1
unnamed: D1.2 (A), R15.2, R16.1
unnamed: D1.1 (K), D2.2 (A), U2.1
unnamed: D2.1 (K), R14.2, R15.1, U2.2 (-)
unnamed: D3.1 (K), D4.2 (A), IC1.1
unnamed: IC1.2 (2_Comm), R31.1, R34.2
unnamed: J1.2, J2.1
unnamed: C11.2, J6.1, J8.T1, J8.TS1, R33.2
unnamed: C10.2, J7.1, J9.T1, J9.TS1, R30.2
unnamed: J3.2, J10.2
unnamed: J5.1, J11.1, U2.13 (-), U2.14
unnamed: Q1.3 (B), U2.8, VR3.1 (CCW), VR3.2 (WIPER)
unnamed: Q1.1 (E), R22.2
unnamed: R6.2, U1.10, U1.12
unnamed: R8.2, U1.16
unnamed: R12.2, U1.5, U1.7
unnamed: R27.2, R28.1, U3.1
unnamed: R2.2, R4.2, R5.2, U1.14 (+)
unnamed: R1.2, U1.13 (-)
unnamed: R10.2, R11.2, U1.3 (+)
unnamed: R9.2, U1.4 (-)
unnamed: C6.2, R16.2, R17.2, R18.1, U2.6 (-)
unnamed: R20.1, R21.2, U2.9 (-)
unnamed: C8.1, R23.1, R24.2, U2.12 (+)
unnamed: R26.2, R27.1, U3.2 (-)
unnamed: R28.2, U3.6 (-), VR4.3 (CW)
unnamed: R36.2, U3.9 (-), VR6.3 (CW)
unnamed: R31.2, U3.13 (-), VR5.3 (CW)
unnamed: C7.1, R20.2, VR1.1 (CCW), VR1.2 (WIPER), VR2.3 (CW)
unnamed: C6.1, R18.2, U2.7, VR1.3 (CW)
unnamed: R19.1, VR2.1 (CCW), VR2.2 (WIPER)
unnamed: R21.1, VR3.3 (CW)
unnamed: R29.1, U3.7, VR4.1 (CCW), VR4.2 (WIPER)
unnamed: R32.1, U3.14, VR5.1 (CCW), VR5.2 (WIPER)
unnamed: R34.1, U3.8, VR6.1 (CCW), VR6.2 (WIPER)
VCA_OUT: C4.1, C9.1, R7.2, U1.9

Notes on the sheet:
Ratio
Release
5.333V
COMP OUT
Gain
Output
COMP CNTL
Attack
COMP AMP/DISTORTION
TB VCA
VCA OUT

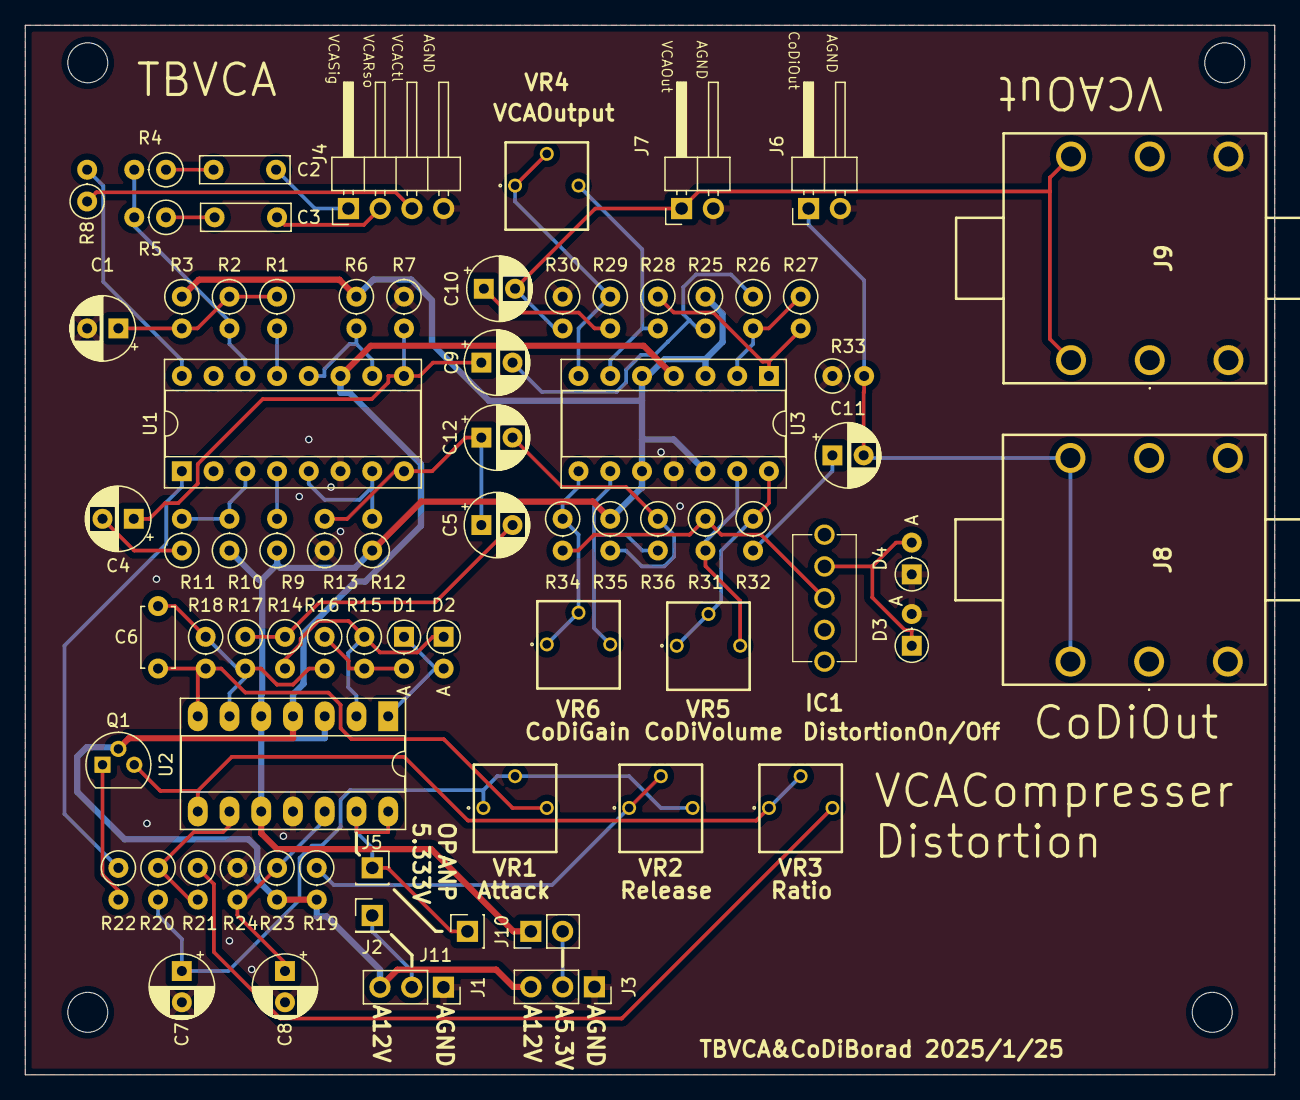
[picture p103: board LM13700_VCA.kicad_pcb from above]

Board: 2 copper layers, 100.0 x 84.0 mm, 74 parts (0 on the bottom side), 52 nets.
