wakimizufu/TBSEQ/TBSEQ_Board_V1/HT16K33Panel/HT16K33Panel/HT16K33Panel.kicad_pcb

## KiCad design TBSEQ_Board_V1/HT16K33Panel/HT16K33Panel/HT16K33Panel.kicad_pcb (2024-08-08, an earlier design)

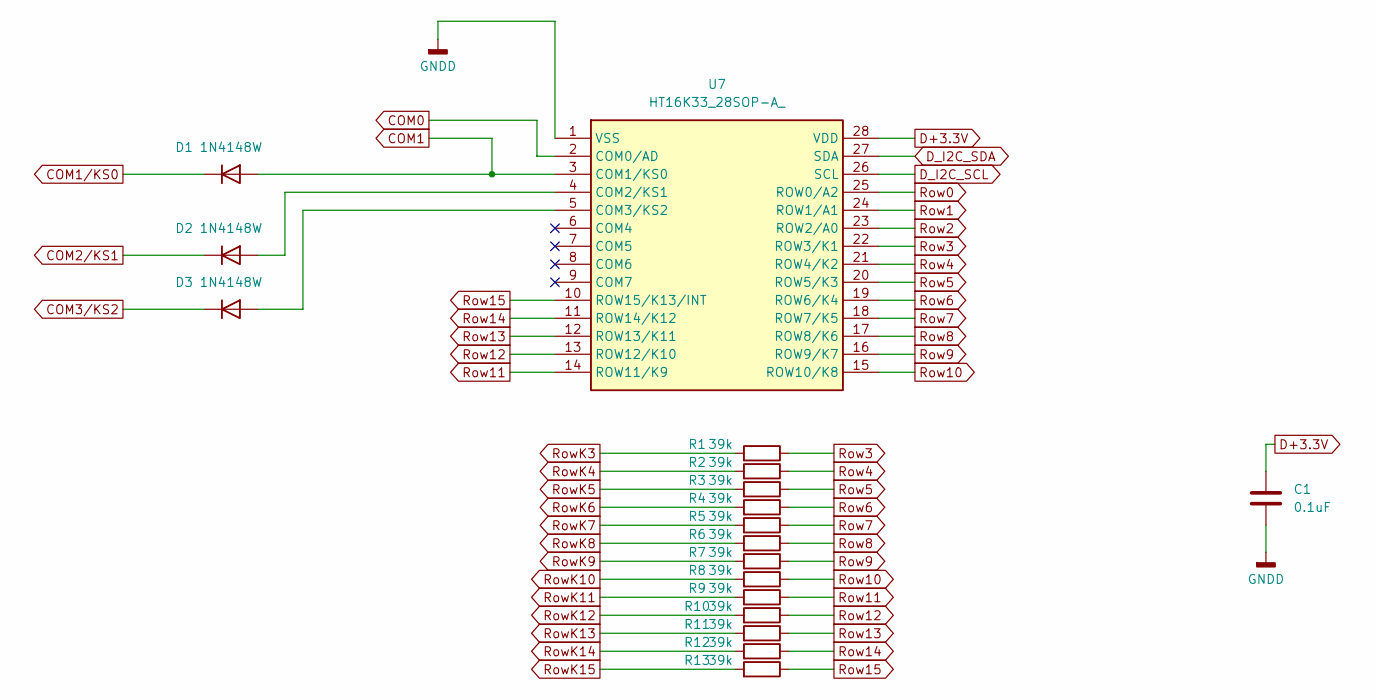
[picture p104: schematic HT16K33.kicad_sch]

Parts:
C1: 0.1uF; C_0603_1608Metric_Pad1.08x0.95mm_HandSolder
D1, D2, D3: 1N4148W; D_SOD-123
R1, R2, R3, R4, R5, R6, R7, R8, R9, R10, R11, R12, R13: 39k; R_0603_1608Metric_Pad0.98x0.95mm_HandSolder
U7: HT16K33_28SOP-A_; SOIC127P1031X264-28N; Manufacturer_Part_Number HT16K33(28SOP-A)

Connections:
COM0: U7.2 (COM0/AD); also elsewhere on the board
COM1: D1.2 (A), U7.3 (COM1/KS0); also elsewhere on the board
COM1/KS0: D1.1 (K); also elsewhere on the board
COM2/KS1: D2.1 (K); also elsewhere on the board
COM3/KS2: D3.1 (K); also elsewhere on the board
D+3.3V: C1.1, U7.28 (VDD); also elsewhere on the board
D_I2C_SCL: U7.26 (SCL); also elsewhere on the board
D_I2C_SDA: U7.27 (SDA); also elsewhere on the board
GNDD: C1.2, U7.1 (VSS); also elsewhere on the board
unnamed: D2.2 (A), U7.4 (COM2/KS1)
unnamed: D3.2 (A), U7.5 (COM3/KS2)
Row0: U7.25 (ROW0/A2); also elsewhere on the board
Row1: U7.24 (ROW1/A1); also elsewhere on the board
Row2: U7.23 (ROW2/A0); also elsewhere on the board
Row3: R1.1, U7.22 (ROW3/K1); also elsewhere on the board
Row4: R2.1, U7.21 (ROW4/K2); also elsewhere on the board
Row5: R3.1, U7.20 (ROW5/K3); also elsewhere on the board
Row6: R4.1, U7.19 (ROW6/K4); also elsewhere on the board
Row7: R5.1, U7.18 (ROW7/K5); also elsewhere on the board
Row8: R6.1, U7.17 (ROW8/K6); also elsewhere on the board
Row9: R7.1, U7.16 (ROW9/K7); also elsewhere on the board
Row10: R8.1, U7.15 (ROW10/K8); also elsewhere on the board
Row11: R9.1, U7.14 (ROW11/K9); also elsewhere on the board
Row12: R10.1, U7.13 (ROW12/K10); also elsewhere on the board
Row13: R11.1, U7.12 (ROW13/K11); also elsewhere on the board
Row14: R12.1, U7.11 (ROW14/K12); also elsewhere on the board
Row15: R13.1, U7.10 (ROW15/K13/INT); also elsewhere on the board
RowK3: R1.2; also elsewhere on the board
RowK4: R2.2; also elsewhere on the board
RowK5: R3.2; also elsewhere on the board
RowK6: R4.2; also elsewhere on the board
RowK7: R5.2; also elsewhere on the board
RowK8: R6.2; also elsewhere on the board
RowK9: R7.2; also elsewhere on the board
RowK10: R8.2; also elsewhere on the board
RowK11: R9.2; also elsewhere on the board
RowK12: R10.2; also elsewhere on the board
RowK13: R11.2; also elsewhere on the board
RowK14: R12.2; also elsewhere on the board
RowK15: R13.2; also elsewhere on the board

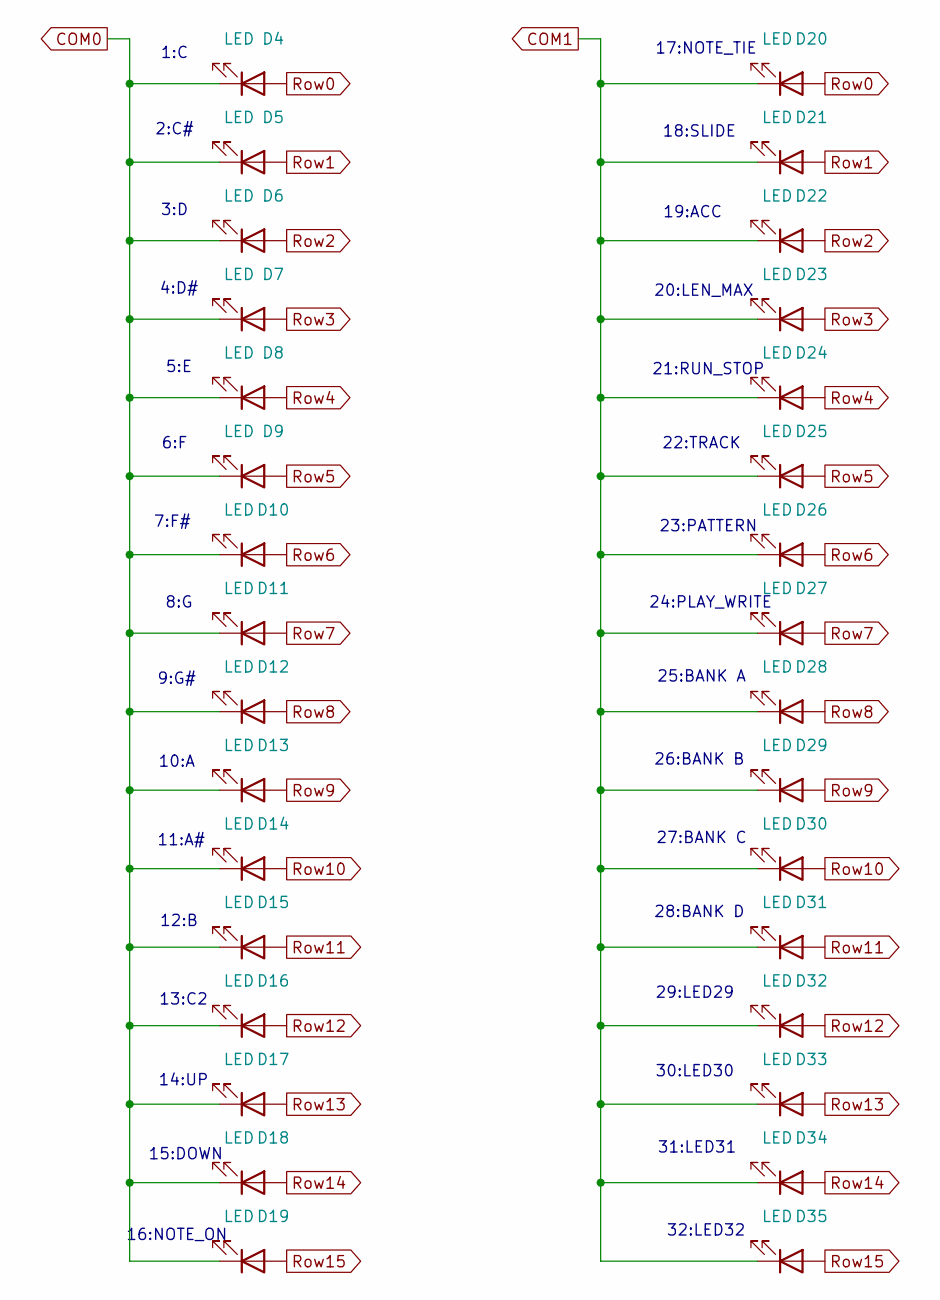
[picture p105: schematic LEDMatrix.kicad_sch]

Parts:
D4, D5, D6, D7, D8, D9, D10, D11, D12, D13, D14, D15, D16, D17, D18, D19, D20, D21, D22, D23, D24, D25, D26, D27, D28, D29, D30, D31, D32, D33, D34, D35: LED; LED_D3.0mm

Connections:
COM0: D4.1 (K), D5.1 (K), D6.1 (K), D7.1 (K), D8.1 (K), D9.1 (K), D10.1 (K), D11.1 (K), D12.1 (K), D13.1 (K), D14.1 (K), D15.1 (K), D16.1 (K), D17.1 (K), D18.1 (K), D19.1 (K); also elsewhere on the board
COM1: D20.1 (K), D21.1 (K), D22.1 (K), D23.1 (K), D24.1 (K), D25.1 (K), D26.1 (K), D27.1 (K), D28.1 (K), D29.1 (K), D30.1 (K), D31.1 (K), D32.1 (K), D33.1 (K), D34.1 (K), D35.1 (K); also elsewhere on the board
Row0: D4.2 (A), D20.2 (A); also elsewhere on the board
Row1: D5.2 (A), D21.2 (A); also elsewhere on the board
Row2: D6.2 (A), D22.2 (A); also elsewhere on the board
Row3: D7.2 (A), D23.2 (A); also elsewhere on the board
Row4: D8.2 (A), D24.2 (A); also elsewhere on the board
Row5: D9.2 (A), D25.2 (A); also elsewhere on the board
Row6: D10.2 (A), D26.2 (A); also elsewhere on the board
Row7: D11.2 (A), D27.2 (A); also elsewhere on the board
Row8: D12.2 (A), D28.2 (A); also elsewhere on the board
Row9: D13.2 (A), D29.2 (A); also elsewhere on the board
Row10: D14.2 (A), D30.2 (A); also elsewhere on the board
Row11: D15.2 (A), D31.2 (A); also elsewhere on the board
Row12: D16.2 (A), D32.2 (A); also elsewhere on the board
Row13: D17.2 (A), D33.2 (A); also elsewhere on the board
Row14: D18.2 (A), D34.2 (A); also elsewhere on the board
Row15: D19.2 (A), D35.2 (A); also elsewhere on the board

Notes on the sheet:
14:UP
18:SLIDE
31:LED31
3:D
28:BANK D
13:C2
32:LED32
21:RUN_STOP
25:BANK A
6:F
15:DOWN
30:LED30
22:TRACK
11:A#
5:E
19:ACC
17:NOTE_TIE
20:LEN_MAX
10:A
29:LED29
12:B
8:G
4:D#
26:BANK B
9:G#
2:C#
1:C
7:F#
27:BANK C
16:NOTE_ON
24:PLAY_WRITE
23:PATTERN

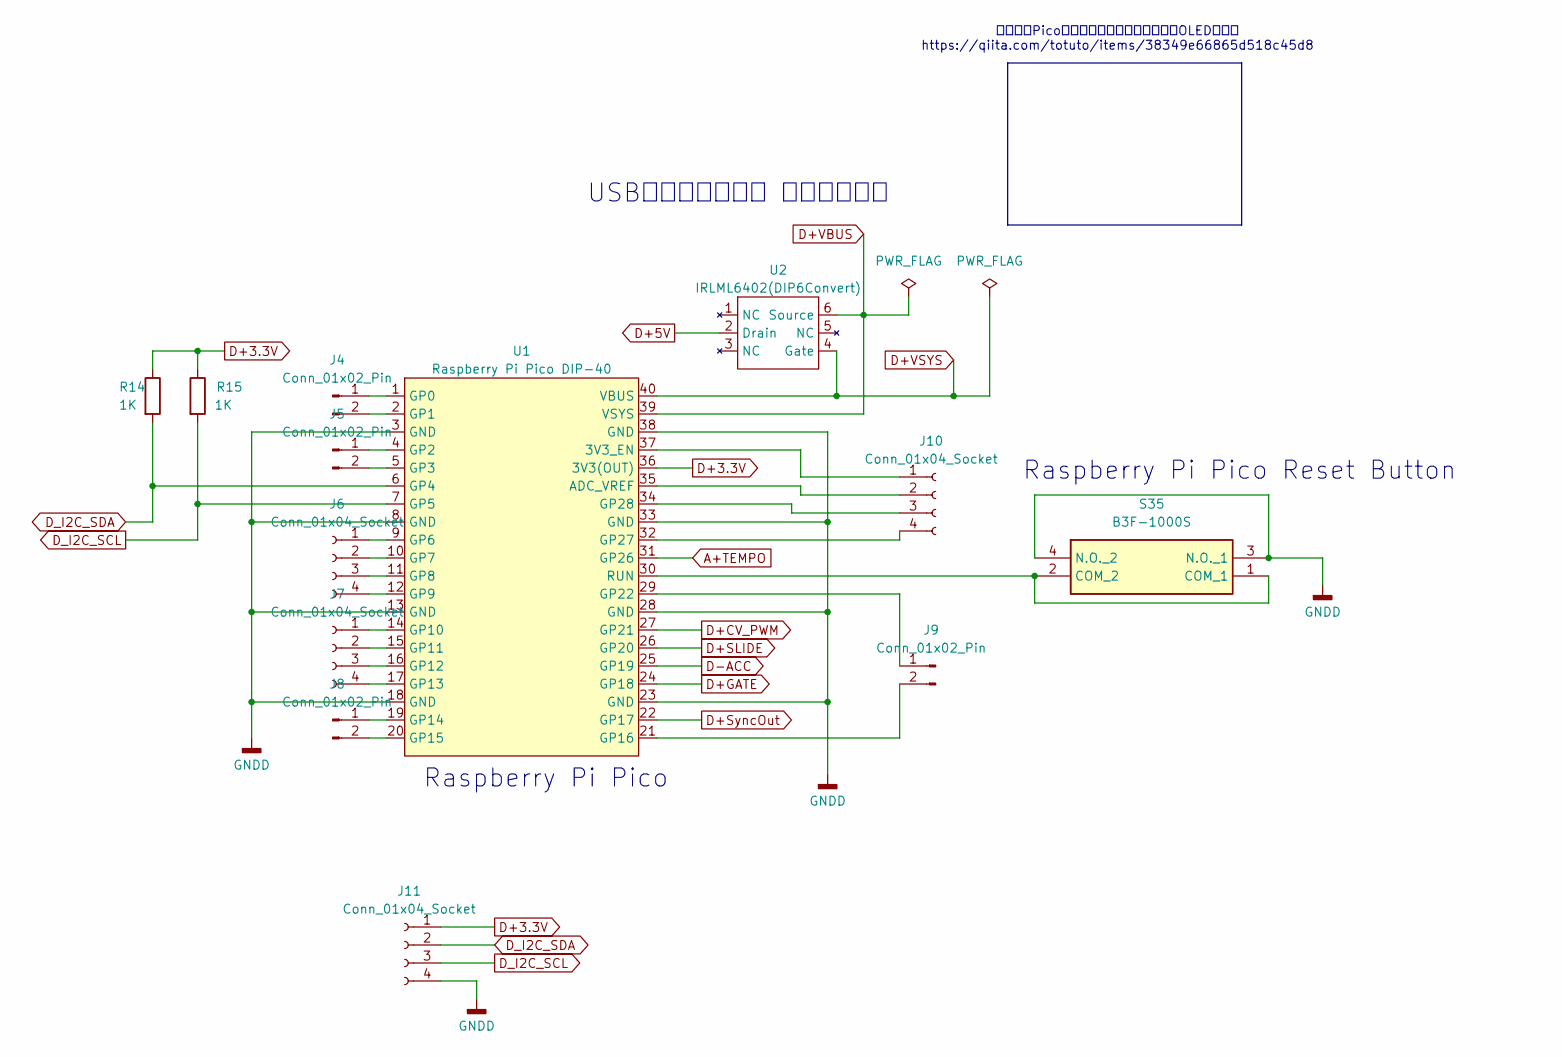
[picture p106: schematic RasPiPico.kicad_sch]

Parts:
J4, J5, J8, J9: Conn_01x02_Pin; PinHeader_1x02_P2.54mm_Vertical
J6, J7, J10, J11: Conn_01x04_Socket; PinHeader_1x04_P2.54mm_Vertical
R14, R15: 1K; R_Axial_DIN0207_L6.3mm_D2.5mm_P7.62mm_Horizontal
S35: B3F-1000S; B3F1060; Manufacturer_Part_Number B3F-1000S; Mouser Part Number 653-B3F-1000-S
U1: Raspberry Pi Pico DIP-40; Raspberry Pi Pico DIP-40_W17.76mm
U2: IRLML6402(DIP6Convert); DIP-6_W7.62mm

Connections:
A+TEMPO: U1.31 (GP26); also elsewhere on the board
D+3.3V: J11.1, R14.1, R15.1, U1.36 (3V3(OUT)); also elsewhere on the board
D+5V: U2.2 (Drain); also elsewhere on the board
D+CV_PWM: U1.27 (GP21); also elsewhere on the board
D+GATE: U1.24 (GP18); also elsewhere on the board
D+SLIDE: U1.26 (GP20); also elsewhere on the board
D+SyncOut: U1.22 (GP17); also elsewhere on the board
D+VBUS: U1.39 (VSYS), U2.6 (Source)
D+VSYS: U1.40 (VBUS), U2.4 (Gate)
D-ACC: U1.25 (GP19); also elsewhere on the board
D_I2C_SCL: J11.3, R15.2, U1.7 (GP5); also elsewhere on the board
D_I2C_SDA: J11.2, R14.2, U1.6 (GP4); also elsewhere on the board
GNDD: J11.4, S35.3 (N.O._1), S35.4 (N.O._2), U1.3 (GND), U1.8 (GND), U1.13 (GND), U1.18 (GND), U1.23 (GND), U1.28 (GND), U1.33 (GND), U1.38 (GND); also elsewhere on the board
unnamed: J4.1, U1.1 (GP0)
unnamed: J4.2, U1.2 (GP1)
unnamed: J5.1, U1.4 (GP2)
unnamed: J5.2, U1.5 (GP3)
unnamed: J6.1, U1.9 (GP6)
unnamed: J6.2, U1.10 (GP7)
unnamed: J6.3, U1.11 (GP8)
unnamed: J6.4, U1.12 (GP9)
unnamed: J7.1, U1.14 (GP10)
unnamed: J7.2, U1.15 (GP11)
unnamed: J7.3, U1.16 (GP12)
unnamed: J7.4, U1.17 (GP13)
unnamed: J8.1, U1.19 (GP14)
unnamed: J8.2, U1.20 (GP15)
unnamed: J9.1, U1.29 (GP22)
unnamed: J9.2, U1.21 (GP16)
unnamed: J10.1, U1.37 (3V3_EN)
unnamed: J10.2, U1.35 (ADC_VREF)
unnamed: J10.3, U1.34 (GP28)
unnamed: J10.4, U1.32 (GP27)
unnamed: S35.1 (COM_1), S35.2 (COM_2), U1.30 (RUN)

Notes on the sheet:
Raspberry Pi Pico
ラズパイPico：電池で動作、電池の電圧をOLEDに表示 https://qiita.com/totuto/items/38349e66865d518c45d8
Raspberry Pi Pico Reset Button
USBコネクタ接続時 電流逆流防止


Parts:
VR1: RK09D117000B; Manufacturer_Part_Number RK09D117000B; Mouser Part Number 688-RK09D117000B

Connections:
A+TEMPO: VR1.2 (WIPER); also elsewhere on the board
D+3.3V: VR1.1 (CCW); also elsewhere on the board
GNDD: VR1.3 (CW), VR1.MH1, VR1.MH2; also elsewhere on the board

Notes on the sheet:
ADC Tempo Volume

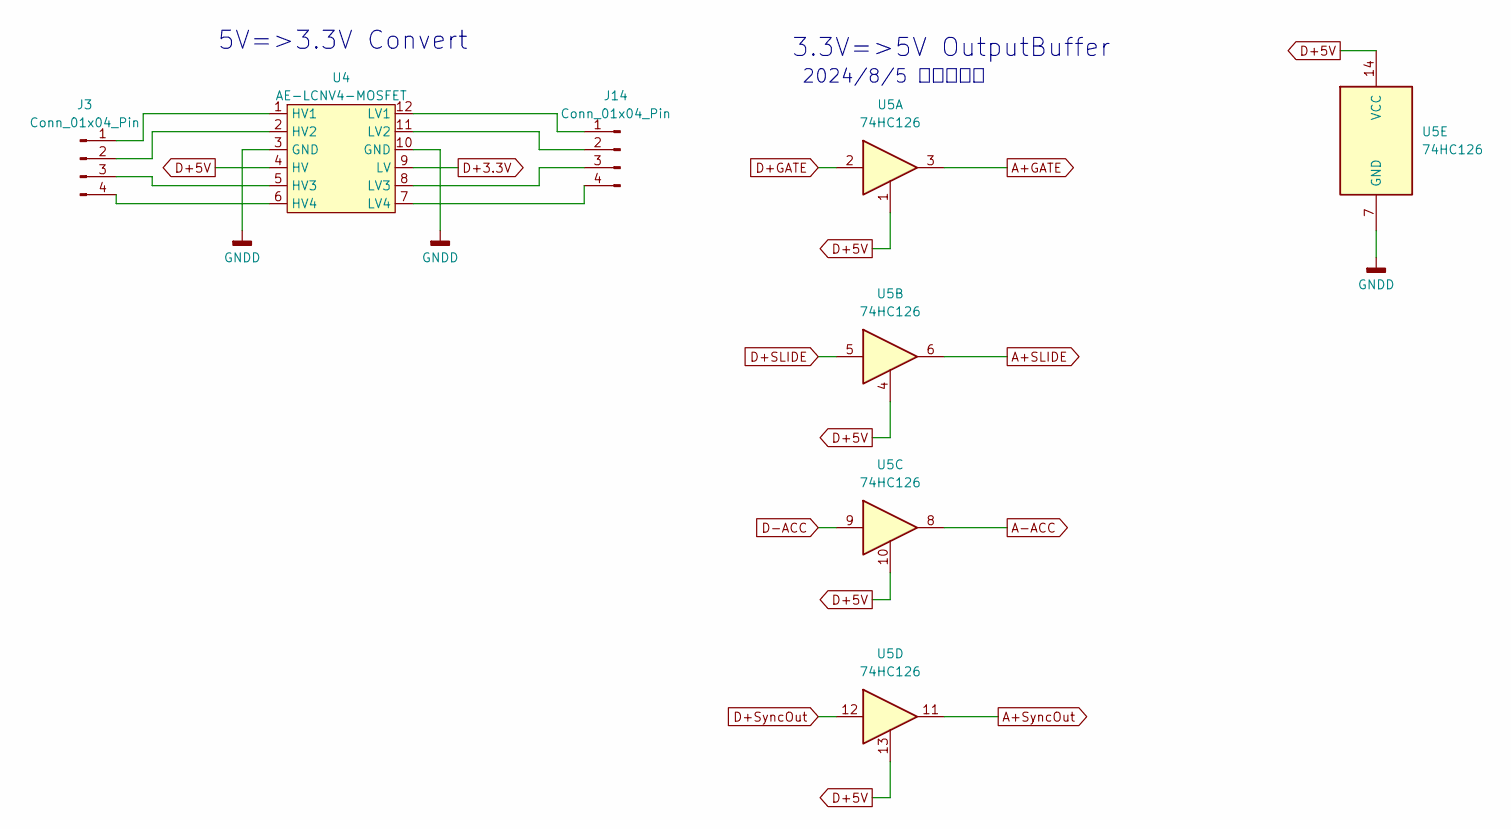
[picture p107: schematic LevelConvert.kicad_sch]

Parts:
J3, J14: Conn_01x04_Pin; PinSocket_1x04_P2.54mm_Vertical
U4: AE-LCNV4-MOSFET; CERDIP-14_W10.16mm_SideBrazed_LongPads_Socket
U5: 74HC126; DIP-14_W7.62mm

Connections:
A+GATE: U5.3; also elsewhere on the board
A+SLIDE: U5.6; also elsewhere on the board
A+SyncOut: U5.11; also elsewhere on the board
A-ACC: U5.8; also elsewhere on the board
D+3.3V: U4.9 (LV); also elsewhere on the board
D+5V: U4.4 (HV), U5.1, U5.4, U5.10, U5.13, U5.14 (VCC); also elsewhere on the board
D+GATE: U5.2; also elsewhere on the board
D+SLIDE: U5.5; also elsewhere on the board
D+SyncOut: U5.12; also elsewhere on the board
D-ACC: U5.9; also elsewhere on the board
GNDD: U4.3 (GND), U4.10 (GND), U5.7 (GND); also elsewhere on the board
unnamed: J3.1, U4.1 (HV1)
unnamed: J3.2, U4.2 (HV2)
unnamed: J3.3, U4.5 (HV3)
unnamed: J3.4, U4.6 (HV4)
unnamed: J14.1, U4.12 (LV1)
unnamed: J14.2, U4.11 (LV2)
unnamed: J14.3, U4.8 (LV3)
unnamed: J14.4, U4.7 (LV4)

Notes on the sheet:
3.3V=>5V OutputBuffer
2024/8/5 動作確認済
5V=>3.3V Convert

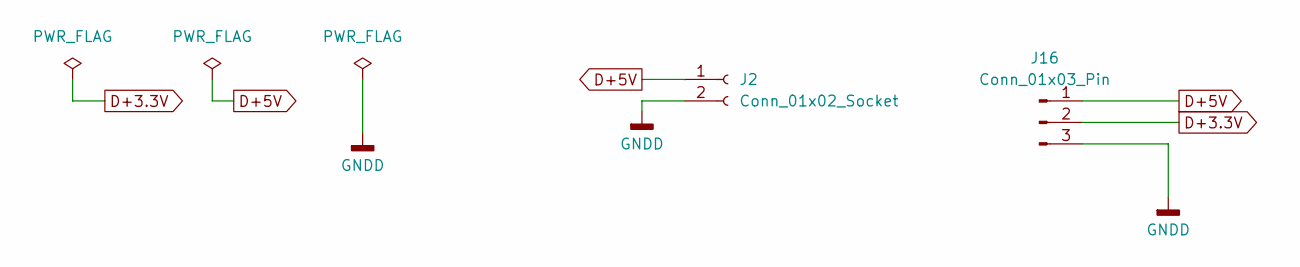
[picture p108: schematic Power.kicad_sch]

Parts:
J2: Conn_01x02_Socket; PinHeader_1x02_P2.54mm_Vertical
J16: Conn_01x03_Pin; PinSocket_1x03_P2.54mm_Vertical

Connections:
D+3.3V: J16.2; also elsewhere on the board
D+5V: J2.1, J16.1; also elsewhere on the board
GNDD: J2.2, J16.3; also elsewhere on the board

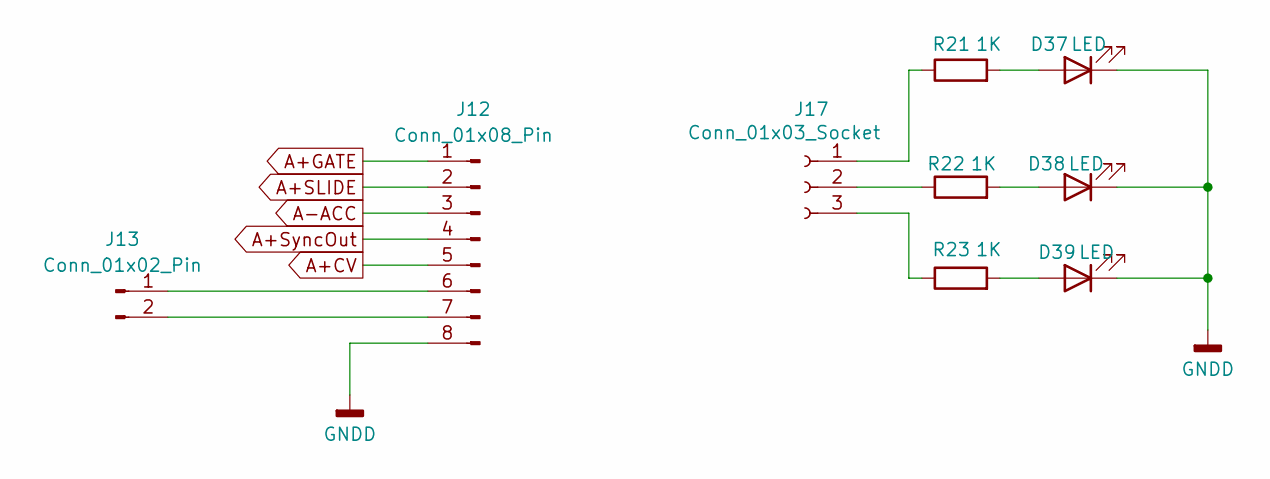
[picture p109: schematic Jack.kicad_sch]

Parts:
D37, D38, D39: LED; LED_D3.0mm
J12: Conn_01x08_Pin; PinHeader_1x08_P2.54mm_Vertical
J13: Conn_01x02_Pin; PinHeader_1x02_P2.54mm_Vertical
J17: Conn_01x03_Socket; PinSocket_1x03_P2.54mm_Vertical
R21, R22, R23: 1K; R_Axial_DIN0204_L3.6mm_D1.6mm_P2.54mm_Vertical

Connections:
A+CV: J12.5; also elsewhere on the board
A+GATE: J12.1; also elsewhere on the board
A+SLIDE: J12.2; also elsewhere on the board
A+SyncOut: J12.4; also elsewhere on the board
A-ACC: J12.3; also elsewhere on the board
GNDD: D37.1 (K), D38.1 (K), D39.1 (K), J12.8; also elsewhere on the board
unnamed: D37.2 (A), R21.2
unnamed: D38.2 (A), R22.2
unnamed: D39.2 (A), R23.2
unnamed: J12.6, J13.1
unnamed: J12.7, J13.2
unnamed: J17.1, R21.1
unnamed: J17.2, R22.1
unnamed: J17.3, R23.1

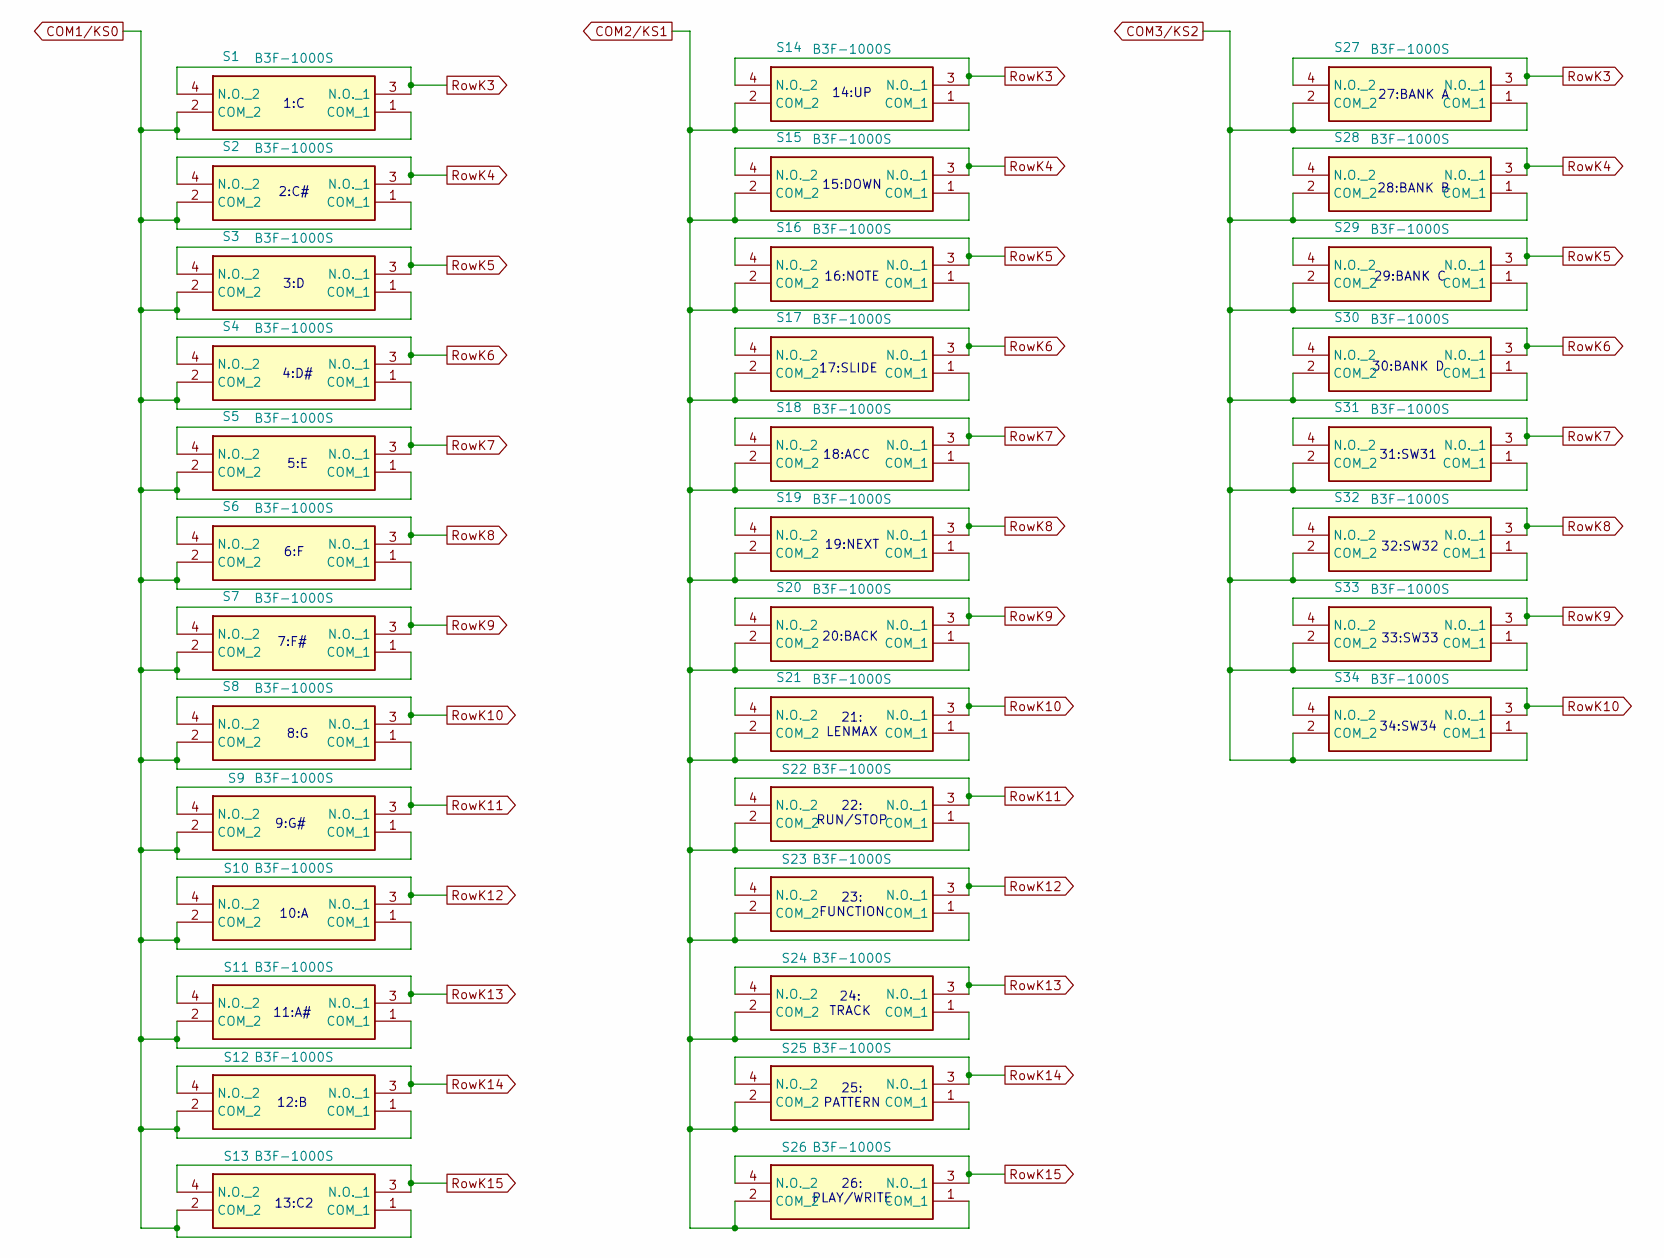
[picture p110: schematic SwitchMatrix.kicad_sch]

Parts:
S1, S2, S3, S4, S5, S6, S7, S8, S9, S10, S11, S12, S13, S14, S15, S16, S17, S18, S19, S20, S21, S22, S23, S24, S25, S26, S27, S28, S29, S30, S31, S32, S33, S34: B3F-1000S; B3F1060; Manufacturer_Part_Number B3F-1000S; Mouser Part Number 653-B3F-1000-S

Connections:
COM1/KS0: S1.1 (COM_1), S1.2 (COM_2), S2.1 (COM_1), S2.2 (COM_2), S3.1 (COM_1), S3.2 (COM_2), S4.1 (COM_1), S4.2 (COM_2), S5.1 (COM_1), S5.2 (COM_2), S6.1 (COM_1), S6.2 (COM_2), S7.1 (COM_1), S7.2 (COM_2), S8.1 (COM_1), S8.2 (COM_2), S9.1 (COM_1), S9.2 (COM_2), S10.1 (COM_1), S10.2 (COM_2), S11.1 (COM_1), S11.2 (COM_2), S12.1 (COM_1), S12.2 (COM_2), S13.1 (COM_1), S13.2 (COM_2); also elsewhere on the board
COM2/KS1: S14.1 (COM_1), S14.2 (COM_2), S15.1 (COM_1), S15.2 (COM_2), S16.1 (COM_1), S16.2 (COM_2), S17.1 (COM_1), S17.2 (COM_2), S18.1 (COM_1), S18.2 (COM_2), S19.1 (COM_1), S19.2 (COM_2), S20.1 (COM_1), S20.2 (COM_2), S21.1 (COM_1), S21.2 (COM_2), S22.1 (COM_1), S22.2 (COM_2), S23.1 (COM_1), S23.2 (COM_2), S24.1 (COM_1), S24.2 (COM_2), S25.1 (COM_1), S25.2 (COM_2), S26.1 (COM_1), S26.2 (COM_2); also elsewhere on the board
COM3/KS2: S27.1 (COM_1), S27.2 (COM_2), S28.1 (COM_1), S28.2 (COM_2), S29.1 (COM_1), S29.2 (COM_2), S30.1 (COM_1), S30.2 (COM_2), S31.1 (COM_1), S31.2 (COM_2), S32.1 (COM_1), S32.2 (COM_2), S33.1 (COM_1), S33.2 (COM_2), S34.1 (COM_1), S34.2 (COM_2); also elsewhere on the board
RowK3: S1.3 (N.O._1), S1.4 (N.O._2), S14.3 (N.O._1), S14.4 (N.O._2), S27.3 (N.O._1), S27.4 (N.O._2); also elsewhere on the board
RowK4: S2.3 (N.O._1), S2.4 (N.O._2), S15.3 (N.O._1), S15.4 (N.O._2), S28.3 (N.O._1), S28.4 (N.O._2); also elsewhere on the board
RowK5: S3.3 (N.O._1), S3.4 (N.O._2), S16.3 (N.O._1), S16.4 (N.O._2), S29.3 (N.O._1), S29.4 (N.O._2); also elsewhere on the board
RowK6: S4.3 (N.O._1), S4.4 (N.O._2), S17.3 (N.O._1), S17.4 (N.O._2), S30.3 (N.O._1), S30.4 (N.O._2); also elsewhere on the board
RowK7: S5.3 (N.O._1), S5.4 (N.O._2), S18.3 (N.O._1), S18.4 (N.O._2), S31.3 (N.O._1), S31.4 (N.O._2); also elsewhere on the board
RowK8: S6.3 (N.O._1), S6.4 (N.O._2), S19.3 (N.O._1), S19.4 (N.O._2), S32.3 (N.O._1), S32.4 (N.O._2); also elsewhere on the board
RowK9: S7.3 (N.O._1), S7.4 (N.O._2), S20.3 (N.O._1), S20.4 (N.O._2), S33.3 (N.O._1), S33.4 (N.O._2); also elsewhere on the board
RowK10: S8.3 (N.O._1), S8.4 (N.O._2), S21.3 (N.O._1), S21.4 (N.O._2), S34.3 (N.O._1), S34.4 (N.O._2); also elsewhere on the board
RowK11: S9.3 (N.O._1), S9.4 (N.O._2), S22.3 (N.O._1), S22.4 (N.O._2); also elsewhere on the board
RowK12: S10.3 (N.O._1), S10.4 (N.O._2), S23.3 (N.O._1), S23.4 (N.O._2); also elsewhere on the board
RowK13: S11.3 (N.O._1), S11.4 (N.O._2), S24.3 (N.O._1), S24.4 (N.O._2); also elsewhere on the board
RowK14: S12.3 (N.O._1), S12.4 (N.O._2), S25.3 (N.O._1), S25.4 (N.O._2); also elsewhere on the board
RowK15: S13.3 (N.O._1), S13.4 (N.O._2), S26.3 (N.O._1), S26.4 (N.O._2); also elsewhere on the board

Notes on the sheet:
4:D#
13:C2
11:A#
1:C
19:NEXT
10:A
27:BANK A
5:E
14:UP
2:C#
18:ACC
24: TRACK
16:NOTE
3:D
7:F#
31:SW31
8:G
6:F
32:SW32
21: LENMAX
26: PLAY/WRITE
17:SLIDE
23: FUNCTION
34:SW34
9:G#
25: PATTERN
29:BANK C
12:B
22: RUN/STOP
20:BACK
33:SW33
15:DOWN
30:BANK D
28:BANK B
