wakimizufu/TBSEQ/TBSEQ_Board_V1/HT16K33Panel/HT16K33Panel/HT16K33Panel.kicad_pcb

## KiCad design TBSEQ_Board_V1/HT16K33Panel/HT16K33Panel/HT16K33Panel.kicad_pcb (continued)

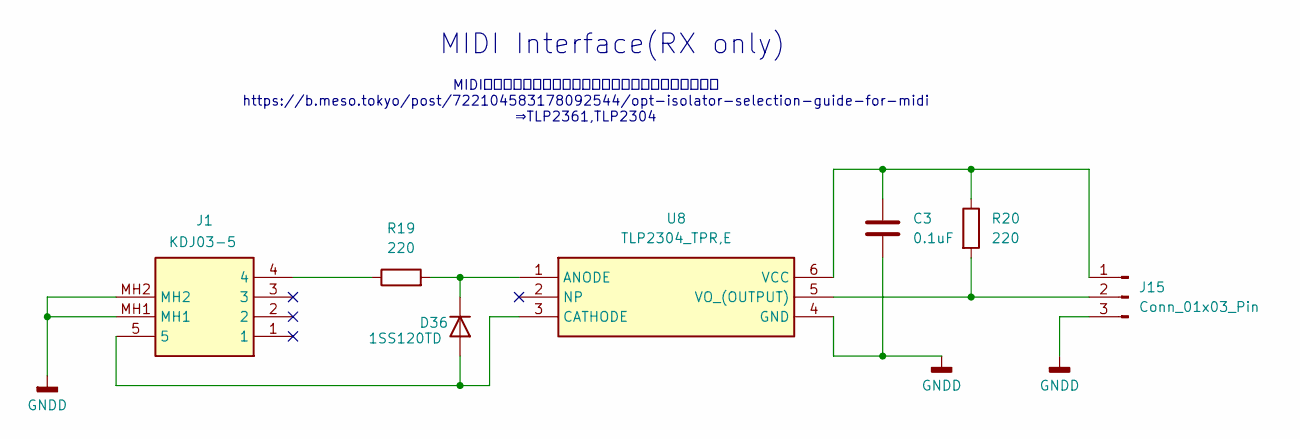
[picture p111: schematic MIDI_RX.kicad_sch]

Parts:
C3: 0.1uF; C_Rect_L7.0mm_W2.0mm_P5.00mm
D36: 1SS120TD; D_A-405_P2.54mm_Vertical_AnodeUp
J1: KDJ03-5; KDJ035; Manufacturer_Part_Number KDJ03-5
J15: Conn_01x03_Pin; PinHeader_1x03_P2.54mm_Vertical
R19, R20: 220; R_Axial_DIN0207_L6.3mm_D2.5mm_P7.62mm_Horizontal
U8: TLP2304_TPR,E; SOIC127P700X230-6N; Manufacturer_Part_Number TLP2304(TPR,E; Mouser Part Number 757-TLP2304TPRE

Connections:
GNDD: C3.2, J1.MH1, J1.MH2, J15.3, U8.4 (GND); also elsewhere on the board
unnamed: D36.2 (A), J1.5, U8.3 (CATHODE)
unnamed: D36.1 (K), R19.2, U8.1 (ANODE)
unnamed: J1.4, R19.1
unnamed: C3.1, J15.1, R20.1, U8.6 (VCC)
unnamed: J15.2, R20.2, U8.5 (VO_(OUTPUT))

Notes on the sheet:
MIDI Interface(RX only)
MIDI送受信回路で使うオプトアイソレータはどれが良い？ https://b.meso.tokyo/post/722104583178092544/opt-isolator-selection-guide-for-midi ⇒TLP2361,TLP2304

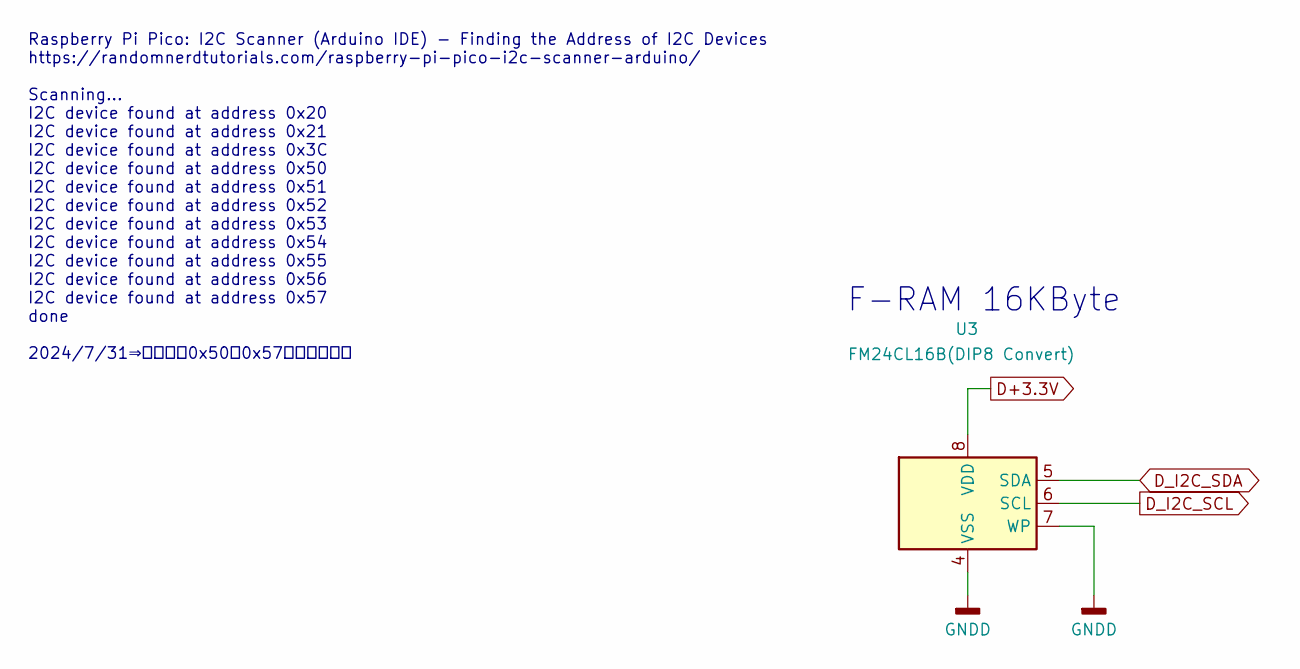
[picture p112: schematic FRAM.kicad_sch]

Parts:
U3: FM24CL16B(DIP8 Convert); CERDIP-8_W7.62mm_SideBrazed_Socket

Connections:
D+3.3V: U3.8 (VDD); also elsewhere on the board
D_I2C_SCL: U3.6 (SCL); also elsewhere on the board
D_I2C_SDA: U3.5 (SDA); also elsewhere on the board
GNDD: U3.4 (VSS), U3.7 (WP); also elsewhere on the board

Notes on the sheet:
F-RAM 16KByte
Raspberry Pi Pico: I2C Scanner (Arduino IDE) - Finding the Address of I2C Devices https://randomnerdtutorials.com/raspberry-pi-pico-i2c-scanner-arduino/ Scanning... I2C device found at address 0x20 I2C device found at address 0x21 I2C device found at address 0x3C I2C device found at address 0x50 I2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

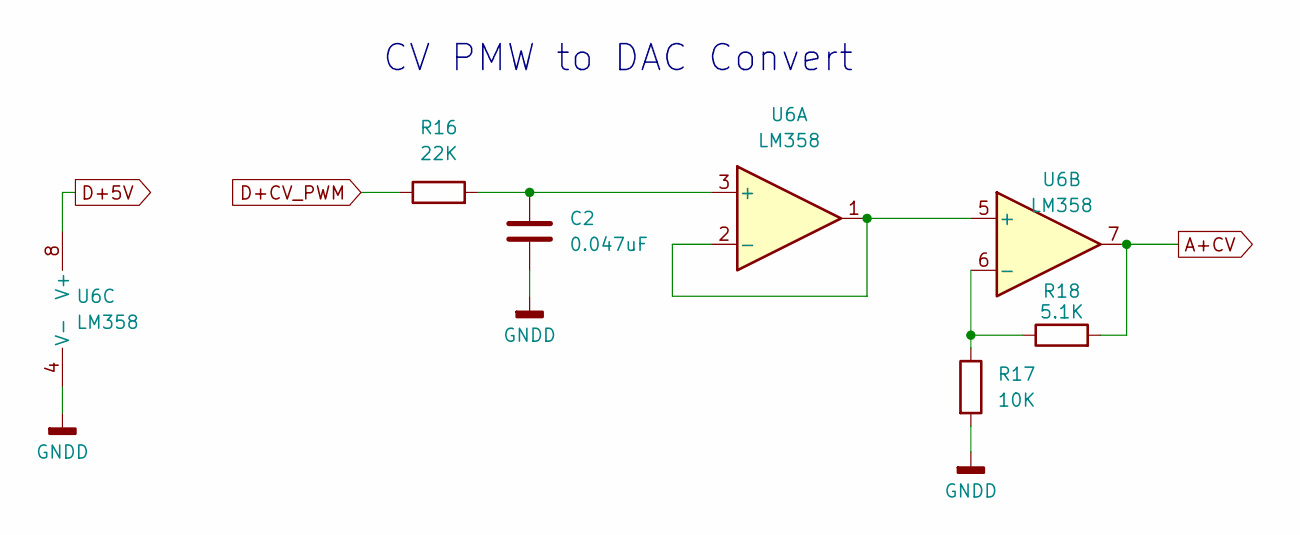
[picture p113: schematic CV.kicad_sch]

Parts:
C2: 0.047uF; C_Rect_L7.0mm_W2.5mm_P5.00mm
R16: 22K; R_Axial_DIN0207_L6.3mm_D2.5mm_P7.62mm_Horizontal
R17: 10K; R_Axial_DIN0207_L6.3mm_D2.5mm_P7.62mm_Horizontal
R18: 5.1K; R_Axial_DIN0207_L6.3mm_D2.5mm_P7.62mm_Horizontal
U6: LM358; DIP-8_W7.62mm

Connections:
A+CV: R18.2, U6.7; also elsewhere on the board
D+5V: U6.8 (V+); also elsewhere on the board
D+CV_PWM: R16.1; also elsewhere on the board
GNDD: C2.2, R17.2, U6.4 (V-); also elsewhere on the board
unnamed: C2.1, R16.2, U6.3 (+)
unnamed: U6.1, U6.2 (-), U6.5 (+)
unnamed: R17.1, R18.1, U6.6 (-)

Notes on the sheet:
CV PMW to DAC Convert

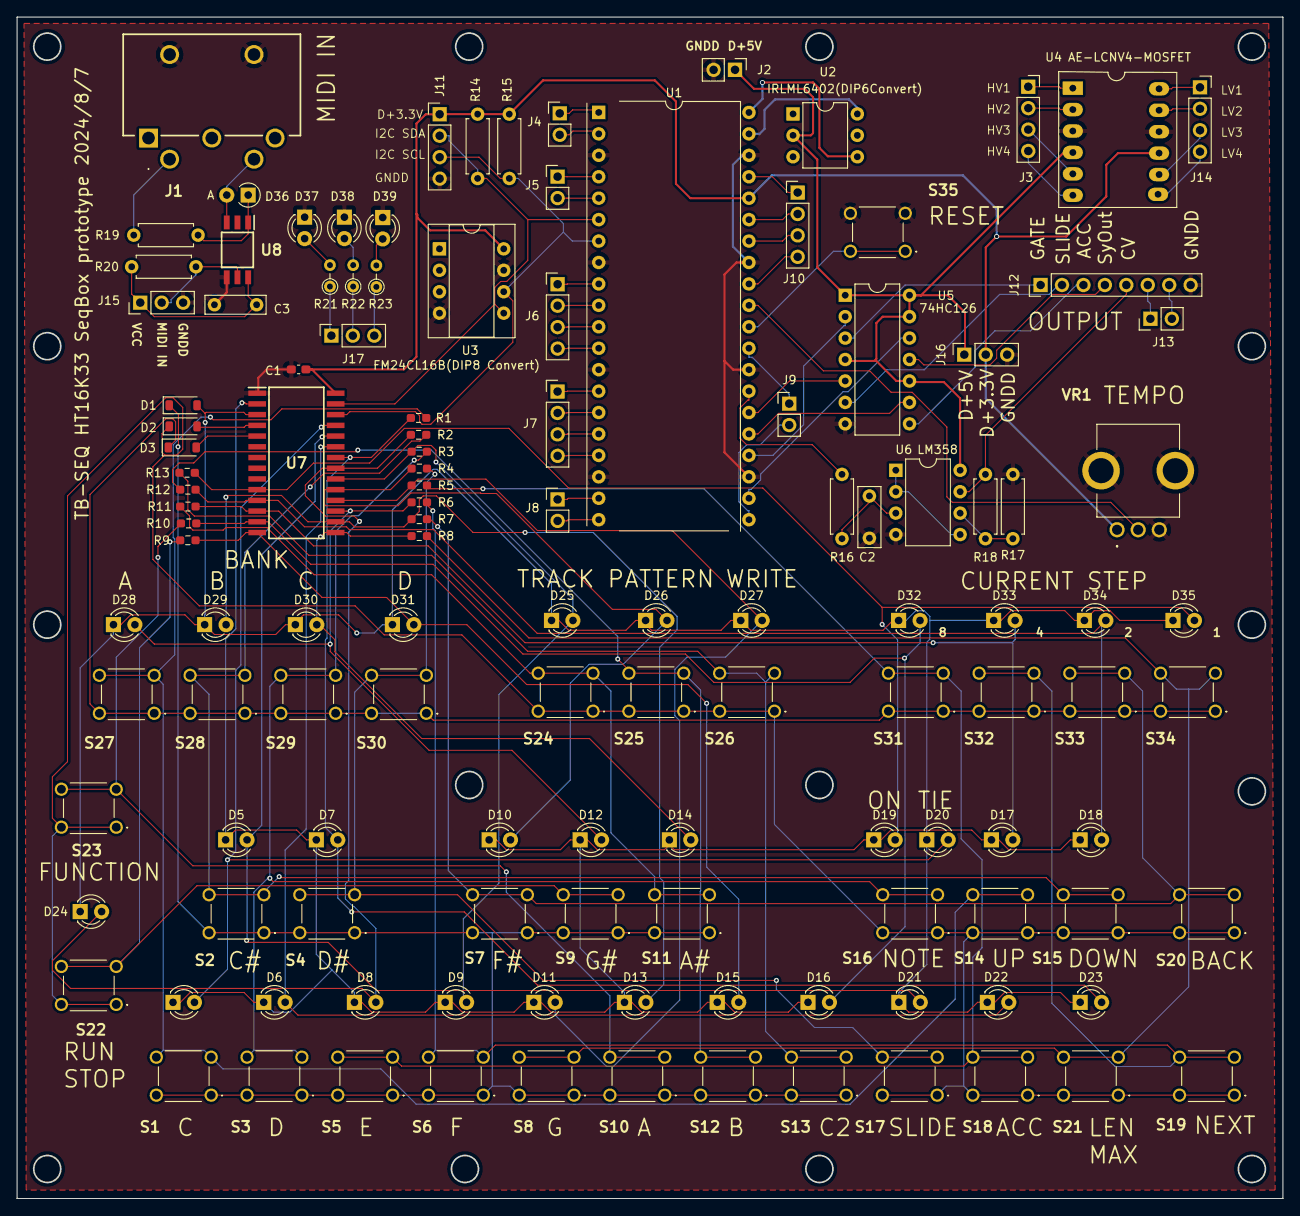
[picture p114: board HT16K33Panel.kicad_pcb from above]

Board: 2 copper layers, 150.0 x 140.0 mm, 126 parts (0 on the bottom side), 99 nets.
