wakimizufu/TBSEQ/TBSEQ_Board_V1/powersupply/powersupply/powersupply.kicad_pcb

## KiCad design TBSEQ_Board_V1/powersupply/powersupply/powersupply.kicad_pcb (2024-07-31, an earlier design)

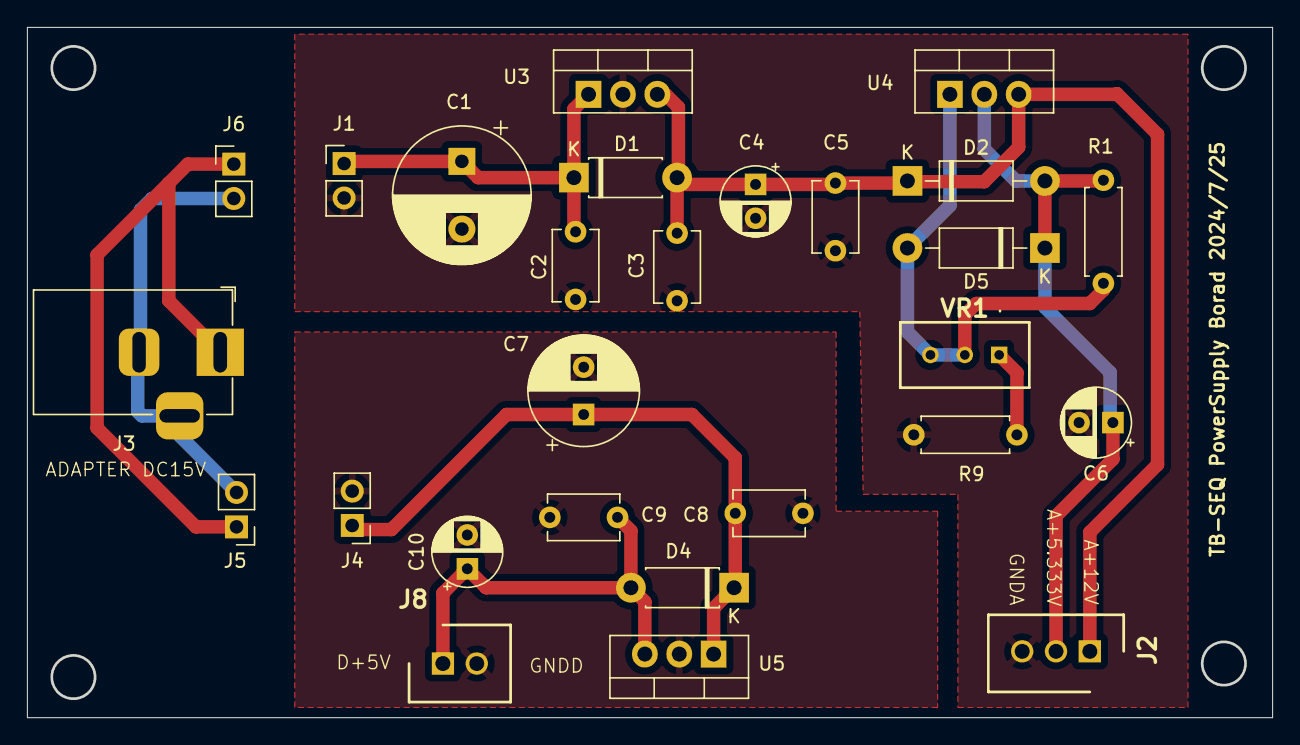
[picture p115: board powersupply.kicad_pcb from above]

Board: 2 copper layers, 92.0 x 51.0 mm, 27 parts (0 on the bottom side), 9 nets.

Parts:
C1: 1000uF/25V; CP_Radial_D10.0mm_P5.00mm
C2, C3, C5, C8, C9: 0.1uF; C_Disc_D5.1mm_W3.2mm_P5.00mm
C4, C10: 100uF/25V; CP_Radial_D5.0mm_P2.50mm
C6: 1uF/25V; CP_Radial_D5.0mm_P2.50mm
C7: 470uF/25V; CP_Radial_D8.0mm_P3.50mm
D1, D4: SBM245L; D_DO-41_SOD81_P7.62mm_Horizontal
D2, D5: 1N4001; D_DO-41_SOD81_P10.16mm_Horizontal
J1, J4, J5, J6: Conn_01x02_Pin; PinHeader_1x02_P2.54mm_Vertical
J2: DF1BZ-3P-2.5DS; SHDR3W64P0X250_1X3_1000X570X950P
J3: Barrel_Jack_Switch; BarrelJack_Horizontal
J8: DF1BZ-2P-2.5DSA; SHDR2W64P0X250_1X2_750X570X950P
R1: 120; R_Axial_DIN0207_L6.3mm_D2.5mm_P7.62mm_Horizontal
R9: 330; R_Axial_DIN0207_L6.3mm_D2.5mm_P7.62mm_Horizontal
U3: L7812; TO-220-3_Vertical
U4: LM317_TO-220; TO-220-3_Vertical
U5: L7805; TO-220-3_Vertical
VR1: 3296W-1-502A; 3296W1502A

Connections:
A+5.333V: C6.1, D2.2 (A), D5.1 (K), J2.2, R1.1, U4.2 (VO)
A+12V: C3.1, C4.1, C5.1, D1.2 (A), D2.1 (K), J2.1, U3.3 (OUT), U4.3 (VI)
ADAPTER GND: J3.2, J3.3, J5.2, J6.2
ADAPTER+15V: J3.1, J5.1, J6.1
D+5V: C9.1, C10.1, D4.2 (A), J8.1, U5.3 (OUT)
GNDA: C1.2, C2.2, C3.2, C4.2, C5.2, C6.2, J1.2, J2.3, R9.2, U3.2 (GND)
GNDD: C7.2, C8.2, C9.2, C10.2, J4.2, J8.2, U5.2 (GND)
unnamed: C7.1, C8.1, D4.1 (K), J4.1, U5.1 (IN)
unnamed: D5.2 (A), R1.2, U4.1 (ADJ), VR1.2 (WIPER), VR1.3 (CW)
