wakimizufu/TBSEQ/TBSEQ_Board_V1/controll/controll.kicad_pcb

## KiCad design TBSEQ_Board_V1/controll/controll.kicad_pcb (2024-07-31, an earlier design)

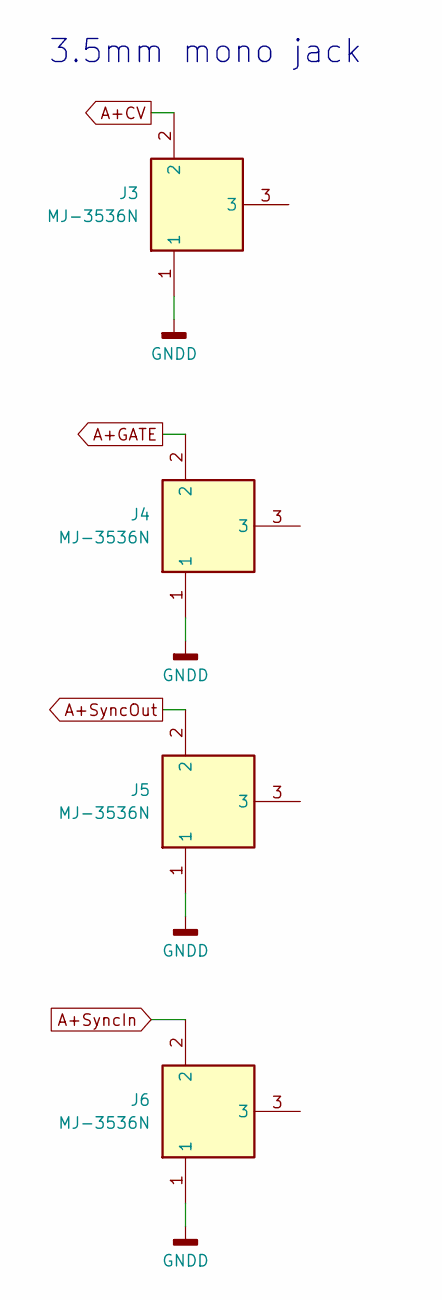
[picture p116: schematic Jack.kicad_sch]

Parts:
J3, J4, J5, J6: MJ-3536N; MJ3536N; Manufacturer_Part_Number MJ-3536N; Mouser Part Number 490-MJ-3536N

Connections:
GNDD: J3.1, J4.1, J5.1, J6.1; also elsewhere on the board

Notes on the sheet:
3.5mm mono jack

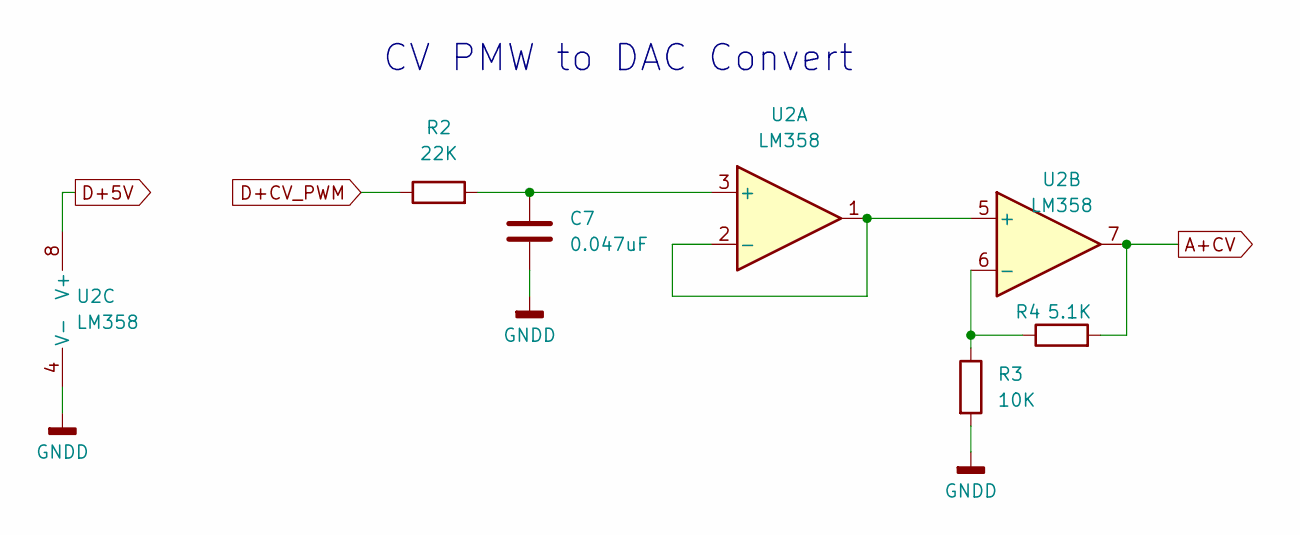
[picture p117: schematic CV.kicad_sch]

Parts:
C7: 0.047uF; C_Rect_L7.0mm_W2.5mm_P5.00mm
R2: 22K; R_Axial_DIN0207_L6.3mm_D2.5mm_P7.62mm_Horizontal
R3: 10K; R_Axial_DIN0207_L6.3mm_D2.5mm_P7.62mm_Horizontal
R4: 5.1K; R_Axial_DIN0207_L6.3mm_D2.5mm_P7.62mm_Horizontal
U2: LM358; DIP-8_W7.62mm

Connections:
D+5V: U2.8 (V+); also elsewhere on the board
D+CV_PWM: R2.1; also elsewhere on the board
GNDD: C7.2, R3.2, U2.4 (V-); also elsewhere on the board
unnamed 127: C7.1, R2.2, U2.3 (+); also elsewhere on the board
unnamed: U2.1, U2.2 (-), U2.5 (+)
unnamed: R3.1, R4.1, U2.6 (-)

Notes on the sheet:
CV PMW to DAC Convert

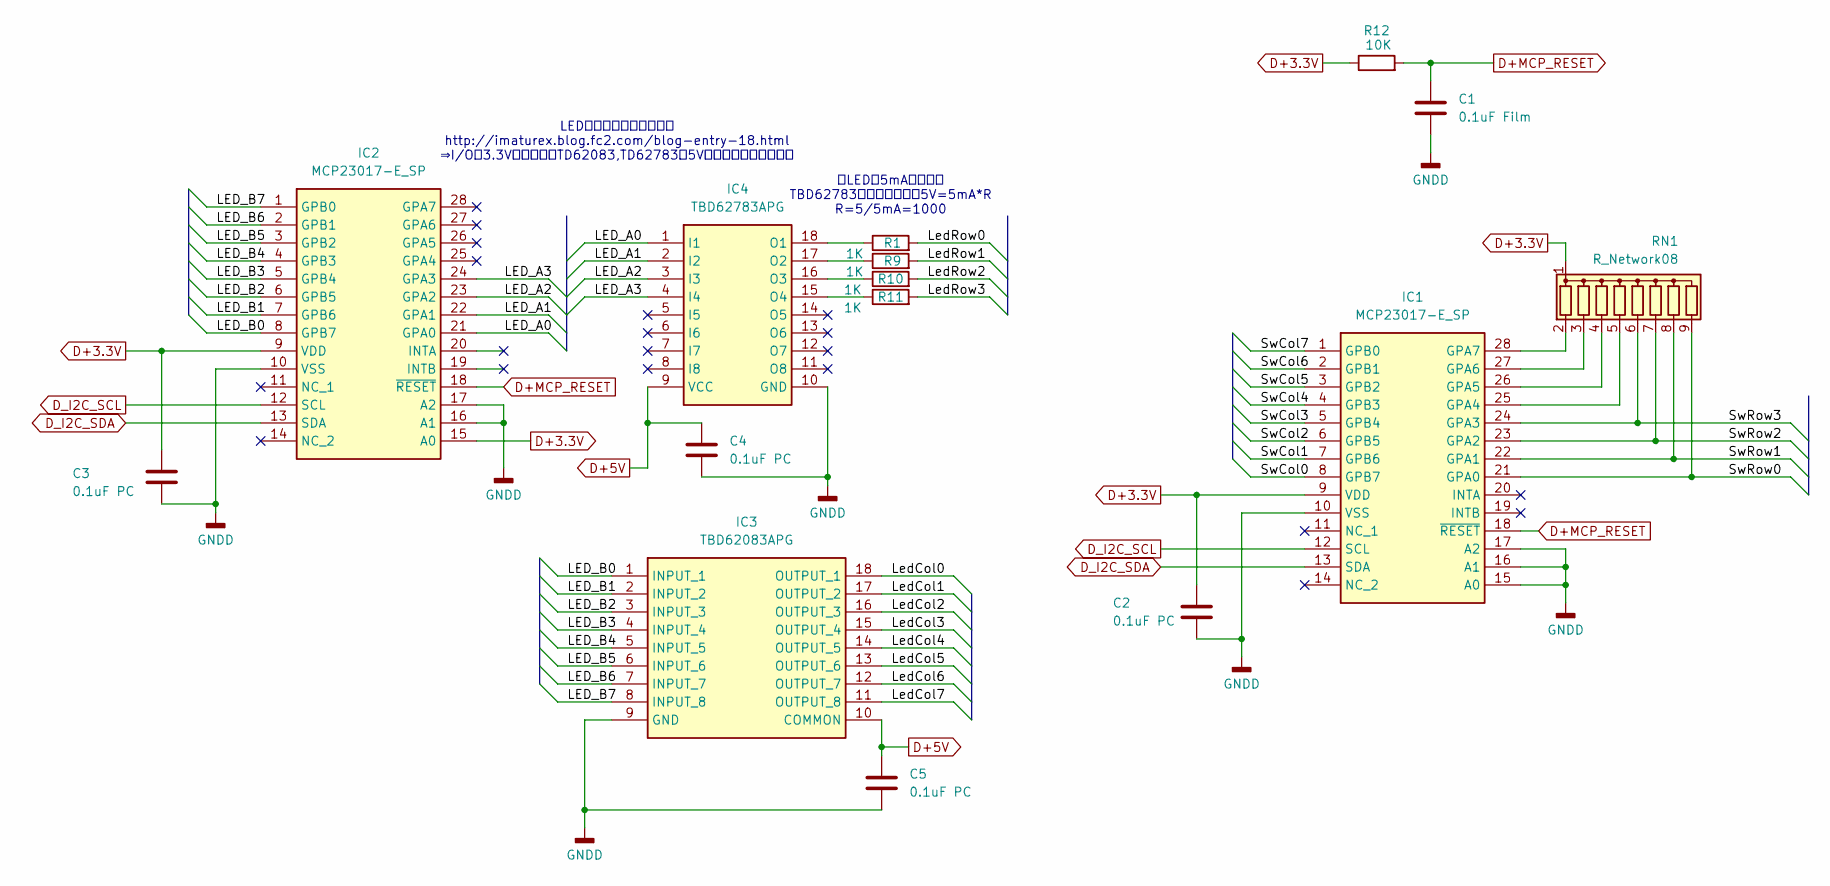
[picture p118: schematic SwitchBox.kicad_sch]

Parts:
C1: 0.1uF Film; C_Rect_L7.2mm_W2.5mm_P5.00mm_FKS2_FKP2_MKS2_MKP2
C2, C3, C4, C5: 0.1uF PC; C_Disc_D5.1mm_W3.2mm_P5.00mm
IC1, IC2: MCP23017-E_SP; DIP794W56P254L3486H508Q28N; Manufacturer_Part_Number MCP23017-E/SP; Mouser Part Number 579-MCP23017-E/SP
IC3: TBD62083APG; DIP926W55P254L2286H480Q18N; Manufacturer_Part_Number TBD62083APG; Mouser Part Number 757-TBD62083APG
IC4: TBD62783APG; DIP762W55P254L2286H480Q18N; Manufacturer_Part_Number TBD62783APG; Mouser Part Number 757-TBD62783APG
R1, R9, R10, R11: 1K; R_Axial_DIN0207_L6.3mm_D2.5mm_P7.62mm_Horizontal
R12: 10K; R_Axial_DIN0207_L6.3mm_D2.5mm_P7.62mm_Horizontal
RN1: R_Network08; R_Array_SIP9

Connections:
/SwitchBox/LED_A0: IC2.21 (GPA0), IC4.1 (I1)
/SwitchBox/LED_A1: IC2.22 (GPA1), IC4.2 (I2)
/SwitchBox/LED_A2: IC2.23 (GPA2), IC4.3 (I3)
/SwitchBox/LED_A3: IC2.24 (GPA3), IC4.4 (I4)
/SwitchBox/LED_B0: IC2.8 (GPB7), IC3.1 (INPUT_1)
/SwitchBox/LED_B1: IC2.7 (GPB6), IC3.2 (INPUT_2)
/SwitchBox/LED_B2: IC2.6 (GPB5), IC3.3 (INPUT_3)
/SwitchBox/LED_B3: IC2.5 (GPB4), IC3.4 (INPUT_4)
/SwitchBox/LED_B4: IC2.4 (GPB3), IC3.5 (INPUT_5)
/SwitchBox/LED_B5: IC2.3 (GPB2), IC3.6 (INPUT_6)
/SwitchBox/LED_B6: IC2.2 (GPB1), IC3.7 (INPUT_7)
/SwitchBox/LED_B7: IC2.1 (GPB0), IC3.8 (INPUT_8)
/SwitchBox/LedCol0: IC3.18 (OUTPUT_1)
/SwitchBox/LedCol1: IC3.17 (OUTPUT_2)
/SwitchBox/LedCol2: IC3.16 (OUTPUT_3)
/SwitchBox/LedCol3: IC3.15 (OUTPUT_4)
/SwitchBox/LedCol4: IC3.14 (OUTPUT_5)
/SwitchBox/LedCol5: IC3.13 (OUTPUT_6)
/SwitchBox/LedCol6: IC3.12 (OUTPUT_7)
/SwitchBox/LedCol7: IC3.11 (OUTPUT_8)
/SwitchBox/LedRow0: R1.2
/SwitchBox/LedRow1: R9.2
/SwitchBox/LedRow2: R10.2
/SwitchBox/LedRow3: R11.2
/SwitchBox/SwCol0: IC1.8 (GPB7)
/SwitchBox/SwCol1: IC1.7 (GPB6)
/SwitchBox/SwCol2: IC1.6 (GPB5)
/SwitchBox/SwCol3: IC1.5 (GPB4)
/SwitchBox/SwCol4: IC1.4 (GPB3)
/SwitchBox/SwCol5: IC1.3 (GPB2)
/SwitchBox/SwCol6: IC1.2 (GPB1)
/SwitchBox/SwCol7: IC1.1 (GPB0)
/SwitchBox/SwRow0: IC1.21 (GPA0), RN1.9 (R8)
/SwitchBox/SwRow1: IC1.22 (GPA1), RN1.8 (R7)
/SwitchBox/SwRow2: IC1.23 (GPA2), RN1.7 (R6)
/SwitchBox/SwRow3: IC1.24 (GPA3), RN1.6 (R5)
D+3.3V: C2.1, C3.1, IC1.9 (VDD), IC2.9 (VDD), IC2.15 (A0), R12.1, RN1.1 (common); also elsewhere on the board
D+5V: C4.1, C5.1, IC3.10 (COMMON), IC4.9 (VCC); also elsewhere on the board
D+MCP_RESET: C1.1, IC1.18 (~RESET), IC2.18 (~RESET), R12.2
D_I2C_SCL: IC1.12 (SCL), IC2.12 (SCL); also elsewhere on the board
D_I2C_SDA: IC1.13 (SDA), IC2.13 (SDA); also elsewhere on the board
GNDD: C1.2, C2.2, C3.2, C4.2, C5.2, IC1.10 (VSS), IC1.15 (A0), IC1.16 (A1), IC1.17 (A2), IC2.10 (VSS), IC2.16 (A1), IC2.17 (A2), IC3.9 (GND), IC4.10 (GND); also elsewhere on the board
unnamed: IC1.25 (GPA4), RN1.5 (R4)
unnamed: IC1.26 (GPA5), RN1.4 (R3)
unnamed: IC1.27 (GPA6), RN1.3 (R2)
unnamed: IC1.28 (GPA7), RN1.2 (R1)
unnamed: IC4.18 (O1), R1.1
unnamed: IC4.17 (O2), R9.1
unnamed: IC4.16 (O3), R10.1
unnamed: IC4.15 (O4), R11.1

Notes on the sheet:
LEDキューブのテスト回路 http://imaturex.blog.fc2.com/blog-entry-18.html ⇒I/Oは3.3V系統だが、TD62083,TD62783は5Vで駆動する必要がある
・LEDに5mA流す場合 TBD62783を通過したので5V=5mA*R R=5/5mA=1000

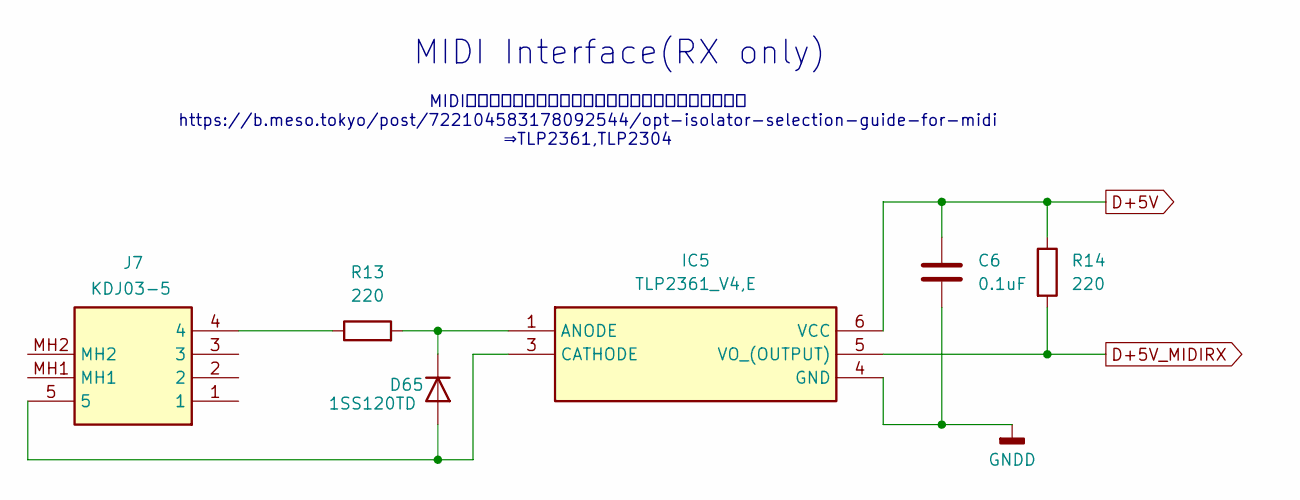
[picture p119: schematic MIDI_RX.kicad_sch]

Parts:
C6: 0.1uF
D65: 1SS120TD; D_A-405_P2.54mm_Vertical_AnodeUp
IC5: TLP2361_V4,E; 11-4L1S(5-PIN-SOIC); Manufacturer_Part_Number TLP2361(V4,E; Mouser Part Number 757-TLP2361V4E
J7: KDJ03-5; KDJ035; Manufacturer_Part_Number KDJ03-5
R13, R14: 220; R_Axial_DIN0207_L6.3mm_D2.5mm_P7.62mm_Horizontal

Connections:
A+SyncIn: J7.2; also elsewhere on the board
GNDD: J7.1; also elsewhere on the board
unnamed: C6.1, IC5.6 (VCC), R14.1
unnamed: C6.2, IC5.4 (GND)
unnamed: D65.1 (K), IC5.1 (ANODE), R13.2
unnamed: D65.2 (A), IC5.3 (CATHODE), J7.5
unnamed: IC5.5 (VO_(OUTPUT)), R14.2
unnamed: J7.4, R13.1

Notes on the sheet:
MIDI送受信回路で使うオプトアイソレータはどれが良い？ https://b.meso.tokyo/post/722104583178092544/opt-isolator-selection-guide-for-midi ⇒TLP2361,TLP2304
MIDI Interface(RX only)

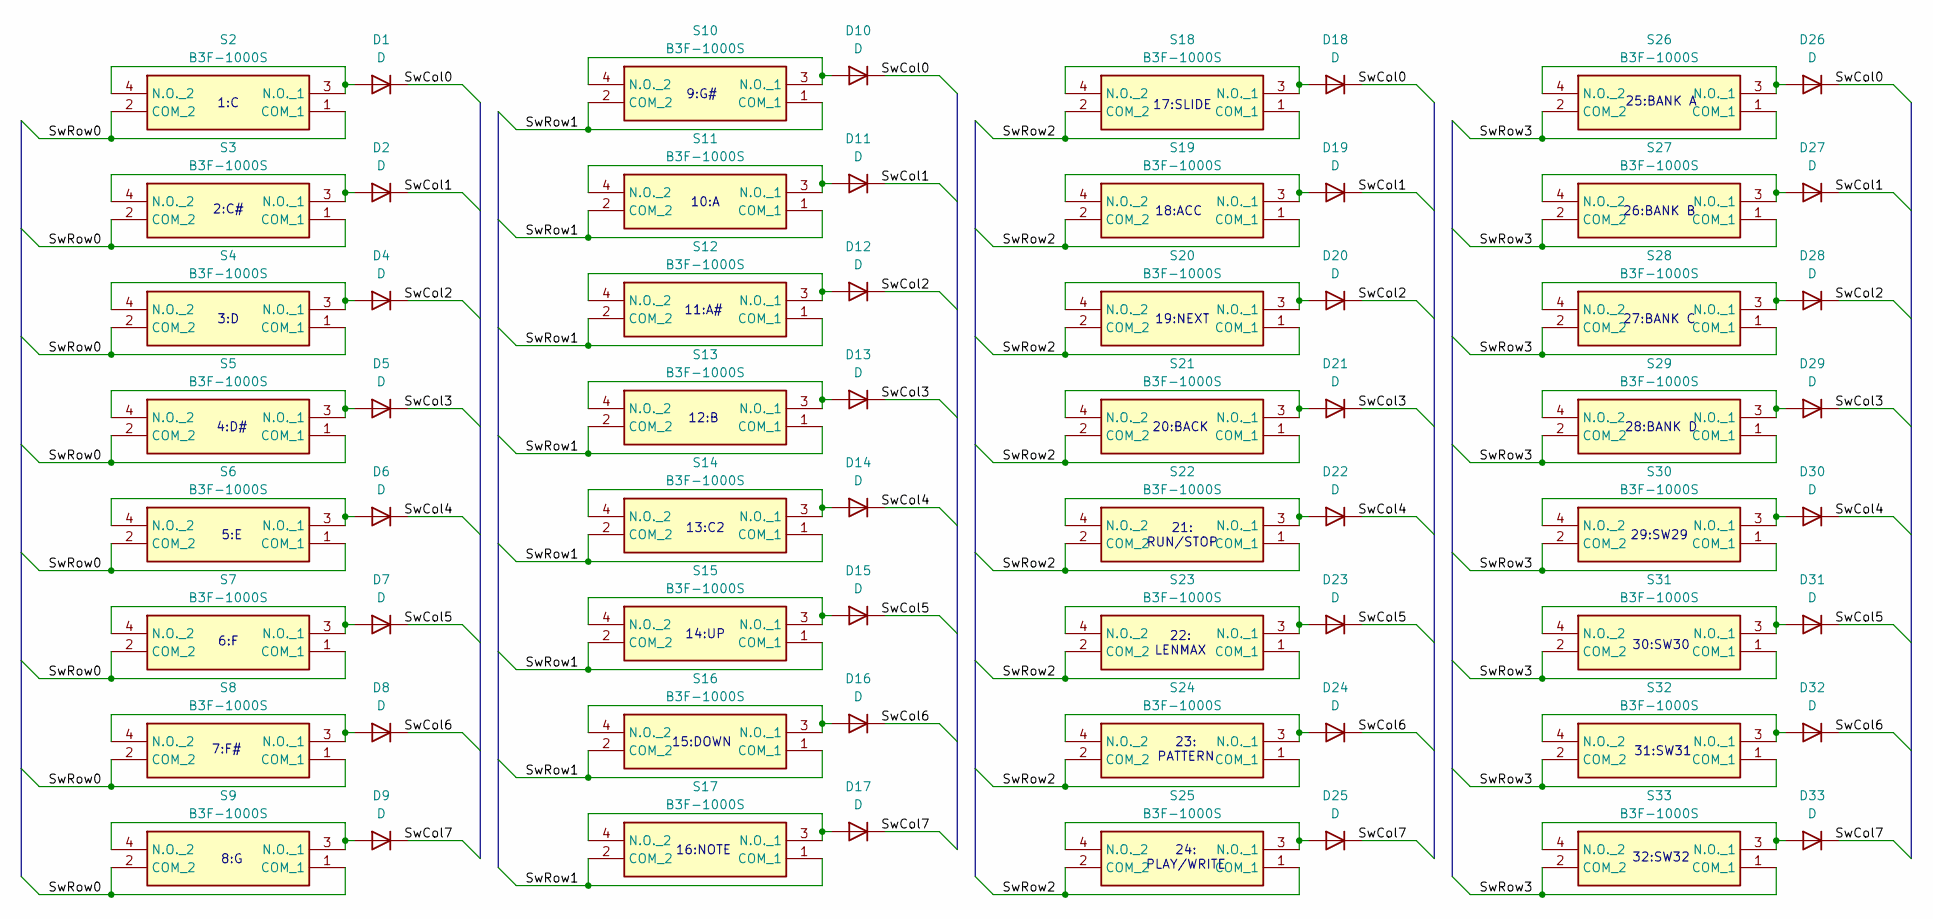
[picture p120: schematic untitled.kicad_sch]

Parts:
D1, D2, D4, D5, D6, D7, D8, D9, D10, D11, D12, D13, D14, D15, D16, D17, D18, D19, D20, D21, D22, D23, D24, D25, D26, D27, D28, D29, D30, D31, D32, D33: D; D_DO-15_P10.16mm_Horizontal
S2, S3, S4, S5, S6, S7, S8, S9, S10, S11, S12, S13, S14, S15, S16, S17, S18, S19, S20, S21, S22, S23, S24, S25, S26, S27, S28, S29, S30, S31, S32, S33: B3F-1000S; B3F1060; Manufacturer_Part_Number B3F-1000S; Mouser Part Number 653-B3F-1000-S

Connections:
/SwitchMatrix/SwCol0: D1.1 (K), D10.1 (K), D18.1 (K), D26.1 (K)
/SwitchMatrix/SwCol1: D2.1 (K), D11.1 (K), D19.1 (K), D27.1 (K)
/SwitchMatrix/SwCol2: D4.1 (K), D12.1 (K), D20.1 (K), D28.1 (K)
/SwitchMatrix/SwCol3: D5.1 (K), D13.1 (K), D21.1 (K), D29.1 (K)
/SwitchMatrix/SwCol4: D6.1 (K), D14.1 (K), D22.1 (K), D30.1 (K)
/SwitchMatrix/SwCol5: D7.1 (K), D15.1 (K), D23.1 (K), D31.1 (K)
/SwitchMatrix/SwCol6: D8.1 (K), D16.1 (K), D24.1 (K), D32.1 (K)
/SwitchMatrix/SwCol7: D9.1 (K), D17.1 (K), D25.1 (K), D33.1 (K)
/SwitchMatrix/SwRow0: S2.1 (COM_1), S2.2 (COM_2), S3.1 (COM_1), S3.2 (COM_2), S4.1 (COM_1), S4.2 (COM_2), S5.1 (COM_1), S5.2 (COM_2), S6.1 (COM_1), S6.2 (COM_2), S7.1 (COM_1), S7.2 (COM_2), S8.1 (COM_1), S8.2 (COM_2), S9.1 (COM_1), S9.2 (COM_2)
/SwitchMatrix/SwRow1: S10.1 (COM_1), S10.2 (COM_2), S11.1 (COM_1), S11.2 (COM_2), S12.1 (COM_1), S12.2 (COM_2), S13.1 (COM_1), S13.2 (COM_2), S14.1 (COM_1), S14.2 (COM_2), S15.1 (COM_1), S15.2 (COM_2), S16.1 (COM_1), S16.2 (COM_2), S17.1 (COM_1), S17.2 (COM_2)
/SwitchMatrix/SwRow2: S18.1 (COM_1), S18.2 (COM_2), S19.1 (COM_1), S19.2 (COM_2), S20.1 (COM_1), S20.2 (COM_2), S21.1 (COM_1), S21.2 (COM_2), S22.1 (COM_1), S22.2 (COM_2), S23.1 (COM_1), S23.2 (COM_2), S24.1 (COM_1), S24.2 (COM_2), S25.1 (COM_1), S25.2 (COM_2)
/SwitchMatrix/SwRow3: S26.1 (COM_1), S26.2 (COM_2), S27.1 (COM_1), S27.2 (COM_2), S28.1 (COM_1), S28.2 (COM_2), S29.1 (COM_1), S29.2 (COM_2), S30.1 (COM_1), S30.2 (COM_2), S31.1 (COM_1), S31.2 (COM_2), S32.1 (COM_1), S32.2 (COM_2), S33.1 (COM_1), S33.2 (COM_2)
unnamed: D1.2 (A), S2.3 (N.O._1), S2.4 (N.O._2)
unnamed: D2.2 (A), S3.3 (N.O._1), S3.4 (N.O._2)
unnamed: D4.2 (A), S4.3 (N.O._1), S4.4 (N.O._2)
unnamed: D5.2 (A), S5.3 (N.O._1), S5.4 (N.O._2)
unnamed: D6.2 (A), S6.3 (N.O._1), S6.4 (N.O._2)
unnamed: D7.2 (A), S7.3 (N.O._1), S7.4 (N.O._2)
unnamed: D8.2 (A), S8.3 (N.O._1), S8.4 (N.O._2)
unnamed: D9.2 (A), S9.3 (N.O._1), S9.4 (N.O._2)
unnamed: D10.2 (A), S10.3 (N.O._1), S10.4 (N.O._2)
unnamed: D11.2 (A), S11.3 (N.O._1), S11.4 (N.O._2)
unnamed: D12.2 (A), S12.3 (N.O._1), S12.4 (N.O._2)
unnamed: D13.2 (A), S13.3 (N.O._1), S13.4 (N.O._2)
unnamed: D14.2 (A), S14.3 (N.O._1), S14.4 (N.O._2)
unnamed: D15.2 (A), S15.3 (N.O._1), S15.4 (N.O._2)
unnamed: D16.2 (A), S16.3 (N.O._1), S16.4 (N.O._2)
unnamed: D17.2 (A), S17.3 (N.O._1), S17.4 (N.O._2)
unnamed: D18.2 (A), S18.3 (N.O._1), S18.4 (N.O._2)
unnamed: D19.2 (A), S19.3 (N.O._1), S19.4 (N.O._2)
unnamed: D20.2 (A), S20.3 (N.O._1), S20.4 (N.O._2)
unnamed: D21.2 (A), S21.3 (N.O._1), S21.4 (N.O._2)
unnamed: D22.2 (A), S22.3 (N.O._1), S22.4 (N.O._2)
unnamed: D23.2 (A), S23.3 (N.O._1), S23.4 (N.O._2)
unnamed: D24.2 (A), S24.3 (N.O._1), S24.4 (N.O._2)
unnamed: D25.2 (A), S25.3 (N.O._1), S25.4 (N.O._2)
unnamed: D26.2 (A), S26.3 (N.O._1), S26.4 (N.O._2)
unnamed: D27.2 (A), S27.3 (N.O._1), S27.4 (N.O._2)
unnamed: D28.2 (A), S28.3 (N.O._1), S28.4 (N.O._2)
unnamed: D29.2 (A), S29.3 (N.O._1), S29.4 (N.O._2)
unnamed: D30.2 (A), S30.3 (N.O._1), S30.4 (N.O._2)
unnamed: D31.2 (A), S31.3 (N.O._1), S31.4 (N.O._2)
unnamed: D32.2 (A), S32.3 (N.O._1), S32.4 (N.O._2)
unnamed: D33.2 (A), S33.3 (N.O._1), S33.4 (N.O._2)

Notes on the sheet:
16:NOTE
19:NEXT
26:BANK B
23: PATTERN
12:B
4:D#
7:F#
6:F
15:DOWN
1:C
17:SLIDE
3:D
14:UP
24: PLAY/WRITE
9:G#
21: RUN/STOP
28:BANK D
31:SW31
22: LENMAX
29:SW29
10:A
8:G
27:BANK C
13:C2
11:A#
30:SW30
20:BACK
18:ACC
5:E
25:BANK A
2:C#
32:SW32


Parts:
VR1: RK09D117000B; Manufacturer_Part_Number RK09D117000B; Mouser Part Number 688-RK09D117000B

Connections:
unnamed: VR1.3 (CW), VR1.MH1, VR1.MH2

Notes on the sheet:
ADC Tempo Volume

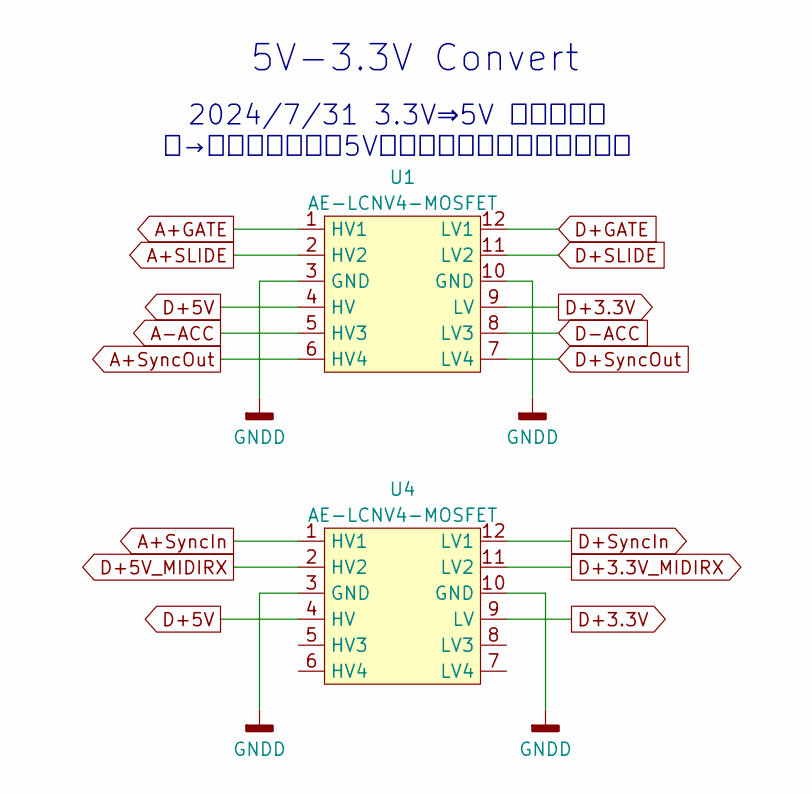
[picture p121: schematic LevelConvert.kicad_sch]

Parts:
U1, U4: AE-LCNV4-MOSFET; CERDIP-14_W10.16mm_SideBrazed_LongPads_Socket

Connections:
A+SLIDE: U1.2 (HV2)
A-ACC: U1.5 (HV3)
D+3.3V: U1.9 (LV), U4.9 (LV); also elsewhere on the board
D+5V: U1.4 (HV), U4.4 (HV); also elsewhere on the board
D+GATE: U1.12 (LV1); also elsewhere on the board
D+SLIDE: U1.11 (LV2); also elsewhere on the board
D+SyncOut: U1.7 (LV4); also elsewhere on the board
D-ACC: U1.8 (LV3); also elsewhere on the board
GNDD: U1.3 (GND), U1.10 (GND), U4.3 (GND), U4.10 (GND); also elsewhere on the board

Notes on the sheet:
5V-3.3V Convert
2024/7/31 3.3V⇒5V 動作確認済 →場合によっては5V変換後にバッファが必要かも

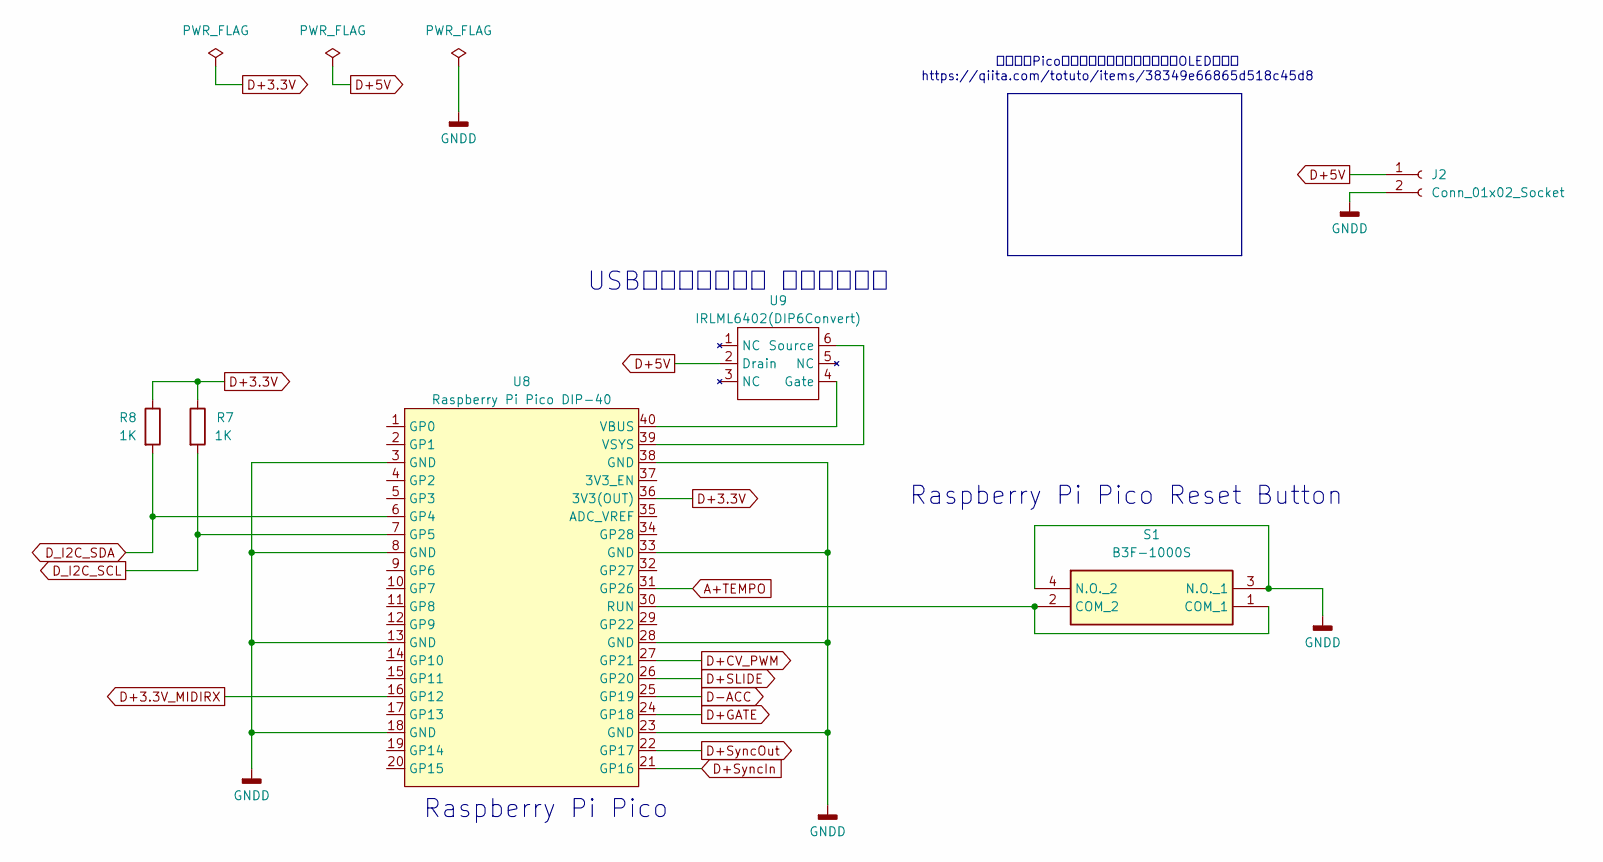
[picture p122: schematic RasPico.kicad_sch]

Parts:
J2: Conn_01x02_Socket; PinHeader_1x02_P2.54mm_Vertical
R7, R8: 1K; R_Axial_DIN0207_L6.3mm_D2.5mm_P7.62mm_Horizontal
S1: B3F-1000S; B3F1060; Manufacturer_Part_Number B3F-1000S; Mouser Part Number 653-B3F-1000-S
U8: Raspberry Pi Pico DIP-40; Raspberry Pi Pico DIP-40_W17.76mm
U9: IRLML6402(DIP6Convert); DIP-6_W7.62mm

Connections:
A+TEMPO: U8.31 (GP26); also elsewhere on the board
D+3.3V: R7.1, R8.1, U8.36 (3V3(OUT)); also elsewhere on the board
D+3.3V_MIDIRX: U8.16 (GP12); also elsewhere on the board
D+5V: J2.1, U9.2 (Drain); also elsewhere on the board
D+CV_PWM: U8.27 (GP21); also elsewhere on the board
D+GATE: U8.24 (GP18); also elsewhere on the board
D+SLIDE: U8.26 (GP20); also elsewhere on the board
D+SyncIn: U8.21 (GP16); also elsewhere on the board
D+SyncOut: U8.22 (GP17); also elsewhere on the board
D-ACC: U8.25 (GP19); also elsewhere on the board
D_I2C_SCL: R7.2, U8.7 (GP5); also elsewhere on the board
D_I2C_SDA: R8.2, U8.6 (GP4); also elsewhere on the board
GNDD: J2.2, S1.3 (N.O._1), S1.4 (N.O._2), U8.3 (GND), U8.8 (GND), U8.13 (GND), U8.18 (GND), U8.23 (GND), U8.28 (GND), U8.33 (GND), U8.38 (GND); also elsewhere on the board
unnamed: U8.40 (VBUS), U9.4 (Gate)
unnamed: U8.39 (VSYS), U9.6 (Source)
pico_RUN: S1.1 (COM_1), S1.2 (COM_2), U8.30 (RUN)

Notes on the sheet:
ラズパイPico：電池で動作、電池の電圧をOLEDに表示 https://qiita.com/totuto/items/38349e66865d518c45d8
Raspberry Pi Pico Reset Button
USBコネクタ接続時 電流逆流防止
Raspberry Pi Pico


Parts:
U3: FM24CL16B(DIP8 Convert); CERDIP-8_W7.62mm_SideBrazed_Socket

Connections:
unnamed: U3.4 (VSS), U3.7 (WP)

Notes on the sheet:
F-RAM 16KByte
Raspberry Pi Pico: I2C Scanner (Arduino IDE) - Finding the Address of I2C Devices https://randomnerdtutorials.com/raspberry-pi-pico-i2c-scanner-arduino/ Scanning... I2C device found at address 0x20 I2C device found at address 0x21 I2C device found at address 0x3C I2C device found at address 0x50 I2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
