wakimizufu/TBSEQ/TBSEQ_Board_V1/controll/controll.kicad_pcb

## KiCad design TBSEQ_Board_V1/controll/controll.kicad_pcb (continued)

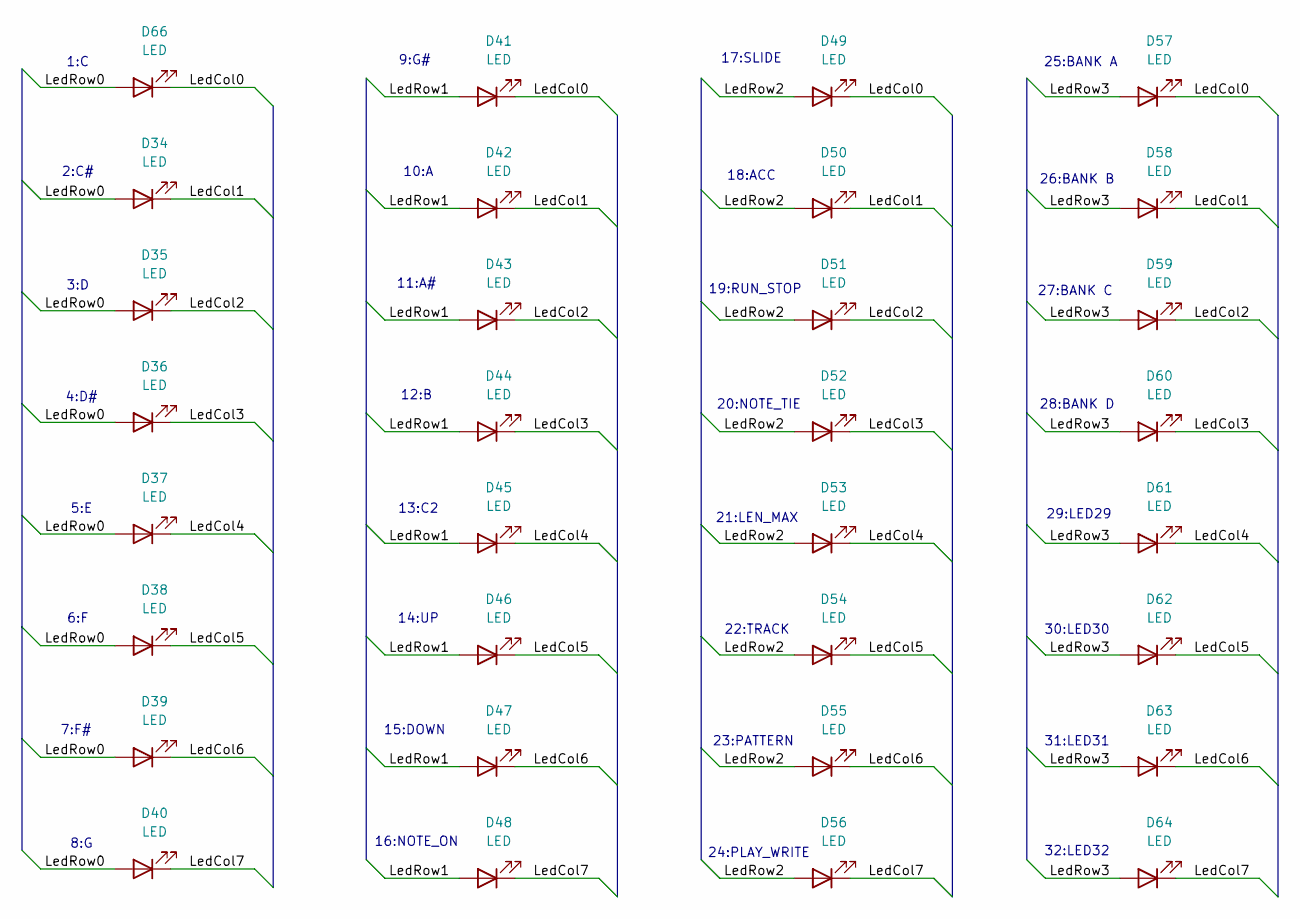
[picture p123: schematic LEDMatrix.kicad_sch]

Parts:
D34, D35, D36, D37, D38, D39, D40, D41, D42, D43, D44, D45, D46, D47, D48, D49, D50, D51, D52, D53, D54, D55, D56, D57, D58, D59, D60, D61, D62, D63, D64, D66: LED; LED_D3.0mm

Connections:
/LEDMatrix/LedCol0: D41.1 (K), D49.1 (K), D57.1 (K), D66.1 (K)
/LEDMatrix/LedCol1: D34.1 (K), D42.1 (K), D50.1 (K), D58.1 (K)
/LEDMatrix/LedCol2: D35.1 (K), D43.1 (K), D51.1 (K), D59.1 (K)
/LEDMatrix/LedCol3: D36.1 (K), D44.1 (K), D52.1 (K), D60.1 (K)
/LEDMatrix/LedCol4: D37.1 (K), D45.1 (K), D53.1 (K), D61.1 (K)
/LEDMatrix/LedCol5: D38.1 (K), D46.1 (K), D54.1 (K), D62.1 (K)
/LEDMatrix/LedCol6: D39.1 (K), D47.1 (K), D55.1 (K), D63.1 (K)
/LEDMatrix/LedCol7: D40.1 (K), D48.1 (K), D56.1 (K), D64.1 (K)
/LEDMatrix/LedRow0: D34.2 (A), D35.2 (A), D36.2 (A), D37.2 (A), D38.2 (A), D39.2 (A), D40.2 (A), D66.2 (A)
/LEDMatrix/LedRow1: D41.2 (A), D42.2 (A), D43.2 (A), D44.2 (A), D45.2 (A), D46.2 (A), D47.2 (A), D48.2 (A)
/LEDMatrix/LedRow2: D49.2 (A), D50.2 (A), D51.2 (A), D52.2 (A), D53.2 (A), D54.2 (A), D55.2 (A), D56.2 (A)
/LEDMatrix/LedRow3: D57.2 (A), D58.2 (A), D59.2 (A), D60.2 (A), D61.2 (A), D62.2 (A), D63.2 (A), D64.2 (A)

Notes on the sheet:
3:D
23:PATTERN
6:F
30:LED30
5:E
17:SLIDE
27:BANK C
7:F#
29:LED29
21:LEN_MAX
24:PLAY_WRITE
14:UP
12:B
28:BANK D
19:RUN_STOP
9:G#
16:NOTE_ON
18:ACC
8:G
11:A#
1:C
32:LED32
20:NOTE_TIE
22:TRACK
13:C2
10:A
26:BANK B
4:D#
25:BANK A
15:DOWN
31:LED31
2:C#

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
Board: 2 copper layers, 135 parts (0 on the bottom side), 108 nets, no tracks yet.

Other parts of the board:
C11: 0.047uF; C_Rect_L7.0mm_W2.5mm_P5.00mm
D3: 1SS120TD; D_A-405_P2.54mm_Vertical_AnodeUp
J1: KDJ03-5; KDJ035
Q2: 6N138; DIP762W60P254L966H485Q8N
R5, R6: 220; R_Axial_DIN0207_L6.3mm_D2.5mm_P7.62mm_Horizontal
U6: AE-LCNV4-MOSFET; CERDIP-14_W10.16mm_SideBrazed_LongPads_Socket
U7: FM24CL16B(DIP8 Convert); CERDIP-8_W7.62mm_SideBrazed_Socket
VR2: RK09D117000B

Their connections:
A+SyncIn: U6.1 (HV1); also elsewhere on the board
A+TEMPO: VR2.2 (WIPER); also elsewhere on the board
D+3.3V: U6.9 (LV), U7.8 (VDD), VR2.1 (CCW); also elsewhere on the board
D+3.3V_MIDIRX: U6.11 (LV2); also elsewhere on the board
D+5V: Q2.8 (VCC), R6.1, U6.4 (HV); also elsewhere on the board
D+5V_MIDIRX: Q2.6 (OUTPUT), R6.2, U6.2 (HV2)
D+SyncIn: U6.12 (LV1); also elsewhere on the board
D_I2C_SCL: U7.6 (SCL); also elsewhere on the board
D_I2C_SDA: U7.5 (SDA); also elsewhere on the board
GNDD: C11.2, Q2.5 (GND), U6.3 (GND), U6.10 (GND), U7.4 (VSS), U7.7 (WP), VR2.3 (CW), VR2.MH1, VR2.MH2; also elsewhere on the board
unnamed: D3.2 (A), J1.5, Q2.3 (CATHODE)
unnamed: D3.1 (K), Q2.2 (ANODE), R5.2
unnamed: J1.4, R5.1
unnamed 127: C11.1; also elsewhere on the board
