wakimizufu/TBSEQ/VS2022_CPP/include/sequenceMap.h

/*
スイッチ入力/LED出力を定期間隔で更新する
*/

#ifndef sequenceMap_h
#define sequenceMap_h


/*
step ステップの各種情報を定義
*/


//step:1ステップの総バイト数
#define STEP_ALLBYTE 2

//step:ノートオンオフ 1:ノートオン/2:ノートオン(タイ)/0:ノートオフ
#define STEP_NOTE_ON_NORMAL 1
#define STEP_NOTE_ON_TIE 2
#define STEP_NOTE_OFF 0


class step {
public:
	unsigned char    note;     //ノート( NOTE_PWM_INDEX::NOTE_C2～NOTE_PWM_INDEX::NOTE_C3 を設定)
	unsigned char    note_on;  //ノートオンオフ 1:ノートオン/2:ノートオン(タイ)/0:ノートオフ
	bool lastStep; //最終ステップ(最終ステップ:1,通常ステップ:0)


	//オクターブUPとDOWNはどちらもtrueにはならない
	bool    up;     //オクターブUP true:C3/false:C2
	bool    down;   //オクターブDOWN true:C1/false:C2

	bool    acc;    //アクセント true:ON/false:OFF
	bool    slide;  //スライド true:ON/false:OFF

	/*
	コンストラクタ
	*/
	explicit step() {
		note = static_cast<unsigned char>(NOTE_PWM_INDEX::NOTE_C2);
		lastStep = true;
		up = false;
		down = false;
		note_on = false;
		acc = false;
		slide = false;
	}

private:
};

/*
patern 1パターン内の全ステップを管理する
*/

//step:ステップ開始インデックス
#define STEP_START_IDX 0

//step:1パターン内の全ステップ数
#define PATERN_STEP_LENGTH 16


class patern {
public:
	step steps[PATERN_STEP_LENGTH];

	/*
	コンストラクタ
	*/
	explicit patern() {
	}

private:

};


/*
sequenceMap パターンを管理する
*/

//sequenceMap:パターン開始インデックス
#define PATTERN_START_IDX 0

//sequenceMap:パターン全数
#define SEQUENCE_PATTERN_LENGTH 8

//sequenceMap:パターン全数
const int SEQUENCE_ALLBYTE = SEQUENCE_PATTERN_LENGTH * PATERN_STEP_LENGTH * STEP_ALLBYTE;

class sequenceMap {
public:

	//パターン配列
	patern paterns[SEQUENCE_PATTERN_LENGTH];

	/*
	コンストラクタ
	 */
	explicit sequenceMap() {
	}

	/*
ビットストリームからパターン配列を設定する
引数:ビットストリーム
*/
	void setBitstream(unsigned char* _bitstream) {

		int _bitInd = 0;
		unsigned char _byte = 0;

		for (int p = 0; p < SEQUENCE_PATTERN_LENGTH; p++) {
			for (int s = 0; s < PATERN_STEP_LENGTH; s++) {

				_byte = *(_bitstream + _bitInd);
				paterns[p].steps[s].lastStep = (0x10 == (0x10 & _byte)); //bit:4 最終ステップ(true:最終ステップ ,false:通常ステップ)
				paterns[p].steps[s].slide = (0x08 == (0x08 & _byte)); //bit:3 スライド true:ON/false:OFF
				paterns[p].steps[s].acc = (0x04 == (0x04 & _byte)); //bit:2 アクセント true:ON/false:OFF
				paterns[p].steps[s].down = (0x02 == (0x02 & _byte)); //bit:1 オクターブDOWN true:C1/false:C2
				paterns[p].steps[s].up = (0x01 == (0x01 & _byte)); //bit:0 オクターブUP true:ON/false:OFF
				_bitInd++;

				_byte = *(_bitstream + _bitInd);

				//ノートオンオフ 1:ノートオン/2:ノートオン(タイ)/0:ノートオフ
				paterns[p].steps[s].note_on = (0x30 & _byte) >> 4;

				//ノート( NOTE_PWM_INDEX::NOTE_C2～NOTE_PWM_INDEX::NOTE_C3 を設定)
				paterns[p].steps[s].note = (0x0F & _byte) + static_cast<unsigned char>(NOTE_PWM_INDEX::NOTE_C2);

				_bitInd++;
			}
		}



	}

	/*
	パターン配列からビットストリームに設定する
	引数:ビットストリーム
	*/
	void getBitstream(unsigned char* _bitstream) {

		int _bitInd = 0;
		unsigned char _byte = 0;

		for (int p = 0; p < SEQUENCE_PATTERN_LENGTH; p++) {
			for (int s = 0; s < PATERN_STEP_LENGTH; s++) {

				_byte = 0x00;
				if (paterns[p].steps[s].lastStep) { _byte = _byte ^ 0x10; }	//bit:4 最終ステップ(true:最終ステップ ,false:通常ステップ)
				if (paterns[p].steps[s].slide) { _byte = _byte ^ 0x08; }	//bit:3 スライド true:ON/false:OFF
				if (paterns[p].steps[s].acc) { _byte = _byte ^ 0x04; }		//bit:2 アクセント true:ON/false:OFF
				if (paterns[p].steps[s].down) { _byte = _byte ^ 0x02; }		//bit:1 オクターブDOWN true:C1/false:C2
				if (paterns[p].steps[s].up) { _byte = _byte ^ 0x01; }		//bit:0 オクターブUP true:ON/false:OFF
				*(_bitstream + _bitInd) = _byte;
				_bitInd++;

				_byte = paterns[p].steps[s].note - static_cast<unsigned char>(NOTE_PWM_INDEX::NOTE_C2);	//ノート( NOTE_PWM_INDEX::NOTE_C2～NOTE_PWM_INDEX::NOTE_C3 を設定)
				_byte = _byte | paterns[p].steps[s].note_on << 4;

				*(_bitstream + _bitInd) = _byte;
				_bitInd++;
			}
		}
	}

private:
};


/*
 presetBitstream パターンを管理する
*/
class presetBitstream {
public:
	/*
	パターン情報 ビットストリーム
	☆総バイト数  :0x00FF=256Byte
		0x0000:sequenceMap開始
			0x0000:パターン1
			0x0020:パターン2
			0x0040:パターン3
			0x0060:パターン4
			0x0080:パターン5
			0x00A0:パターン6
			0x00C0:パターン7
			0x00E0:パターン8

		0x0000:パターン
			0x0000:ステップ1
			0x0002:ステップ2
			0x0004:ステップ3
			0x0006:ステップ4
			0x0008:ステップ5
			0x000A:ステップ6
			0x000C:ステップ7
			0x000E:ステップ8
			0x0010:ステップ9
			0x0012:ステップ10
			0x0014:ステップ11
			0x0016:ステップ12
			0x0018:ステップ13
			0x001A:ステップ14
			0x001C:ステップ15
			0x001E:ステップ16

		[ステップ]
		1Byte:
			bit7-5:(未使用:全て0)
			bit  4:最終ステップ(最終ステップ:1,通常ステップ:0)
			bit  3:スライド(オン:1,オフ:0)
			bit  2:アクセント(オン:1,オフ:0)
			bit  1:オクターブDown(オン:1,オフ:0)
			bit  0:オクターブUp(オン:1,オフ:0)

		1Byte:
			bit7-6:(未使用:全て0)
			bit5-4:ノートオンオフ 1:ノートオン/2:ノートオン(タイ)/0:ノートオフ
			bit3-0:ノート(NOTE_PWM_INDEX::NOTE_C2～NOTE_PWM_INDEX::NOTE_C3⇒0x0～0xD を設定)
	*/
	unsigned char patern_preset_bitstream[SEQUENCE_ALLBYTE]{
	0x00,0x10, 0x00,0x10, 0x00,0x12, 0x00,0x13, 0x00,0x14, 0x00,0x15, 0x00,0x16, 0x00,0x17, 0x00,0x18, 0x00,0x19, 0x00,0x1A, 0x00,0x1B, 0x00,0x1C, 0x00,0x1D, 0x00,0x1C, 0x10,0x1B,	//パターン1
	0x01,0x10, 0x01,0x11, 0x01,0x12, 0x01,0x13, 0x01,0x14, 0x01,0x15, 0x01,0x16, 0x01,0x17, 0x01,0x18, 0x01,0x19, 0x01,0x1A, 0x01,0x1B, 0x01,0x1C, 0x01,0x1D, 0x01,0x1C, 0x11,0x1B,	//パターン2
	0x02,0x10, 0x02,0x11, 0x02,0x12, 0x02,0x13, 0x02,0x14, 0x02,0x15, 0x02,0x16, 0x02,0x17, 0x02,0x18, 0x02,0x19, 0x02,0x1A, 0x02,0x1B, 0x02,0x1C, 0x02,0x1D, 0x02,0x1C, 0x12,0x1B,	//パターン3
	0x00,0x10, 0x00,0x21, 0x08,0x22, 0x00,0x03, 0x00,0x14, 0x08,0x15, 0x0C,0x26, 0x00,0x07, 0x00,0x18, 0x00,0x09, 0x00,0x1A, 0x08,0x1B, 0x00,0x1C, 0x00,0x1D, 0x0C,0x1C, 0x14,0x1B,	//パターン4
	0x00,0x10, 0x00,0x11, 0x00,0x12, 0x00,0x13, 0x00,0x14, 0x00,0x15, 0x00,0x16, 0x00,0x17, 0x00,0x18, 0x00,0x19, 0x00,0x1A, 0x00,0x1B, 0x00,0x1C, 0x00,0x1D, 0x00,0x1C, 0x10,0x1B,	//パターン5
	0x00,0x10, 0x00,0x11, 0x00,0x12, 0x00,0x13, 0x00,0x14, 0x00,0x15, 0x00,0x16, 0x00,0x17, 0x00,0x18, 0x00,0x19, 0x00,0x1A, 0x00,0x1B, 0x00,0x1C, 0x00,0x1D, 0x00,0x1C, 0x10,0x1B,	//パターン6
	0x00,0x10, 0x00,0x11, 0x00,0x12, 0x00,0x13, 0x00,0x14, 0x00,0x15, 0x00,0x16, 0x00,0x17, 0x00,0x18, 0x00,0x19, 0x00,0x1A, 0x00,0x1B, 0x00,0x1C, 0x00,0x1D, 0x00,0x1C, 0x10,0x1B,	//パターン7
	0x00,0x10, 0x00,0x11, 0x00,0x12, 0x00,0x13, 0x00,0x14, 0x00,0x15, 0x00,0x16, 0x00,0x17, 0x00,0x18, 0x00,0x19, 0x00,0x1A, 0x00,0x1B, 0x00,0x1C, 0x00,0x1D, 0x00,0x1C, 0x10,0x1B	//パターン8
	};


	/*
	コンストラクタ
	*/
	explicit presetBitstream() {
	}



private:
};


#endif
