wakimizufu/TBSEQ/VS2022_CPP/include/tempo.h

/*
テンポボリュームを定期的に更新/値を返す
*/

#ifndef tempo_h
#define tempo_h

/* #include "Arduino.h" */
#include "countTriger.h"

//読み取り間隔カウンタ閾値 10msec (500ns * 20000カウント)
#define THD_TEMPO 20000
#define TEMPO_CNV_ROW_MAX 256
#define TEMPO_CNV_COL_MAX 2

#define TEMPO_COL_TEMPO 0
#define TEMPO_COL_COUNT 1

class tempo: public countTriger
{
  public:

		/*
		コンストラクタ
		start     :カウンタ開始値(デフォルト=0)
		*/
	  tempo(unsigned int start);

		/*
		[仮想関数]カウンタ閾値に達した⇒MIDIクロックがカウントアップをセット
		*/
	  virtual void trigger();

		/*
		テンポ値を取得する
		戻り値:テンポ値(30～285)
		*/
	  int	getTempo();

		/*
		テンポに対する500nsカウント閾値を取得する
		戻り値:500nsカウント閾値
		*/
	  int	getCountThd();

  protected:
    int	_adc_value;	//ADC読み取り値

		//ADC読み取り値(インデックス)⇒テンポ値/500nsカウント閾値配列({テンポ値,500nsカウンタ閾値})
		int convertArray[TEMPO_CNV_ROW_MAX][TEMPO_CNV_COL_MAX]	={
			{	30	,	2778	},
			{	31	,	2688	},
			{	32	,	2604	},
			{	33	,	2525	},
			{	34	,	2451	},
			{	35	,	2381	},
			{	36	,	2315	},
			{	37	,	2252	},
			{	38	,	2193	},
			{	39	,	2137	},
			{	40	,	2083	},
			{	41	,	2033	},
			{	42	,	1984	},
			{	43	,	1938	},
			{	44	,	1894	},
			{	45	,	1852	},
			{	46	,	1812	},
			{	47	,	1773	},
			{	48	,	1736	},
			{	49	,	1701	},
			{	50	,	1667	},
			{	51	,	1634	},
			{	52	,	1603	},
			{	53	,	1572	},
			{	54	,	1543	},
			{	55	,	1515	},
			{	56	,	1488	},
			{	57	,	1462	},
			{	58	,	1437	},
			{	59	,	1412	},
			{	60	,	1389	},
			{	61	,	1366	},
			{	62	,	1344	},
			{	63	,	1323	},
			{	64	,	1302	},
			{	65	,	1282	},
			{	66	,	1263	},
			{	67	,	1244	},
			{	68	,	1225	},
			{	69	,	1208	},
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
		};

};

#endif
