wakimizufu/TBSEQ/VS2022_CPP/include/paternPlay.h

/*
モードクラス：パターンプレイ用クラスを定義
*/

#ifndef paternPlay_h
#define paternPlay_h

#include "mode.h"

class paternPlay: public mode{

    public:
     /*
    コンストラクタ
		ptPanelManager:panelManagerクラスポインタ
		ptVoltage     :voltageクラスポインタ
    */
		paternPlay(panelManager* ptPanelManager, voltage* ptVoltage, sequenceMap* ptSequenceMap);

		/*
		[仮想関数]カウント閾値達成時に実行されるアプリケーションを実施する
		*/
		virtual void runSequence();

		/*
		[仮想関数]MIDIクロックカウント閾値達成時に実行されるアプリケーションを実施する
		*/
		virtual void runClock();


		/*
		ラン/ストップフラグ:ラン シークエンス処理を実行
		*/
		void	execRunSequence();

		/*
		ラン/ストップフラグ:ストップ シークエンス処理を実行
		*/
		void	execStopSequence();

		/*
		ラン/ストップフラグ:ラン MIDIクロックカウント処理を実行
		*/
		void	execRunClock();

		/*
		ラン/ストップフラグ:ストップ MIDIクロックカウント処理を実行
		*/
		void	execStopClock();


		/*
		ラン/ストップ切替チェック
		*/
		void	changeRunStop();


  private:
  	int		_pattern;		//指定パターン
  	int		_step;			//現在ステップ
  	int		_LEDCount;	//LED点滅カウント
  	bool	_pushRunSW;	//ラン/ストップSW前回状態フラグ
  	bool	_keyborad;	//キーボードフラグ

		/*
		16音符毎MIDIクロックカウントが後半クロックになったらゲートをオフする
		*/
	void _gate_off_16note();

		/*
		指定パターンに応じたclass:LED値を取得
		*/
	int	_get_pattrn_LED(int pattern);
};




#endif
