wakimizufu/TBSEQ/testClock/tempo.h

/*
テンポボリュームを定期的に更新/値を返す
*/

#ifndef tempo_h
#define tempo_h

#include "Arduino.h"
#include "countTriger.h"

//読み取り間隔カウンタ閾値 9.984msec (32us * 312カウント)
#define THD_TEMPO 312
#define TEMPO_CNV_ROW_MAX 256
#define TEMPO_CNV_COL_MAX 2

#define TEMPO_COL_TEMPO 1
#define TEMPO_COL_COUNT 2

class tempo: public countTriger
{
  public:

		/*
		コンストラクタ
		start     :カウンタ開始値(デフォルト=0)
		*/
    explicit tempo(unsigned int start = 0):countTriger(	THD_TEMPO	,	start)	{
		}

		/*
		[仮想関数]カウンタ閾値に達した⇒MIDIクロックがカウントアップをセット
		*/
    virtual void trigger(){
			_adc_value	=	analogRead(0);
		};

		/*
		テンポ値を取得する
		戻り値:テンポ値(30～240)
		*/
		int	getTempo(){
			return	convertArray[_adc_value][TEMPO_COL_TEMPO];
		}

		/*
		テンポに対する32usカウント閾値を取得する
		戻り値:32usカウント閾値
		*/
		int	getCountThd(){
			return	convertArray[_adc_value][TEMPO_COL_COUNT];
		}

  protected:
    int	_adc_value;	//ADC読み取り値

		//ADC読み取り値(インデックス)⇒テンポ値/32usカウント閾値配列({テンポ値,})
		int convertArray[TEMPO_CNV_ROW_MAX][TEMPO_CNV_COL_MAX]	={
			{30,2604},
			{31,2520},
			{32,2441},
			{32,2441},
			{33,2367},
			{34,2298},
			{35,2232},
			{36,2170},
			{37,2111},
			{37,2111},
			{38,2056},
			{39,2003},
			{40,1953},
			{41,1905},
			{41,1905},
			{42,1860},
			{43,1817},
			{44,1776},
			{45,1736},
			{46,1698},
			{46,1698},
			{47,1662},
			{48,1628},
			{49,1594},
			{50,1563},
			{51,1532},
			{51,1532},
			{52,1502},
			{53,1474},
			{54,1447},
			{55,1420},
			{56,1395},
			{56,1395},
			{57,1371},
			{58,1347},
			{59,1324},
			{60,1302},
			{60,1302},
			{61,1281},
			{62,1260},
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
		};

};

#endif
