wakimizufu/TBSEQ/(commit log)

2024-05-26 VS2022 cpp/h分離
2024-05-28 arudino ソースファイル整理
2024-05-31 pin setup
2024-07-08 tempo ADC
2024-07-09 printf tempo
2024-07-14 debugmode スイッチ押したらLEDマトリクス点灯安定版
2024-07-16 debugmode PMW note/LED acc
2024-07-20 patternmode patternplay 一通り完了版
2024-08-04 HT16K33 5VOutputBuffer
    [LevelConvert.kicad_sch]
2024-08-07 HT16K33 Control
    [CV.kicad_sch, FRAM.kicad_sch, HT16K33.kicad_sch, HT16K33Panel.kicad_pcb, HT16K33Panel.kicad_sch, Jack.kicad_sch, LevelConvert.kicad_sch, MIDI_RX.kicad_sch]
2024-08-08 HT16K33Panel DRC gaber
    [HT16K33Panel.kicad_pcb, Jack.kicad_sch, Power.kicad_sch]
2024-08-21 SeqBox HT16K33 Fix
    LED表示,Switch読み取りタイミング調整済
    [matrixLED.h, matrixSwitch.h, panelManager.cpp, panelManager.h]
2024-08-21 SeqBox Fix
    ステップLED点灯追加
    FRAMライブラリの呼び出しが上手く行かない?
    ⇒SeqBoxだと書き込みメソッド(_writeblock())が呼び出せない
    ⇒代替コードでI2Cコマンド送信でしても反映されず
    ⇒ただしFRAMサンプルプログラムは正常に読み書きできるので回路は問題なさそう
    [FRAM_write.csv]
2024-08-22 SeqBox Fix
    ・切り分けの為 class FRAM11の内容をpanelManagerに移植した
    ・matrixSwitch::set 配列指定時に指定外の値に値設定してたので修正してFRAM書き込み確認済
    ・LENMAXを仮実装済
    [panelManager.cpp, panelManager.h]
2024-08-22 analog_separate Fix
    DMMT3906->HN4C51J
    [VCF.kicad_sch, analog_separate.kicad_sch]
2024-08-24 HT16K33Panel LevelConvert
    HD74LVC541A で5V->3.3Vへ変換をブレッドボードで確認済
    [LevelConvert.kicad_sch]
2024-08-25 HT16K33
    MIDI RX動作確認済
    [MIDI_RX.kicad_sch]
2024-08-25 SeqBox Fix
    パターンライト:RUNボタンクリック時の演奏を実装
    ⇒演奏中もステップの編集が出来る様に変更
    [paternWrite.h]
2024-08-26 SeqBox
    パターンプレイ:演奏時の開始ステップのバグ修正
2024-08-26 SeqBox update
    パターンプレイ/ライト:バンク:バンクA,B,C,Dを仮実装済
2024-08-27 SeqBox Fix
    SyncOut:内部テンポに応じた出力を実装済
    ⇒SyncInは仕様上実装を見送り
    [mode.h, modeManager.h, panelManager.cpp, voltage.h]
2024-08-28 SeqBox fix
    MIDIRecive:コーディング済 デバッグ待ち
    [mode.h, modeManager.h]
2024-08-30 SeqBox Fix
    8/30に何故がコンパイルすると起動直ぐにタイマー割込みが停止してしまう？
    ⇒8/27時点のソースから徐々に切り分けしてしたら何故か正常に動く様になった
    MIDIRx:動作確認済
    SyncOut:原因切り分けの為一旦コードを除外
    [mode.h, modeManager.h, panelManager.cpp, voltage.h]
2024-08-31 SeqBox Fix
    SyncOut:再度実装して動作確認済
    パターンプレイ:テンポ点滅スピードを2倍に変更
    [modeManager.h, panelManager.cpp, voltage.h]
2024-09-04 SeqBox fix
    ・アクセントの極性を(ON=0V OFF=5V)に変更
    ・パターンライト:RUN状態での演奏で、ゲート/スライド/アクセントがパターンプレイと異なる状態だったのを修正
    [voltage.h]
2024-09-23 analog_separate fix
    実装してバグを修正
    ・VR6以外のボリュームの左右が逆なのを修正
    ・デュアルトランジスタをHN1C01FU-GRに変更
    ・VCA CA3080後の出力段のバイアス/増幅率等の設計ミスを修正
    ・入力信号のシルク位置が間違っているので修正
    ⇒それ以外は正常動作を確認済
    [Interface.kicad_sch, Power.kicad_sch, VCA.kicad_sch, VCF.kicad_sch, VCO.kicad_sch, analog_separate.kicad_pcb, analog_separate.kicad_sch]
2024-09-29 TBSEQ_Board_V2
    メインボード作成中
    [AnInterface.kicad_sch, CV.kicad_sch, FRAM.kicad_sch, HT16K33.kicad_sch, Interface.kicad_sch, Jack.kicad_sch, LevelConvert.kicad_sch, MIDIRx.kicad_sch]
2024-10-03 mainboard
    PWS,Digi
    [Interface.kicad_sch, Jack.kicad_sch, LevelConvert.kicad_sch, MIDIRx.kicad_sch, PowerSupply.kicad_sch, RasPico.kicad_sch, mainBorad.kicad_pcb]
2024-10-07 mainBoard
    AnInterface
    [Interface.kicad_sch, Jack.kicad_sch, PowerSupply.kicad_sch, RasPico.kicad_sch, mainBorad.kicad_pcb]
2024-10-08 mainBoard
    VCO
    [Jack.kicad_sch, PowerSupply.kicad_sch, VCO.kicad_sch, mainBorad.kicad_pcb, mainBorad.kicad_sch]
2024-10-13 mainboard
    部品を全部配置しただけ
    [Interface.kicad_sch, Jack.kicad_sch, VCA.kicad_sch, VCF.kicad_sch, VCO.kicad_sch, mainBorad.kicad_pcb, mainBorad.kicad_sch]
2024-10-13 mainborad
    DRCチェック通過
    [mainBorad.kicad_pcb]
2024-10-14 mainboard & frontPanel
    コメント記入&寸法合わせ
    [HT16K33.kicad_sch, Jack.kicad_sch, LEDMatrix.kicad_sch, POT.kicad_sch, SwitchMatrix.kicad_sch, TEMPO.kicad_sch, Volume.kicad_sch, frontPanel.kicad_pcb]
2024-10-14 mainBoard&FrontPanel
    微修正
    [frontPanel.kicad_pcb, mainBorad.kicad_pcb]
2024-10-21 trackMap
    trackMap作成中
    [USBStudy_BOM.csv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]
2024-10-22 trackmap
    trackmap一通り書き終わり
2024-10-23 trackmap
    VC++set/getデバッグ完了
2024-10-24 modeManager
    trackmap追加中
2024-10-26 mode
    トラック関連追加
2024-10-28 trackplay
    patternplayからコピペ中
2024-10-29 trackplay
    トラックステップ追記中
2024-11-03 trackWrite
    演奏は無しで作成中
2024-11-04 trackwrite
    ビルド&デバッグ前
2024-11-05 trackplay.write
    デバッグ中
    FRAM11_test_sequenceMapとFRAM11_test_trackMapを登録
    ⇒FRAM11_test_trackMapでFRAM書き読み確認すみ
2024-11-06 trackplay,trackwrite
    コンパイル通過 デバッグ待ち
2024-11-07 modeManager
    trackPlay,trackWriteクラス生成が抜けてたので追記
2024-11-10 add_repeating_timer_us
    リピート設定にするとタイマーが停止してしまうバグ？があるので、ワンショット設定にして、割込み最後に割込み開始する様に修正した
2024-11-10 trackMap
    presetTrack()を実行
2024-11-11 trackplay
    トラックステップ/ラストステップを表示
2024-11-12 TimerCallBack&trackPlay
    タイマーコールバックが起動しない対策を実装
    トラックプレイのパターン指定の修正＆演奏中のLED表示を変更
2024-11-13 trackPlay
    トランスポート反映確認済(デバッグ出力のみ変更)
2024-11-13 trackWrite
    LED表示修正
    トランスポート設定で止まる
2024-11-14 trackwrite
    トランスポート設定のフリーズを修正
    バックSWでラストステップに飛ばないバグを修正
2024-11-17 trackwrite
    [トラックライト]
    パターン選択時のSWとLEDが食い違いを修正
    トラックライト⇒トラックプレイ切り替え時にFRAM書き込み追加
    [デバックモード]
    ・電源投入時のRUN/STOPボタン判定&LED表示を変更
    [panelManager.cpp, trackMap.h]
2024-11-18 utilityMode
    ユーティリティーモード作成開始
2024-11-19 utilityMode
    ユーティリティーモードへ遷移する導線をコーディング済 デバッグ待ち
2024-11-20 utilityMode
    FRAM読み書きと設定反映を実装してひとまず完了
2024-11-20 SyncIn
    ピンアサインとプラグインSyncIn端子のテスト
2024-12-01 SEQBOXv2
    TB-SEQVer2向けプログラム登録しただけ
2024-12-02 SyncOut
    SyncOutの仕様をDinSync(24PPQN)に変更中
2024-12-04 SyncOut
    ざっとコーディング デバッグ待ち
2024-12-05 SyncOut&WDG
    シンクアウトが一通りデバッグ済
    パターンプレイで止まってしまうので、切り分けの為WDGをsetup(),loop()で実装
2024-12-08 SyncOut
    ・Run/Stop⇒MIDIメッセージ スタートとコンティニューどちらでもRUNする様に修正
    ・MIDI IN⇒32usecカウンタを追加してシンクアウトのテンポを設定する
2024-12-10 SyncIn
    MIDIINを参考に実装済 デバッグを行う
2024-12-14 mainBoradV2.5
    修正中
    [CV.kicad_sch, FRAM.kicad_sch, Jack.kicad_sch, LevelConvert.kicad_sch, RasPico.kicad_sch]
2025-03-09 AddBoard
    Ver3まで登録
    [BOM_LM13700_VCA.tsv, CV.kicad_sch, FRAM.kicad_sch, Interface.kicad_sch, Jack.kicad_sch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]
2025-03-11 BoardV3
    ERCチェック済
    [Interface.kicad_sch, Jack.kicad_sch, LM13700_Overdrive.kicad_sch, LevelConvert.kicad_sch, RasPico.kicad_sch, TEMPO.kicad_sch, VCF.kicad_sch, VCO.kicad_sch]
2025-03-12 V3Board
    DualTr フットプリント変更
    配線ミス修正
    TEMPO削除⇒PanelBoardに移動
    [Interface.kicad_sch, Jack.kicad_sch, VCF.kicad_sch, VCO.kicad_sch, mainBorad.kicad_sch]
2025-03-13 V3Board
    opamp Dip8に対応
    部品配置
    [Interface.kicad_sch, LM13700_Overdrive.kicad_sch, VCO.kicad_sch, mainBorad.kicad_pcb]
2025-03-15 V3Board
    アートワーク中
    [CV.kicad_sch, FRAM.kicad_sch, Interface.kicad_sch, Jack.kicad_sch, LM13700_Overdrive.kicad_sch, LevelConvert.kicad_sch, MIDIRx.kicad_sch, PowerSupply.kicad_sch]
2025-03-16 V3Board
    アートワーク仮配置
    [LM13700_Overdrive.kicad_sch, VCF.kicad_sch, VCO.kicad_sch, mainBorad.kicad_pcb]
2025-03-17 V3Board
    GNDパターン塗り済
    [Interface.kicad_sch, Jack.kicad_sch, RasPico.kicad_sch, VCF.kicad_sch, VCO.kicad_sch, mainBorad.kicad_pcb]
2025-03-18 V3Board
    スペーサー穴追加
    オートルーター後
    DualTr,OPアンプは表面実装に切り替え
    [LM13700_Overdrive.kicad_sch, VCF.kicad_sch, VCO.kicad_sch, mainBorad.kicad_pcb]
2025-03-19 V3Board
    DualTr OPAmp やはりDIPに変更してオートルーター前に戻す
    [Interface.kicad_sch, LM13700_Overdrive.kicad_sch, PowerSupply.kicad_sch, VCF.kicad_sch, VCO.kicad_sch, freerouting.dsn, mainBorad.kicad_pcb]
2025-03-20 V3Board
    ERCチェック修正中
    [LevelConvert.kicad_sch, PowerSupply.kicad_sch, freerouting.dsn]
2025-03-20 V3Board
    ECRエラー全て解消
    [PowerSupply.kicad_sch]
2025-03-20 V3Board
    PanelBoardを追加 オートルーター前
    [HT16K33.kicad_sch, Jack.kicad_sch, LEDMatrix.kicad_sch, SwitchMatrix.kicad_sch, panelBoard.kicad_pcb, panelBoard.kicad_sch]
2025-03-22 V3Board
    panelBoardアートワーク完了 ラベル未記入
    [panelBoard.kicad_pcb]
2025-03-24 V3Board
    PanelBoard⇒debugPanelBoardにして部品を全部表に出してアートワーク修正中
    [Jack.kicad_sch, LEDMatrix.kicad_sch, bom.csv, designators.csv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]
2025-05-04 TBSEQ3
    ハードウェアデバッグしたバージョン>mainBORAD_R1
    [CV.kicad_sch, FRAM.kicad_sch, Interface.kicad_sch, Jack.kicad_sch, LM13700_Overdrive.kicad_sch, LevelConvert.kicad_sch, MIDIRx.kicad_sch, PowerSupply.kicad_sch]
2025-10-07 SeqBoxV2
    パターンプレイで2～8を選択⇒パターンライト⇒パターンプレイに戻ってRUNすると、次のパターンが必ず1に設定されてしまうバグを修正
2026-06-03 gitTBSEQ
    Ver4登録まで
    [AudioOut.kicad_sch, BOSS_DS-1_Clipper.kicad_sch, BOSS_OD-2_Clipper.kicad_sch, CV.kicad_sch, DanArmstring_OrangeSquezzer.kicad_sch, DiodeClipper.kicad_sch, FRAM.kicad_sch, HT16K33.kicad_sch]
